RaphaelGrj/Rover-Project/PROGRESS.md

# ROVER --- État actuel (résumé de reprise)

> # ✅ ROVER SE DÉPLACE --- blocage moteur levé le 2026-09-21
>
> Le blocage qui traînait depuis le 2026-09-01 (sept sessions) est
> résolu : moteurs, encodeurs, pont en H et alimentation répondent tous,
> et le Rover avance/recule/tourne réellement, roues au sol.
>
> **Root cause NON éclaircie --- à noter pour ne pas se faire piéger :**
> la session du 2026-09-20 avait prouvé par bisection que ce n'était pas
> le firmware et soupçonnait la masse `GND` ESP32 ↔ `GND` DRV8833
> (jamais vérifiée). Cette session n'a **pas** vérifié cette continuité
> --- le firmware de la branche `claude/joystick-speed-bar-ui-3a42ll` a
> simplement été flashé et les moteurs ont répondu du premier coup à
> `motor_raw`. Donc soit (a) un fil s'est ressoudé/rebranché entre-temps
> sans que personne ne le note, soit (b) l'hypothèse GND n'était pas la
> bonne cause. **Si le symptôme "PWM 255 → 0 tick" revient un jour, faire
> la vérification GND avant toute autre piste** : elle n'a toujours
> jamais été faite pour de vrai.
>
> **Ce qui a réellement débloqué le déplacement, dans l'ordre :**
> 1. Nouvel outil `pi/tools/motor_triage.py` (branche fusionnée ce jour) :
>    un duty fixe envoyé au pont en H sans PID a immédiatement montré que
>    le matériel répond (9 / 144 ticks gauche/droite en 3s, roues en
>    l'air) --- la panne électrique de 2026-09-20 n'était plus là.
> 2. **Calibration `max_speed` bien trop basse, et un piège logiciel
>    découvert avec** : le triage recommande de recaler `max_speed` sur
>    la vitesse mesurée à vide, roues en l'air (ici 0,00028 m/s --- la
>    roue gauche était quasi bloquée dans ce test précis). Appliqué tel
>    quel, ce réglage clampe `_targetVelocity` (avant/arrière,
>    `DriveController::setTarget`) à une valeur ridicule, mais **ne
>    touche pas la rotation** : `_targetRotation` est bornée par la
>    constante indépendante `ROVER_MAX_ROTATION_RAD_S` (4.0, fixe,
>    `motion_config.h`), sans lien avec `max_speed`. Résultat observé :
>    tourner fonctionnait (mal), avancer ne faisait strictement rien
>    (PWM avant ~4/255 relevé en télémétrie). **Un vrai calibrage à
>    l'air libre, sur roue quasi grippée, n'est pas une mesure fiable de
>    la vitesse atteignable en charge** --- s'en méfier si `motor_triage`
>    est réutilisé.
>    - Bug annexe trouvé et corrigé (commit `bc3887d`) : la commande
>      suggérée par l'outil formatait la vitesse en `%.3f`, ce qui
>      arrondit silencieusement tout en dessous de 0,0005 m/s à
>      `0.000` --- exactement ce cas, donc la commande recommandée aurait
>      remis `max_speed` à zéro au lieu de le corriger.
>    - Bug non corrigé, à garder en tête : la télémétrie firmware
>      (`main.cpp:114`, `%.3f` aussi, préexistant sur `main`, pas
>      introduit par la branche fusionnée) affiche `0.000` pour tout
>      `max_speed` sous 0,0005, et le JS de `index.html`
>      (`updateSpeedCeiling`) ignore un `max_speed` lu comme `0`
>      (`reported > 0` échoue) --- donc une calibration très basse ne se
>      propage jamais à l'UI, qui retombe sur son défaut codé en dur
>      (0,03) pour calculer la rotation. C'est ce qui a produit
>      l'incohérence avant/rotation observée. Pas bloquant tant que
>      `max_speed` reste raisonnable (c'est le cas depuis, remis à 0,15),
>      mais latent.
> 3. Remis `max_speed=0,15` (`SYSTEM action=set_speed`, persiste en NVS
>    via `CalibrationStore` --- **ne revient PAS à 0,03 après reboot**,
>    y penser si un futur test semble "trop rapide" ou "trop lent" sans
>    raison). Choisi car la rotation avait déjà mesuré ~0,20-0,23 m/s
>    réels en charge à duty plein, très au-dessus du défaut compilé.
> 4. **Chenilles démontées par l'utilisateur pour isoler la cause** :
>    rotation nettement meilleure sans, déplacement avant confirmé.
>    Écart gauche/droite mesuré ensuite à duty 255 sans chenilles :
>    **~1-2 % seulement** (0,225-0,230 m/s des deux côtés), contre un
>    facteur ~16x constaté plus tôt roues en l'air avec chenilles ---
>    la boucle PID par roue (gains partagés, retour encodeur
>    indépendant) absorbe déjà cet écart résiduel, pas besoin de trim
>    logiciel par roue.
> 5. **Impression 3D en cours** (lancée par l'utilisateur en fin de
>    session) de nouvelles pièces pour réduire l'effort mécanique sur le
>    moteur côté chenilles avant remontage --- à re-tester (balance
>    gauche/droite + vitesse max réelle en charge) une fois montées.
>
> **Branche fusionnée dans `main` ce jour** (`815700d`, après validation
> matérielle complète) : `claude/joystick-speed-bar-ui-3a42ll` --- UI
> joystick avec barre de vitesse séparée de la direction, bouton
> réarmement/obstacle, puce d'état ESP32, `motor_triage.py`, correctifs
> PID/réflexe d'obstacle. Détail dans le message de merge.

> Fichier de reprise rapide --- objectif : que je puisse me repérer sans
> tout relire. Statut détaillé par phase : voir
> `ARCHITECTURE_AND_ROADMAP.md`. Détail complet de chaque session
> (mesures, hypothèses écartées, méthode de diagnostic) : voir
> `PROGRESS_ARCHIVE.md` --- à rouvrir seulement pour retrouver le contexte
> fin d'une décision ou d'un test passé précis ; le journal court
> ci-dessous suffit normalement à se repérer.

------------------------------------------------------------------------

## État actuel (fil ouvert, mis à jour en continu)

- **✅ Protection batterie choisie + sommeil profond --- MERGÉ dans
  `main` (2026-10-13, [RaphaelGrj/Rover-Project#4](https://github.com/RaphaelGrj/Rover-Project/pull/4),
  merge `1f72aff`, CI verte : 3 cartes + 22 tests natifs + `pi/`)** ---
  jamais testé sur matériel (carte pas encore fabriquée). Entre-temps,
  #2 (`PROGRESS.md`) et #3 (références LCSC de l'étape 0,
  `AIDE_CABLAGE.md`) ont aussi été mergées, puis #5 (`PROGRESS.md`) et
  #6 (merge `16322cb` : JST-PH 2 broches = C295747, 8 broches = C265121,
  trouvés sur leurs pages LCSC), #7 (`PROGRESS.md`) et #8 (merge
  `cdda8c7` : C265405 = JST S6B-PH-SM4-TB et C2913205 =
  ESP32-S3-WROOM-1-N16R2 confirmés par une seconde source). **Toute la
  liste de l'étape 0 est confirmée par au moins deux sources** ; reste
  seulement à revérifier le stock sur lcsc.com au moment de commander.
  Détail ---
  **S-8252AAC-M6T1U** (LCSC C468219) retenue parmi les variantes en
  stock chez LCSC : surcharge 4,30 V, décharge profonde **2,40 V**
  (seuils lus sur des extraits indexés de la datasheet, à reconfirmer
  sur le PDF). 2,4 V est sous la fin de décharge des 18650 (35E 2,65 V).
  Compensé dans le firmware par `LowBatterySleep` : sommeil profond à
  3,0 V/cellule, réveil toutes les 15 min, reprise seulement à
  3,3 V/cellule ou avec l'USB. Décision dans
  `PowerMath::batteryTooLowToRun`, 4 tests natifs de plus (22 au total).
  Doc : `PCB_CONNEXIONS.md` §5.1 et §7, `AIDE_CABLAGE.md` étape 0,
  `ROVER_PROTOCOL.md` (`EVENT name=battery_shutdown`). VL53L0X :
  confirmé hors carte (modules indépendants en façade sur deux JST-PH 6),
  désormais écrit noir sur blanc.
  ⚠ **Limite** : la consommation de la carte en sommeil (« quelques mA »)
  est une estimation (bucks, LDO, capteurs et DRV8833 restent alimentés).
  À mesurer à la mise en service : l'interrupteur reste le vrai « off ».

- **✅ PCB sur mesure : conception + firmware MERGÉS dans `main`
  (2026-10-13, [RaphaelGrj/Rover-Project#1](https://github.com/RaphaelGrj/Rover-Project/pull/1),
  merge `7f88758`)** --- rien n'est encore dessiné dans KiCad ni
  commandé, et **aucune ligne de ce firmware n'a tourné sur une vraie
  carte** (elle n'existe pas).
  - **CI verte sur le commit mergé** : compilation `esp32_wroom`,
    `esp32_s3` **et `rover_pcb_v1`** (ajouté à la matrice CI), tests
    natifs (dont les 18 de `test_power_math`), tests `pi/`, build
    ESP32-CAM. Le premier passage avait cassé les 3 builds ESP32 sur une
    parenthèse en trop dans `main.cpp` (garde `pintest`), corrigée dans
    `318c120` --- une seule erreur, le reste du code a compilé du
    premier coup.
  - **Contenu** : plan complet (`pcb/PCB_CONNEXIONS.md`), guide KiCad
    (`pcb/KICAD_GUIDE.md`), partie 2 d'`AIDE_CABLAGE.md` (connecteurs de
    la carte + création KiCad étape par étape, tableau GPIO recoupé
    automatiquement avec `board_pins_pcb_v1.h`, 33/33), BMS 2S avec
    2 × 18650 en supports séparés (`BOM.md`), firmware `rover_pcb_v1`
    (`lib/board`, `lib/camera`, `lib/power`, `lib/power_math`, IMU
    LSM6DS3TR-C), protocole documenté (`ROVER_PROTOCOL.md`), et
    correction des 23 checksums faux des exemples du protocole (dont la
    référence du §3.1 : `*3A`, pas `*39`).
  - **Toujours ouvert --- à vérifier à la mise en service de la carte** :
    - **Échelle ADC des cellules du BQ25887 supposée (1 mV/pas)**,
      jamais lue sur la datasheet (site TI bloqué depuis la session ;
      registres repris du crate Rust `bq25887`). Le firmware s'en
      protège (`cells_ok=0` si la somme des cellules ≠ tension INA219),
      mais **voir `cells_ok=1` avec des tensions réalistes est le
      premier contrôle**.
    - Brochage du connecteur FPC caméra (sens 1↔24) à confirmer sur le
      schéma ESP32-S3-EYE avant routage ; broches `D+/D−` ou `PSEL` du
      BQ25887 ; seuils SD_MODE des MAX98357A.
    - Pilote audio I2S non écrit (amplis coupés en attendant).
    - Côté Pi : `camera_url` → `http://rover-esp32.local:81/stream`.
  - **Prochaine étape (utilisateur)** : `AIDE_CABLAGE.md` partie B,
    étape 0 --- revérifier le stock des références listées au moment
    de commander, acheter
    une OV2640 à **nappe longue (~75 mm)**, télécharger les datasheets
    (et y reconfirmer les seuils de la S-8252AAC) --- puis schéma KiCad
    poussé sur git pour relecture avant le PCB.

- **📐 PCB sur mesure ESP32-S3 planifié (2026-10-13, conception
  seulement, rien de dessiné ni commandé)** --- carte tout-en-un : S3 +
  caméra intégrée (remplace l'ESP32-CAM), DRV8833, 2 × MAX98357A
  stéréo, micro ICS-43434, IMU, BME688, INA219, connecteurs pour
  moteurs/HP/écran/ToF/servo/E-stop. Liste complète des connexions :
  `pcb/PCB_CONNEXIONS.md` ; guide KiCad débutant :
  `pcb/KICAD_GUIDE.md`. Décisions structurantes à garder en tête :
  module **N16R2** obligatoire (pas N16R8, GPIO35-37 nécessaires),
  expandeur TCA9554 pour les signaux lents (36/36 GPIO du module
  attribués), E-stop câblé sur nSLEEP du DRV8833 (coupure matérielle).
  **Révision le même jour, à la demande de l'utilisateur : BMS 2S
  intégré** --- batterie **2 × 18650 en supports séparés** (choix
  délégué par l'utilisateur, critère sécurité : préférées à un LiPo
  souple), un seul connecteur JST-VH 3 broches B−/MID/B+ + sonde CTN,
  charge USB-C avec équilibrage (BQ25887, I2C 0x6A → IMU
  déplacée en 0x6B), protection par cellule (S-8252), interrupteur sur
  la carte ; XT30 et MOSFET anti-inversion retirés. Connecteurs N20 :
  JST-PH 6 broches dans l'ordre de `esp32/WIRING.md`, l'utilisateur
  adapte le câble si besoin. Questions ouvertes listées en §8 du
  document. Firmware non touché.

- **✅ ROVER SE DÉPLACE, BRANCHE FUSIONNÉE DANS `main` (2026-09-21,
  session de test réel)** --- voir le bandeau en tête de fichier pour le
  détail complet (root cause non éclaircie, calibration `max_speed`,
  bug de troncature, mesures d'équilibrage). Résumé de session :
  - Tests avant fusion : 32/32 natifs, 167/167 `pi/` (2 échecs Windows
    pré-existants sans rapport), WROOM + S3 compilent tous les deux.
  - Flashé sur le WROOM réel (`COM10`) --- premier flash de cette branche
    sur matériel. `motor_triage.py` (nouvel outil de la branche) a
    tranché en un coup : pont en H, alim, moteurs, encodeurs répondent.
  - `max_speed` recalibré deux fois en session : d'abord suivant la
    suggestion du triage (0,00028, beaucoup trop bas, a bloqué
    l'avant/arrière sans toucher la rotation --- voir bandeau), puis
    remonté à 0,15 après mesure réelle en charge (~0,20-0,23 m/s
    observés). Valeur actuelle en NVS, persistante.
  - Bug trouvé et corrigé dans `motor_triage.py` avant fusion (commit
    `bc3887d`) : suggestion de calibration tronquée à `0.000` par un
    format `%.3f` trop court pour ce châssis.
  - Chenilles démontées par l'utilisateur pour isoler la cause du
    mauvais déplacement : nette amélioration, écart gauche/droite résiduel
    ~1-2 % seulement (contre ~16x mesuré roues en l'air avec chenilles le
    2026-09-20) --- absorbé par le PID par roue, pas de trim logiciel
    ajouté.
  - Merge `--no-ff` propre, sans conflit, poussé sur `origin/main`
    (`815700d`).
  - **Impression 3D lancée par l'utilisateur** (nouvelles pièces pour
    réduire l'effort mécanique sur le moteur côté chenilles) --- à
    remonter et re-tester (balance + vitesse réelle) une prochaine
    session.

- **🔴 SEPT RÉGRESSIONS TROUVÉES EN RELISANT MON PROPRE TRAVAIL
  (2026-09-21)** --- revue de la branche avant flash, puisque ~1000
  lignes dont une loi de commande moteur n'ont jamais pu tourner sur le
  vrai matériel. Toutes viennent de la **même cause** : avoir divisé le
  plafond de vitesse par 10 sans toucher à ce qui supposait l'ancienne
  échelle.
  - **La barre de vitesse n'avait que 4 positions utiles.** `MOVE` était
    émis en `%.2f` sur une plage de 0 à 0,03 m/s : les 21 crans de la
    barre s'effondraient en **quatre** commandes distinctes, et **sous
    15 % de barre la commande valait `0.00`** --- le robot ne bougeait
    pas du tout. Passé à quatre décimales, vérifié en navigateur : 7
    crans testés, 7 commandes distinctes.
  - **`left_speed=0.00` serait réapparu pour une roue qui tourne.** Même
    format `%.2f` sur la télémétrie : toute roue sous 0,005 m/s
    s'affichait à zéro. C'est *exactement* la lecture erronée qui a
    coûté des semaines à ce projet, et je l'avais réintroduite.
  - **Trame trop longue.** Vitesses à quatre décimales + les trois
    drapeaux d'obstacle = 129 octets, un de trop, atteint par une simple
    marche arrière à plein régime. Les drapeaux partent maintenant dans
    leur propre trame, au changement seulement (plus court *et* plus
    silencieux).
  - **Une commande perdue n'était jamais réémise (page autonome).**
    `lastSent` était posé avant que la requête n'aboutisse : un timeout
    et la commande était considérée comme délivrée, pendant que les
    keep-alives `h=1` maintenaient le heartbeat. **Un « stop » perdu
    laissait le robot rouler indéfiniment.** Corrigé (acquittement sur
    réponse seulement) et vérifié en coupant le lien à chaud.
  - **Stick tenu + « Activer » = rien.** Le ré-armement ne purgeait pas
    `lastSent`, donc aucun `MOVE` n'était émis après être sorti de SAFE.
    `RoverCore.resume()` purgeait son cache pour cette raison exacte ;
    la page n'avait pas l'équivalent.
  - **Zone morte à 0,02 m/s**, soit les deux tiers de la plage : rouler
    à 60 % de barre était rapporté comme « inactif ». Elle est
    maintenant une **fraction du plafond rapporté par le robot**, donc
    elle ne peut plus dériver.
  - **Bascule obstacle optimiste** sans rien pour la corriger, et un
    commentaire qui prétendait le contraire. Elle revient en arrière si
    la requête échoue.
  - **`monkeypatch` gelait `time.monotonic` de la stdlib** pour tout le
    processus, sous une boucle asyncio vivante.
  - Trois tests de non-régression ajoutés sur le fond du problème (la
    résolution du format, la zone morte qui suit le plafond).
  - **Leçon** : changer une constante de référence d'un ordre de
    grandeur, c'est changer toutes les échelles qui en dépendent.
    Formats d'affichage, seuils, tailles de tampon. Aucun de ces sept
    points n'aurait été trouvé en relisant la ligne modifiée.

- **🔧 OUTIL : `python -m tools.motor_triage` (2026-09-21)** --- une
  commande qui répond à la seule question qui compte : **la panne est-
  elle électrique ou logicielle ?**
  - Le pivot est `motor_raw` : duty écrit **directement sur le pont en
    H**, sans PID, sans feed-forward, sans plafond de vitesse, sans
    réflexe d'obstacle. Zéro tick sous cette commande ⇒ plus rien en
    amont du pont en H ne peut être mis en cause.
  - La réponse était disponible depuis le début, mais seulement pour qui
    lance cinq commandes `SYSTEM` dans le bon ordre et lit la télémétrie
    correctement. **Sept sessions sans que cette séquence soit passée
    proprement de bout en bout** --- et le seul chiffre que tout le
    monde regardait (`left_pwm=255`) ne prouvait rien, puisque le PID
    sature *parce que* rien ne bouge.
  - Six verdicts, chacun avec la manipulation suivante : **électrique**
    (masse commune d'abord), **E-stop enfoncé** (GPIO25), **entrée
    encodeur qui flotte**, **un seul côté répond** (avec le rappel que
    gauche/droite sont inversés ensemble dans le câblage), **moteurs
    fonctionnels**, ou non concluant. Codes de sortie 0/1/2.
  - Sur un verdict « fonctionnels », il **mesure** la vitesse réelle à
    plein régime et propose le `SYSTEM action=set_speed` qui recale
    `ROVER_MAX_WHEEL_SPEED_MPS` si elle s'en écarte. Les constantes sont
    **lues dans `motion_config.h`**, pas recopiées : cette session est
    partie d'une constante fausse d'un facteur 10 que personne n'avait
    vue, l'outil ne peut donc pas être en désaccord avec le firmware.
  - Vérifié pour de vrai : les sept chemins ont été exécutés contre un
    faux ESP32 (électrique, sain, un seul côté, tempête d'encodeur,
    E-stop, robot muet, lien injoignable), et l'arbre de décision est
    couvert par `pi/tests/test_motor_triage.py`.
  - Au passage : `move_diagnostic.py` contenait encore un chemin Windows
    en dur (`C:\Users\rapha\...`), il ne tournait plus depuis que le Pi
    est la machine qui l'exécute. Corrigé.

- **🟢 CORRIGÉ : plafond de vitesse, feed-forward, anti-windup
  (2026-09-21)** --- le diagnostic de la session précédente est
  maintenant réparé, et une **deuxième anomalie sérieuse** est sortie au
  passage.
  - **`ROVER_MAX_WHEEL_SPEED_MPS` : 0,30 → 0,03 m/s**, c'est-à-dire la
    vitesse réellement mesurée à plein régime. La rotation suit :
    elle est désormais **dérivée**, pas choisie --- le modèle unicycle
    donne `2 × vmax / empattement` = 0,4 rad/s, là où l'ancien
    1,5 rad/s demandait 0,11 m/s à chaque roue, presque **quatre fois**
    ce que le châssis peut donner. Toute rotation saturait.
  - **Feed-forward `ROVER_PID_KFF = 8500`** (PWM par m/s, soit
    255 / 0,03). Le rapport cyclique nécessaire à une vitesse est connu
    d'avance ; le faire redécouvrir à l'intégrateur par pas de 20 ms
    était la cause de la rampe de 5 s. **Mesuré sur banc natif** : plein
    barre atteint PWM 200 **immédiatement**, contre *jamais* avant.
  - **⚠️ ANOMALIE TROUVÉE EN CORRIGEANT : le robot ne s'arrêtait pas
    quand on relâchait le joystick.** Recentrer le stick ne fait que
    mettre la consigne à zéro --- ça ne passe pas par `stop()` comme le
    bouton STOP, le SAFE ou l'E-stop. L'intégrale accumulée pour tenir
    la vitesse précédente restait, et se vidait à la vitesse de
    l'erreur. **Mesuré sur banc : 81 secondes de plein régime après
    avoir lâché.** Invisible jusqu'ici uniquement parce que les roues ne
    tournaient pas ; ça aurait mordu le jour même où elles s'y seraient
    mises.
    - Corrigé par trois choses : l'**anti-windup** (intégration
      conditionnelle : on n'intègre plus vers une butée déjà atteinte),
      le **feed-forward** (l'intégrale n'a plus à porter le régime
      permanent, donc elle reste près de zéro), et surtout une règle
      explicite --- **consigne nulle ⇒ intégrale remise à zéro**.
      « S'arrêter » est une intention, pas une consigne à asservir.
    - Mesure après correction : **0,00 s** de dérive après relâchement,
      *y compris* avec `kff=0`. L'anti-windup seul ne suffisait pas (il
      restait 39 s), c'est la combinaison qui règle le problème.
  - **Tout est recalibrable sans reflasher** : `SYSTEM action=set_speed
    max=0.045` (persisté en NVS) et `set_pid kff=...`, même mécanique
    que les gains PID. La page du Pi **suit** le plafond rapporté par le
    robot (`STATE max_speed=`) et affiche la barre en m/s réels, donc
    plus de constante d'UI qui périme. La page autonome garde une
    constante (elle ne peut pas l'apprendre) --- à tenir à jour à la
    main.
  - Vérifié sur banc natif compilé avec `g++` (les tests Unity du dépôt
    tournent aussi localement via un shim) : 9/9 au vert, dont trois
    nouveaux couvrant exactement ces pathologies.

- **🟢 CORRIGÉ : le lien Pi↔ESP32 ne détectait pas une mort silencieuse
  (2026-09-21)** --- trouvé en réparant la CI, et c'est un vrai bug de
  production qui **colle au symptôme « les moteurs ne tournent pas »**.
  - TCP ne signale qu'un pair qui dit au revoir. Un ESP32 qui perd
    l'alimentation, plante, ou sort de portée WiFi n'envoie **ni FIN ni
    RST** : le socket reste ouvert et parfaitement sain, les lectures
    expirent à vide --- ce qui n'est pas une erreur. Le Pi envoyait donc
    son heartbeat dans le vide indéfiniment : aucune reconnexion, plus
    aucun HEARTBEAT ne parvenant au robot, moteurs arrêtés en `SAFE`, et
    une UI affichant toujours « connecté ».
  - Corrigé par un **chien de garde en réception** : le firmware publie
    de la télémétrie capteur toutes les 500 ms quoi qu'il arrive, donc
    5 s de silence = 10 cycles manqués = lien mort. On ferme et on
    reconstruit, AUTH comprise. Désactivable (`receive_timeout_s=None`).
  - Deux tests couvrent les deux moitiés du contrat : un robot muet est
    recyclé, un robot qui parle **n'est pas** recyclé (une boucle de
    reconnexion serait pire que le bug).

- **🟢 CORRIGÉ : 3 tests `test_link` rouges depuis toujours --- le code
  testé était sain, c'est le harnais qui mentait (2026-09-21)**.
  - `FakeEsp32.hang_up()` faisait `close()` pendant que son propre
    thread était bloqué dans `recv()` sur **le même socket**. Sous
    Linux, fermer un descripteur ne réveille pas un thread déjà bloqué
    dessus, et l'appel bloqué **maintient la description de fichier
    ouverte : aucun FIN n'est jamais envoyé**. Le client voyait un
    socket sain et silencieux et avait raison de ne pas reconnecter.
  - `shutdown(SHUT_RDWR)` avant `close()` : le FIN part tout de suite et
    réveille le `recv()` bloqué. **15/15 au vert**, CI Python réparée.
  - À retenir : trois tests de reconnexion ont passé leur vie en rouge
    en accusant un code correct. Un harnais qui simule une panne doit
    être vérifié comme le reste.

- **Garde-fou anti-tempête d'interruptions encodeur (2026-09-21)** ---
  détection passive la session dernière, protection active maintenant :
  au-delà de 20 000 fronts/s (impossible physiquement --- ce châssis en
  produit ~320/s), l'encodeur **désarme sa propre interruption** et émet
  `ERROR code=encoder_storm wheel=left|right`. On échange la mesure de
  vitesse contre un robot qui continue de tourner, là où une `loop()`
  affamée ne fait plus rien du tout. Ne se réarme qu'avec
  `SYSTEM action=reset_ticks` : la cause est un fil, un réarmement
  automatique ne ferait que la cacher.

- **🔴 TROUVÉ : la consigne de vitesse est INATTEIGNABLE, le PID est
  saturé en permanence (2026-09-21)** --- c'est le résultat le plus
  important de la session, et il **réinterprète des semaines de
  diagnostic**.
  - Calcul, à partir de vos propres mesures : circonférence de roue
    `π × 0,03183 = 100,0 mm` ; mesure du 2026-09-20 à froid,
    **3125 ticks en 10 s à PWM 255** → `312 ticks/s ÷ 1073 = 0,291 tr/s`
    = **17,5 tr/min** = **0,029 m/s**.
  - Or `ROVER_MAX_WHEEL_SPEED_MPS = 0,30 m/s`, soit **10,3 × la vitesse
    réellement atteinte à plein régime**. Demander 0,30 m/s revient à
    demander **180 tr/min** à l'arbre de sortie.
  - **Conséquence** : toute consigne au-dessus de ~0,03 m/s est
    inatteignable → l'erreur ne redescend jamais → l'intégrale part à sa
    borne → **le PWM reste collé à 255 indéfiniment**. Vérifié en
    simulant la boucle fermée : consigne 0,12 m/s → saturé à 255 sur
    100 % du régime établi ; consigne **0,025 m/s** (sous le plafond
    mesuré) → **PWM 109, la boucle régule enfin**.
  - **Donc `left_pwm=255 left_speed=0.00` n'est PAS un symptôme de
    panne** : c'est la sortie normale de cette configuration. Ce chiffre
    a été lu comme une preuve de moteur mort pendant des semaines ; il
    ne prouve rien du tout.
  - ⚠ Nuance honnête : les 17,5 tr/min viennent d'une mesure faite sur
    un châssis peut-être partiellement chargé, donc le vrai plafond à
    vide est sans doute plus élevé. Même faux d'un facteur 3, on reste à
    un ordre de grandeur de 0,30 m/s. **À trancher par la mesure** :
    `SYSTEM action=reset_ticks`, puis `motor_raw left=255 right=255
    ms=10000`, puis `raw_ticks` --- à froid, roues en l'air *puis* au
    sol. `ROVER_MAX_WHEEL_SPEED_MPS` doit ensuite être ramené à ce qui
    est réellement atteignable, sinon la barre de vitesse n'a **aucune
    autorité** : elle ne change que la durée de la rampe, pas le régime
    final.
  - **Non corrigé ici** : changer cette constante change le
    comportement en mouvement du robot, ça se règle sur la mesure, pas à
    l'aveugle.

- **Bouton « arrêt sur obstacle » ON/OFF (2026-09-21)** --- demandé, et
  c'est aussi un outil de diagnostic.
  - Présent sur **les deux** pages. Les **distances restent mesurées,
    publiées et affichées** dans tous les cas : le bouton empêche le
    robot d'*agir* sur ce qu'il voit, il ne l'aveugle pas.
  - Côté firmware `SYSTEM action=obstacle_reflex on=0|1`
    (`DriveController::setObstacleReflexEnabled`). ⚠ Il y a **deux**
    clamps indépendants (firmware + Pi, §6.2 question 5) : n'en
    désactiver qu'un ne change rien, donc `RoverCore.set_obstacle_reflex()`
    fait les deux d'un coup.
  - **Non persisté, volontairement** : un garde-fou désactivé ne doit
    pas survivre à une coupure de courant. Chaque démarrage repart armé
    --- et le bouton de l'UI suit **la valeur rapportée par le robot**,
    jamais le clic, pour qu'un reboot ESP32 ne laisse pas la page
    mentir.
  - La télémétrie distingue maintenant trois choses autrefois
    confondues : `obstacle_seen` (ce que voit le capteur),
    `obstacle_reflex` (armé ou non), `forward_blocked` (marche avant
    effectivement bridée).

- **Deux suspects restants, désormais diagnosticables en 2 secondes
  (2026-09-21)** --- tous deux collent au symptôme « rien ne tourne »,
  aucun n'est mécanique ni lié au driver :
  1. **E-stop fantôme sur GPIO25.** `ROVER_PIN_ESTOP = 25` --- or
     `motion_config.h` note que GPIO25 était le `PWMB` du plan TB6612FNG
     abandonné. **S'il reste un fil de ce plan reliant GPIO25 à la masse
     ou à une entrée du driver, l'E-stop lit « enfoncé » en permanence** :
     dès la première `loop()` le front est détecté, l'état passe en
     `SAFE`, les moteurs sont coupés, et *tout* `resume` est refusé.
     Symptôme identique à des moteurs morts. Jusqu'à cette session ce
     refus était **totalement silencieux** ; il répond maintenant
     `ERROR code=estop_held`, et `STATE estop=1` le dit sans qu'on
     demande rien.
  2. **Tempête d'interruptions encodeur.** GPIO34-39 n'ont **aucun
     pull-up interne** (`Encoder::begin` le documente). Un connecteur
     desserré --- ce robot a des antécédents, cf. « connexion gauche
     faible/intermittente » --- laisse la broche flotter et l'ISR se
     déclencher en continu, ce qui **affame la `loop()` qui pilote les
     moteurs**. Les ticks ne le montrent pas : les `+1`/`−1` s'annulent,
     le compteur reste près de zéro, exactement comme une roue immobile.
     Nouveau compteur `raw_edges_left`/`raw_edges_right` (jamais
     décrémenté) dans `SYSTEM action=raw_ticks` : **des edges qui
     grimpent pendant que les ticks stagnent, c'est ça, sans ambiguïté**.
  - Bonus de la publication `STATE state=` au boot : une boucle de reset
    du watchdog (3 s) se voit maintenant comme des `state=READY`
    répétés, au lieu de passer inaperçue.
  - Confirmé inerte : `RoverState::ERROR` n'est **jamais** affecté nulle
    part dans le firmware, ce chemin ne peut pas bloquer quoi que ce
    soit.

- **PILOTAGE : barre de vitesse + joystick de direction (2026-09-21)**
  --- les deux pages (celle du Pi, `pi/rover_control/static/index.html`,
  et celle servie par l'ESP32 en mode autonome) séparent désormais
  *combien vite* de *vers où* :
  - **barre latérale = vitesse**, seule ; **joystick = direction**,
    seule. La commande est le vecteur **normalisé** (longueur 1), donc
    à mi-course ou à fond de course on roule à la même vitesse. Zone
    morte de 25 % du rayon : une commande « direction seule » n'a aucun
    petit régime dans lequel s'engager progressivement, sans zone morte
    le moindre effleurement serait un départ pleine vitesse.
  - **Conséquence recherchée** : une ligne droite est désormais **une
    commande répétée**, plus un flux de flottants légèrement différents.
    C'est ce qui rend le filtrage des doublons efficace.
  - **Où le gain est réellement pris, et où il ne l'est pas** :
    `RoverCore.move()` ne réémet plus une `MOVE` identique (rafraîchie
    quand même toutes les 0,5 s, `MOVE_REFRESH_S` --- un ESP32 qui a
    redémarré ou qui sort de `SAFE` ne doit pas rester sur une consigne
    périmée). La page, elle, **continue** d'émettre à cadence fixe :
    c'est cette cadence qui prouve que le *navigateur* est vivant, et la
    couper aurait permis à une page figée de laisser le robot rouler sur
    sa dernière commande. En mode autonome, la page n'envoie `v`/`r`
    qu'au changement et sinon un `GET /c?h=1` qui alimente le heartbeat
    sans re-cibler le PID. ⚠ Le **nombre de requêtes** reste plancheré
    par le timeout heartbeat (500 ms) : ce n'est pas là que ça se gagne,
    et c'est assumé.

- **`SYSTEM action=resume` : envoyé, mais UNE SEULE FOIS --- corrigé
  (2026-09-21)** --- vérification demandée, et c'est un vrai défaut.
  - Ce qui existait : `RoverCore.client_connected()` envoie bien un
    `resume` à la connexion d'un client de contrôle (et
    `pi/tools/motor_test.py` a sa commande `resume`). C'est correct au
    démarrage.
  - **Le trou** : c'est un coup unique. Tout ce qui refait tomber
    l'ESP32 en `SAFE` *ensuite* --- **un timeout heartbeat suffit, et la
    fenêtre n'est que de 500 ms sur un lien WiFi** --- laissait la page
    connectée, le joystick vivant, le heartbeat battant… et **toutes les
    `MOVE` jetées en silence**. Seul un rechargement de l'onglet
    (donc une reconnexion) rendait le robot pilotable. Un robot muet qui
    a l'air en pleine forme : exactement le symptôme « les moteurs ne
    tournent pas » qu'on traque depuis des semaines.
  - **Corrigé** : bouton « Activer » sur la page du Pi (elle n'en avait
    pas, contrairement à la page autonome) → `RoverCore.resume()`, et
    l'état matériel de l'ESP32 est maintenant **affiché** (nouveau champ
    `STATE state=... estop=...`, émis au changement uniquement, voir
    `ROVER_PROTOCOL.md` §7.1). Un `SAFE` se voit au lieu de se deviner,
    et le bouton clignote quand il sert à quelque chose.
  - **Côté firmware** : un `resume` refusé parce que l'E-stop est
    enfoncé répond maintenant `ERROR code=estop_held` au lieu d'être
    ignoré sans un mot --- « j'ai appuyé sur Activer et rien ne s'est
    passé » avait zéro réponse possible avant.

- **Heartbeat : présent et correct (2026-09-21)** --- vérification
  demandée, rien à corriger.
  - Pi → ESP32 : `HEARTBEAT` toutes les **150 ms**
    (`HEARTBEAT_PERIOD_S`), tâche lancée à la connexion du premier
    client et annulée au départ du dernier. Timeout firmware : **500 ms**
    (`ROVER_HEARTBEAT_TIMEOUT_MS`), soit ~3 battements de marge.
  - Page autonome → ESP32 : au moins une requête toutes les **250 ms**
    (commande ou `h=1`), même marge.
  - `HeartbeatMonitor` ne se déclenche jamais avant le premier battement
    reçu (`_started`), donc un robot allumé sans Pi ne tombe pas en
    `SAFE` tout seul --- il reste en `READY`, où les `MOVE` sont **aussi**
    ignorées (voir ci-dessous).
  - ⚠ À savoir : **sans client de contrôle connecté, personne ne bat**.
    C'est voulu (la sécurité ne dépend pas du Pi), mais ça veut dire
    qu'un `MOVE` envoyé à la main sans heartbeat ne bouge rien plus de
    500 ms. `pi/tools/motor_test.py` bat en arrière-plan pour ça.

- **Audit « qu'est-ce qui, dans le code, peut empêcher les moteurs de
  tourner » (2026-09-21)** --- passe complète, par ordre de probabilité :
  1. **⚠ La rampe du PID est lente au point d'être trompeuse.** Gains
     180/300/0, intégrale bornée à ±1. Roue bloquée, consigne à 40 % de
     la barre (0,12 m/s) : `sortie = 21,6 + 36·t`. Il faut donc **~5 s**
     de joystick maintenu pour atteindre PWM 200, et **~6,5 s** pour 255
     --- or le seuil de démarrage mesuré sur ce châssis est justement de
     200-255. **Une poussée de 2 s ne dépasse pas PWM ~93 : rien ne
     bouge, et ça ressemble trait pour trait à un moteur mort.** À fond
     de barre (0,30 m/s) c'est ~1,6 s pour 200 ; à 20 % de barre,
     **10,5 s**. Chiffres simulés depuis le code de `WheelPID::update`,
     pas estimés. ⚠ Conséquence directe pour la barre de vitesse :
     **un réglage bas est indiscernable d'un robot en panne** sur un
     test court --- tester à fond de barre d'abord. Le correctif propre est
     un terme de **feed-forward** (`pwm = kff·consigne + PID`), pas un
     gain plus gros --- monter Kp/Ki a déjà été essayé le 2026-09-20 et
     a produit une oscillation +255/−255. **Non implémenté ici** : c'est
     une modification de la loi de commande, elle se règle sur le vrai
     robot, pas à l'aveugle.
  2. **Le réflexe d'obstacle est devenu actif le 2026-09-20**, le jour
     même où les moteurs ont cessé de tourner. Un ToF qui voit quoi que
     ce soit à **moins de 150 mm** (une chenille, un câble, le sol si le
     capteur pique du nez, un mur pendant un test sur établi) met
     `forward_blocked=1` et la marche avant est mise à zéro --- **des
     deux côtés**, dans le firmware *et* dans `RoverCore.move()`. La
     rotation et la marche arrière restent disponibles, ce qui donne le
     symptôme très particulier « il tourne mais n'avance pas ».
     Vérifiable directement : `forward_blocked=` dans la télémétrie, et
     la page autonome l'écrit en clair. À écarter en deux secondes,
     mais personne ne l'a fait depuis que les capteurs sont câblés.
  3. **`MOVE` est ignorée hors de l'état `ACTIVE`** (voulu, §27 règle 6)
     --- voir le point `resume` ci-dessus, c'était le trou le plus sale.
  4. **Un coup de PWM parasite après `motor_raw`, corrigé.**
     `DriveController::update()` ne rafraîchissait pas `_lastUpdateMs`
     pendant qu'une commande brute tenait les moteurs : la première
     passe PID suivante voyait un `dt` de **jusqu'à 15 secondes**,
     l'intégrale partait directement à sa borne et envoyait un
     plein régime sur un robot que l'opérateur croyait à l'arrêt.
  5. **Écarté --- conflits de broches et de canaux LEDC** : aucun
     doublon sur l'ensemble des `ROVER_PIN_*` (moteurs 26/27/32/33,
     encodeurs 34-39 en entrée seule, écran, I2C, E-stop 25, XSHUT 4,
     I2S 16/17/14). Moteurs sur canaux LEDC 0-3 (timers 0 et 1), servos
     sur 4-5 (timer 2) : pas de timer partagé, donc pas de fréquence
     volée. Buzzer désactivé, aucun canal. `pintest` détache bien le
     LEDC mais rappelle `drive.begin()` derrière, le PWM revient.
  6. **Écarté --- E-stop, batterie, watchdog** : `INPUT_PULLUP` donc une
     broche non câblée lit « relâché » ; `BatteryMonitor` n'a aucun
     chemin vers `SAFE` (il n'émet que des EVENT) ; le watchdog est
     nourri à chaque `loop()`.
  - **Conclusion** : rien dans le code n'*interdit* aux moteurs de
    tourner, ce que la bisection du 2026-09-20 avait déjà prouvé. Mais
    les points 1 et 2 fabriquent un « ça ne tourne pas » parfaitement
    convaincant lors d'un test court, et le point 3 en fabriquait un
    définitif après la moindre micro-coupure WiFi. **Le bandeau en tête
    de fichier reste valable : la piste électrique (masse commune) reste
    à faire en premier.**

- **MOTEURS : NON RÉSOLU en fin de session (2026-09-20)** --- les
  moteurs ne tournent plus du tout, et **la bisection prouve que ce
  n'est pas le logiciel** (voir le bandeau en tête de fichier : le
  firmware de `d9379a0`, reflashé intégralement, échoue identiquement).
  Le reste de cette entrée documente le chemin parcouru, mais **la
  conclusion opérationnelle est dans le bandeau** : chercher côté
  électrique, en commençant par la masse commune.

- **MOTEURS : diagnostic complet, cause non trouvée (2026-09-20)** ---
  la session a éliminé méthodiquement tout ce qui pouvait l'être, et le
  blocage restant est un **problème d'énergie disponible**, pas de code.
  - **Le firmware est hors de cause, prouvé.** Nouvel outil
    `SYSTEM action=motor_raw left= right= ms=` : duty fixe envoyé
    directement au pont en H, **sans PID ni encodeur**. Indispensable
    parce que la sortie du PID ne peut pas diagnostiquer une roue
    immobile --- elle sature à 255 *parce que* rien ne bouge, si bien
    qu'un blocage mécanique, un driver mort et un encodeur mal câblé
    produisent exactement la même télémétrie.
  - **Ce qui fonctionne, mesuré** : le DRV8833 commute, les deux moteurs
    tournent (**3125 ticks en 10 s** à PWM 255), les deux encodeurs
    comptent, `VM` reçoit 7,5 V, `SLEEP` est au 3V3, la mécanique tourne
    librement à la main.
  - **Le symptôme restant** : seuil de démarrage entre **200 et 255 de
    PWM**, là où un N20 à nu démarre vers 60-80. À PWM 100 : 0 tick ; à
    160 : 4 ticks.
  - **Pistes testées et ÉCARTÉES** --- à ne pas refaire :
    - *Friction mécanique* : infirmé, le moteur tourne à la main sans
      forcer.
    - *Fréquence PWM* : passée de 20 kHz à 5 kHz sur l'hypothèse de la
      constante de temps L/R du moteur (~200 µs contre 50 µs de période).
      **Nettement pire** (PWM 220 → 0 tick), revenu à 20 kHz.
    - *Gains PID* : montés à 900/1200 pour forcer le passage --- **erreur
      de ma part**, le PID s'est mis à osciller entre +255 et −255 et le
      moteur vibrait sur place au lieu de tourner. C'était ça le
      « mouvement pas continu », que j'avais attribué à tort à la
      friction. Remis à 180/300 (`reset_pid`).
    - *Alimentation absente* : `VM` mesuré à 7,5 V.
  - ⚠️ **Les performances se dégradent d'essai en essai** : 3125 ticks,
    puis 116 au même PWM une demi-heure plus tard. Protection thermique
    du driver ou échauffement des bobinages --- conséquence d'essais
    répétés à pleine puissance sur des moteurs calés. **Travailler à
    froid, par tests courts et espacés.**
  - **CORRECTIF APPLIQUÉ EN FIN DE SESSION : passage en SLOW DECAY**
    (`MotorDriver::setSpeed`). L'ancien pilotage (PWM sur une entrée, 0
    sur l'autre) est du **fast decay** : entre deux impulsions les deux
    sorties sont relâchées et le courant du bobinage s'effondre dans les
    diodes de roue libre. À 20 kHz il n'a jamais le temps de s'établir,
    donc le couple moyen reste minuscule tant que le rapport cyclique
    n'est pas proche de 100 % --- **exactement la courbe mesurée**. En
    slow decay, une entrée reste haute et l'autre est modulée à
    l'inverse : le courant recircule dans les transistors bas au lieu de
    s'effondrer, et se reporte d'une impulsion à la suivante. C'est le
    mode recommandé par TI pour le contrôle de vitesse sur ce composant.
    - **Gain mesuré immédiatement** : PWM 100 → **13 ticks**, là où le
      fast decay donnait **0**.
    - ⚠️ **Évaluation à refaire À FROID** : les moteurs étaient déjà
      dégradés thermiquement au moment du test (87 ticks à PWM 200,
      du même ordre que les 116 à PWM 255 obtenus juste avant, contre
      3125 à froid). **Ces chiffres ne mesurent pas le slow decay, ils
      mesurent l'échauffement.**
    - Le cas `pwm == 0` est traité à part (les deux entrées basses =
      roue libre), car en slow decay un duty nul signifierait « les deux
      entrées hautes », c'est-à-dire un **freinage actif** --- ce que
      `stop()` et l'état SAFE ne doivent jamais faire.
  - **Prochain correctif prévu si le slow decay ne suffit pas** : une
    **rampe de démarrage** (monter le duty progressivement au lieu
    d'envoyer 255 d'un coup), pour écrêter le pic de courant qui
    déclenche peut-être la protection en surintensité du DRV8833 (elle
    agit vers 2 A, un N20 à l'arrachage dépasse ça).
  - **SEULE PISTE RESTANTE, jamais testée** : la tension réellement
    présente aux bornes du moteur **pendant qu'il force**. Si l'alim
    entre en limitation dès le démarrage, la tension s'effondre et le
    moteur ne peut jamais s'arracher --- ce qui produirait exactement ce
    seuil apparent très élevé. À mesurer en premier.
  - **Côtés gauche/droite inversés** : la télémétrie comptait 3125 ticks
    sur « gauche » pendant que la roue **droite** tournait. Moteur ET
    encodeur sont inversés **ensemble**, ce qui est pourquoi ça n'avait
    jamais été vu --- ça ne se voit que lorsqu'un seul côté tourne. À
    corriger dans `motion_config.h`, mais **après** avoir résolu le
    déplacement (ne pas mélanger deux problèmes).

- **TÊTE : montage tandem abandonné, un seul servo retenu (2026-09-20)**
  --- l'utilisateur a démonté le servo B et le remplacera par un
  **roulement de maintien** côté opposé. Décision saine : deux servos sur
  un axe commun ne sont jamais d'accord (neutres, courses et temps de
  réponse diffèrent), ils se combattent en permanence.
  - **Ce que la caractérisation a coûté, et pourquoi** : le palonnier
    était monté ~90° hors du neutre, si bien que la position de repos de
    la tête tombait à l'extrémité de la course du servo. **Tout angle
    commandé enfonçait la tête dans sa butée basse**, dans les deux sens
    --- d'où une longue série de fausses pistes (signe, conflit entre
    servos, butées). Résolu en démontant les bras et en recentrant les
    servos avant de les refixer.
  - **Trois erreurs de méthode de ma part**, à ne pas reproduire :
    (1) j'ai supposé qu'un servo relâché était libre --- faux, le
    réducteur d'un MG90S bloque le rétro-entraînement, ce qui invalidait
    tout le protocole « un servo à la fois » sur un montage rigide ;
    (2) j'ai voulu déduire une position à partir de blocages, alors
    qu'un servo ne renvoie **aucune** position ; (3) j'avais élargi un
    clamp dans **un seul** des trois chemins de commande, si bien que
    deux mesures du même matériel se contredisaient.
  - **Acquis durable : origine mécanique persistée en NVS**
    (`head_org_a`/`head_org_b`, `SYSTEM action=head_origin`). Tout angle
    logique est mesuré depuis cette origine, donc un remontage de
    palonnier se rattrape **sans reflasher** --- exactement ce qui
    manquait aujourd'hui.
  - **Servos relâchés au démarrage** (`ServoJoint::detach`, duty 0 = pas
    d'impulsion = aucun couple). L'ancien « centrer au boot » était
    dangereux sur un montage dont on ignore le neutre.
  - **`pitch` pilote, `yaw` inerte** (`head_config.h`) : un seul degré de
    liberté mécanique. Course bridée à **±20°** en attendant la mesure
    des vraies butées (~35° de débattement annoncé).
  - ⚠️ **GPIO12 est redevenu libre** avec le retrait du servo B --- le
    **buzzer peut donc revenir** (`ROVER_BUZZER_ENABLED`, le code est
    conservé intact). Dette à solder quand le déplacement sera réglé.

- **GPIO19 est MORTE sur ce devkit (2026-09-20)** --- établi par
  élimination sur matériel : les deux servos fonctionnent sur GPIO13,
  aucun ne fonctionne sur GPIO19, et changer de canal LEDC (5 → 6, donc
  de timer) n'y change rien alors que le firmware rapporte bien le canal
  attaché. Le pad est mort ou non connecté. **Deuxième anomalie de cette
  carte** après GPIO0 (voir plus bas) --- à garder en tête avant
  d'incriminer le logiciel sur une broche qui ne répond pas.

- **Trame série corrompue toutes les ~5 s, corrigé (2026-09-20)** ---
  `ERROR code=checksum_invalid` en continu pendant le pilotage au
  joystick. Cause : le tampon RX série par défaut (**256 octets**) ne
  représente que ~22 ms à 115200 bauds, moins qu'un redraw complet de
  l'écran ST7789 (~27 ms) pendant lequel `loop()` ne vide plus le port.
  Les octets arrivés dans cette fenêtre étaient perdus, tronquant la
  trame en vol. `Serial.setRxBufferSize(2048)` avant `begin()`. **Plus
  aucune erreur depuis.** C'est un tampon, pas une correction du redraw
  bloquant : si `loop()` stalle un jour plus de ~178 ms, il faudra un
  redraw incrémental/DMA.

- **VL53L0X câblés et validés sur le robot réel (2026-09-20)** --- ils
  attendaient depuis le 2026-09-02, et on sait enfin pourquoi :
  **`WIRING.md` demandait `GPIO0` pour le `XSHUT` gauche, or le devkit
  WROOM 30 broches ne sort pas `GPIO0` du tout** (rangée réelle
  constatée sur la carte : `GND, 15, 2, 4, RX2, TX2`). Le plan était
  irréalisable et personne ne s'en était aperçu --- chaque session le
  reportait à la suivante.
  - **Correction : un seul `XSHUT` suffit.** Séparer deux capteurs qui
    partagent l'adresse d'usine ne demande d'en éteindre qu'un le temps
    de réadresser l'autre. `GPIO4` tient le droit en reset, le gauche
    est réadressé en `0x30`, puis le droit reprend `0x29`. Le `XSHUT`
    gauche part au 3V3. Adresses finales inchangées, une broche rendue,
    et un risque de strapping supprimé au passage.
  - **Un piège introduit par ce changement, trouvé et corrigé** : privé
    de `XSHUT`, le capteur gauche ne peut plus être reseté matériellement
    --- or un VL53L0X garde son adresse jusqu'à la **coupure
    d'alimentation**, pas au reboot de l'ESP32. Dès le 2e démarrage il
    serait resté sur `0x30` et porté disparu. Le firmware le remet
    lui-même à l'adresse d'usine via son registre `0x8A` avant chaque
    séquence. **Observé pour de vrai** : `tof_pre30=1 tof_areset=1
    tof_post29=1`.
  - **Validé sur matériel** : `i2c_scan` → `0x29,0x30,0x68,0x76` ;
    les deux capteurs mesurent ; **gauche/droite confirmés non inversés**
    en masquant un seul capteur à la fois (une main couvre les deux et
    ne prouve rien --- ils sont côte à côte).
  - **Nouvel outillage** : `SYSTEM action=tof_status` / `tof_rescan`.
    Les quatre causes possibles d'un `distance_left=9999` (capteur
    absent / adresse périmée / voisin mal tenu en reset / `begin()`
    refusé) sont indiscernables sans ça --- elles se ressemblent toutes
    à l'écran. Compteur `tof_bringups=` inclus pour détecter une
    éventuelle boucle de réinitialisation (stable à 1 au repos).
  - ✅ **Réflexe d'obstacle local exécuté pour la première fois sur du
    vrai matériel** --- `DriveController::setForwardBlocked` existait
    depuis le 2026-09-15 mais était du code mort tant qu'aucun ToF
    n'était câblé (`obstacleDetected()` renvoyait toujours faux).
    Mesuré : **0 transition et 0 `EVENT` sur 25 s de cible immobile**,
    `tof_bringups` stable à 1 (aucune boucle de réinitialisation, même
    sous charge). Une oscillation soupçonnée au premier test était un
    **artefact de l'outil de mesure**, pas du firmware : il appariait
    l'état `forward_blocked` avec la dernière distance reçue, alors que
    les deux viennent de trames `STATE` émises à des cadences
    différentes. Leçon d'outillage : ne jamais apparier deux trames de
    périodes différentes comme si elles étaient simultanées.

- **Firmware du 2026-09-20 validé sur le robot réel** (`RoverNetwork` /
  `LinkAuth`, voir plus bas) : boot non bloquant confirmé, `net=up
  ip=192.168.1.109 rssi=-64 drops=0`, OTA armée à la connexion
  (`wifi_mode=ota`). **Un défaut trouvé par le matériel et corrigé** :
  le backoff de 1 s réémettait `WiFi.begin()` pendant l'association
  déjà en cours (`begin(): connect failed!` à chaque passe). Aucun code
  de statut ne distingue « j'essaie encore » de « j'ai échoué » --- les
  deux valent `WL_DISCONNECTED` --- donc l'intervalle doit simplement
  être plus long qu'une tentative : 10 s, plus `WiFi.disconnect()`
  avant chaque `begin()`. Plus aucune erreur depuis.

- **Les deux prérequis bloquants du Pi déporté sont levés (2026-09-20)**
  --- c'étaient les points « 5 bis » et « 5 ter » de
  `ARCHITECTURE_AND_ROADMAP.md` §6.2, trouvés à la revue du 2026-09-15,
  et ils interdisaient de débrancher l'USB. **L'étape 1 du chantier
  (transport socket) n'est plus bloquée.** Rien n'a tourné sur
  matériel : WROOM et S3 compilent, 29/29 tests natifs, 147 tests `pi/`.
  - **`RoverNetwork.h` (nouveau) possède désormais le lien WiFi**, et
    `RoverOTA` n'apporte plus qu'ArduinoOTA. Le lien de commande ne peut
    pas dépendre d'un module de maintenance explicitement *optionnel*.
    Trois défauts réels tombent avec l'ancien montage : connexion
    **une seule fois au boot** en bloquant jusqu'à 10 s (un robot allumé
    avant sa box restait hors réseau jusqu'au reboot), reconnexion
    reposant sur un défaut du core jamais affirmé, et
    `WiFi.setSleep(false)` appelé nulle part --- or mesurer la gigue du
    lien (étape 2) avec le modem sleep actif aurait mesuré l'horaire de
    sieste de la radio, pas le réseau.
  - **Arbitrage de la radio** : le portail et le pilotage autonome
    annoncent l'emprunt/la restitution (`onRadioTaken`/`onRadioReleased`
    → `suspend()`/`resume()`) au lieu d'appeler `WiFi.mode()` chacun
    dans son coin --- c'est précisément comme ça qu'était né le
    verrouillage « portail expiré = radio morte jusqu'au reboot ».
  - **Effet de bord utile** : l'OTA s'arme à *chaque* connexion réussie
    et non plus seulement sur celle qui tombait dans la fenêtre de boot.
  - **`LinkAuth.h` (nouveau) : plus rien ne bouge sans secret** sur un
    lien réseau. Trame `AUTH secret=...` (`ROVER_PROTOCOL.md` §5.2),
    comparaison à temps constant, **fail closed** (pas de secret
    enregistré = tout est refusé, comme l'OTA refuse de flasher sans mot
    de passe), authentification **par connexion** que le Pi represente à
    chaque reconnexion.
  - **Le point le plus important est un ordre d'instructions** : le
    contrôle d'auth passe *avant* `heartbeat.reset()`. Dans l'ordre
    inverse, un pair non authentifié maintenait le robot en `ACTIVE`
    juste en lui parlant --- il atteignait le timeout de sécurité qu'il
    ne doit justement pas pouvoir toucher.
  - **Inerte sur le câble** (`requireAuth(false)`) : exiger un secret
    sur l'USB verrouillerait `move_diagnostic.py` et un simple terminal
    série sans rien apporter, l'accès physique *étant* l'authentification
    là. Le comportement d'aujourd'hui est donc strictement inchangé.
  - Une correction en cours d'écriture, à noter parce qu'elle contredit
    son propre commentaire : ma première `constantTimeEquals` sortait
    tôt en fin de chaîne --- donc **pas** à temps constant. Réécrite en
    boucle de longueur fixe, correcte parce que `strncpy` remplit tout
    le buffer de zéros aux deux points d'appel (précondition écrite dans
    le code).
  - **Nouvel instrument : `SYSTEM action=net_status`** (`net=up ip=...
    rssi=... drops=...`). Un Pi déporté ne voit pas la console du
    robot ; c'est la mesure dont l'étape 2 a besoin.
  - ⚠ **Ce qui reste et appartient au transport (étape 1)** : fermer
    réellement la connexion après un refus, et n'accepter qu'un seul
    client à la fois. Aujourd'hui le transport est un câble, il n'y a
    rien à fermer.
  - ⚠ **Limite assumée** : le secret circule en clair, protégé par le
    seul WPA2 --- même niveau que le mot de passe ArduinoOTA et le token
    du serveur de contrôle. Défi/réponse (nonce + HMAC) = incrément
    suivant.
  - Coût : **+1,2 Ko de flash** (71,6 % → 71,9 %), RAM inchangée à
    16,4 %.
- **DÉCISION D'ARCHITECTURE --- Raspberry Pi déporté (2026-09-15)** :
  le Pi quitte le châssis et devient une machine du réseau local ; le
  Rover Protocol passe du câble USB à une **socket TCP WiFi**. Le robot
  n'embarque plus qu'ESP32 + ESP32-CAM + batterie. **Carte confirmée :
  WROOM** (un S3 est disponible mais gardé pour plus tard, objectif =
  finir le projet sur le WROOM). Raisonnement complet dans
  `ARCHITECTURE_AND_ROADMAP.md` §6.2, rédigé selon les 7 questions de la
  §28. Points saillants :
  - **Coût en code quasi nul** : les deux extrémités étaient déjà
    abstraites sans que ç'ait été prévu --- `serial_for_url()` côté Pi
    accepte `socket://`, `RoverProtocol` côté ESP32 prend un `Stream&`
    (donc un `WiFiClient`). Aucun changement du protocole V1.
  - **Mesures réelles** (compilation WROOM ce jour) : RAM 16.2 %
    (53 144/327 680), Flash **71.0 %** (930 353/1 310 720, déjà en
    partition OTA double). La ressource tendue est la flash, pas la RAM.
  - **Vraie difficulté = le heartbeat** : les 500 ms étaient calibrées
    pour un câble. Remplacées par 3 paliers (NOMINAL / DEGRADED ~30 % de
    vitesse à 500 ms / TIMEOUT→SAFE à ~1500 ms), §9. ⚠ **Valeurs non
    mesurées**, à confirmer en conditions réelles.
  - **Seul sous-système pénalisé = l'audio** (§17.3) : ampli/micro sur
    l'ESP32, STT/TTS sur le Pi → l'audio doit traverser le WiFi. Viable
    sur WROOM **à condition de streamer** (~8-16 Ko) et non de
    bufferiser (~160 Ko). Impose une variante binaire/streaming de
    `POST /audio/converse`, qui renvoie du base64 aujourd'hui.
  - **Effet de bord heureux** : le déport libère `GPIO1`/`GPIO3`
    (ex-UART0 vers le Pi) --- or `esp32/WIRING.md` constatait qu'il ne
    restait *aucune* broche libre, ce qui bloquait le micro depuis la
    Phase 4. Micro INMP441 prévu sur `GPIO3` en partageant BCLK/WS avec
    l'ampli. Contrepartie assumée : perte de la console série USB,
    **mitigée par un cavalier** que la CAO rendra accessible.
  - Budget de puissance revu (~32W → ~24.5W pic), **buck 5V/3A dédié au
    Pi abandonné** (`BOM.md`), risque de brownout/corruption SD éliminé.
  - Documentation mise à jour : `ARCHITECTURE_AND_ROADMAP.md` (§4.1,
    §6.2, §9, §17.3, §19, §21), `ROVER_PROTOCOL.md` (§2, §6, §10),
    `esp32/WIRING.md`, `AIDE_CABLAGE.md`, `BOM.md`, `README.md`,
    `pi/README.md`, `esp32/OTA.md`.
- **`RoverLink` rendu résistant aux coupures réseau (2026-09-15)**,
  même session que la décision ci-dessus --- **seul code modifié à ce
  jour pour le Pi déporté**, et ce n'est pas du développement neuf mais
  la correction d'un défaut que le WiFi rend critique.
  Constat : `pi/rover_esp32/link.py` ouvrait la connexion dans
  `__init__` et écrivait dans `self._serial` sans aucune gestion
  d'erreur. Acceptable sur un câble USB (le port existe ou pas),
  **cassé sur une socket WiFi** où une coupure est un événement normal :
  (a) le process Pi refusait de démarrer si l'ESP32 n'écoutait pas
  encore, (b) `send()` levait `SerialException` → `_heartbeat_loop`
  (`core.py`) ne rattrape que `CancelledError`, donc **la tâche
  heartbeat mourait définitivement** et ne repartait jamais même réseau
  revenu, (c) le thread lecteur mourait en silence. Précédent réel de
  cette classe de panne : le bug non-ASCII du 2026-09-10 qui *« killed
  the pyserial reader thread entirely »* (`tests/test_protocol.py`).
  Violait aussi la règle `CLAUDE.md` « gère systématiquement les erreurs
  de communication ».
  Corrections : connexion supervisée avec reconnexion et backoff
  (0.5s → 5s, remis au minimum après succès), `start()` non bloquant
  (le serveur de contrôle démarre même robot éteint), `send()` renvoie
  `False` au lieu de lever, exceptions du consommateur et
  `connection_lost` neutralisées pour ne plus tuer le lien, et une
  course `stop()`-pendant-connexion fermée sous verrou (elle laissait
  fuir un thread lecteur --- **trouvée grâce à un test flaky**, pas par
  relecture). API publique inchangée : `RoverCore` et `main.py` n'ont eu
  besoin d'aucune adaptation.
  **9 nouveaux tests (`pi/tests/test_link.py`, entièrement nouveau)** ---
  contre un vrai serveur TCP en mémoire via `socket://`, donc la
  reconnexion est réellement exercée. **145 tests `pi/`**, suite lancée
  4× d'affilée pour vérifier l'absence de flakiness.
  ⚠ Restent 2 échecs **pré-existants et propres à Windows**
  (`test_rover_ai`/`test_rover_audio`, permissions `0600` des fichiers
  d'identifiants : `os.chmod` ne pose pas de bits POSIX sous Windows,
  mode 438 = `0o666`). Sans rapport avec cette session, devraient passer
  sous Linux Mint --- **à reconfirmer sur le vrai Pi**, ne pas
  « corriger » en assouplissant l'assertion, c'est une vraie garantie de
  sécurité côté Linux.
  **Toujours rien côté ESP32** : le firmware parle encore uniquement sur
  `Serial`, pas de `WiFiServer`, pas de paliers de heartbeat.
- **Pilotage autonome sans Pi ni réseau (2026-09-15)** --- exigence de
  l'utilisateur, qui **revient sur un compromis que §6.2 présentait comme
  accepté** (« plus de WiFi = plus de cerveau »). La perte de
  l'*intelligence* hors réseau reste assumée ; la perte du *pilotage*
  non. Nouveau `esp32/lib/network/StandaloneControl.h` : l'ESP32 ouvre
  son propre AP WPA2 et sert une page joystick (`PROGMEM`, pas de CDN --
  il n'y a pas d'Internet sur cet AP par définition). Conception en
  §6.3.
  - **Principe : réutiliser, jamais dupliquer.** Le module ne contient
    aucune logique de sécurité propre --- la page alimente le *même*
    `HeartbeatMonitor` que le Pi (fermer l'onglet ou sortir de portée
    arrête donc les moteurs par le timeout existant), l'E-stop prime
    toujours, le réflexe d'obstacle s'applique, et entrer dans ce mode
    ne réarme pas les moteurs.
  - **WPA2 obligatoire, refus de démarrer sans mot de passe** --- calqué
    sur `RoverOTA`. Un AP ouvert serait pire que dans le cas OTA : il ne
    flashe pas un firmware, il déplace un robot. Mot de passe distinct
    de celui de l'OTA (`solo_pass` en NVS), collecté par le portail
    existant, refusé si < 8 caractères (sans quoi `softAP()` bascule
    silencieusement en réseau **ouvert**).
  - **Déclenchement** : automatique après 30 s sans trame du Pi ---
    couvre « le lien est mort » *et* « il n'y a pas de Pi du tout »
    (avant la première trame, le compteur mesure depuis le boot, ce qui
    est voulu : c'est le cas d'usage principal). Manuel via
    `SYSTEM action=standalone`.
  - **Deux pièges attrapés en cours d'écriture**, tous deux notés dans
    le code : (1) la page alimentant le heartbeat, s'en servir pour
    détecter « le Pi est revenu » était **circulaire** et coupait l'AP
    sous les pieds du pilote → suivi séparé de `lastPiFrameMs` ;
    (2) une première version ne se déclenchait jamais sur un robot
    démarré sans Pi --- exactement le cas visé.
  - **Coût : +8 Ko de flash** (71,0 % → 71,6 %), +400 octets de RAM ---
    `WebServer` était déjà lié par le portail de provisioning.
  - ⚠ **Jamais exécuté sur matériel** : WROOM et S3 compilent, 18/18
    tests natifs, relecture --- rien de plus.
- **Revue de code complète (2026-09-15)** --- passe sur l'ensemble du
  dépôt (~9 300 lignes : `pi/`, `esp32/`, `esp32-cam/`) à la recherche
  d'incohérences, de failles et de points bloquants pour le Pi déporté.
  **Le constat le plus important m'a fait corriger ma propre
  documentation** : §6.2 affirmait que les réflexes d'obstacle étaient
  déjà locaux à l'ESP32 « puisque les VL53L0X sont de son côté ». Faux :
  les *capteurs* l'étaient, le *réflexe* non --- le firmware n'émettait
  qu'un `EVENT`, le seul blocage réel vivait côté Pi. L'argument de
  sécurité central de la décision reposait donc sur du vide.
  **8 corrections appliquées** (détail et raisonnement dans le diff) :
  - **Réflexe d'obstacle local** (`DriveController::setForwardBlocked`,
    appliqué dans `update()` donc valable aussi pour une commande
    périmée ; marche avant seule, reculer/tourner restent possibles ;
    inerte si aucun ToF sain). Le clamp du Pi est **conservé** : deux
    couches indépendantes. Nouveau champ `forward_blocked=` en
    télémétrie --- sans lui, « le robot n'avance plus » serait
    indiagnosticable depuis un Pi déporté.
  - **Troncature silencieuse des trames sortantes**
    (`RoverProtocol::send`) : une trame coupée repartait avec un
    checksum valide *calculé sur le texte tronqué*, donc indétectable
    côté réception. Ce dépôt s'est fait avoir 3 fois par des buffers
    trop petits (commentaires « 48, not 32 » / « 96, not 64 » dans
    `main.cpp`) --- la garde couvre la classe entière au seul endroit
    par où tout passe. 2 tests natifs.
  - **Verrouillage WiFi** : `RoverWifiProvisioning::stop()` finissait
    sur `WIFI_OFF` sans jamais rallumer --- un portail qui expirait tuait
    l'OTA jusqu'au reboot. Après le déport, ç'aurait été le lien de
    pilotage, sans câble pour se rattraper. Retour en `WIFI_STA` +
    `reconnect()`.
  - **Injection HTML dans le portail WiFi** : le SSID stocké était
    réinjecté brut dans `value='...'` --- une apostrophe suffit à sortir
    de l'attribut. Échappement ajouté.
  - **Boucle infinie du firmware caméra** : `stream_handler` retentait
    `esp_camera_fb_get()` sans condition de sortie ; une caméra HS
    confisquait définitivement un worker httpd (et finissait par figer
    le serveur). Abandon après 10 échecs + 503, et `esp_camera_deinit()`
    avant chaque réinitialisation (sans quoi la relance renvoie
    `ESP_ERR_INVALID_STATE` à vie).
  - **Panneaux IA/audio** : le fournisseur était fermé *avant* une
    sauvegarde qui peut échouer → panneau mort jusqu'au redémarrage.
    Ordre inversé.
  - **WebSocket** : une tâche par trame, sans référence conservée
    (asyncio ne garde qu'une référence faible → collecte possible en vol)
    et sans ordre garanti. Remplacé par une file bornée + une tâche de
    drainage unique.
  - **Docstring de `camera.py`** qui surestimait la protection : le
    proxy authentifie ceux qui passent par le Pi, il n'empêche pas
    l'accès direct à l'ESP32-CAM, qui reste ouvert sur le LAN.
  **2 points structurels documentés, non corrigés** (ils demandent du
  firmware et deviennent bloquants pour l'étape 1, voir §6.2 « 5 bis » /
  « 5 ter ») : le lien déporté n'aurait **aucune authentification**
  (alors que le serveur web exige un token et l'OTA un mot de passe), et
  la connexion WiFi vit dans `RoverOTA`, un module explicitement
  optionnel dont le lien de commande ne peut pas dépendre.
  **Vérifié** : WROOM *et* S3 compilent (portabilité `CLAUDE.md`
  respectée), 18/18 tests natifs, 143/145 tests `pi/` (2 échecs
  pré-existants propres à Windows, voir ci-dessous).
- **Audio pipeline --- STT/IA/TTS enchaînés (2026-09-11)**, même
  session que `rover_audio` ci-dessous : nouveau
  `pi/rover_control/voice_panel.py` (`VoicePanel.converse`) enchaîne
  transcription → `AIPanel.ask()` (persona/historique déjà en place,
  §17.1) → synthèse en un seul appel, chaque étage (`stt`/`ai`/`tts`)
  identifié séparément en cas d'échec (`VoiceTurnError.stage`) plutôt
  qu'une erreur indifférenciée. Nouvelle route `POST /audio/converse`
  (réponse JSON : texte entendu, texte de la réponse, audio en base64
  --- choix délibéré plutôt qu'une réponse binaire avec le texte dans des
  en-têtes HTTP, plus sûr avec de l'accentuation française) + section
  "Pipeline complet" sur `/audio` (upload d'un fichier audio, affiche
  l'échange, joue la réponse). **136/136 tests `pi/` (5 nouveaux,
  `test_voice_panel.py`)**, testé de bout en bout en isolation avec des
  fakes (STT/IA/TTS simulés) via un serveur aiohttp en mémoire.
  Referme la boucle logicielle complète de la Phase 7 "Audio pipeline"
  --- **seul maillon manquant : aucun vrai micro/haut-parleur** (pas
  câblés, pas de Pi disponible cette session), donc rien de tout ça
  essayé avec du son réel.
- **Speech-to-Text / Text-to-Speech --- module `rover_audio` écrit
  (2026-09-11)**, suite logique du Personality Engine du même jour :
  `pi/rover_audio/` (interfaces `SpeechToTextProvider`/
  `TextToSpeechProvider`, fournisseur cloud `OpenAIWhisperSTT`/
  `OpenAITTS`, fournisseur réseau local générique `LocalSTT`/`LocalTTS`,
  stockage d'identifiants dans `pi/audio_credentials.json` --- même
  forme que `rover_ai` §17.1, voir `ARCHITECTURE_AND_ROADMAP.md` §17.2).
  Panneau web `pi/rover_control/audio_panel.py` + page `/audio` +
  routes `/audio/config` (GET/POST), `/audio/transcribe` (POST, upload
  audio brut), `/audio/speak` (POST texte → audio) --- toutes protégées
  par le token existant, câblées dans `rover_core/main.py`. Bug de fuite
  de clé API entre fournisseurs (celui déjà trouvé et corrigé sur
  `ai_panel.py` le 2026-09-09) anticipé cette fois dès l'écriture : STT
  et TTS ont chacun leur propre garde "champ vide garde la clé, sauf en
  changeant de fournisseur" (`rover_control/audio_panel.py`
  `_merge_api_key`, testé explicitement --- la clé STT ne doit jamais
  fuiter dans le champ TTS). **131/131 tests `pi/` (38 nouveaux :
  `test_rover_audio.py` et `test_audio_panel.py` entièrement nouveaux)**,
  routes `/audio/*` testées en isolation avec des fakes (200/400/503
  vérifiés). **Rien de tout ça essayé avec une vraie clé API ni un vrai
  micro/haut-parleur** --- pas de Pi disponible cette session, et le
  micro (Phase 7 "Micro") n'est de toute façon pas câblé. Pas encore
  relié à `PersonalityEngine.converse()` (§17.1) --- c'est l'"Audio
  pipeline" de la Phase 7, prochaine étape une fois le micro I2S en main.
- **HUD en réalité augmentée (Meta Quest 3 / WebXR) --- premier
  incrément écrit (2026-09-11)**, suite à une idée de l'utilisateur
  (coupler Rover à son casque Meta Quest 3, argument fort pour l'aspect
  open source du projet). Conçu d'abord (`ARCHITECTURE_AND_ROADMAP.md`
  §13.1, nouvelle section) : WebXR plutôt qu'une app Quest native
  (zéro installation, zéro compte développeur Meta, réutilise le
  serveur/token/`/ws` déjà en place), deux incréments séparés
  volontairement --- HUD télémétrie tout de suite (aucune nouvelle
  donnée requise), superposition de carte plus tard (dépend de la
  Phase 9, Cartographie/Localisation, pas commencée : rien à afficher
  pour l'instant).
  **Code écrit** : nouvelle page `pi/rover_control/static/ar-hud.html`
  (session WebXR `immersive-ar` + feature `dom-overlay`, superpose le
  panneau de télémétrie existant --- distance/IMU/environnement/
  batterie/état --- sur le passthrough caméra ; fallback 2D propre si
  `immersive-ar` n'est pas supporté), route `GET /ar`
  (`rover_control/server.py`, protégée par le même token que le reste),
  lien "RA" ajouté à côté de "IA" sur `index.html`.
  **Testé** : syntaxe JS vérifiée (`node --check`), route `/ar` testée
  en isolation (200 avec token valide, 403 sans --- même middleware
  d'auth que le reste), 93/93 tests `pi/` toujours au vert (aucun test
  dédié à cette page, même convention que `index.html`/`ai.html` : "la
  logique métier est testée, la page web brute ne l'est pas"). **Jamais
  testé sur un vrai casque** (pas de Meta Quest 3 disponible cette
  session, écrit au plus près de la spec WebXR) --- seul le chemin de
  repli 2D (qui partage le même code de rendu du HUD) a pu être vérifié
  ici. Voir `pi/README.md` "Réalité augmentée" pour l'usage.
- **Personality Engine --- écrit et testé (2026-09-11)**, session
  100% code (utilisateur sans accès au robot physique). Nouveau
  `pi/rover_ai/personality.py` (`PersonalityEngine`) branché dans
  `AIPanel.ask()` (`pi/rover_control/ai_panel.py`) : chaque appel IA
  construit maintenant un vrai `AIContext` (persona Rover + historique
  de conversation borné à 10 échanges) au lieu d'un message "sec" sans
  mémoire ni personnalité --- tous les fournisseurs (`cloud.py`,
  `_openai_compatible.py`) savaient déjà lire `context.system`/
  `context.history`, rien ne les alimentait jusqu'ici. Réaction
  émotionnelle ajoutée sur l'échange : `RoverCore.set_emotion()`
  (nouvelle méthode publique, remplace les deux envois `FACE` en dur
  déjà présents dans `core.py`) envoie `curious` pendant l'appel,
  `happy` sur une réponse, `confused` sur une `AIProviderError` --- sans
  jamais faire planter la conversation si l'envoi échoue (câble série
  down, etc.). Câblé dans `rover_core/main.py`
  (`PersonalityEngine(emotion_sink=core.set_emotion)`). Nouvelle route
  `POST /ai/reset` (bouton "Nouvelle conversation" sur `/ai`) pour
  repartir sans historique ; changer de fournisseur/vendeur via
  `/ai/config` réinitialise aussi l'historique automatiquement (éviter
  qu'une conversation construite contre un backend survive au
  changement vers un autre). Voir `ARCHITECTURE_AND_ROADMAP.md` §17.1 et
  Phase 7 pour le détail, `pi/README.md` "rover-ai" pour l'usage.
  **93/93 tests `pi/` (16 nouveaux : `pi/tests/test_personality.py`
  entièrement nouveau, plus des ajouts dans `test_ai_panel.py` et
  `test_core.py`)** --- testé uniquement avec des fakes, comme le reste
  de `rover-ai` jusqu'ici : **rien de tout ça essayé sur le Pi réel**
  (pas de matériel disponible cette session).
  Volontairement pas fait dans la foulée, pour rester dans le
  périmètre "Personality Engine" et ne pas prendre de décision de
  sécurité sans l'utilisateur : "Connexion aux commandes Rover" (l'IA
  ne peut aujourd'hui que répondre en texte, pas déclencher un
  `MOVE`/`HEAD` réel) et la partie "Machine à émotions" hors
  conversation (humeur influencée par la batterie/l'heure/l'inactivité,
  cf. README "Personnalité Dynamique") --- les deux restent à faire,
  voir Phase 7 dans `ARCHITECTURE_AND_ROADMAP.md`.
- **`rover-ai` --- backend écrit et testé (2026-09-09)**, pendant que
  l'utilisateur alimentait le Pi pour la suite du câblage (VL53L0X +
  ESP32-CAM). Voir `ARCHITECTURE_AND_ROADMAP.md` §17.1 pour le détail
  architectural, `pi/README.md` "rover-ai" pour l'usage. Nouveau paquet
  `pi/rover_ai/` :
  - `provider.py` --- interface `AIProvider.ask(message, context) -> str`
    + `AIContext` (system/history) + `AIProviderError`.
  - `cloud.py` --- trois fournisseurs choisis avec l'utilisateur
    (Anthropic, OpenAI, Gemini), chacun son format de requête/réponse.
  - `local.py` --- `LocalAIProvider`, un seul fournisseur générique pour
    n'importe quel serveur compatible API OpenAI sur le réseau local
    (Ollama en référence, §17.1). Qwen 2.5 et un modèle non censuré
    demandés par l'utilisateur passent tous les deux par cette même
    classe --- juste un nom de modèle différent, aucun code par modèle.
  - `credentials.py` --- stockage `pi/ai_credentials.json` (git-ignoré,
    `pi/ai_credentials.example.json` tracké comme gabarit), écriture
    atomique, permissions `0600` posées dès la création (pas de fenêtre
    où le fichier existe en lecture large). Jamais dans `config.json`
    (même règle que `ROVER_CONTROL_TOKEN`).
  - `factory.py` --- `create_provider(credentials)` choisit le
    fournisseur actif ; type inconnu/absent → provider "non configuré"
    (`available=False`, `ask()` lève `AIProviderError` plutôt que de
    planter ou de renvoyer une réponse vide).
  **Testé en isolation** (`pi/tests/test_rover_ai.py`, 6 nouveaux tests,
  58/58 au total sur `pi/`) : session HTTP simulée pour chaque
  fournisseur (requête bien formée, réponse bien parsée, erreur HTTP et
  réponse malformée bien transformées en `AIProviderError`), aller-retour
  du stockage des identifiants, permissions du fichier, clé inconnue
  rejetée, JSON corrompu géré sans crash, sélection par la factory.
  **Rien encore branché dans `RoverCore`/`rover_control`** (pas de
  panneau web, pas d'appel réel avec une vraie clé API) --- prochaine
  étape avec le reste de la Phase 7 (micro/STT/TTS).
  **Suite (même session)** : cinq fournisseurs cloud supplémentaires
  demandés par l'utilisateur --- `QwenCloudProvider` (Qwen officiel via
  DashScope), `OpenRouterProvider`, `TogetherProvider`,
  `FireworksProvider`, `DeepInfraProvider`. Les quatre derniers sont des
  agrégateurs qui hébergent aussi bien Qwen que des modèles
  communautaires non censurés (Dolphin, "abliterated", ...) --- comme
  tous parlent l'API compatible OpenAI, chacun n'est qu'une URL de base
  + un modèle par défaut réutilisant `_OpenAICompatibleProvider`, aucune
  logique de requête nouvelle. Catalogues de modèles notés comme
  mouvants (à vérifier chez chaque fournisseur avant prod) et précision
  ajoutée : même un modèle "non censuré" chez un agrégateur reste sous
  la propre modération de ce service, seule la voie locale
  (`LocalAIProvider`) garantit une absence totale de filtre tiers.
  Confirmé à l'utilisateur : `LocalAIProvider` est déjà générique --- vaut
  pour n'importe quel serveur compatible API OpenAI et n'importe quel nom
  de modèle, aucun code par modèle. 61/61 tests `pi/` (3 nouveaux).
  **Suite (même session) : panneau web branché** --- `rover_control/ai_panel.py`
  (logique) + `rover_control/static/ai.html` (page), routes `/ai`,
  `/ai/config` (GET/POST), `/ai/ask` (POST) ajoutées à `server.py`,
  toutes protégées par le token existant (`auth_middleware` s'applique
  automatiquement à toute nouvelle route). `AIPanel` instancié dans
  `rover_core/main.py`, fermé proprement à l'arrêt. Lien "IA" ajouté en
  haut à droite de la page de pilotage (`index.html`). Un champ clé API
  vide au ré-enregistrement garde la clé déjà stockée (même convention
  que le mot de passe OTA du portail WiFi ESP32) --- **sauf en changeant
  de type de fournisseur** : bug trouvé en écrivant les tests (passer de
  "cloud" à "local" laissait la clé cloud trainer dans le fichier stocké
  alors qu'elle n'est plus utilisée), corrigé avant que ça parte plus
  loin. Testé manuellement de bout en bout avec un serveur aiohttp en
  mémoire (page/config/ask répondent, token invalide → `403`,
  fournisseur injoignable → `503` propre) --- **pas encore essayé sur le
  Pi réel**. 72/72 tests `pi/` (11 nouveaux dans
  `pi/tests/test_ai_panel.py`).
  **Suite (même session) : revue de code sur tout ce qui précède**, 3
  bugs réels trouvés et corrigés :
  1. **Fuite de clé API entre fournisseurs cloud**
     (`rover_control/ai_panel.py`) --- en changeant de fournisseur cloud
     (ex. Anthropic → OpenAI) tout en laissant le champ clé vide, la
     logique "champ vide = garder la clé actuelle" gardait l'ancienne
     clé (Anthropic) et l'enregistrait comme clé du nouveau fournisseur
     (OpenAI) --- le prochain `/ai/ask` aurait envoyé le secret Anthropic
     comme jeton Bearer à `api.openai.com`. Corrigé : la clé n'est
     conservée que si le fournisseur **et** le vendeur cloud restent
     identiques ; sinon le champ vide efface vraiment la clé.
  2. **Erreurs réseau pendant la lecture du corps de la réponse non
     rattrapées** (`rover_ai/_http.py`) --- seule l'ouverture de la
     requête était protégée ; une connexion qui tombe pendant la
     lecture du corps (timeout `sock_read`) ou un JSON malformé sur un
     `200` remontaient une exception `aiohttp`/`json` brute au lieu
     d'`AIProviderError`, cassant le contrat `503` propre attendu par
     `ai_ask_post`. Corrigé : la lecture du corps est protégée aussi.
  3. **`TypeError` non rattrapé sur un `cloud_vendor` non-string**
     (`rover_ai/factory.py`) --- un corps de requête `POST /ai/config`
     malicieux/malformé avec `cloud_vendor` en liste/dict faisait
     planter `dict.get()` (type non hashable) en `500` au lieu du
     comportement "fournisseur inconnu → non configuré" prévu. Corrigé
     avec une garde `isinstance(vendor, str)`.
  6 tests de régression ajoutés (3 dans `test_rover_ai.py`, 1 dans
  `test_ai_panel.py` + 1 test de non-régression pour vérifier qu'une
  vraie nouvelle clé tapée n'est pas perdue au passage). **77/77 tests
  `pi/`.**
- **Caméra --- décision ESP32-CAM (2026-09-06)** : la caméra ne sera
  **pas** rattachée au Raspberry Pi --- pas la place en CAO dans la tête
  pour un module Pi Camera, même déporté par nappe. Un module
  **ESP32-CAM** (déjà en main, avec sa propre caméra intégrée) filme et
  sert le flux en WiFi, indépendamment de l'ESP32 principal ; le Pi
  récupère ce flux sur le réseau et l'analyse (« l'ESP32-CAM filme, le
  Pi analyse »). Voir `ARCHITECTURE_AND_ROADMAP.md` §4.3 (nouvelle
  section) et `BOM.md`.
  **Code écrit (2026-09-06, jour suivant)** --- pas de câblage ce
  jour-là (prévu pour la session d'après), session 100% code :
  - **Firmware `esp32-cam/`** (nouveau projet PlatformIO, séparé de
    `esp32/`, voir §4.3) : board AI-Thinker ESP32-CAM confirmé avec
    l'utilisateur. `src/main.cpp` --- connexion WiFi (mêmes
    `ROVER_WIFI_SSID`/`ROVER_WIFI_PASSWORD` que le firmware principal,
    voir `esp32/OTA.md`), init caméra (`esp_camera_init`, VGA/qualité
    12, PSRAM si détectée sinon repli QVGA une seule frame buffer),
    mDNS (`rovercam.local`), serveur MJPEG (`esp_http_server`, port 81,
    `/stream`, boundary `roverframe`). Aucune authentification sur ce
    flux --- volontaire, réseau local de confiance uniquement (voir
    `esp32-cam/WIRING.md` "Sécurité"), c'est le Pi qui authentifie vers
    l'extérieur. **Compile proprement** (`pio run`, testé sur ce PC de
    dev : RAM 15.2%, Flash 27.5%, avec et sans
    `ROVER_WIFI_SSID`/`PASSWORD` définies comme en CI) --- **jamais
    flashé sur le module physique**, câblage vers un adaptateur
    FTDI/USB-TTL prévu pour la prochaine session (procédure détaillée
    dans `esp32-cam/WIRING.md`, y compris l'avertissement
    sous-alimentation classique de cette carte).
  - **`pi/rover_control/camera.py` réécrit** : ne dépend plus de
    `picamera2`, relaie maintenant (reverse proxy `aiohttp.ClientSession`)
    le flux MJPEG de l'ESP32-CAM à travers `/video`, en reprenant tel
    quel le `Content-Type`/boundary envoyé par l'ESP32-CAM plutôt que de
    ré-encoder les frames. Nouveau réglage `camera_url`
    (`--camera-url` CLI, ou clé `camera.json`/`config.example.json`),
    `None` par défaut (vidéo désactivée, `503`). `CameraStream.close()`
    ajouté et appelé à l'arrêt (`main.py`).
  - **Validé avec un faux serveur MJPEG** (script de fumée, pas de
    matériel ESP32-CAM disponible ce jour) : les trois cas --- pas
    configuré → indisponible, upstream valide → `200` avec le bon
    `Content-Type` et les bons octets relayés, upstream injoignable →
    `503` sans crash --- passent tous. **Toujours pas testé contre le
    vrai module** (pas encore flashé). Suite de tests `pi/` toujours au
    vert (37/37) --- aucune régression, pas de nouveau fichier de test
    committé pour `camera.py` (même choix que l'ancienne version
    `picamera2`, jamais testée non plus --- cohérent avec le reste du
    projet qui ne teste pas la couche serveur web elle-même).
  - CI (`.github/workflows/esp32-build.yml`) étendue : nouveau job
    `build-esp32-cam` (déclenché sur `esp32-cam/**`), en plus de la
    matrice `esp32_wroom`/`esp32_s3` existante.
- **Raspberry Pi --- bring-up bloqué sur le WiFi (2026-09-05)** : début du
  travail Phase 5 (`ARCHITECTURE_AND_ROADMAP.md`, case "OS" toujours
  décochée) --- carte SD 8 Go, Raspberry Pi 3B+ physique en main.
  Architecture d'abord posée avant le code : nouvelle section **§17.1
  "Fournisseur IA (module `rover-ai`)"** ajoutée à
  `ARCHITECTURE_AND_ROADMAP.md` --- conversation IA avec deux
  fournisseurs interchangeables à tout moment (API cloud type
  Gemini/ChatGPT/Claude avec clé utilisateur, ou LLM tournant sur un
  second Raspberry Pi du même réseau local, ex. Qwen 2.5 via Ollama),
  configurable depuis le même portail web que le pilotage
  (`pi/rover_control`), identifiants jamais dans `config.json` (comme
  `ROVER_CONTROL_TOKEN`) --- **conçu, pas encore implémenté**, Phase 7
  mise à jour en conséquence. **Rien de tout ça codé encore** : le
  blocage WiFi ci-dessous a pris toute la session.
  Flashage Raspberry Pi Imager (Raspberry Pi OS Lite 64-bit, hostname
  `rover`, SSH+utilisateur+WiFi configurés via l'écran de
  personnalisation) : le Pi démarre, SSH tourne bien
  (`systemctl status ssh` → active), mais **`wlan0` n'existe jamais**
  (absent de `ip a`, `/sys/class/net/`, `nmcli device status` --- pas
  juste "non connecté", l'interface n'est pas créée par le noyau) et
  `dmesg | grep -i brcm` ne montre **aucune trace** du pilote WiFi
  (`brcmfmac`), pas même une erreur. `rfkill` montrait le WiFi
  soft-blocked (débloqué avec `rfkill unblock wifi` +
  `raspi-config nonint do_wifi_country FR`) --- n'a rien changé, symptôme
  identique après. Hypothèses écartées dans l'ordre :
  1. Pays WiFi non configuré --- redébloqué/reconfiguré, aucun effet.
  2. Carte Pi défectueuse --- testé sur une **deuxième carte 3B+
     physique différente**, exactement le même symptôme.
  3. Cache d'image Raspberry Pi Imager corrompu
     (`%LOCALAPPDATA%\Raspberry Pi\Raspberry Pi Imager\cache\lastdownload.cache`,
     ~525 Mo, supprimé pour forcer un retéléchargement) --- reflash
     complet avec image fraîche, même symptôme.
  4. Image/OS en cause plutôt que le matériel --- testé avec **DietPi**
     (OS totalement différent) à la place de Raspberry Pi OS --- même
     symptôme exact (`wlan0` absent, rien dans `dmesg`).
  **Résolu (2026-09-06)** : confirmé matériel --- puce WiFi onboard
  endommagée sur la première carte 3B+. DietPi installé sur une carte
  physique différente : WiFi fonctionnel directement, aucun contournement
  (dongle USB) nécessaire. Pi retrouvé sur le réseau local via
  `nmap -sn 192.168.1.0/24` --- **`rover.lan` / `192.168.1.187`**
  (hostname `rover` déjà annoncé au routeur), port 22 (SSH) ouvert.
  Résolution `.local` (mDNS) pas testée avec succès directement depuis ce
  PC dev (`avahi-resolve` présent mais pas essayé, `ping rover.local` a
  timeout --- probablement juste `nss-mdns` non configuré côté client,
  pas un problème du Pi). **Configuration logicielle faite (2026-09-06,
  même session)** : connecté en SSH (login système `dietpi`, pas
  `rover` --- `rover` est le mot de passe/hostname, pas l'utilisateur),
  `python3`/`git` installés (absents par défaut sur cette image DietPi
  minimale), dépôt cloné (`~/Rover-Project`, depuis GitHub), venv créé et
  `requirements-dev.txt` installé --- **37/37 tests passent sur le
  matériel réel** (aarch64, Debian 13 trixie, DietPi 10.6.2). Utilisateur
  `dietpi` ajouté au groupe `dialout` par anticipation (nécessaire pour
  `/dev/ttyUSB0` une fois l'ESP32 branché --- pas encore le cas, aucun
  port série présent pour l'instant). `pi/rover.env` créé avec un token
  `ROVER_CONTROL_TOKEN` généré aléatoirement (fichier git-ignored, pas
  dans le dépôt).
  **ESP32 branché en USB au Pi (même session)** : détecté en
  `/dev/ttyUSB0` (CP2102), `dietpi` avait déjà été ajouté au groupe
  `dialout` par anticipation --- accès immédiat sans reconfiguration.
  `rover_core.main` lancé manuellement contre le port réel : trames
  `STATE` bien décodées (IMU/environnement cohérents, distance à `9999`
  --- VL53L0X toujours pas câblés, attendu). **Pilotage validé de bout en
  bout sur le robot réel, en conditions WiFi normales** : page de
  contrôle ouverte depuis un téléphone sur le même réseau
  (`http://192.168.1.187:8080/?token=...`), joystick tactile testé, les
  moteurs répondent. Token d'accès vérifié (`403` sans, `200` avec).
  Petite anomalie cosmétique observée et pas encore creusée : à chaque
  connexion série fraîche, une salve d'environ 1s de warnings `checksum
  mismatch` pour un fragment tronqué identique (`...as_kohm=0.0 *XX`)
  avant que le flux `STATE` ne se stabilise normalement --- reproductible
  à chaque lancement, mais sans impact fonctionnel observé une fois
  stabilisé (le pilotage n'a pas été perturbé). Piste pas creusée :
  `pi/rover_esp32/link.py` (`_LineHandler`/`ReaderThread` de pyserial)
  ou un reset ESP32 déclenché par l'ouverture du port (DTR/RTS).
  **Service systemd installé et activé (même session)** : copie de
  `pi/rover-core.service` adaptée (`User=dietpi`,
  `/home/dietpi/Rover-Project/...` au lieu des placeholders `pi`) dans
  `/etc/systemd/system/`, `enable --now` --- démarre au boot, et
  redémarrage automatique confirmé après un `SIGKILL` forcé (repart en
  moins de 7s, même token, page de contrôle de nouveau joignable).
  Rover tourne maintenant en service permanent sur le Pi.
- **WiFi/OTA (2026-09-05)** : le canal OTA existant (`esp32/lib/ota/RoverOTA.h`,
  identifiants fixés à la compilation via variables d'environnement,
  voir historique 2026-08-31) est complété par un **portail de
  configuration accessible depuis un PC ou un smartphone**, sans
  reflash --- `esp32/lib/network/RoverWifiProvisioning.h` +
  `WifiCredentialsStore.h` (nouveau dossier `esp32/lib/network/`).
  Déclenché à la demande via `SYSTEM action=wifi_setup` (jamais
  automatique au boot, pour ne pas laisser un point d'accès ouvert en
  permanence) : l'ESP32 ouvre son propre point d'accès temporaire
  (`Rover-Setup-XXXX`), sert une page web (formulaire SSID/mot de
  passe/mot de passe OTA, `WebServer`+`DNSServer` du core Arduino ESP32,
  aucune dépendance ajoutée) accessible depuis n'importe quel appareil
  WiFi, enregistre en NVS puis redémarre. `RoverOTA` lit maintenant ces
  identifiants NVS en priorité (fallback sur les variables
  d'environnement existantes si NVS vide --- rien ne casse pour l'usage
  précédent). Actions `wifi_status`/`wifi_forget` ajoutées en
  complément. Voir `esp32/OTA.md` (réécrit pour couvrir les deux
  méthodes) et `ROVER_PROTOCOL.md` §5.1. **Compile sur `esp32_wroom` et
  `esp32_s3`** (929KB/889KB flash, marge suffisante), tests natifs
  toujours au vert (16/16) --- **non testé sur matériel réel** (pas de
  réseau WiFi disponible dans cette session de développement), à
  valider au prochain accès au robot physique : portail effectivement
  joignable depuis un téléphone, formulaire fonctionnel, reconnexion
  après redémarrage, flash OTA réel une fois connecté.
  **Mise à jour (même jour, testé en conditions réelles, COM10)** :
  portail testé de bout en bout avec un vrai téléphone --- le point
  d'accès `Rover-Setup-XXXXXX` n'apparaissait d'abord dans aucun scan
  (ni téléphone ni PC), un cache de scan WiFi périmé (pas un bug
  firmware : `SYSTEM action=wifi_status` confirmait déjà `ap_started=1`
  pendant que rien n'était détecté) --- réapparu après un scan forcé.
  Deux bugs réels trouvés et corrigés pendant ce test :
  1. Buffer `wifi_status` trop court (64 octets) tronquait l'IP en
     silence (`esp32/src/main.cpp`, même classe de bug que les buffers
     ERROR/STATE de la Phase 4) --- passé à 96.
  2. **Connexion WiFi et activation OTA étaient couplées à tort** :
     `RoverOTA::begin()` refusait de rejoindre le réseau du tout tant
     qu'aucun mot de passe OTA n'était enregistré, alors que l'objectif
     explicite était de pouvoir faire les deux étapes séparément.
     Découvert en soumettant le formulaire sans mot de passe OTA
     (`wifi_mode=off` après redémarrage alors que le SSID/mot de passe
     WiFi étaient bien enregistrés). Corrigé : la connexion WiFi ne
     dépend plus que du SSID, seul `ArduinoOTA.begin()` reste
     conditionné au mot de passe OTA (`esp32/lib/ota/RoverOTA.h`,
     nouveaux modes `wifi_mode=wifi` vs `wifi_mode=ota`). Un mot de
     passe WiFi laissé vide dans le formulaire de reconfiguration garde
     désormais la valeur déjà enregistrée (même logique que le mot de
     passe OTA), pour éviter d'écraser le vrai mot de passe en ne
     voulant modifier que l'un des deux champs.
  **Validé sur matériel réel** : `STATE wifi_mode=wifi ip=192.168.1.109`
  obtenu après reflash, robot bien connecté au réseau domestique sans
  mot de passe OTA. **Complété (même session)** : second passage par le
  portail (SSID/mot de passe WiFi laissés vides, seul le mot de passe
  OTA renseigné --- confirme que les champs vides gardent bien la valeur
  déjà enregistrée) → `STATE wifi_mode=ota ip=192.168.1.109` après
  redémarrage, `ArduinoOTA` active.
  **Flash OTA réel testé (même session)** : a d'abord échoué trois fois
  de suite. Deux causes côté PC (pas firmware) : un VPN actif bloquant
  le trafic LAN (kill switch), puis le pare-feu Windows (réseau "Public"
  par défaut) bloquant la connexion TCP entrante initiée par l'ESP32
  vers l'outil de flash --- résolu en désactivant le VPN et en ajoutant
  une règle pare-feu ciblée (IP source = celle du rover uniquement).
  Une fois ça réglé, le transfert démarrait mais échouait systématiquement
  vers ~15% : `ArduinoOTA.handle()` bloque en interne pendant l'écriture
  flash sans jamais rendre la main à `loop()`, ce qui déclenchait le
  watchdog matériel 3s (`Watchdog.h`) en plein transfert --- **vrai bug
  firmware**, corrigé en nourrissant le watchdog depuis
  `ArduinoOTA.onProgress()` (`esp32/lib/ota/RoverOTA.h`). **Flash OTA
  réussi ensuite** (`Result: OK`), redémarrage propre confirmé après
  coup. **Portail de configuration WiFi/OTA entièrement validé de bout
  en bout sur matériel réel**, du premier contact (portail introuvable
  au premier scan WiFi périmé, réapparu après rescan) jusqu'à un vrai
  flash de firmware par WiFi.
- **Capteurs Phase 4 (2026-09-02)** : premiers capteurs réels câblés et
  validés. **MPU6050** : répond à `0x68`, valeurs cohérentes
  (`accel_z≈-10.5`, proche de la gravité ; gyro quasi nul à l'arrêt).
  **BME688 prévu → en réalité un BME280** reçu (chip-id lu `0x60` au lieu
  de `0x61` attendu, confirmé par le lien d'achat) --- pas de capteur de
  gaz sur cette pièce. `EnvironmentSensor` adapté pour utiliser
  `Adafruit_BME280` au lieu de `Adafruit_BME680` (voir
  `esp32/lib/sensors/EnvironmentSensor.{h,cpp}`, `platformio.ini`) ---
  valeurs cohérentes obtenues (25.7°C, 45.4% humidité, 1019.7 hPa),
  `gas_kohm` reste à 0 en permanence (pas de hardware pour ça). Adresse
  renommée `ROVER_ENV_SENSOR_ADDRESS` (était `ROVER_BME688_ADDRESS`,
  trompeur maintenant) dans `sensors_config.h`, fixée à `0x76`. **VL53L0X
  gauche/droite pas encore câblés.**
  Outillage bring-up ajouté au passage, réutilisable pour la suite :
  `SYSTEM action=i2c_scan` (liste toutes les adresses qui répondent sur
  le bus) et `action=bme_chip_id` (lit le registre chip-id brut 0xD0) ---
  utile pour diagnostiquer n'importe quel futur capteur I2C récalcitrant
  sans deviner à l'aveugle.
- **Moteurs** : **mouvement stable et symétrique obtenu (2026-09-02)** ---
  `left_speed`/`right_speed` convergent tous les deux proprement sur la
  cible (0.15) et y restent, testé sur 12s sans oscillation ni dérive.
  Chemin parcouru ce soir (résumé, détail dans `PROGRESS_ARCHIVE.md`) :
  asymétrie initiale entre canaux (`right_speed` très en retard, cf.
  historique canal B DRV8833 faible 2026-09-01, confirmé au multimètre :
  `OUT3`/`OUT4` livre ~1V de moins que `OUT1`/`OUT2` pour un `VCC` stable
  à 6V --- faiblesse électrique réelle mais pas la cause principale du
  comportement erratique) ; fils jaune/vert (`C1`/`C2`) trouvés inversés
  entre les deux moteurs, corrigés ; puis les deux roues sont parties en
  saturation (feedback positif au lieu de négatif --- mesure encodeur qui
  s'aggrave au lieu de converger). **Cause retenue** : sens de comptage
  encodeur opposé au sens réel d'entraînement moteur sur ce matériel, sur
  les deux roues. **Corrigé en firmware** (pas en recâblant encore une
  fois) : `DriveController.cpp`, `tickSign = -1.0f` passé aux deux appels
  `updateWheel()` --- flashé et vérifié sur matériel réel (`esp32_wroom`,
  COM10). À revalider si le câblage encodeur est retouché plus tard (le
  fix logiciel suppose la config actuelle ; repasser `tickSign` à `1.0f`
  si une future correction matérielle du sens rend le flip logiciel
  redondant). À revalider aussi vers 6-7V une fois les connexions soudées
  (actuellement 9V), pour ne pas faire tourner les N20 en surrégime en
  continu --- la faiblesse ~1V du canal B reste présente et à surveiller
  même si elle n'empêche plus un mouvement stable.
- **Encodeurs** : **résolu (2026-09-02)** --- la vraie cause n'était pas
  le rail 3V3 de la breadboard mais un mauvais mapping fil→fonction :
  le silkscreen du PCB encodeur donne Blanc=`M1`/Rouge=`M2` (moteur) et
  Noir=`VCC`/Bleu=`GND` (encodeur), alors qu'on avait câblé en supposant
  Rouge/Noir = fils moteur. Résultat : Blanc (en fait une borne moteur)
  était posé en direct sur le rail 3V3 ESP32, et Noir (en fait le VCC
  encodeur) recevait le PWM moteur pulsé jusqu'à 9V au lieu d'un 3.3V
  stable --- ça perturbait le rail dès que les deux encodeurs étaient
  branchés ensemble. Recâblé selon le marquage PCB (voir `WIRING.md`) :
  **les deux LED s'allument ensemble**. Pas encore vérifié : dommage
  éventuel sur l'encodeur qui a reçu le 9V pulsé, ou sur le régulateur
  3V3 ESP32 --- à surveiller en test. Prochaine étape : confirmer par
  télémétrie (`move_diagnostic.py --move`) que `left_speed`/`right_speed`
  sont comparables une fois en mouvement.
- Breadboard peu fiable sur les manipulations longues (plusieurs faux
  positifs aujourd'hui à cause de contacts qui bougent) --- souder les
  points qui ont posé problème (jumpers GPIO↔driver, VCC/GND/signal
  encodeur) est recommandé avant la prochaine session de bring-up.
- **Roues définitives montées sur ROVER (2026-09-10)** : diamètre réel
  mesuré à **31.83mm**, `ROVER_WHEEL_DIAMETER_M` mis à jour dans
  `esp32/include/motion_config.h` (remplace le placeholder 0.065m posé
  quand seul l'axe moteur nu tournait sans roue). **Flashé sur le
  matériel réel (2026-09-10, COM10, `esp32_wroom`)** : build local OK
  (RAM 16.2%, Flash 71.0%), upload `SUCCESS` en 34s, reset matériel
  automatique. La cible `MOVE` en "m/s" correspond maintenant à la vraie
  géométrie de roue. Test qualitatif au joystick prévu ensuite, robot
  surélevé (roues dans le vide) --- vérifie que les deux roues tournent
  bien, même sens, sans frottement mécanique nouveau ; la calibration
  PID sous charge réelle (item 4 "Prochaines étapes" ci-dessous) reste à
  refaire séparément une fois le robot posé au sol.
- **Premier test roues définitives, robot surélevé (2026-09-10)** :
  session interrompue en cours de diagnostic, à reprendre.
  - **Faux problème trouvé et résolu en cours de route** : à la mise sous
    tension, bip continu dès l'alimentation (avant toute commande
    joystick) + moteur droit ne répondant pas du tout. Diagnostic par
    `sudo journalctl -u rover-core -n 80` : trames `STATE` parfaitement
    normales en continu (`left_speed`/`right_speed` à `0.00`, pas de
    reset, aucun `EVENT estop_pressed`) --- écarte un bug firmware
    (reset en boucle par brownout, buzzer déclenché par le code,
    E-stop électriquement bruité). Pointait donc vers un problème
    physique côté câblage plutôt que logiciel. **Résolu en rebranchant**
    (mauvais contact --- cohérent avec l'avertissement du 2026-09-01/02
    jamais traité : jumpers GPIO↔driver et connexions moteur/encodeur
    toujours pas soudés, voir "Prochaines étapes" ci-dessous). Pas de
    cause précise isolée (quel connecteur exactement) --- si ça revient,
    regarder en premier le canal B du DRV8833 (moteur droit, déjà connu
    plus faible électriquement) et son câblage vers l'ESP32.
  - **Nouveau point bloquant, plus important** : une fois le contact
    retrouvé, **les deux moteurs tournent mais ne sont pas synchronisés**
    (pas de mesure chiffrée prise avant l'arrêt de session). Testé roues
    dans le vide (surélevé), donc ce n'est pas un problème de charge
    sol/friction asymétrique --- pointe vers PID/calibration par roue,
    ou un résidu du canal B faible, ou un effet du nouveau diamètre de
    roue (31.83mm, flashé cette session, jamais testé en mouvement réel
    avant cette coupure).
  - **Suite (même jour, reprise de session) : bug logiciel réel trouvé et
    corrigé en cours de diagnostic** --- `pi/rover_esp32/protocol.py`,
    `checksum()` faisait `content.encode("ascii")` sans filet ; une trame
    bruitée (bruit série connu au boot, cf. anomalie cosmétique du
    2026-09-06) contenant des octets non-ASCII levait `UnicodeEncodeError`
    au lieu de `FrameError`, ce qui échappait au `except FrameError` de
    `link.py` et **tuait tout le thread de lecture pyserial en silence**
    --- explique pourquoi le premier essai de diagnostic isolé
    (`move_diagnostic.py`) ne recevait plus aucune trame ensuite. Corrigé
    (converti en `FrameError`, donc juste droppé avec un warning comme
    n'importe quelle autre trame malformée) ; 2 tests de régression
    ajoutés (`pi/tests/test_protocol.py`).
  - **Cause réelle de la désynchronisation identifiée sur matériel réel**
    (ESP32 débranché du Pi, branché en direct sur COM10 pour un accès
    exclusif et rapide, `move_diagnostic.py --move`) : un emballement en
    boucle positive (mesure encodeur de signe opposé à la direction
    moteur réelle, PWM qui sature au lieu de converger --- même famille de
    bug que le `tickSign` du 2026-09-02), mais cette fois **seulement sur
    la roue droite**, apparu après un rebranchement en cours de session.
    `ROVER_TICK_SIGN_LEFT`/`ROVER_TICK_SIGN_RIGHT` séparés en deux
    constantes (`esp32/include/motion_config.h`, étaient une seule valeur
    partagée) pour pouvoir corriger un côté sans toucher à l'autre.
    Diagnostic non-trivial, deux fausses pistes en cours de route (les
    deux vérifiées sur matériel réel, pas juste en théorie) :
    1. Hypothèse initiale (signe droit inversé tout seul) testée par OTA
       --- emballement toujours présent, juste dans l'autre sens : pas la
       bonne piste, signe droit reremis à `-1.0f` (valeur d'origine).
    2. **L'utilisateur a ressoudé les fils de puissance moteur (rouge/
       blanc) au driver en cours de session**, ce qui a inversé la
       polarité du moteur **gauche** cette fois (jusque-là correct). Une
       première tentative de correction a inversé à la fois le mapping
       GPIO IN1/IN2 gauche **et** `ROVER_TICK_SIGN_LEFT` --- erreur de
       raisonnement corrigée en cours de route : inverser les deux en même
       temps s'annule mathématiquement (confirmé par une mesure
       identique au bit près à ne rien changer). Un seul des deux doit
       être inversé à la fois. Correctif final : `ROVER_PIN_MOTOR_L_IN1`/
       `IN2` laissés inchangés, seul `ROVER_TICK_SIGN_LEFT` passé à
       `1.0f`.
    **Validé à la fois par télémétrie et visuellement par l'utilisateur**
    (sens de rotation confirmé correct à l'œil sur les deux roues,
    `move_diagnostic.py --velocity 0.15 --duration 15` : `left_speed`/
    `right_speed` convergent tous les deux vers ~0.15-0.16, écart résiduel
    qui se résorbe avec le temps grâce au terme intégral --- pas un vrai
    désaccord). **Leçon retenue pour la suite** (documentée dans le
    commentaire de `motion_config.h`) : ne pas faire confiance aux valeurs
    de tickSign d'une session à l'autre dès que le câblage moteur/encodeur
    est retouché --- revérifier avec `move_diagnostic.py` (convergence
    propre = bon signe ; saturation à la vitesse plafond = mauvais signe)
    plutôt que de supposer que la dernière valeur connue tient encore.
  - **Effet de bord découvert au rebranchement ESP32↔Pi** : `rover-core`
    plantait en boucle (`SerialException: write failed: [Errno 5] Input/
    output error`) --- le débranchement/rebranchement du câble USB a fait
    réapparaître l'ESP32 en `/dev/ttyUSB1` au lieu de `/dev/ttyUSB0`
    (renumérotation classique côté noyau Linux), alors que le service
    systemd déployé pointait encore sur l'ancien chemin. Corrigé
    durablement plutôt que juste renseigner `ttyUSB1` en dur (qui aurait
    pu re-changer au prochain branchement) : `ExecStart` du service pointe
    maintenant sur le lien stable `/dev/serial/by-id/usb-Silicon_Labs_
    CP2102_USB_to_UART_Bridge_Controller_0001-if00-port0`, qui ne bouge
    pas d'un branchement à l'autre sur le même port physique. Gabarit
    `pi/rover-core.service` mis à jour avec un commentaire expliquant
    pourquoi préférer `by-id` à `/dev/ttyUSBn`, pour que ça ne piège pas
    une future réinstallation.
  - **Point restant, pour la prochaine session** : au pilotage joystick
    réel (une fois tout rebranché), la roue droite démarre avec **~1s de
    retard** par rapport à la gauche et les vitesses ne sont pas
    identiques tout de suite. Cohérent avec une limitation déjà connue et
    caractérisée (2026-09-02) plutôt qu'un nouveau bug de câblage : le
    canal B du DRV8833 (droit) est électriquement plus faible depuis le
    tout début du bring-up, et le terme intégral du PID met du temps à
    vaincre le frottement statique à basse vitesse sur ce canal --- voir
    "Calibration PID" ci-dessous, qui documente déjà ce comportement et
    propose un terme feedforward comme piste. **Décision prise avec
    l'utilisateur : ne pas retoucher le PID ce soir** (câblage pas encore
    soudé partout, tension pas encore validée à 6-7V --- retoucher les
    gains maintenant risquerait de re-régler sur une config pas
    définitive). À reprendre en priorité la prochaine session, avec le
    reste de la calibration PID/géométrie déjà prévue au point 4 de
    "Prochaines étapes".
- **Calibration PID (2026-09-02)** : géométrie roue mesurée en partie ---
  `ROVER_ENCODER_TICKS_PER_REV` mis à jour à 1073 (mesuré via le nouveau
  `SYSTEM action=raw_ticks`/`reset_ticks`, 1 tour compté à l'œil pendant
  une rotation lente motorisée --- pas de rotation à la main possible,
  le réducteur N20 est trop dur). `ROVER_WHEEL_DIAMETER_M` **reste un
  placeholder** : pas de roue montée, la CAO n'est pas finalisée, seul
  l'axe moteur nu (6.82mm, mesuré) tourne pour l'instant --- donc les
  cibles `MOVE` en "m/s" ne correspondent pas encore à une vitesse
  réelle, et tout ce qui suit a été testé **sans charge mécanique**
  (pas de frottement sol, pas d'inertie de roue réelle).
  Caractérisation des gains par défaut (180/300/0) sur la plage de
  cibles : **0.05 → ne bouge jamais** (frottement statique jamais vaincu,
  le terme P seul est trop faible et l'intégral met ~20s à saturer à
  cette erreur) ; **0.15 → converge en ~2-3s avec un léger dépassement à
  0.20 puis stable** ; **0.25 → montée douce en ~5-6s sans dépassement,
  stable ~0.24-0.25**. Gains gardés tels quels (pas de changement dans
  `motion_config.h`) --- bonne base sur la plage utile, mais **la vraie
  calibration (géométrie + gains) sera à refaire une fois une roue
  réelle montée** (dynamique moteur différente sous charge, le point de
  décrochage en basse vitesse va changer). Correctif possible pour la
  limite basse vitesse si besoin plus tard : terme feedforward (PWM
  minimum ajouté quand la cible n'est pas nulle) plutôt que remonter
  `Ki` (risque de dépassement ailleurs sur la plage).

- **Nouveaux moteurs N20 définitifs reçus, suite : PWM télémétrie,
  intermittence toujours pas résolue (2026-09-11)** : plusieurs essais
  identiques (même commande, même firmware) donnant tantôt
  `left_speed=0.00` tantôt `0.04`/`0.05` sans changement physique
  rapporté entre les essais --- preuve d'un contact intermittent (le
  firmware ne peut pas produire cette variance tout seul avec une
  commande strictement identique), pas un moteur/canal mort. **Correction
  : aucune soudure n'a été faite** --- l'essai qui a donné `0.05` stable
  était juste une coïncidence de contact favorable ce lancement-là, pas
  une réparation. Le résidu peut revenir à `0.00` à tout moment tant que
  rien n'a été physiquement changé côté câblage gauche. Ajout (permanent,
  utile au-delà de cette session) d'une télémétrie `left_pwm=`/
  `right_pwm=` dans `STATE` (`DriveController.{h,cpp}`, buffer `main.cpp`
  élargi à 96 octets) confirmant que le canal gauche pousse déjà à
  `255/255` (pleine puissance) dès qu'il produit du mouvement, contre
  `~220-229/255` côté droit pour une vitesse proche de la cible --- donc
  même dans son meilleur cas observé, la gauche reste ~3x plus faible que
  la droite à duty égal ou supérieur. Compile sur `esp32_wroom`/
  `esp32_s3`, flashé et validé sur matériel réel (COM10). **Toujours pas
  résolu** : souder les connexions côté gauche (jumpers GPIO↔driver,
  moteur↔driver, jusque-là sur breadboard) reste à faire pour de vrai.
  Une fois fait, tester si le résidu de faiblesse (~0.05 vs 0.15 à pleine
  puissance) persiste malgré un contact fiable --- si oui, tester le
  moteur gauche seul, débranché de la roue, à vide sous 6V, pour
  distinguer moteur intrinsèquement faible/défectueux d'un frottement
  mécanique côté accouplement roue/axe.
- **Nouveaux moteurs N20 définitifs reçus, premier test (2026-09-11)** :
  ESP32 branché en direct sur COM10 (comme le 2026-09-10), test
  `move_diagnostic.py --move --velocity 0.15 --duration 12` roues en
  l'air. **Roue droite saine** : `right_speed` converge normalement
  (~0.14-0.17), `raw_ticks_right=-2726` sur 5s. **Roue gauche muette** :
  `left_speed` reste à `0.00` tout du long malgré le PID qui pousse à
  fond. Écarté un encodeur totalement mort par un test `raw_ticks`
  dédié : `raw_ticks_left=117` sur les mêmes 5s (donc pas zéro) mais
  ~23x moins que la droite. Observation physique utilisateur pendant le
  test : moteur gauche **immobile et silencieux** (pas de bruit de
  blocage/effort) --- les 117 ticks résiduels sont donc probablement du
  bruit électrique/vibration parasite plutôt qu'un vrai mouvement, pas
  contradictoire avec un moteur qui ne reçoit aucun courant utile.
  **Diagnostic retenu : mauvais contact électrique côté moteur gauche
  (canal A DRV8833, `ROVER_PIN_MOTOR_L_IN1`=GPIO27/`IN2`=GPIO26)**, pas
  un bug logiciel --- le firmware n'a pas changé, seuls les moteurs ont
  été remplacés, et ce pattern (une roue muette, l'autre saine) est déjà
  celui vu le 2026-09-10 (moteur droit muet ce jour-là, résolu par un
  simple rebranchement) --- cohérent avec les connexions moteur/driver
  toujours pas soudées (voir "Prochaines étapes" point 2, non fait).
  **Pas encore vérifié physiquement** (continuité des fils du nouveau
  moteur gauche jusqu'au canal A, ou test du moteur isolé hors driver) ---
  prochaine étape avant de relancer un test de convergence complet.
  **Retesté deux fois de plus (même session, sans intervention physique
  entre les essais)** : symptôme identique à chaque fois, avec une
  nuance --- `left_speed` produit un très bref sursaut (0.01-0.04) au
  tout début de la commande `MOVE` avant de retomber à `0.00` et d'y
  rester pour le reste du test (12s). Cohérent avec un **contact
  intermittent** plutôt qu'un circuit totalement coupé (un peu de
  courant passe à la montée du PWM puis le contact se perd) --- pas
  contradictoire avec le diagnostic "mauvais contact électrique"
  ci-dessus, précise juste la nature (intermittent, pas franc).
  Test décisif toujours en attente : échanger les fils moteur gauche/
  droite sur le driver pour savoir si le défaut suit le moteur ou reste
  sur le canal A --- pas encore fait à ce stade.
  **Rebond (même session) : alimentation moteurs mesurée à 6V en sortie
  côté gauche, confirmée présente par l'utilisateur.** Écarte
  l'hypothèse "aucun courant n'arrive" (fil coupé) retenue plus haut ---
  symptôme identique reconfirmé une 5e fois avec la tension présente
  (`left_speed` sursaute à 0.01-0.02 puis retombe à `0.00` et y reste,
  `right_speed` toujours sain à ~0.16-0.17). **Nouvelles hypothèses
  principales** : (a) moteur gauche mécaniquement grippé/bloqué
  (réducteur), le sursaut correspondant au tout petit mouvement avant
  blocage --- à vérifier en tournant la roue à la main hors tension ; (b)
  protection de surcourant du DRV8833 qui verrouille le canal A dès le
  premier pic de courant au démarrage moteur, cohérent avec un plateau
  identique à chaque essai (chaque test relance l'ESP32 par reset série,
  donc redonne "une seule chance" avant verrouillage). **Test décisif
  toujours en attente** : échange physique des deux moteurs entre les
  canaux du driver, jamais réellement effectué jusqu'ici (seuls des
  rebranchements au même endroit ont été tentés).
- **Suite (même session) : nouveau driver DRV8833 installé, panne totale
  puis résidu inversé (2026-09-11)** : après remplacement du driver
  (l'utilisateur affirme qu'aucune soudure n'avait encore été faite au
  moment du point précédent), premier retest --- **plus aucune roue ne
  bouge**, `left_speed`/`right_speed` à `0.00` et `left_pwm`/`right_pwm`
  saturés à `255/255` des deux côtés. Diagnostiqué via `WIRING.md` ligne
  49 (point bloquant déjà documenté depuis 2026-09-01 sur ce type de
  breakout DRV8833) : SLEEP non câblé au 3V3 désactive le driver en
  permanence, 0A quoi qu'envoient IN1-4. **Confirmé par l'utilisateur :
  SLEEP bien sur le 3V3**, donc pas la cause ici. Point suivant vérifié
  (VM moteur + masse commune ESP32↔nouveau driver) --- après vérification,
  **les deux roues bougent de nouveau**, mais `left_speed` ressort
  **négatif et stable** (~-0.04 à -0.10) alors que la cible est positive
  (+0.15) et que `left_pwm` reste saturé à `255` sans jamais converger ---
  signature d'un problème de sens (moteur ou encodeur), pas d'absence de
  courant. **Deux tests à une seule variable tentés à tour de rôle**
  (jamais les deux en même temps, cf. leçon 2026-09-10 ci-dessus) :
  1. Échange `ROVER_PIN_MOTOR_L_IN1`/`IN2` (26↔27, compile+flash sur
     matériel réel COM10) --- signe resté négatif, écarte une inversion
     de polarité moteur comme seule explication.
  2. Reverti, puis `ROVER_TICK_SIGN_LEFT` passé à `-1.0f` seul (compile+
     flash) --- signe resté négatif également, résultat quasi identique
     au test précédent (`-0.04` dans les deux cas). Écarte aussi un
     simple problème de signe d'encodeur isolé.
  **Aucun des deux ne corrige le signe** --- conclusion retenue : le
  résidu négatif n'est probablement pas un vrai problème de convention de
  signe mais plutôt du bruit mécanique (vibration du châssis pendant que
  la droite tourne fort, jeu de réducteur) lu comme un mouvement, cohérent
  avec le fait que `left_pwm` ne cesse jamais de saturer (la boucle ne
  voit jamais de convergence réelle). **Firmware remis à l'état d'origine**
  (`ROVER_PIN_MOTOR_L_IN1=27`/`IN2=26`, `ROVER_TICK_SIGN_LEFT=1.0f`,
  aucune des deux valeurs n'étant confirmée meilleure), recompilé et
  reflashé sur COM10 avant la fin de session. **Session arrêtée ici** ---
  le test qui reste le plus informant, jamais fait malgré plusieurs
  relances : moteur gauche débranché de la roue, testé seul à vide sous
  6V, pour savoir si le moteur lui-même est capable de tourner
  normalement une fois isolé de tout ce bruit/confusion de signe.

## Prochaines étapes

### 🚨 PRIORITÉ ABSOLUE ET UNIQUE : FAIRE ROULER ROVER

**Rien d'autre ne doit être entrepris avant.** Protocole imposé, dans
l'ordre, **moteurs froids** :

1. **Vérifier le slow decay à froid.** Il a été implémenté en fin de
   session 2026-09-20 mais mesuré sur des moteurs déjà échauffés.
   `SYSTEM action=motor_raw left=100 right=100 ms=3000`, puis 150, 200.
   Attendu si le correctif est bon : rotation franche dès ~100.
   **Un test, puis une pause.**
2. **Si insuffisant : mesurer la tension aux bornes du moteur PENDANT
   qu'il force.** Jamais fait, et c'est la seule piste jamais explorée.
   Une alim qui entre en limitation fait s'effondrer la tension et
   empêche l'arrachage --- ce qui produirait exactement le seuil observé.
   Alimentation **≥ 3 A**.
3. **Si la tension tient : suspecter le DRV8833.** Le dépôt documente
   déjà deux exemplaires avec un canal faible (2026-09-01) et un
   remplacement suivi d'une panne totale (2026-09-11). Le canal droit
   ne répond plus du tout depuis la fin de session. **Prévoir un driver
   de rechange.**
4. **Rampe de démarrage** si le pic de courant déclenche la protection
   en surintensité du driver (~2 A).

⚠️ **Règles de méthode, apprises à nos dépens le 2026-09-20 :**
- **Les moteurs se dégradent quand on insiste** (3125 ticks → 116 au
  même PWM en 30 min). Tests **courts et espacés**, jamais en rafale.
- **Ne pas toucher aux gains PID** pour compenser un problème de
  puissance : les monter fait osciller le PID entre ±255 et le moteur
  vibre sur place au lieu de tourner.
- **Toujours diagnostiquer avec `motor_raw`**, jamais avec le PID : sa
  sortie sature *parce que* la roue ne tourne pas, donc elle ne
  distingue pas un blocage d'un driver mort ou d'un encodeur inversé.

**Une fois que ça roule** (et seulement après) : corriger l'inversion
gauche/droite dans `motion_config.h`, recalibrer le PID avec les
chenilles, puis reprendre le reste.

**PRIORITÉ ABSOLUE pour la prochaine session** : moteur gauche toujours
problématique avec les nouveaux moteurs + nouveau driver (2026-09-11, voir
"État actuel" ci-dessus) --- saga de la session : muet, puis intermittent,
puis (après remplacement du driver) totalement mort (SLEEP/VM/masse
vérifiés OK), puis de nouveau mobile mais avec un `left_speed` négatif et
un PWM qui sature en permanence sans jamais converger. Deux tentatives de
correction de signe (IN1/IN2 puis tick sign, une seule variable à la fois)
n'ont rien changé --- le firmware a été remis à son état d'origine, aucune
des deux hypothèses de signe n'étant confirmée. **Premier test à faire,
jamais réalisé malgré plusieurs relances** : moteur gauche débranché de la
roue, testé seul à vide sous 6V --- tourne-t-il librement et vite comme le
droit ? Coupe court à toute la confusion de signe/bruit en isolant le
moteur de l'encodeur et du reste du bruit mécanique. Une fois ça clarifié,
vérifier la continuité électrique jusqu'au canal A du nouveau driver, puis
relancer `move_diagnostic.py --move --velocity 0.15` pour reconfirmer la
convergence des deux côtés avant de reprendre le reste ci-dessous.

**Point suivant, déjà en attente depuis le 2026-09-10** : la désynchronisation
dangereuse (emballement/sens inversé) trouvée le 2026-09-10 est
**résolue et validée sur matériel réel** (voir "État actuel" ci-dessus)
--- mais il reste un résidu de réglage fin, volontairement pas traité ce
soir-là :
- Au pilotage joystick réel, la roue droite (canal B DRV8833, déjà connu
  plus faible électriquement) démarre avec **~1s de retard** et les
  vitesses ne s'égalisent pas tout de suite. Cohérent avec la limitation
  PID basse-vitesse déjà caractérisée le 2026-09-02 (voir "Calibration
  PID" ci-dessous), pas un nouveau bug de câblage.
- Ne pas retoucher les gains PID avant d'avoir fait les points 2 et 3
  ci-dessous (souder les connexions encore volantes, revalider la tension
  à 6-7V) --- retoucher maintenant risquerait de re-régler sur une config
  pas définitive. Une fois ça fait, reprendre la calibration complète
  (point 4), en envisageant le terme feedforward déjà proposé pour la
  limite basse vitesse.
- Rappel méthode (leçon de la session du 2026-09-10) : après tout
  rebranchement/ressoudage d'un moteur ou d'un encodeur, revérifier le
  sens avec `move_diagnostic.py` avant de faire confiance aux constantes
  `ROVER_TICK_SIGN_LEFT`/`RIGHT` de la session précédente --- une
  convergence propre vers la cible = bon signe, une saturation à la
  vitesse plafond = mauvais signe.

0. **Bring-up Pi terminé** (2026-09-06) : ESP32 branché, pilotage validé
   de bout en bout sur le robot réel, service systemd installé/activé
   (démarrage auto + redémarrage sur crash confirmé). Voir ci-dessus.
   Tout le travail `rover-ai` (voir §17.1) est débloqué mais pas
   commencé --- prochaine grosse brique côté Pi.
1. Vérifier que rien n'a été endommagé par l'ancien mauvais câblage
   (encodeur exposé au PWM 9V sur son VCC, régulateur 3V3 ESP32 avec une
   borne moteur en direct dessus) --- pas de symptôme attendu si tout est
   sain, mais à garder en tête si un comportement bizarre réapparaît.
2. Souder les connexions instables identifiées le 2026-09-01 (jumpers
   GPIO↔driver, VCC/GND/signal encodeur) --- d'autant plus important
   maintenant que le comportement correct dépend d'une config de câblage
   précise (voir note `tickSign` ci-dessus, à ne pas perturber en soudant
   sans y repenser).
3. Revalider à une tension proche du nominal (6-7V) une fois soudé.
4. Calibrer PID + géométrie roue --- **première passe faite (2026-09-02,
   voir ci-dessus)**, ticks/tour mesuré, gains caractérisés sur la plage
   utile. À refaire une fois une roue réelle montée (diamètre + retuning
   sous charge).
5. Commande AliExpress en cours (nouveaux moteurs N20 --- pas strictement
   nécessaire, les actuels ne sont pas défectueux --- + système
   d'alimentation : 2×18650 en série (7.4V), BMS 2S avec charge USB-C
   intégrée, buck converters servos/logique). Reste à trancher : le
   Raspberry Pi tournera-t-il sur ce même pack ou une alim séparée ---
   ça dimensionne le BMS/buck à choisir.
6. Servos tête : câblage signal documenté (`WIRING.md`/`head_config.h`),
   mais pas encore testés sur matériel réel, et leur alimentation
   (partager le rail moteurs, pas l'ESP32) reste à ajouter à `WIRING.md`.
7. ✅ **Capteurs Phase 4 terminés (2026-09-20)** : MPU6050, BME280 et
   **les deux VL53L0X** sont câblés et validés sur le robot réel. Le
   plan de câblage ci-dessous est **périmé sur un point** --- `XSHUT`
   gauche va au **3V3**, pas sur `GPIO0` (broche absente du devkit 30
   broches, voir l'état actuel en tête de fichier). Conservé tel quel
   pour mémoire du raisonnement d'origine : Câblage à faire (les deux **ensemble**,
   pas un par un --- le firmware réadresse le gauche via `XSHUT` au boot,
   il attend les deux) :
   - `VCC`/`GND` des deux → 3V3/GND commun.
   - `SDA`/`SCL` des deux → GPIO21/GPIO22 (bus I2C partagé avec
     MPU6050/BME280, déjà câblés).
   - `XSHUT` gauche → GPIO0 ; `XSHUT` droite → GPIO4.
   - Placement physique décidé : **côte à côte en façade avant** (pas
     un devant/un derrière --- le code `distance_left`/`distance_right`
     et le réflexe d'arrêt obstacle du Pi supposent les deux tournés vers
     l'avant).
   - Une fois câblés : `SYSTEM action=i2c_scan` pour vérifier qu'ils
     répondent (`0x29` avant réadressage), puis `move_diagnostic.py`
     pour voir `distance_left`/`distance_right` en tandem avec
     `SYSTEM action=bme_chip_id`-style outillage déjà en place si un
     capteur pose souci (voir outillage ajouté ce soir : `i2c_scan`
     réutilisable directement).
8. Reste identique par ailleurs (voir `ARCHITECTURE_AND_ROADMAP.md`) :
   Raspberry Pi physique, caméra, MQTT contre un vrai broker, buzzer
   audible, VPN en conditions réelles.
9. Portail WiFi/OTA (2026-09-05, voir ci-dessus) : **entièrement validé
   de bout en bout sur matériel réel, flash OTA réel inclus**. Rien de
   plus à faire ici pour l'instant.

**Chantier « Pi déporté » (décidé le 2026-09-15, rien d'implémenté).**
Ne pas démarrer avant d'avoir réglé le moteur gauche ci-dessus --- mais
l'ordre interne de ce chantier compte, parce qu'il est conçu pour
échouer tôt et pas cher :

0. ✅ **Les deux prérequis bloquants sont levés (2026-09-20)** ---
   authentification du lien (`LinkAuth.h`, trame `AUTH`) et WiFi sorti
   de `RoverOTA` (`RoverNetwork.h`). Détail en tête de fichier et dans
   `ARCHITECTURE_AND_ROADMAP.md` §6.2, questions « 5 bis » / « 5 ter ».
   **Rien n'a tourné sur matériel** : compilation WROOM + S3, 29 tests
   natifs, 147 tests `pi/`, relecture --- rien de plus. Deux morceaux de
   ces deux points appartiennent au transport et se feront donc à
   l'étape 1 juste en dessous : **fermer la connexion après un refus
   d'auth**, et **n'accepter qu'un seul client à la fois**.

1. **Transport socket d'abord, mécanique ensuite.** Côté ESP32,
   `WiFiServer` → `WiFiClient` passé à `RoverProtocol` (qui prend déjà
   un `Stream&`), avec repli sur `Serial` tant que le câble existe
   encore. Côté Pi, **plus rien à écrire** : `RoverLink` supervise déjà
   la connexion et reconnecte (fait le 2026-09-15), il ne reste qu'à
   mettre `socket://host:port` dans `config.json` (et exporter
   `ROVER_LINK_SECRET`, voir le point 0). Garder le Pi physiquement sur
   le robot à ce stade --- on ne teste qu'une chose à la fois.
   Trois choses à faire dans ce jet, toutes propres au transport :
   - `linkAuth.requireAuth(true)` **par connexion**, et
     `linkAuth.reset()` à chaque nouveau client. C'est le seul endroit
     qui peut le savoir.
   - **Fermer la socket sur un refus d'auth** (aujourd'hui le refus se
     contente de répondre `ERROR` : sur un câble il n'y a rien à
     fermer). Un pair qui échoue a droit à une tentative, pas à une
     socket ouverte pour continuer à deviner.
   - **Une seule connexion à la fois** : refuser la seconde plutôt que
     de laisser deux pilotes se disputer les moteurs.
   ✅ `WiFi.setSleep(false)` est déjà fait (`RoverNetwork.h`,
   2026-09-20) --- sans ça la mesure de l'étape 2 aurait mesuré
   l'économie d'énergie radio, pas le lien.
2. **Mesurer avant de régler.** Gigue et taux de perte du lien WiFi,
   robot en mouvement et à distance du point d'accès. L'instrument
   existe depuis le 2026-09-20 : `SYSTEM action=net_status` renvoie
   `net=up ip=... rssi=... drops=...` (compteur de coupures depuis le
   boot), lisible depuis un Pi qui ne voit pas la console du robot. C'est cette mesure
   qui fixe les seuils de §9 --- les 500 ms/1500 ms écrits aujourd'hui
   sont une hypothèse, pas un résultat. Tant que ce n'est pas mesuré, ne
   pas toucher à `ROVER_HEARTBEAT_TIMEOUT_MS`
   (`esp32/include/board_config.h`).
3. **Durcir** : paliers de heartbeat, `WiFi.setSleep(false)`, échéance
   propre à chaque `MOVE` (« vitesse X pendant au plus N ms »).
4. **Seulement là**, retirer physiquement le Pi et adapter la CAO
   (emplacement du cavalier `GPIO3` accessible sans démontage).
5. **Audio en dernier**, une fois le lien éprouvé : micro INMP441 sur
   `GPIO3`, variante binaire/streaming de `POST /audio/converse` côté
   Pi. Ne pas tenter de bufferiser un énoncé complet sur le WROOM.

------------------------------------------------------------------------

## Journal court (une ligne par session --- détail complet dans PROGRESS_ARCHIVE.md)

- **2026-11-13** --- **PCB dessiné, en deux cartes 75 × 50 mm superposées**
  (`pcb/rover_puissance/`, `pcb/rover_logique/`, connecteur 2 × 15
  broches). Une carte unique à cette taille s'est révélée impossible à
  router. Schémas et PCB générés par script (`pcb/gen/`), routés par
  Freerouting ; contrôles KiCad propres (0 liaison manquante, schéma ↔
  carte cohérent), brochage conforme à `board_pins_pcb_v1.h`
  (`pcb/test/`). Fichiers JLCPCB et guide de commande dans
  `pcb/GUIDE.md`. **Jamais fabriqué, rien de vérifié sur matériel ;
  stock LCSC non recontrôlé.**
- **2026-11-14** --- Relecture du firmware `rover_pcb_v1` contre la
  datasheet du BQ25887 : codage du courant de charge corrigé (décalage
  de 50 mA inexistant), ADC du chargeur remis en 15 bits, lectures I2C
  du chargeur groupées (9 → 3 par cycle), échelle des ADC confirmée
  (1 mV/pas). Datasheet contradictoire sur l'adresse I2C (0x6A / 0x6B) :
  0x6A conservé, à vérifier sur matériel. 3 cibles compilent, 56 tests.
- **2026-11-14 (suite)** --- Les bips (démarrage, obstacle, batterie
  faible, arrêt d'urgence) sortent par les haut-parleurs du PCB :
  `Buzzer` garde ses motifs et délègue à `I2sBeeper` (I2S 16 kHz, amplis
  réveillés seulement pendant un bip). WROOM/S3 inchangés (toujours
  muets). 3 cibles compilent, 63 tests. **Jamais exécuté sur matériel.**
- **2026-09-20** --- **Les deux prérequis bloquants du Pi déporté sont
  levés** (§6.2 « 5 bis » / « 5 ter »), l'étape 1 du chantier n'est plus
  interdite. `RoverNetwork.h` prend la propriété du lien WiFi (que seule
  l'OTA, module *optionnel*, établissait) : connexion non bloquante,
  reconnexion supervisée avec backoff, `setSleep(false)`, arbitrage de
  la radio avec le portail et le pilotage autonome. `LinkAuth.h` ajoute
  une trame `AUTH` obligatoire sur un lien réseau, à temps constant et
  fail-closed, **contrôlée avant le heartbeat** --- sans quoi un pair non
  authentifié tenait le robot en `ACTIVE` rien qu'en lui parlant. Inerte
  sur le câble, donc comportement d'aujourd'hui inchangé. Nouvel
  instrument `SYSTEM action=net_status` pour la mesure de l'étape 2.
  +1,2 Ko de flash. 29 tests natifs (+11), 147 tests `pi/` (+4). Jamais
  exécuté sur matériel.

- **2026-09-20 (3)** --- **Session matérielle longue, déplacement
  toujours pas acquis.** Moteurs : firmware définitivement innocenté
  (nouvel outil `motor_raw`, duty fixe sans PID --- la sortie du PID ne
  peut pas diagnostiquer une roue immobile, elle sature *parce que* rien
  ne bouge). Driver, moteurs, encodeurs et mécanique tous vérifiés bons ;
  seuil de démarrage anormal (200-255 au lieu de 60-80) non expliqué.
  Écartés : friction (le moteur tourne à la main), fréquence PWM (5 kHz
  pire que 20 kHz), gains PID (les monter à 900/1200 a fait osciller le
  PID entre ±255 --- mon erreur, remis à 180/300). **Slow decay
  implémenté en fin de session**, gain réel mesuré (13 ticks à PWM 100
  contre 0), mais à revalider à froid. Servos : montage tandem abandonné
  (un seul servo + roulement), origine mécanique persistée en NVS,
  palonnier trouvé monté ~90° hors du neutre après une longue série de
  fausses pistes. **GPIO19 morte** sur ce devkit (2e anomalie après
  GPIO0). Tampon RX série à 2048 (corrige `checksum_invalid` toutes les
  5 s pendant le pilotage). ⚠️ **Les moteurs se dégradent quand on
  insiste** : travailler à froid, tests courts.

- **2026-09-20 (2)** --- **Les deux VL53L0X enfin câblés et validés sur
  le robot**, bloqués depuis le 2026-09-02 par un plan de câblage
  irréalisable : `WIRING.md` demandait `GPIO0` pour le `XSHUT` gauche,
  **que le devkit WROOM 30 broches ne sort pas**. Corrigé en n'utilisant
  qu'un seul `XSHUT` (il suffit d'éteindre un capteur pour réadresser
  l'autre), `XSHUT` gauche au 3V3. Piège attrapé au passage : sans
  `XSHUT`, le capteur gauche garde son adresse jusqu'à la coupure
  d'alimentation et disparaîtrait dès le 2e boot --- remis à l'adresse
  d'usine par le registre `0x8A`. Gauche/droite confirmés non inversés.
  Nouvel outillage `SYSTEM action=tof_status`/`tof_rescan`.

- **2026-09-15 (3)** --- **Pilotage autonome sans Pi ni réseau**
  (`StandaloneControl.h`, §6.3) : l'ESP32 ouvre son propre AP WPA2 et
  sert une page joystick. Rattrape le seul vrai point faible du Pi
  déporté. Aucune logique de sécurité dupliquée : la page bat le même
  heartbeat que le Pi. +8 Ko de flash. Jamais testé sur matériel.
- **2026-09-15 (2)** --- Revue de code complète du dépôt. Constat
  principal : §6.2 affirmait à tort que le réflexe d'obstacle était déjà
  local à l'ESP32 (les capteurs l'étaient, pas le réflexe) --- corrigé
  en firmware *et* dans la doc. 8 corrections au total (réflexe local,
  troncature de trame indétectable, verrouillage WiFi, injection HTML du
  portail, boucle infinie caméra, ordre fermeture/sauvegarde des
  panneaux, tâches WebSocket, docstring trompeuse). 2 prérequis
  bloquants documentés pour le Pi déporté : **aucune authentification**
  sur le lien, et WiFi enfermé dans `RoverOTA`.

- **2026-09-15** --- Décision d'architecture : **Raspberry Pi déporté sur
  le réseau** (socket TCP WiFi au lieu du câble USB), **carte WROOM
  confirmée** (S3 gardé pour plus tard). Motivée par l'encombrement et
  l'autonomie, validée par compilation réelle (Flash 71 %, RAM 16 %).
  Trois conséquences traitées : heartbeat à paliers (§9), audio en
  streaming obligatoire (§17.3), et déblocage inattendu de `GPIO3` pour
  le micro (cavalier prévu). Côté code, une seule correction mais réelle :
  `RoverLink` ne survivait pas à une coupure réseau (reconnexion, `send()`
  qui ne lève plus, course `stop()` fermée) --- 9 nouveaux tests, 145 au
  total. Firmware ESP32 non modifié.

- **2026-09-11** --- Session bring-up des moteurs N20 définitifs, non
  résolue. Résumé : muet (contact intermittent, jamais soudé malgré une
  fausse annonce en cours de session) → nouveau driver DRV8833 installé →
  panne totale (SLEEP/VM/masse vérifiés OK, cause non identifiée) → de
  nouveau mobile mais `left_speed` négatif avec PWM saturé en permanence.
  Deux corrections de signe testées séparément (IN1/IN2, puis tick sign)
  sans effet sur le résultat --- probablement du bruit mécanique plutôt
  qu'un vrai problème de signe, vu que le PWM ne converge jamais. Firmware
  remis à l'état d'origine. Ajout permanent utile : télémétrie
  `left_pwm=`/`right_pwm=` dans `STATE` (`DriveController`, `main.cpp`) ---
  a permis de prouver que le firmware pousse bien à pleine puissance sans
  bug logiciel, isolant le problème côté matériel. Session arrêtée avant
  le test le plus informant (moteur gauche seul, à vide, hors roue) ---
  voir "Prochaines étapes".
- **2026-09-11 (premier test, détail)** --- Nouveaux moteurs N20 définitifs reçus, premier test
  (`move_diagnostic.py --move`, ESP32 en direct sur COM10, roues en
  l'air) : roue droite saine (convergence PID normale), **roue gauche
  muette** (immobile et silencieuse à l'observation, PID poussant à
  fond sans effet) --- écarté un encodeur mort via `raw_ticks` (117
  ticks non-nuls mais ~23x moins que la droite, probablement du bruit
  parasite). Diagnostic retenu : mauvais contact électrique côté moteur
  gauche plutôt qu'un bug logiciel (firmware inchangé, même pattern
  qu'un incident similaire déjà vu le 2026-09-10 sur l'autre roue,
  résolu par rebranchement). Vérification physique du câblage à faire
  en priorité la prochaine session.
- **2026-09-10** --- Roues définitives montées sur ROVER, diamètre mesuré
  (31.83mm), `ROVER_WHEEL_DIAMETER_M` mis à jour et flashé sur matériel
  réel (COM10). Premier test au joystick robot surélevé : faux problème
  (bip continu + moteur droit muet dès l'alimentation) diagnostiqué via
  les logs `rover-core` (télémétrie parfaitement normale, donc pas un bug
  firmware) puis résolu par un simple rebranchement --- mauvais contact,
  cohérent avec les connexions jamais soudées. **Point bloquant restant,
  prioritaire pour la suite : les deux moteurs tournent mais ne sont pas
  synchronisés**, même roues dans le vide. Session interrompue ici avant
  d'avoir pu mesurer/diagnostiquer plus loin --- voir "Prochaines étapes"
  en tête de fichier.
- **2026-09-10 (reprise même jour)** --- Désynchronisation diagnostiquée
  et corrigée. Bug logiciel réel trouvé en route : `checksum()`
  (`pi/rover_esp32/protocol.py`) plantait tout le thread de lecture
  série sur une trame bruitée non-ASCII au lieu de la dropper --- corrigé
  (`FrameError`), 2 tests de régression ajoutés. Cause de la
  désynchronisation isolée sur matériel réel (ESP32 débranché du Pi,
  branché en direct sur COM10) : emballement en boucle positive sur la
  roue droite seule (signe encodeur, même famille que le bug `tickSign`
  du 2026-09-02), compliqué par un ressoudage des fils moteur en cours de
  session qui a inversé la polarité de la roue gauche entre-temps.
  `ROVER_TICK_SIGN_LEFT`/`RIGHT` séparés en deux constantes
  (`motion_config.h`) et calibrés empiriquement par mesure réelle
  (`move_diagnostic.py`) + confirmation visuelle utilisateur du sens de
  rotation --- une fausse piste en route (inverser broche moteur ET signe
  encodeur ensemble s'annule mathématiquement, leçon notée dans le code).
  Effet de bord trouvé au rebranchement ESP32↔Pi : `rover-core` plantait
  en boucle sur `/dev/ttyUSB0` devenu `/dev/ttyUSB1` après le
  débranchement --- corrigé durablement via le lien stable
  `/dev/serial/by-id/...` (gabarit `pi/rover-core.service` mis à jour).
  **Point bloquant dangereux résolu et validé.** Résidu restant (roue
  droite ~1s de retard au démarrage, vitesses pas identiques tout de
  suite) identifié comme la limitation PID basse-vitesse déjà connue
  (2026-09-02, canal B faible) --- laissé pour la prochaine session
  plutôt que retouché sur un câblage pas encore définitif (jumpers pas
  soudés, tension pas encore à 6-7V). Voir "Prochaines étapes".
- **2026-09-09** --- Backend `rover-ai` écrit et testé pendant que
  l'ESP32-CAM/VL53L0X étaient préparés pour câblage : interface
  `AIProvider` commune, trois fournisseurs cloud (Anthropic/OpenAI/
  Gemini), un fournisseur local générique compatible OpenAI (Qwen 2.5 ou
  modèle non censuré = juste un nom de modèle, même classe), stockage
  des identifiants git-ignoré en `0600`, factory de sélection. 58/58
  tests `pi/` passent (6 nouveaux). Rien encore branché dans
  `RoverCore` ni de panneau web --- backend seul, voir §17.1.
- **2026-09-06** --- Blocage WiFi résolu : puce onboard endommagée sur la
  1ère carte 3B+, DietPi sur une carte différente fonctionne directement.
  Pi retrouvé sur le réseau (`rover.lan`, 192.168.1.187, SSH ouvert),
  environnement logiciel mis en place (python3/git installés, dépôt
  cloné, venv, 37/37 tests passent sur le matériel réel, token de
  contrôle généré). ESP32 principal branché en USB au Pi (même
  session) : **pilotage complet validé de bout en bout sur le robot
  réel** --- joystick tactile depuis un téléphone → Pi (WiFi) → ESP32 →
  moteurs, token d'authentification vérifié. Service systemd installé et
  activé (`rover-core`, démarrage auto au boot, redémarrage confirmé
  après un `SIGKILL` forcé). Décision d'architecture
  caméra : ESP32-CAM déporté et indépendant à la place d'une caméra
  Raspberry Pi (contrainte CAO tête), voir `ARCHITECTURE_AND_ROADMAP.md`
  §4.3 --- pas encore implémenté.
- **2026-09-06 (suite, code uniquement, pas de câblage)** --- Firmware
  `esp32-cam/` écrit (nouveau projet PlatformIO, AI-Thinker ESP32-CAM
  confirmé) : WiFi, init caméra, mDNS `rovercam.local`, serveur MJPEG
  `esp_http_server` port 81 `/stream`. Compile proprement (RAM 15.2%,
  Flash 27.5%) --- pas encore flashé (câblage FTDI prévu la prochaine
  session, voir `esp32-cam/WIRING.md`). `pi/rover_control/camera.py`
  réécrit en reverse proxy `aiohttp` vers ce flux (`camera_url`
  configurable, `503` si absent/injoignable) --- validé avec un faux
  serveur MJPEG (pas le vrai module), 37/37 tests `pi/` toujours au
  vert. CI étendue pour compiler `esp32-cam/` en plus de
  `esp32_wroom`/`esp32_s3`.
- **2026-09-05 (suite, Raspberry Pi)** --- Architecture `rover-ai`
  conçue et documentée (§17.1, deux fournisseurs IA interchangeables :
  API cloud ou LLM réseau local) ; début bring-up Raspberry Pi 3B+
  (carte SD 8 Go) bloqué sur le WiFi --- `wlan0` n'existe jamais côté
  noyau, testé sur deux cartes physiques, deux OS différents
  (Raspberry Pi OS + DietPi) et après reflash complet (cache Imager
  purgé), symptôme identique à chaque fois. Non résolu, session
  arrêtée ici (voir "Prochaines étapes" point 0).
- **2026-09-05** --- Portail de configuration WiFi accessible PC/smartphone
  ajouté (`esp32/lib/network/`, `SYSTEM action=wifi_setup`), sans
  reflash, identifiants persistés en NVS ; `RoverOTA` branché dessus
  (fallback sur les variables d'environnement existantes). **Testé et
  validé sur matériel réel (COM10)** : bug de buffer tronquant l'IP
  corrigé, bug plus sérieux de couplage WiFi/OTA trouvé et corrigé
  (connexion WiFi dépendait à tort d'un mot de passe OTA déjà défini) ;
  connexion au réseau domestique confirmée (`wifi_mode=wifi`), puis OTA
  activée en un second passage par le portail (`wifi_mode=ota`). **Flash
  OTA réel ensuite testé et réussi** après avoir écarté un VPN/pare-feu
  PC bloquant le trafic, puis corrigé un vrai bug firmware (watchdog 3s
  qui se déclenchait en plein transfert, `ArduinoOTA.onProgress` ajouté
  pour le nourrir) --- portail WiFi/OTA entièrement validé de bout en
  bout.
- **2026-09-02** --- Erreur de mapping fil→fonction encodeur trouvée et
  corrigée (silkscreen PCB) ; asymétrie moteur/canal B diagnostiquée
  (multimètre) puis vraie cause trouvée : sens de comptage encodeur
  opposé au sens moteur sur les deux roues, corrigé en firmware
  (`tickSign`) ; PID + géométrie roue première passe (ticks/tour mesuré
  à 1073, gains 180/300/0 caractérisés 0.05-0.25, pas de roue montée
  donc à refaire plus tard) ; MPU6050 et BME280 câblés et validés (le
  BME688 prévu s'est avéré être un BME280, détection auto par chip-id
  ajoutée pour un futur remplacement plug-and-play) ; outillage bring-up
  I2C ajouté (`i2c_scan`, `bme_chip_id`, `raw_ticks`/`reset_ticks`) ;
  VL53L0X pas encore câblés, plan de câblage documenté pour la prochaine
  session (voir "Prochaines étapes" ci-dessus).
- **2026-09-01 (aujourd'hui)** --- Bring-up moteurs résolu (9V) ; LED
  encodeur d'une roue trouvée éteinte puis rallumée en rebranchant les
  câbles (mauvais contact, pas un capteur mort --- correction en cours de
  session) ; PROGRESS.md scindé en résumé + archive pour alléger les
  reprises de session.
- **2026-09-01 (suite, pause)** --- Chasse à l'instabilité ESP32 sous
  charge : câble USB défectueux trouvé (cause principale), découplage
  driver ajouté, 2 boards DRV8833 chacune avec un canal faible différent
  identifiées ; combiner les deux a dégradé les deux canaux --- session
  interrompue en pause, non résolue à ce stade.
- **2026-09-01** --- Premier bring-up moteurs/encodeurs réels : 3 bugs
  matériels trouvés et corrigés (SLEEP non câblé, encodeurs sans pull-up,
  1er board DRV8833 canal B mort → remplacé).
- **2026-08-31 (suite 7)** --- Phase 6 terminée : guide VPN WireGuard
  auto-hébergé complet (non testé, pas de Pi/routeur disponibles).
- **2026-08-31 (suite 6)** --- Commandes HEAD branchées dans l'UI de
  contrôle (pad tactile + manette), validé de bout en bout contre l'ESP32
  réel.
- **2026-08-31 (suite 5)** --- Buzzer (GPIO12), réflexe d'arrêt sur
  obstacle (Pi), comportement "sommeil" en idle, 2 animations
  (LOOK_AROUND/WAKE_UP), publication MQTT minimale.
- **2026-08-31 (suite 4)** --- Tests Python (25, bug hmac sur chaîne vide
  corrigé), HTTPS/WSS, service systemd (non testable sous Windows),
  encodeur Wokwi investigué mais volontairement pas implémenté,
  calibration PID sans reflash (NVS, validée à travers un vrai reboot).
- **2026-08-31 (suite 3)** --- Validation visuelle UI (claude-in-chrome)
  + 9 chantiers sécurité/robustesse : E-stop, batterie (désactivée par
  défaut), OTA (fail-closed, aucun secret en dur), config/logs Pi, mDNS,
  authentification obligatoire partout, dépendances épinglées,
  permissions CI minimales, vidéo MJPEG (pas de caméra).
- **2026-08-31 (suite 2)** --- CI GitHub Actions, tests unitaires natifs
  (RoverProtocol/WheelPID/Emotion), IMU simulé dans Wokwi, machine à
  états comportementale `rover_core`, UI capteurs fusionnée.
- **2026-08-31 (suite)** --- Phase 4 (capteurs) écrite et testée sur ESP32
  réel sans capteur câblé : 2 bugs trouvés (VL53L0X bloquant sans sonde
  de présence I2C, buffers ERROR/STATE trop petits, tronquaient en
  silence).
- **2026-08-31** --- Premier test matériel réel (écran) : driver CP210x
  installé, résolution corrigée 240×280 paysage, glitch retravaillé ---
  rendu visuel confirmé sur écran physique réel.
- **2026-08-25 (suite 6)** --- Retouche des yeux : forme carrée, glitch
  permanent, clignement lissé, mouvement "breathing" continu (toujours
  pas de vérif visuelle possible en headless).
- **2026-08-25 (suite 5)** --- Phase 3 terminée au niveau code : yeux/
  écran/tête, dispatch HEAD/FACE/ANIMATION, validé en simulation
  protocole seulement (pas de rendu visuel capturable en headless).
- **2026-08-25 (suite 4)** --- Retour d'état dans l'UI (validé) ; Phase 3
  démarrée (HeadController/ServoJoint écrits mais pas encore branchés).
- **2026-08-25 (suite 3)** --- Rover pilotable en local : `pi/` créé
  (protocole, RoverCore, serveur de contrôle + UI joystick/manette),
  validé de bout en bout contre la simulation Wokwi.
- **2026-08-25 (suite 2)** --- Durcissement Phase 2 : spinlock ESP32 pour
  l'encodeur, dérivée PID recalculée sur la mesure (pas l'erreur), garde
  NaN/Inf + clamp rotation.
- **2026-08-25 (suite)** --- Phase 2 (motorisation) écrite : DRV8833
  (remplace le TB6612FNG initialement prévu), moteurs/encodeurs/PID,
  validée en simulation Wokwi (boucle ouverte, pas d'encodeur simulé).
- **2026-08-25** --- Environnement Wokwi mis en place ; Phase 1 validée
  entièrement en simulation (boot, ping, diag, timeout heartbeat,
  checksum, resume).
- **2026-08-23** --- Phase 0 (architecture) figée ; scaffold Phase 1 ESP32
  écrit (Rover Protocol, heartbeat, watchdog, diagnostics), compile sur
  les deux cibles, pas encore testé sur matériel réel.
