RaphaelGrj/Rover-Project/ROVER_PROTOCOL.md

# Rover Protocol --- Spécification V1

> Document technique complémentaire à `ARCHITECTURE_AND_ROADMAP.md`.
> Ce document définit le format exact des messages échangés entre le
> Raspberry Pi et l'ESP32 (section 7 du document d'architecture).

------------------------------------------------------------------------

## 1. Version

```
ROVER_PROTOCOL_V1
```

Le numéro de version doit être annoncé par l'ESP32 au démarrage (voir
§8) et vérifié par le Raspberry Pi. Un changement incompatible du
format impose une nouvelle version (`ROVER_PROTOCOL_V2`, ...), jamais
une modification silencieuse de la V1.

------------------------------------------------------------------------

## 2. Couche physique

- Liaison : **socket TCP sur le WiFi** depuis le 2026-09-15 (Pi
  déporté, voir §6.2 de l'architecture). Transport historique : UART
  série sur câble USB (`/dev/ttyUSB0`).
- Vitesse : `115200` bauds, 8N1 --- pertinent uniquement pour le
  transport UART.
- **Le format des trames est identique quel que soit le transport.**
  Aucun message, aucun checksum, aucune séquence de démarrage ne change
  entre USB et WiFi : c'est un changement de couche physique, pas de
  protocole. Le protocole V1 n'est donc pas versionné à nouveau
  (voir §29 de l'architecture).
- Cette portabilité n'est pas un heureux hasard, elle était déjà
  garantie aux deux extrémités :
  - côté ESP32, `RoverProtocol` est conçu autour d'un `Stream`
    générique --- un `WiFiClient` *est* un `Stream`, au même titre qu'un
    `HardwareSerial` ;
  - côté Pi, `pi/rover_esp32/link.py` utilise
    `serial.serial_for_url()`, qui accepte indifféremment
    `/dev/ttyUSB0`, `socket://host:port` ou `rfc2217://...` (ce dernier
    servant déjà à piloter une simulation Wokwi).
- L'implémentation ne doit dépendre d'aucun port ni d'aucun transport
  particulier.

------------------------------------------------------------------------

## 3. Format général d'un message

Chaque message est une ligne ASCII terminée par `\n` :

```
TYPE [clé=valeur ...] *CS\n
```

- `TYPE` : type du message (`MOVE`, `HEAD`, `STATE`, `EVENT`, ...).
- `clé=valeur` : zéro ou plusieurs champs séparés par un espace.
- `*CS` : marqueur de checksum, précédé d'un espace.
- `CS` : 2 caractères hexadécimaux majuscules.

### 3.1 Calcul du checksum

Le checksum est le **XOR** de tous les octets du contenu, c'est-à-dire
`TYPE` et les champs `clé=valeur` séparés par un simple espace, **sans**
l'espace final ni le `*CS` lui-même.

Exemple :

```
MOVE velocity=0.0150 rotation=-0.1000 *3A
```

Contenu utilisé pour le checksum : `MOVE velocity=0.0150 rotation=-0.1000`.

### 3.2 Contraintes de trame

- Longueur maximale d'une ligne : **128 octets** (`\n` exclu).
- Encodage : ASCII imprimable uniquement.
- Une ligne trop longue ou dont le checksum est invalide est
  **rejetée silencieusement au niveau transport** ; l'ESP32 répond
  `ERROR frame_too_long` ou `ERROR checksum_invalid` (voir §9).
- Le récepteur doit tolérer une terminaison `\r\n` (le `\r` est ignoré).

------------------------------------------------------------------------

## 4. Catégories de messages

```
COMMAND        Raspberry Pi → ESP32
STATE          ESP32 → Raspberry Pi
EVENT          ESP32 → Raspberry Pi
ERROR          ESP32 → Raspberry Pi
ACK            ESP32 → Raspberry Pi
HEARTBEAT      Raspberry Pi → ESP32
AUTH           Raspberry Pi → ESP32
```

------------------------------------------------------------------------

## 5. COMMAND (Pi → ESP32)

| Type | Champs | Exemple |
|---|---|---|
| `MOVE` | `velocity` (m/s), `rotation` (rad/s) | `MOVE velocity=0.0150 rotation=-0.1000 *3A` |

⚠️ **Résolution des nombres** : `velocity` et `rotation` sont émis avec
**quatre décimales**, et ce n'est pas de la coquetterie. La plage de vitesse
réelle de ce robot est 0 à 0,03 m/s (`ROVER_MAX_WHEEL_SPEED_MPS`, mesurée) :
avec deux décimales, les 21 positions de la barre de vitesse de l'interface
s'effondraient en **quatre** commandes distinctes, et tout ce qui était sous
15 % de barre s'arrondissait à `0.00` --- le robot ne bougeait tout
simplement pas. Même chose sur `left_speed`/`right_speed`, où `0.00`
s'affichait pour une roue qui tournait bel et bien. **Un format doit avoir
plus de résolution que la plage qu'il transporte** ; deux décimales n'ont
jamais suffi que parce que le plafond était dix fois trop haut.
| `HEAD`      | `pitch` (deg), `yaw` (deg)       | `HEAD pitch=15 yaw=-20 *2A`               |
| `FACE`      | `emotion`                        | `FACE emotion=happy *17`                  |
| `ANIMATION` | `name`                           | `ANIMATION name=GLITCH_03 *0D`            |
| `AUDIO`     | `action`, ...                    | `AUDIO action=play id=1 *70`              |
| `LIGHT`     | `state`, ...                     | `LIGHT state=on *35`                      |
| `SYSTEM`    | `action` (`ping`, `reset`, ...)  | `SYSTEM action=ping *16`                  |

Tout champ `seq=<entier>` est optionnel et sert à corréler la commande
avec un futur `ACK` (voir §7). Les commandes qui ne le fournissent pas
ne reçoivent pas d'ACK.

### 5.1 SYSTEM --- actions réservées

| `action=`  | Effet |
|---|---|
| `ping` | l'ESP32 répond `SYSTEM action=pong` |
| `resume` | sortie de l'état `SAFE` vers `ACTIVE` (voir §9) --- refusé tant que l'E-stop physique est enfoncé, et ce refus est **rapporté** (`ERROR code=estop_held`, §7.3) au lieu d'être ignoré en silence. Sans objet (donc sans erreur) si l'ESP32 est déjà `ACTIVE`. C'est la **seule** façon de ré-armer les moteurs : un `MOVE` reçu en `SAFE` est jeté, un `HEARTBEAT` ne ré-arme rien |
| `diag` | diagnostic série : l'ESP32 répond `STATE uptime_ms=... free_heap=... state=... board=... protocol=...` |
| `set_pid`  | calibre les gains PID moteur à chaud, persistés en NVS (survit au reboot) : `SYSTEM action=set_pid kp=180 ki=300 kd=0 kff=8500` --- un champ omis garde sa valeur actuelle. `kff` est le terme de **feed-forward** (PWM par m/s) : c'est lui qui décide si une consigne produit un rapport cyclique utile tout de suite ou plusieurs secondes plus tard (voir `WheelPID::update`). Répond `STATE pid_kp=... pid_ki=... pid_kd=... pid_kff=...`, ou `ERROR code=invalid_pid_gains` si une valeur est négative/NaN/infinie |
| `get_pid`  | répond `STATE pid_kp=... pid_ki=... pid_kd=... pid_kff=...` avec les gains actuellement actifs |
| `reset_pid` | revient aux gains compilés par défaut (`motion_config.h`) et oublie la valeur sauvegardée en NVS |
| `wifi_setup` | ouvre le portail de configuration WiFi/OTA (point d'accès temporaire `Rover-Setup-XXXX`, voir `esp32/OTA.md`) --- accessible depuis un PC ou un smartphone, se ferme seul après 10 min d'inactivité |
| `wifi_status` | répond `STATE wifi_mode=...` : `setup` (portail ouvert), `wifi` avec `ip=...` (connecté au réseau, OTA pas encore configurée), `ota` avec `ip=...` (connecté, OTA active), ou `off` |
| `wifi_forget` | efface le SSID/mot de passe WiFi enregistrés en NVS (garde le mot de passe OTA) |
| `standalone` / `standalone_off` | entre/sort du pilotage autonome (point d'accès WPA2 + page joystick, §6.3 de l'architecture) |
| `motor_raw` | **bring-up uniquement** : `SYSTEM action=motor_raw left=200 right=200 ms=2000` applique un rapport cyclique fixe directement au pont en H, **sans PID ni encodeur**, et s'arrête tout seul (15 s max). Indispensable pour diagnostiquer une roue immobile : la sortie du PID sature à 255 *parce que* rien ne tourne, donc un blocage mécanique, un driver mort et un encodeur inversé y sont indiscernables. Refusé hors de l'état `ACTIVE` |
| `set_speed` / `reset_speed` | plafond de vitesse qu'un `MOVE` peut demander, en m/s, persisté en NVS : `SYSTEM action=set_speed max=0.045`. **Constante critique, pas cosmétique** : un plafond supérieur à ce que les roues savent faire rend *toute* consigne inatteignable, l'erreur ne se referme jamais, l'intégrale se bloque sur sa borne et le PWM reste collé à 255 --- la barre de vitesse n'a alors plus aucune autorité. `ERROR code=invalid_max_speed` si la valeur est nulle, négative, NaN ou infinie. Se mesure avec `reset_ticks` → `motor_raw left=255 right=255 ms=10000` → `raw_ticks`, à froid. `reset_speed` revient à la valeur compilée |
| `obstacle_reflex` | arme/désarme le réflexe d'obstacle local : `SYSTEM action=obstacle_reflex on=0`. **Ne touche pas aux capteurs** --- les distances continuent d'être mesurées et publiées, seul le blocage de la marche avant change. Un `on=` absent vaut `1` (si une trame arrive assez abîmée pour perdre le champ, la lecture sûre est « armé »). Répond `STATE obstacle_reflex=...`. **Non persisté** : un garde-fou désactivé ne doit pas survivre à une coupure de courant, chaque démarrage repart armé. ⚠ Le Pi a son **propre** clamp (§6.2 question 5) et les deux sont indépendants ; `RoverCore.set_obstacle_reflex()` les désarme ensemble, désarmer un seul des deux ne change rien |
| `raw_ticks` / `reset_ticks` | **bring-up uniquement** : compteurs d'encodeur bruts, intouchés par la boucle PID. Répond `STATE raw_ticks_left= raw_ticks_right= raw_edges_left= raw_edges_right=`. Les `raw_edges_` sont le nombre d'appels d'interruption depuis le boot, **jamais décrémentés** --- c'est leur rapport aux `raw_ticks_` qui compte : des *edges* qui grimpent pendant que les *ticks* stagnent signifie une entrée qui flotte (GPIO34-39 n'ont aucun pull-up interne) et une ISR qui affame la `loop()` chargée de piloter les moteurs. Les ticks seuls ne distinguent pas ce cas d'une roue simplement immobile |
| `pintest` | **bring-up uniquement** : `SYSTEM action=pintest pin=13 level=1` force une broche (servos ou entrées moteur seulement) à un niveau logique continu, bien plus lisible au multimètre qu'un PWM. Réarme le PWM moteur après coup, `digitalWrite` détachant la broche du LEDC |
| `head_origin` / `head_status` | `head_origin` fige les angles servo courants comme position de référence de la tête et les persiste en NVS ; tout angle logique est ensuite mesuré depuis là, ce qui rend un remontage de palonnier rattrapable sans reflasher. `head_status` renvoie `head_enabled=`, `head_a_att=`, `head_b_att=`, `head_a_deg=`, `head_b_deg=`, `head_org_a=`, `head_org_b=` |
| `servo` | **bring-up uniquement** : `which=a\|b` pilote un servo en relâchant l'autre, `which=ab a= b=` les deux indépendamment, `which=pair angle=` les deux depuis l'origine, `which=off` relâche tout (aucune impulsion, aucun couple) |
| `tof_status` / `tof_rescan` | diagnostic des deux VL53L0X : `tof_pre29=`/`tof_pre30=` (qui répondait avant la séquence), `tof_areset=` (remise à l'adresse d'usine), `tof_post29=`, `tof_lbegin=`/`tof_rbegin=` (init de chaque côté). `tof_rescan` rejoue la séquence d'abord --- utile après avoir rebranché un capteur, sans redémarrer. Les quatre causes possibles d'un `distance_left=9999` sont indiscernables autrement |
| `charger_status` | **carte PCB uniquement, bring-up** : la configuration du chargeur BQ25887 **relue dans la puce** (pas celle que le firmware croit avoir écrite) : `vreg_mv=` (tension de fin de charge par cellule), `ichg_ma=` (courant de charge), `iindpm_ma=` (limite d'entrée USB), `inhibit=` (charge bloquée après une surtension cellule, jusqu'au reboot), `fault=`, `chg_ma=` / `vbus_mv=` (mesures du chargeur), `chg_cfg=` (nombre d'applications de la config : au-delà de 1, la puce s'est réinitialisée dans le dos du firmware). Répond `chg_ok=0 chg_wrong_part=` si la puce est absente ou n'est pas un BQ25887 |
| `camera_status` | **carte PCB uniquement** : `camera_ready=` (capteur initialisé), `cam_server=` (serveur de flux démarré sur le port 81), `cam_streaming=` (un client regarde), `cam_psram=`, `cam_fails=` (captures ratées depuis le boot). Les trois choses à savoir avant d'accuser le Pi d'un panneau vidéo noir. Sur les autres cartes : `camera_ready=0 cam_fitted=0` |
| `net_status` | répond `STATE net=...` : santé du lien WiFi vue du robot --- `up` avec `ip=`, `rssi=` et `drops=` (nombre de coupures depuis le boot), `down` avec `drops=`, `suspended` (radio prêtée au portail ou au pilotage autonome) ou `unconfigured`. C'est l'instrument de mesure du lien avant le réglage des seuils de heartbeat (§6.2, étape 2) |

------------------------------------------------------------------------

## 5.2 AUTH --- authentification du lien (Pi → ESP32)

```
AUTH secret=<secret partagé> *xx
```

**Obligatoire sur un transport réseau, inutile sur le câble USB.**

Tant que le lien était un câble, l'authentification était physique :
pour envoyer un `MOVE`, il fallait être dans la pièce, une main sur le
robot. Une socket TCP supprime cette protection sans rien mettre à la
place --- n'importe qui sur le WiFi pilote alors les moteurs, sans mot
de passe et sans trace. Voir `ARCHITECTURE_AND_ROADMAP.md` §6.2,
question « 5 bis ».

Règles :

- L'ESP32 **rejette toute trame** reçue avant un `AUTH` valide, y
  compris un `HEARTBEAT` --- sans quoi un pair non authentifié pourrait
  maintenir le robot en `ACTIVE` sans jamais s'identifier.
- Réponse en cas de succès : `STATE link=authenticated`. La trame
  `AUTH` est consommée, jamais traitée comme une commande.
- Réponse en cas d'échec : `ERROR code=unauthenticated` (secret faux ou
  absent) ou `ERROR code=link_secret_not_set` (aucun secret enregistré
  côté robot). Les deux codes sont distincts parce que le premier se
  corrige côté Pi et le second côté robot.
- **L'authentification vaut pour une connexion, jamais au-delà** : le
  robot l'oublie à chaque coupure, donc le Pi la represente à chaque
  reconnexion (`pi/rover_esp32/link.py`).
- Comparaison à temps constant, longueur du secret comprise.
- Secret stocké en NVS côté robot (saisi par le portail
  `SYSTEM action=wifi_setup`), 8 à 47 caractères. Côté Pi, il vient de
  la variable d'environnement `ROVER_LINK_SECRET`, **jamais de
  `config.json`**.
- **Pas de secret enregistré = tout est refusé** (jamais l'inverse),
  comme l'OTA refuse de flasher sans mot de passe. Le robot reste
  pilotable par le mode autonome (§6.3) et par USB.

⚠ **Limite assumée** : le secret circule en clair dans la trame, protégé
seulement par le chiffrement WPA2 du réseau. Cela protège de « qui
peut joindre l'IP du robot », pas de « qui a déjà la clé WiFi et
capture les paquets » --- même niveau que le mot de passe ArduinoOTA et
que le token du serveur de contrôle. Un défi/réponse (nonce + HMAC)
serait l'incrément suivant.

------------------------------------------------------------------------

## 6. HEARTBEAT (Pi → ESP32)

```
HEARTBEAT *58\n
```

- Envoyé périodiquement par le Pi, recommandé toutes les **150 ms**
  (soit environ 3 fois par fenêtre de timeout).
- Timeout de sécurité, **révisé le 2026-09-15** pour le transport WiFi
  (Pi déporté) --- trois paliers au lieu d'un seuil unique, voir §9 de
  l'architecture pour le raisonnement complet :

  | Sans message valide depuis | État | Effet |
  |---|---|---|
  | < 500 ms | `NOMINAL` | --- |
  | 500 ms | `DEGRADED` | vitesse plafonnée (~30 %), `EVENT name=link_degraded` |
  | ~1500 ms | `TIMEOUT` | `STOP MOTORS` → état `SAFE` |

  ⚠ Ces valeurs sont un point de départ raisonné, **pas un résultat
  mesuré** : à confirmer par une mesure de gigue/perte en conditions
  réelles avant d'être considérées comme définitives.
- N'importe quel message valide (`COMMAND` ou `HEARTBEAT`) réinitialise
  le compteur de timeout ; `HEARTBEAT` n'est qu'un minimum garanti
  quand aucune commande n'est envoyée.

------------------------------------------------------------------------

## 7. STATE / EVENT / ERROR / ACK (ESP32 → Pi)

### 7.1 STATE

Émis périodiquement (fréquence à définir en Phase 2/4, un champ par
message ou groupés) :

```
STATE battery=82 *2D
STATE battery=82 battery_mv=7980 battery_ma=640 *0E
STATE charge=fast usb=1 cell_top_mv=4012 cell_bot_mv=4010 cells_ok=1 ts=normal *03
STATE left_speed=0.0240 right_speed=0.0260 left_pwm=210 right_pwm=214 *51
STATE forward_blocked=0 obstacle_seen=0 obstacle_reflex=1 *2A
STATE distance_left=420 distance_right=380 *21
STATE temperature=24.3 humidity=45.2 pressure=1013.2 gas_kohm=120.5 *3D
STATE accel_x=-0.12 accel_y=0.03 accel_z=9.81 gyro_x=0.01 gyro_y=-0.02 gyro_z=0.00 *3F
STATE state=SAFE estop=0 max_speed=0.030 *00
```

`state=` / `estop=` : l'état de la machine à états de l'ESP32 (§9) et
l'état du bouton d'arrêt d'urgence. Émis **au changement uniquement**
(plus une fois au boot), donc coût nul en régime établi --- le Pi
fusionne les champs `STATE` et les rejoue aux clients qui se connectent
plus tard, une trame par transition suffit. À ne pas confondre avec
l'état comportemental du Pi (`ROVER_STATE`, §20 de l'architecture) : ce
sont deux machines distinctes.

Pourquoi c'est diffusé et pas seulement disponible sur demande
(`action=diag`) : un robot en `SAFE` ignore tous les `MOVE` par
conception. Sans ce champ, un timeout heartbeat après une micro-coupure
WiFi est indiscernable d'un moteur mort --- exactement la confusion qui
a coûté plusieurs sessions de diagnostic moteur (`PROGRESS.md`).

Les drapeaux d'obstacle voyagent dans **leur propre trame**, au
changement seulement, séparés des vitesses : ensemble ils dépassaient
`ROVER_MAX_FRAME_LEN` une fois les vitesses passées à quatre décimales
(129 octets, atteints par une simple marche arrière à plein régime), et
ils n'ont de toute façon pas le même rythme --- les vitesses changent en
permanence, ceux-là sur événement. Contrairement aux vitesses, ils ne
sont **pas** conditionnés à l'état `ACTIVE` : savoir *pourquoi* le robot
refuse d'avancer compte surtout quand il n'avance pas.

`state` / `estop` / `max_speed` sont publiés ensemble au changement
seulement (plus une fois au boot). `max_speed` accompagne l'état parce
qu'une page de pilotage ne peut pas dimensionner sa barre de vitesse
sans lui : le plafond est calibré par robot (`action=set_speed`), donc
une constante codée en dur dans l'UI périme dès la première nouvelle
mesure.

`forward_blocked` / `obstacle_seen` / `obstacle_reflex` répondent à
trois questions distinctes, autrefois confondues en un seul champ :
ce que les capteurs voient, si le réflexe est armé, et si la marche
avant est **effectivement** bridée en conséquence. Depuis que le réflexe
est débrayable à chaud (`action=obstacle_reflex`), un drapeau unique ne
pouvait plus distinguer « pas d'obstacle » de « obstacle, mais on nous a
dit de l'ignorer ».

`distance_left`/`distance_right` sont en millimètres ; `9999` signifie
"capteur indisponible" (échec `begin()` ou perte depuis), `8190`
signifie "rien détecté dans la portée" (le capteur répond mais ne voit
pas d'obstacle) -- voir `esp32/lib/sensors/DistanceSensor.cpp`.

`battery_mv` / `battery_ma` (carte PCB, mesurés par l'INA219) : tension
du pack et courant, **positif en décharge, négatif en charge**. Absents
sur le WROOM, qui n'a qu'un pont diviseur (désactivé à ce jour).

`charge` / `usb` / `cell_*` / `cells_ok` / `ts` (carte PCB, chargeur
BQ25887, toutes les 2 s) : état de charge (`none`, `trickle`,
`precharge`, `fast`, `taper`, `topoff`, `done`, ou `unavailable` si la
puce ne répond pas), présence d'une alimentation USB valide, tension de
chaque cellule en mV, et thermistance (`normal`, `warm`, `cool`, `cold`,
`hot`). **`cells_ok=0` veut dire « ne pas croire les `cell_*_mv` »** :
les deux cellules n'additionnent pas la tension du pack mesurée par
l'INA219 (fil de point milieu cassé, ou échelle ADC du chargeur
différente de celle supposée --- non vérifiée sur datasheet, voir
`esp32/lib/power_math/PowerMath.h`). Les protections par cellule du
firmware sont alors suspendues ; la puce de protection matérielle, elle,
reste active dans tous les cas.

### 7.2 EVENT

Émis ponctuellement lors d'un changement d'état matériel :

```
EVENT name=obstacle_detected *0E
EVENT name=robot_lifted *7B
EVENT name=head_limit *74
EVENT name=low_battery *10
EVENT name=estop_pressed *12
```

Événements propres à la carte PCB (alimentation et santé matérielle) :

```
EVENT name=cell_low *7B
EVENT name=cell_critical *04
EVENT name=cell_overvoltage charging=inhibited *19
EVENT name=cells_implausible *01
EVENT name=charger_fault fault=0x40 ts=hot *59
EVENT name=motor_driver_fault *49
```

- `cell_low` : une cellule sous 3,30 V (hystérésis, repassage au-dessus
  de 3,45 V pour réarmer).
- `cell_critical` : une cellule sous 3,10 V **hors charge** --- le robot
  passe en `SAFE` et coupe les moteurs **avant** que la protection
  matérielle (~2,8 V) ne coupe tout d'un coup (écran, WiFi compris).
  Comme pour un timeout heartbeat, seul un `resume` explicite réarme.
- `cell_overvoltage` : une cellule au-dessus de 4,25 V --- le firmware
  **bloque la charge jusqu'au prochain redémarrage** (couche logicielle
  sous la protection matérielle à ~4,28 V).
- `cells_implausible` : les mesures de cellules ont cessé d'être
  cohérentes (voir `cells_ok` ci-dessus).
- `charger_fault` : nouvel octet de défaut du chargeur non nul
  (`fault=`, bits : surtension VBUS 0x80, arrêt thermique 0x40, minuterie
  de charge 0x10) ou thermistance hors plage (`ts=`).
- `motor_driver_fault` : la ligne nFAULT du DRV8833 est passée active
  (surintensité, surchauffe ou sous-tension). Le driver se protège et
  repart seul ; l'événement sert à ne pas confondre ce « hoquet » avec
  un problème de PID ou d'encodeur.

`estop_pressed` : bouton d'arrêt d'urgence physique enfoncé (voir
`esp32/lib/safety/EStop.h`) -- force l'état `SAFE` indépendamment du
heartbeat, et bloque `SYSTEM action=resume` tant que le bouton reste
enfoncé (relâcher le bouton ne suffit pas à lui seul, un `resume`
explicite reste nécessaire ensuite, comme pour un timeout heartbeat).

### 7.3 ERROR

| Code | Origine |
|---|---|
| `motor_overcurrent` | protection moteur |
| `sensor_timeout` | capteur I2C ne répond plus |
| `display_failure` | écran ST7789 en erreur |
| `checksum_invalid` | trame reçue corrompue |
| `frame_too_long` | trame reçue > 128 octets |
| `unknown_command` | `TYPE` non reconnu |
| `invalid_pid_gains` | `SYSTEM action=set_pid` avec une valeur négative, NaN ou infinie |
| `unauthenticated` | trame reçue avant un `AUTH` valide sur un lien réseau, ou secret faux (§5.2) |
| `link_secret_not_set`  | `AUTH` reçue mais aucun secret enregistré côté robot (§5.2) |
| `tx_truncated` | trame sortante trop longue, abandonnée plutôt qu'émise tronquée |
| `estop_held` | `SYSTEM action=resume` reçue alors que l'E-stop physique est enfoncé (§5.1) |
| `invalid_max_speed` | `SYSTEM action=set_speed` avec une valeur nulle, négative, NaN ou infinie |
| `encoder_storm` | un encodeur émettait des fronts à un rythme physiquement impossible (entrée qui flotte) et a **désarmé sa propre interruption** pour ne plus affamer la `loop()` qui pilote les moteurs. Champ `wheel=left\|right`. Ne se réarme qu'avec `SYSTEM action=reset_ticks`, une fois le câblage repris |

```
ERROR code=motor_overcurrent *1B
ERROR code=sensor_timeout sensor=tof_left *48
```

`sensor=` est un champ optionnel supplémentaire sur `sensor_timeout`
(même esprit que `reason=` sur un `ACK` d'échec, §7.4) pour indiquer
lequel des capteurs Phase 4 est en cause : `tof_left`, `tof_right`,
`imu` ou `bme688` --- et, sur la carte PCB, `io_expander` (TCA9554 :
XSHUT, reset écran, LED...), `battery` (INA219), `charger` (BQ25887,
absent ou pas la bonne puce) ou `camera`. Émis une seule fois par transition OK→échec (y
compris un échec dès le boot, pas seulement une perte en cours de
route), jamais en boucle à chaque nouvelle tentative de reconnexion.

### 7.4 ACK

Réponse à une commande porteuse d'un `seq` :

```
ACK seq=42 status=ok *38
ACK seq=42 status=error reason=head_limit *7F
```

------------------------------------------------------------------------

## 8. Séquence de démarrage

```
ESP32 boot
  ↓
SYSTEM protocol=ROVER_PROTOCOL_V1 board=<WROOM|S3> state=BOOT *xx
  ↓
état interne : BOOT → READY
  ↓
en attente du premier HEARTBEAT du Pi
  ↓
(lien réseau uniquement : AUTH secret=... → STATE link=authenticated)
  ↓
READY → ACTIVE (dès réception d'un HEARTBEAT ou d'une COMMAND valide)
```

Sur un transport réseau, l'étape `AUTH` est un préalable strict : aucune
trame reçue avant elle ne fait quoi que ce soit, et le passage
`READY → ACTIVE` ne peut donc pas avoir lieu (§5.2).

Le Pi doit vérifier le champ `protocol=` avant d'envoyer des commandes
et refuser de continuer si la version ne correspond pas à celle qu'il
attend.

------------------------------------------------------------------------

## 9. Machine d'état ESP32 (rappel §11 de l'architecture)

```
BOOT → READY → ACTIVE → SAFE → ERROR
```

- `SAFE` est atteint automatiquement en cas de timeout heartbeat, et
  **jamais** contourné par une commande logicielle du Pi.
- Le retour de `SAFE` vers `ACTIVE` nécessite la reprise d'un
  heartbeat valide **et** une commande explicite (`SYSTEM
  action=resume`), pour éviter un redémarrage moteur inattendu.

------------------------------------------------------------------------

## 10. Compatibilité matérielle

Le protocole est indépendant du **transport** (UART sur câble USB ou
socket TCP WiFi, voir §2) et du modèle exact de la carte (WROOM ou S3,
voir `CLAUDE.md`). Le champ `board=` du message `SYSTEM` de boot permet
au Pi de savoir sur quelle variante il communique, sans que cela change
le format des messages.

Carte de référence actuelle : **WROOM**, confirmée le 2026-09-15 (un S3
est disponible mais gardé pour une évolution ultérieure).

Carte PCB sur mesure (`pcb/PCB_CONNEXIONS.md`) : se présente avec
`board=PCB_V1`. Mêmes trames, plus les champs, événements et actions
marqués « carte PCB » ci-dessus. Sur cette carte, le flux caméra est
servi par le robot lui-même : `http://rover-esp32.local:81/stream` (au
lieu de l'ancien `http://rovercam.local:81/stream` de l'ESP32-CAM).

------------------------------------------------------------------------

## Statut du document

**Protocole cible : V1 --- en cours d'implémentation (Phase 0/1).**
