RaphaelGrj/Rover-Project/PROGRESS_ARCHIVE.md

# ROVER --- Archive détaillée du journal d'avancement

> **Ce fichier est volumineux et n'est pas destiné à être relu
> intégralement en début de session.** Il contient l'historique complet,
> session par session, avec tout le détail de diagnostic/investigation
> (mesures, hypothèses écartées, méthode). Consultez-le seulement pour
> retrouver le contexte fin d'une décision ou d'un test passé précis.
>
> Pour une reprise normale de session : voir `PROGRESS.md` (résumé court,
> état actuel + prochaines étapes). Référence architecturale : voir
> `ARCHITECTURE_AND_ROADMAP.md`. Spec du protocole : voir
> `ROVER_PROTOCOL.md`.

------------------------------------------------------------------------

## Session du 2026-08-23

### Contexte matériel confirmé

- Carte actuelle : **ESP32 WROOM** (pas de S3 pour l'instant).
- Le firmware doit rester **portable WROOM ↔ S3** (build PlatformIO à
  double environnement), car une évolution vers un S3 est prévue plus
  tard. Le Pi fait le gros du travail, donc l'ESP32 reste peu chargé
  sur WROOM.
- Aucun câblage réel (pins moteurs/servos/capteurs) n'est encore
  connu : rien n'a été codé en dur à ce sujet.

### Ce qui a été fait

1. **`ROVER_PROTOCOL.md`** créé : spec V1 complète du Rover Protocol
   (format de trame ASCII `TYPE clé=valeur *CS\n`, checksum XOR,
   catalogue COMMAND/STATE/EVENT/ERROR/ACK/HEARTBEAT, séquence de
   boot, machine d'état ESP32, actions `SYSTEM` réservées :
   `ping`/`resume`/`diag`).

2. **Scaffold firmware `esp32/`** (PlatformIO) :
   - `platformio.ini` : deux environnements `esp32_wroom` et
     `esp32_s3`.
   - `include/board_config.h` : macros de board, `RoverState`
     (BOOT/READY/ACTIVE/SAFE/ERROR), constantes protocole.
   - `lib/communication/RoverProtocol.{h,cpp}` : parseur/émetteur de
     trames, générique sur un `Stream` Arduino (pas lié à un port UART
     précis, puisque le câblage final n'est pas connu).
   - `lib/safety/HeartbeatMonitor.h` : suivi du heartbeat Pi → ESP32,
     timeout 500 ms.
   - `lib/safety/Watchdog.h` : watchdog matériel `esp_task_wdt`
     (timeout 3 s), couche de sécurité **indépendante** du heartbeat
     (détecte un firmware qui plante, pas seulement une perte de
     liaison avec le Pi).
   - `lib/system/Diagnostics.h` : construit les champs de diagnostic
     (`uptime_ms`, `free_heap`, `state`, `board`, `protocol`).
   - `src/main.cpp` : boot (`SYSTEM protocol=... board=... state=BOOT`),
     dispatch `HEARTBEAT`/`SYSTEM`, transition automatique vers `SAFE`
     sur timeout heartbeat, réponse à `SYSTEM action=diag`.

3. **Roadmap mise à jour** (`ARCHITECTURE_AND_ROADMAP.md`) :
   - Phase 1 (ESP32 minimum viable) : toutes les cases cochées.
   - Phase 6 : ajout du support manette/gamepad, de l'accès distant
     VPN, et du cas d'usage prioritaire "surveillance de la maison à
     distance".

4. **`.gitignore`** ajouté (`.pio/`, `.vscode/`, objets de build).

5. **`CLAUDE.md`** mis à jour : ESP32 WROOM (au lieu de S3/CAM), et
   consigne explicite de portabilité WROOM/S3 pour tout code ESP32
   généré.

### Problèmes rencontrés et résolutions

- **Erreur de compilation `board_config.h: No such file or directory`**
  lors du build des libs (`lib/communication`, `lib/safety`) alors que
  `src/main.cpp` le trouvait sans problème.
  → Cause : le dossier `include/` du projet n'est pas automatiquement
  ajouté au chemin d'inclusion des libs par le LDF de PlatformIO dans
  cette configuration.
  → Résolution : ajout explicite de `-I include` dans les
  `build_flags` globaux de `platformio.ini` (section `[env]`,
  héritée par les deux environnements).

### État actuel

- **Phase 0** (Architecture) : règles figées, protocole et
  arborescence logicielle définis.
- **Phase 1** (ESP32 minimum viable) : **complète** au niveau code.
  Compilation réelle vérifiée avec succès sur `esp32_wroom` **et**
  `esp32_s3` (`pio run -e esp32_wroom -e esp32_s3`).
  RAM ~6%, Flash ~8-20% selon la cible.
- **Aucun test sur matériel réel** : pas d'ESP32 branché pendant cette
  session (`/dev/ttyUSB*` / `/dev/ttyACM*` absents). Le firmware n'a
  donc été validé qu'à la compilation, pas au flash/à l'exécution.
- Rien côté Raspberry Pi (Phase 5) n'a encore été commencé.

### Prochaines étapes (Phase 2 --- Motorisation)

Bloqué en attente d'informations matérielles à fournir par
l'utilisateur avant de pouvoir coder concrètement :

- Câblage du TB6612FNG (pins STBY, AIN1/AIN2/PWMA, BIN1/BIN2/PWMB).
- GPIO utilisées pour les moteurs gauche/droite.
- GPIO utilisées pour les encodeurs (gauche/droite).

En parallèle, si du matériel est disponible, un premier flash réel du
firmware Phase 1 sur l'ESP32 WROOM permettrait de valider le
heartbeat/watchdog/diagnostic en conditions réelles (actuellement testé
à la compilation seulement).

### Décisions/contraintes à ne pas oublier

- Toute logique de contrôle distant (VPN, auth, streaming vidéo,
  smartphone, manette) reste **100% côté Raspberry Pi** ; l'ESP32 ne
  doit recevoir que des commandes abstraites (`MOVE`, `HEAD`, ...) via
  le Rover Protocol, quelle que soit la source de la commande.
- Ne jamais coder en dur des numéros de pins tant que le câblage réel
  n'est pas communiqué (un pinout *provisoire* pour Wokwi existe,
  voir plus bas --- ce n'est pas une exception, il reste en
  documentation, hors firmware).
- Le code ESP32 doit rester compilable sur les deux environnements
  PlatformIO (`esp32_wroom` et `esp32_s3`) --- à vérifier après chaque
  changement significatif.
- Tout code du projet doit être commenté (pas ligne par ligne, mais
  assez pour s'y retrouver sans relire tout l'historique) --- consigne
  ajoutée dans `CLAUDE.md` le 2026-08-25.

------------------------------------------------------------------------

## Session du 2026-08-25

### Contexte

L'utilisateur a installé l'extension VSCode **Wokwi** pour pouvoir
tester le firmware en simulation. Objectif de la session : préparer ce
qu'il faut pour simuler ce qui existe déjà (Phase 1), sans attendre le
câblage réel.

### Ce qui a été fait

1. **Environnement Wokwi** (`esp32/wokwi.toml` + `esp32/diagram.json`) :
   - Le firmware actuel (Phase 1) ne parle qu'en Serial/USB (Rover
     Protocol), aucun GPIO n'est encore utilisé : le diagramme Wokwi
     est donc volontairement minimal, une carte `wokwi-esp32-devkit-v1`
     seule, sans câblage.
   - `wokwi.toml` pointe par défaut sur le build `esp32_wroom` (carte
     physique actuelle) ; instructions dans le fichier pour basculer
     sur `esp32_s3` si besoin.
   - Prérequis avant de lancer la simulation : `pio run -e esp32_wroom`
     (déjà vérifié --- build OK, `.pio/build/esp32_wroom/firmware.bin`
     et `.elf` présents).

2. **`esp32/tools/rover_frame.py`** : petit script qui calcule le
   checksum XOR d'une trame Rover Protocol et affiche la trame complète
   prête à coller dans le moniteur série Wokwi (le calculer à la main
   est trop pénible/source d'erreur pour tester manuellement).
   Vérifié contre l'implémentation C++ (`RoverProtocol::checksum`).

   Au passage : l'exemple de checksum dans `ROVER_PROTOCOL.md` §3.1
   (`MOVE velocity=0.25 rotation=-0.10 *4B`) était **faux** --- corrigé
   en `*39` (valeur réellement produite par l'algorithme XOR décrit
   juste au-dessus, vérifiée avec le script et avec le code C++).

3. **`esp32/WIRING.md`** : pinout de base **provisoire** pour la carte
   WROOM (UART2 vers le Pi, TB6612FNG, encodeurs, servos tête,
   ST7789, bus I2C partagé MPU6050/BME688/VL53L0X×2 avec XSHUT dédiés).
   Explicitement marqué comme proposition, pas codé en dur nulle part
   dans le firmware --- sert de base pour construire les prochains
   `diagram.json` Wokwi une fois le code des phases 2--4 écrit, et
   pourra évoluer dès que le câblage réel sera connu.

4. **Consigne de commentaires** ajoutée dans `CLAUDE.md`
   ("Instructions strictes pour la génération de code") : tout code du
   projet doit être commenté (pas 100% des lignes, mais assez pour s'y
   retrouver). Les fichiers Phase 1 existants ont été relus et
   complétés en conséquence (`RoverProtocol.cpp` --- checksum, parsing
   de trame, gestion d'overflow ; `Diagnostics.h` ; `main.cpp` ---
   logique de transition d'état). Recompilé avec succès sur les deux
   cibles après ces changements.

5. **Bug Wokwi corrigé** : la première version de `esp32/diagram.json`
   ne déclarait aucune connexion (`"connections": []`), donc l'UART0
   de la carte n'était routé nulle part --- la carte bootait mais le
   moniteur série restait totalement vide (observé à la fois dans
   VSCode et en reproduisant en headless avec `wokwi-cli`). Corrigé en
   ajoutant les connexions `esp32:TX0 → $serialMonitor:RX` et
   `esp32:RX0 → $serialMonitor:TX`. Revalidé en headless : le message
   de boot `SYSTEM protocol=ROVER_PROTOCOL_V1 board=WROOM state=BOOT`
   apparaît bien.
   `wokwi-cli` installé localement (`~/bin/wokwi-cli`, script officiel
   `https://wokwi.com/ci/install.sh`) pour ce diagnostic ; nécessite un
   `WOKWI_CLI_TOKEN` (compte Wokwi, https://wokwi.com/dashboard/ci).

6. **Moniteur série VSCode en lecture seule chez l'utilisateur** :
   le terminal intégré affichant la sortie série ne permettait pas d'y
   taper/coller (voir extension changelog v2.1.0 --- sortie série via
   le terminal VSCode intégré, entrée non confirmée fonctionnelle dans
   ce contexte). Contournement : activation de `rfc2217ServerPort =
   4000` dans `esp32/wokwi.toml` --- ça expose le port série virtuel
   en TCP (RFC2217), ce qui a permis de piloter la simulation
   directement depuis un script Python (`pyserial`,
   `serial.serial_for_url("rfc2217://localhost:4000")`) sans dépendre
   de l'UI VSCode.

7. **Phase 1 validée en simulation** via ce canal RFC2217 :
   - `SYSTEM action=ping` → `SYSTEM action=pong` : OK.
   - `SYSTEM action=diag` → `STATE ...` : OK.
   - Un seul `HEARTBEAT` envoyé puis silence : `state` passe bien de
     `ACTIVE` à `SAFE` après ~500 ms (confirmé par deux `diag`
     successifs, `uptime_ms` progressant normalement --- pas de reset
     watchdog intempestif). Note : la frame `EVENT
     name=heartbeat_timeout` elle-même (poussée spontanément par le
     firmware, hors réponse à une commande) n'est pas remontée de
     façon fiable via RFC2217 dans ce test --- probablement un détail
     de bufferisation côté extension, pas un bug firmware (l'état
     interne change correctement, vérifié indépendamment).
   - Checksum invalide sur une trame → `ERROR code=checksum_invalid`
     (découvert accidentellement en copiant un mauvais checksum) : OK.
   - `SYSTEM action=resume` en état `SAFE` → retour à `ACTIVE` : OK.

### État actuel (fin de session)

- **Phase 0** : inchangé, règles figées.
- **Phase 1** : **entièrement validée en simulation Wokwi** (boot,
  ping, diag, timeout heartbeat → SAFE, erreur de checksum, resume
  SAFE → ACTIVE). Reste non testée sur matériel physique réel.
- **Phase 2** : voir session suivante --- passée de "bloquée" à "code
  complet, validée en simulation" dans la même journée, décision
  explicite de l'utilisateur de continuer à avancer via Wokwi plutôt
  que d'attendre le câblage réel définitif.

------------------------------------------------------------------------

## Session du 2026-08-25 (suite) --- Phase 2 : Motorisation

### Contexte

Décision de l'utilisateur : ne plus bloquer sur l'absence de câblage
réel confirmé --- avancer avec le pinout provisoire de `WIRING.md` et
laisser Wokwi valider le travail au fur et à mesure. Pendant
l'implémentation, correction matérielle reçue : le driver moteur n'est
**pas** un TB6612FNG comme initialement esquissé, mais un **DRV8833**,
avec des moteurs **N20 6V à encodeur intégré**.

Différence importante DRV8833 vs TB6612FNG : pas de pin PWM séparée
--- chaque moteur utilise directement 2 pins PWM (IN1 = avant, IN2 =
arrière, les deux à 0 = roue libre). 4 GPIO pour les deux moteurs au
lieu de 6. `esp32/WIRING.md` et `esp32/include/motion_config.h` mis à
jour en conséquence (GPIO14/25, anciennement PWMA/PWMB, sont
maintenant libres).

### Ce qui a été fait

1. **`esp32/include/motion_config.h`** (nouveau) : centralise tout le
   pinout Phase 2 + les constantes de mouvement (gains PID, géométrie
   roue, ticks encodeur/tour). Explicitement commenté comme
   provisoire/non calibré --- seul ce fichier devra changer si le
   câblage ou le matériel réel diverge.

2. **`esp32/lib/motors/`** (nouveau module) :
   - `MotorDriver` : pilotage bas niveau d'un canal DRV8833 (2 canaux
     LEDC par moteur, un par sens).
   - `Encoder` : comptage de ticks par interruption GPIO (x1 decode),
     sur les pins input-only (GPIO34/35/36/39) choisies justement pour
     ça dans `WIRING.md`.
   - `WheelPID` : PID complet (P/I/D, anti-windup sur l'intégrale) par
     roue, gains placeholders.
   - `DriveController` : modèle unicycle (vitesse + rotation → vitesse
     gauche/droite), boucle PID par roue à période fixe, `stop()`
     immédiat (bypass PID), télémétrie `STATE left_speed=...
     right_speed=...`.

3. **`main.cpp`** : dispatch `MOVE velocity=... rotation=...` vers
   `DriveController::setTarget()`, mais **seulement en état `ACTIVE`**
   --- une trame `MOVE` reçue en `SAFE` est ignorée, jamais de
   réarmement moteur hors `SYSTEM action=resume` explicite (règle
   architecture §27.6). `drive.stop()` appelé au boot (avant toute
   commande) et sur timeout heartbeat (`SAFE`), en plus de l'`EVENT`
   déjà existant. Télémétrie `STATE` périodique (200 ms) tant
   qu'`ACTIVE`.

4. **`esp32/diagram.json`** étendu : 4 LEDs + résistances 220 Ω sur
   les pins IN1/IN2 gauche/droite, pour visualiser direction/PWM sans
   moteur réel. Validé avec `wokwi-cli lint` (pins de
   `wokwi-esp32-devkit-v1` nécessitent le préfixe `D`, ex. `D27`, pas
   juste `27` --- erreur détectée et corrigée via le lint).

5. **Compilation** vérifiée sur `esp32_wroom` et `esp32_s3` après
   chaque étape.

6. **Validé en simulation** (headless `wokwi-cli` + RFC2217, même
   méthode que pour la Phase 1) :
   - Boot avec le nouveau code (init moteurs/encodeurs/PID) : pas de
     crash, pas de watchdog intempestif.
   - `MOVE velocity=0.20 rotation=0.0` : accepté, aucun crash.
   - `SYSTEM action=diag` après `MOVE` : `state=ACTIVE`, uptime/heap
     stables.
   - Télémétrie `STATE left_speed=0.00 right_speed=0.00` reçue
     périodiquement --- valeurs à 0 normales, **aucun encodeur n'est
     simulé** dans `diagram.json` (pas de chip DC-motor+encodeur
     câblé), donc la boucle PID tourne en boucle ouverte en
     simulation. Ce n'est pas un bug, juste une limite de la
     simulation actuelle.

### Ce qui n'est PAS validé

- Le retour d'encodeur réel et donc l'asservissement PID en boucle
  fermée (aucun encodeur simulé pour l'instant --- possible plus tard
  avec un chip Wokwi tiers de type "DC motor + encoder", pas
  investigué en détail cette session).
- Toute valeur physique (`ROVER_ENCODER_TICKS_PER_REV`,
  `ROVER_WHEEL_DIAMETER_M`, gains PID) --- ce sont des placeholders
  explicitement marqués comme tels dans `motion_config.h`.
- Le câblage réel sur le robot physique (toujours aucun matériel
  branché à ce stade).

### État actuel

- **Phase 2** : **code complet, compile sur les deux cibles, validée
  en simulation Wokwi** (sans boucle fermée encodeur). Non testée sur
  matériel physique.

------------------------------------------------------------------------

## Session du 2026-08-25 (suite 2) --- Durcissement Phase 2

### Contexte

Demande explicite de l'utilisateur : avant d'enchaîner sur la suite,
revue critique du code Phase 2 pour éliminer les bugs latents ---
objectif "aucune erreur de code une fois au câblage", code évolutif.
Revue faite fichier par fichier (`MotorDriver`, `Encoder`, `WheelPID`,
`DriveController`), 3 corrections retenues (pas de simple nettoyage
cosmétique, des bugs réels ou des risques concrets identifiés) :

1. **`Encoder` : `noInterrupts()`/`interrupts()` → `portMUX_TYPE`
   (spinlock ESP32)**. `noInterrupts()`/`interrupts()` ne suspendent
   que le cœur courant ; sur un ESP32 (dual-core), si l'ISR de
   l'encodeur finissait un jour planifiée sur l'autre cœur que celui
   qui appelle `readAndResetTicks()`, la section critique ne protégeait
   plus rien (race condition silencieuse sur `_ticks`). `portMUX_TYPE`
   + `portENTER/EXIT_CRITICAL(_ISR)` est le mécanisme correct pour du
   partagé ISR/tâche sur ESP32, quel que soit le cœur.

2. **`WheelPID` : dérivée calculée sur l'erreur → sur la mesure**. Avec
   Kd calculée sur l'erreur, chaque nouvelle commande `MOVE` change la
   consigne instantanément, ce qui provoque un pic de dérivée
   ("derivative kick") même si la roue n'a pas encore bougé. Invisible
   aujourd'hui (`ROVER_PID_KD = 0`), mais serait redécouvert --- et
   probablement mal diagnostiqué --- au moment de calibrer Kd sur le
   vrai moteur. Corrigé maintenant pendant que c'est simple, plutôt que
   plus tard en pleine calibration matérielle.

3. **`DriveController::setTarget` : garde NaN/Inf + clamp rotation**.
   Un champ `velocity=nan` dans une trame `MOVE` passe la validation
   checksum sans problème (le checksum ne valide que les octets, pas la
   sémantique) ; `strtof` renvoie alors `NaN`, que `constrain()` ne
   filtre pas (toute comparaison avec `NaN` est fausse), et caster un
   `NaN`/`Inf` en `int16_t` ensuite est un comportement indéfini en
   C++. Corrigé en filtrant `isnan()`/`isinf()` avant tout calcul en
   aval. Au passage, la `rotation` n'était pas bornée du tout (seule la
   `velocity` l'était) --- ajout de `ROVER_MAX_ROTATION_RAD_S` dans
   `motion_config.h`.

4. **`motion_config.h`** : commentaire ajouté réservant les canaux LEDC
   0--3 aux moteurs, pour que la Phase 3 (servos tête) ne vienne pas
   les réutiliser par erreur --- pensé pour rester évolutif.

### Validation

- Recompilé avec succès sur `esp32_wroom` et `esp32_s3` après chaque
  correction.
- Testé en simulation Wokwi (RFC2217, instance VSCode de
  l'utilisateur, redémarrée pour charger le nouveau binaire) :
  - `MOVE velocity=0.20 rotation=0.0` en état `ACTIVE` → accepté,
    télémétrie `STATE left_speed=0.00 right_speed=0.00` reçue (0.00
    normal, toujours pas d'encodeur simulé).
  - `MOVE` reçu en état `SAFE` (heartbeat expiré entre deux commandes
    manuelles, comportement attendu en l'absence de flux `HEARTBEAT`
    continu) → correctement ignoré, confirmé par un `diag` de suivi.
  - `MOVE velocity=nan rotation=0` → aucun crash, `uptime_ms` et
    `free_heap` restent stables/cohérents sur les diag suivants (pas de
    reboot, pas de fuite mémoire).

### État actuel

- **Phase 2** : code complet, durci contre les entrées malformées et
  les risques multi-cœur, validée en simulation Wokwi. Toujours non
  testée sur matériel physique ; gains PID et géométrie roue toujours
  des placeholders.

### Prochaines étapes

- Continuer la Phase 3 (Tête et écran) ou affiner encore la Phase 2
  selon la priorité de l'utilisateur.
- Dès que le matériel physique (ESP32 + DRV8833 + moteurs N20) est
  disponible : flasher, mesurer les vraies specs encodeur (ticks/tour
  réels selon le ratio de réduction), calibrer les gains PID, confirmer
  ou ajuster le pinout de `WIRING.md`/`motion_config.h`.

------------------------------------------------------------------------

## Session du 2026-08-25 (suite 3) --- Rover pilotable (Phase 5 + 6 minimales)

### Contexte

Question de l'utilisateur : à partir de quelle phase du roadmap
Rover devient-il pilotable (manette + interface smartphone) ? Réponse :
Phase 6, mais elle n'a rien à quoi se connecter tant que la Phase 5
(rien côté Pi jusqu'ici) n'existe pas au moins a minima. Décision :
implémenter une tranche minimale des deux --- juste de quoi piloter
`MOVE` en local, pas encore caméra/VPN/authentification.

Choix technique validé par l'utilisateur : **Python** côté Pi (cohérent
avec les scripts de test déjà utilisés cette session, `pyserial` pour
l'UART).

### Ce qui a été fait

Nouveau répertoire `pi/` (nouveau langage dans le dépôt --- premier
code Python du projet) :

1. **`pi/rover_esp32/`** --- couche protocole :
   - `protocol.py` : encode/decode de trames Rover Protocol, pur (pas
     d'I/O), recopie fidèle de l'algorithme de `RoverProtocol.cpp`
     (checksum XOR, découpage `*CS`). Vérifié par comparaison directe
     avec `esp32/tools/rover_frame.py` et l'exemple corrigé de
     `ROVER_PROTOCOL.md` --- valeurs identiques.
   - `link.py` : `RoverLink`, connexion série via
     `serial.serial_for_url()` --- accepte aussi bien un port réel
     (`/dev/ttyUSB0`) qu'une URL `rfc2217://...`, donc le **même code**
     pilote le robot physique ou la simulation Wokwi. Thread de lecture
     dédié (`serial.threaded.ReaderThread`, pyserial n'a pas de support
     asyncio natif).

2. **`pi/rover_core/`** :
   - `core.py` (`RoverCore`) : ne duplique pas la sécurité de l'ESP32
     --- quand aucun client de contrôle n'est connecté, arrête
     simplement d'envoyer `HEARTBEAT` et laisse l'ESP32 passer en
     `SAFE` tout seul (`ARCHITECTURE_AND_ROADMAP.md` §9). Envoie
     `SYSTEM action=resume` à la connexion d'un client (nécessaire :
     `HEARTBEAT` seul ne sort pas de `SAFE`). Gère plusieurs clients de
     contrôle simultanés sans qu'une déconnexion prématurée coupe tout
     pour les autres.
   - `main.py` : point d'entrée (`python -m rover_core.main --port
     ...`), construit `RoverCore` **à l'intérieur** de la boucle
     asyncio effectivement utilisée par `aiohttp` (`asyncio.run` +
     `AppRunner`/`TCPSite`, pas `web.run_app`) --- pour éviter un bug
     classique de boucle asyncio incohérente entre le thread lecteur
     série et le serveur web.

3. **`pi/rover_control/`** : serveur `aiohttp` (page `/` + WebSocket
   `/ws`) + `static/index.html` --- page de contrôle autonome, sans
   framework JS ni étape de build (une seule dépendance ajoutée :
   `aiohttp`, cf. règle §27.10 "pas de dépendance lourde si une
   solution simple suffit) :
   - Joystick tactile (Pointer Events, un seul modèle pour souris et
     tactile).
   - Manette physique (Gamepad API), prioritaire sur le joystick
     tactile si détectée.
   - Envoi `{velocity, rotation}` en JSON à 10 Hz, indépendant de la
     fréquence `HEARTBEAT` du pont Pi↔ESP32.

4. **`.gitignore`** : ajout de `pi/.venv/`, `__pycache__/`, `*.pyc`.

### Validation

Test de bout en bout, en conditions réelles (pas de mock) contre la
simulation Wokwi déjà en cours (`rfc2217://localhost:4000`) :

- `python -m rover_core.main --port rfc2217://localhost:4000` : connexion
  OK, `serial.serial_for_url()` fonctionne identiquement pour un port
  réel et une URL RFC2217.
- Page `/` servie correctement (bug initial trouvé et corrigé :
  `add_static(show_index=True)` servait un listing de dossier au lieu
  de `index.html` --- remplacé par une route explicite).
- Client WebSocket simulé (script Python, `aiohttp.ClientSession`) :
  - Connexion → `SYSTEM action=resume` puis boucle `HEARTBEAT` (~150 ms)
    envoyés automatiquement.
  - `MOVE velocity=0.20 rotation=0.00` envoyé en boucle → reçu et traité
    par le firmware (mêmes trames que les tests manuels précédents).
  - `STATE left_speed=... right_speed=...` reçu en retour et journalisé
    côté Pi.
  - Déconnexion → `MOVE velocity=0.00 rotation=0.00` immédiat +
    arrêt de la boucle `HEARTBEAT` (l'ESP32 repasse en `SAFE` de
    lui-même ensuite, pas besoin que le Pi le lui dise).
- `protocol.py` revérifié isolément : `encode_frame`/`decode_frame`
  produisent des valeurs identiques à `esp32/tools/rover_frame.py` et
  rejettent bien un checksum invalide.

### Ce qui n'est PAS validé

- Le joystick tactile et la manette (Gamepad API) n'ont pas été
  testés avec un vrai doigt/une vraie manette --- seul le backend
  (WebSocket → `RoverCore.move()`) a été validé par un client simulé.
  Le code utilise des API web standard (Pointer Events, Gamepad API)
  mais reste à confirmer en conditions réelles sur téléphone/manette.
- Aucune authentification ni chiffrement sur le serveur de contrôle ---
  ne pas l'exposer hors d'un réseau local de confiance en l'état.
- Pas de caméra, pas de VPN, pas d'accès distant (reste de la Phase 6).
- Pas testé sur Raspberry Pi physique (développé et validé sur la
  machine de dev Linux Mint, contre la simulation Wokwi).

### État actuel

- **Rover est pilotable en réseau local** (Phase 5 + 6 minimales) :
  interface web (manette ou joystick tactile) → `MOVE` → ESP32,
  validé de bout en bout en simulation.

### Prochaines étapes

- Valider le joystick tactile / la manette avec un vrai téléphone et
  une vraie manette (ouvrir `http://<ip>:8080/` depuis un navigateur).
- Continuer soit la Phase 3 (tête/écran) côté ESP32, soit approfondir
  Phase 5/6 (config, logs, machine à états, caméra) selon la priorité
  de l'utilisateur.

------------------------------------------------------------------------

## Session du 2026-08-25 (suite 4) --- Retour d'état + Phase 3 (en cours)

### Contexte

Demande de l'utilisateur : afficher le retour d'état ESP32 dans
l'interface web, et démarrer la Phase 3 (tête/écran). Session
interrompue par l'utilisateur avant la fin de la Phase 3 --- ce qui
suit distingue clairement ce qui est **fait et validé** de ce qui est
**écrit mais pas encore branché/testé**.

### Retour d'état dans l'UI --- fait et validé

- `RoverCore` (`pi/rover_core/core.py`) expose un pub-sub
  (`add_listener`/`remove_listener`) : n'importe quel abonné reçoit
  chaque trame `STATE`/`EVENT`/`ERROR` reçue de l'ESP32, sans que
  `RoverCore` ait besoin de connaître aiohttp/WebSocket.
- `rover_control/server.py` pousse ces trames en JSON au client
  WebSocket concerné (+ la dernière connue immédiatement à la
  connexion, pour qu'un client qui rejoint en cours de session ne voie
  pas un panneau vide).
- `index.html` affiche trois lignes : `STATE` (permanente, dernière
  valeur), `EVENT`/`ERROR` (s'effacent après 5 s --- ce sont des
  occurrences, pas un statut permanent).
- **Validé** contre la simulation Wokwi en cours : un client WebSocket
  simulé a bien reçu `{"type": "STATE", ...}` poussé en temps réel
  après un `MOVE`.
- Commité (`a0be37c`).

### Phase 3 (tête + écran) --- démarrée, PAS encore intégrée ni testée

Recherche préalable : l'architecture du moteur d'yeux de Lumi
(`/home/raphael/R-Bot-Data/Git/Lumi-Project`) a été étudiée (agent de
survol, lecture seule). Constat : ~180 lignes de logique de rendu
autonome (yeux "glitch" RGB-split, easing blink/regard, icône WiFi),
basée sur Adafruit_GFX + Adafruit_ST7789, mais **pas** une classe
réutilisable --- une tâche FreeRTOS avec des globales. Portage prévu
comme réécriture propre en classe (`DisplayEngine`/`EyeRenderer`), pas
copier-coller.

**Écrit et compile, mais RIEN de tout ça n'est encore branché à
`main.cpp` ni testé (ni en simulation, ni autrement)** :

1. `esp32/include/head_config.h` (nouveau) : pinout servos pitch/yaw
   (GPIO13/19, déjà dans `WIRING.md`), canaux LEDC 4/5 (0--3 réservés
   aux moteurs), limites souples (placeholders, ±30°/±90°), vitesse
   d'interpolation.
2. `esp32/include/display_config.h` (nouveau) : pinout écran ST7789
   (GPIO18/23/5/2/15, déjà dans `WIRING.md`), résolution 240×280
   (reprise de Lumi comme hypothèse de départ, pas confirmée pour
   Rover --- beaucoup d'écrans ST7789 sont 240×240 ou autre).
3. `esp32/lib/head/ServoJoint.{h,cpp}` : pilotage bas niveau d'un servo
   via LEDC (angle relatif au centre → largeur d'impulsion).
4. `esp32/lib/head/HeadController.{h,cpp}` : cible pitch/yaw → servos,
   avec les mêmes precautions que `DriveController` en Phase 2 (garde
   NaN/Inf, clamp aux limites souples, interpolation non bloquante).
5. `esp32/platformio.ini` : ajout de `Adafruit GFX Library` et
   `Adafruit ST7735 and ST7789 Library` en dépendances (résolues avec
   succès par PlatformIO, confirmé par la compilation).

**Compilation vérifiée** sur `esp32_wroom` et `esp32_s3` --- mais
comme rien n'est encore `#include`-é depuis `main.cpp`, le LDF de
PlatformIO ne compile même pas encore ces fichiers (taille du firmware
inchangée par rapport au commit précédent) : ça ne prouve donc **pas**
que `HeadController`/`ServoJoint` compilent réellement ensemble, juste
que le reste du projet n'est pas cassé.

**Pas commencé du tout** : `DisplayEngine`/`EyeRenderer` (rendu des
yeux), `Emotion` enum, dispatch des commandes `HEAD`/`FACE`/`ANIMATION`
dans `main.cpp`, tout test Wokwi (diagramme non étendu pour servos/écran).

### Prochaines étapes

1. Terminer l'intégration `HeadController` dans `main.cpp` (dispatch
   `HEAD`, `head.update()` dans `loop()`) et vérifier que ça compile
   **avec** les fichiers réellement inclus cette fois.
2. Écrire `DisplayEngine`/`EyeRenderer` (yeux + blink/look idle +
   mapping `Emotion`) et le dispatch `FACE`/`ANIMATION`.
3. Étendre `esp32/diagram.json` (servo(s) + écran ST7789 Wokwi) et
   valider en simulation, même méthode que les phases précédentes
   (headless `wokwi-cli`, checksum via `tools/rover_frame.py`).
4. Continuer le retour d'état : valider joystick/manette sur vrai
   téléphone/manette (toujours en attente).

------------------------------------------------------------------------

## Session du 2026-08-25 (suite 5) --- Phase 3 terminée (code + simulation protocole)

### Contexte

L'utilisateur a demandé de terminer la Phase 3 malgré la pause prévue
plus tôt. Suite directe de la session précédente : `HeadController`/
`ServoJoint` existaient déjà mais n'étaient pas branchés, et le moteur
d'yeux n'était pas commencé.

### Ce qui a été fait

1. **`esp32/lib/display/`** (nouveau module) :
   - `EyeState.h` : struct pure décrivant l'état visuel à dessiner
     (regard gauche/droite, ouverture, intensité glitch) --- séparation
     volontaire entre "quoi dessiner" et "pourquoi", pour que le rendu
     reste une fonction pure de l'état.
   - `EyeRenderer.{h,cpp}` : rendu des yeux "glitch" (rectangles arrondis
     RGB décalés cyan/magenta/blanc + iris noire), technique reprise du
     survol de Lumi mais **réécrite** en fonction pure sur
     `Adafruit_GFX`, pas copiée (Lumi n'a pas de classe réutilisable,
     juste une tâche FreeRTOS avec des globales --- voir le survol
     précédent).
   - `Emotion.{h,cpp}` : les 8 émotions de la section 15 de
     `ARCHITECTURE_AND_ROADMAP.md` (IDLE/HAPPY/CURIOUS/SLEEPY/
     CONFUSED/ALERT/SAD/EXCITED), parsing du champ `emotion=` d'une
     trame `FACE`.
   - `DisplayEngine.{h,cpp}` : possède l'écran ST7789 + un profil par
     émotion (ouverture de base, cadence de clignement, biais de
     regard, "wander" idle, glitch continu pour `ALERT`,
     regard asymétrique pour `CONFUSED`) --- **premier jet
     paramétrique** réutilisant un seul modèle d'œil, pas d'art dédié
     par émotion (aucune ressource de design fournie). Une seule
     animation concrète (`GLITCH`, effet RGB-split renforcé, 900 ms)
     démontre le mécanisme `ANIMATION name=...`, pas une bibliothèque
     complète.
   - Détail d'intégration important : `SPI.begin(SCLK, -1, MOSI, CS)`
     avec MISO explicitement désactivé (`-1`), comme sur Lumi --- sinon
     `SPI.begin()` par défaut réserve GPIO19 (MISO VSPI par défaut) qui
     est utilisé ici pour le servo Yaw. Sans ce détail, ça aurait été un
     conflit de pin silencieux.

2. **`main.cpp`** : dispatch `HEAD` (gated sur `ACTIVE`, même logique
   que `MOVE`), `FACE` et `ANIMATION` (non gated --- afficher une
   émotion n'a aucune implication de sécurité physique, contrairement
   au mouvement). `head.update()`/`display.update()` appelés dans
   `loop()`. Un nom d'émotion inconnu est ignoré silencieusement (même
   tolérance qu'une action `SYSTEM` inconnue).

3. **`esp32/diagram.json`** étendu : 2 `wokwi-servo` (pitch/yaw) + 1
   écran `board-st7789` (le nom exact trouvé par tâtonnement via
   `wokwi-cli lint`, qui liste les pins valides d'un type de pièce en
   cas d'erreur --- `wokwi-st7789` n'existe pas).
   **Découverte en testant** : ce chip simulé est fixe en 240×240, pas
   configurable ---`display_config.h` corrigé pour correspondre (240×240
   au lieu de 240×280 repris de Lumi), pour que la simulation et le
   firmware restent cohérents entre eux.

4. **Compilation** vérifiée sur `esp32_wroom` et `esp32_s3` (RAM 6.1%,
   Flash 9.4%) après chaque étape.

5. **Validé en simulation** (headless `wokwi-cli` + RFC2217, sur un
   port isolé 4009 pour ne pas interrompre la session VSCode de
   l'utilisateur, remis à 4000 après coup) :
   - Boot avec tout le code Phase 3 chargé (moteurs + tête + écran) :
     pas de crash, pas de conflit de pin.
   - `HEAD pitch=15 yaw=-20` accepté en état `ACTIVE`.
   - `FACE emotion=happy` accepté.
   - `ANIMATION name=GLITCH` accepté.
   - `FACE emotion=bogus` (émotion inconnue) : ignoré silencieusement,
     pas de crash, pas de trame `ERROR`.
   - `SYSTEM action=diag` après tout ça : `uptime_ms`/`free_heap`
     stables et cohérents --- pas de reset, pas de fuite mémoire.

### Ce qui n'est PAS validé

- **Le rendu visuel des yeux n'a pas pu être vérifié**, seulement le
  dispatch protocole. Tentative de capture d'écran via `wokwi-cli
  --screenshot-part display` : échec, `"Part does not have a valid
  framebuffer: display"` --- limite du chip communautaire
  `github:Whiteeeey/chip-st7789` utilisé par `board-st7789`, pas un
  bug du firmware. Reste à vérifier à l'œil dans le simulateur VSCode
  (interface graphique, hors de portée de ce terminal) ou sur écran
  physique.
- Aucune calibration des limites d'angle des servos ni des profils
  d'émotion contre du matériel réel (tout est provisoire, comme
  d'habitude cette phase-ci).
- Rien testé sur servos/écran physiques.

### État actuel

- **Phase 3 (Tête et écran) : complète au niveau code**, compile sur
  les deux cibles, validée en simulation au niveau protocole
  (dispatch `HEAD`/`FACE`/`ANIMATION` sans crash). Rendu visuel non
  confirmé. Pas de test matériel physique.
- **Phases 0, 1, 2 : inchangées** depuis les sessions précédentes.

### Prochaines étapes

- Vérifier visuellement le rendu des yeux dans VSCode (l'utilisateur
  peut le faire directement, capture impossible depuis ce terminal).
- Phase 4 (Capteurs) ou calibration matérielle des Phases 2/3 dès que
  le robot physique est disponible.
- Retour d'état : toujours en attente de validation joystick/manette
  sur un vrai téléphone/manette.

------------------------------------------------------------------------

## Session du 2026-08-25 (suite 6) --- Retouche des yeux (design + fiabilité)

### Contexte

Retour de l'utilisateur sur le rendu des yeux : forme carrée à coins
arrondis (pas la forme plus rectangulaire du premier jet), effet
glitch cyan/rose **visible en permanence** (pas réservé à `ALERT`),
et une exigence explicite de fiabilité/optimisation + impression de
vie (clignement + mouvement, jamais statique). Dernière étape avant
fin de journée.

### Ce qui a changé

1. **`EyeRenderer.cpp`** :
   - Yeux désormais **carrés** (une seule dimension `eyeSize`, ~36% de
     la largeur d'écran) au lieu du rectangle 35%×45% du premier jet.
   - Rayon d'arrondi recalculé sur `min(largeur, hauteur)` au lieu de
     la largeur seule --- sinon le rayon dépassait la moitié de la
     hauteur pendant un clignement (`h` rétrécit fortement), ce que
     `fillRoundRect` gère mal.
   - **Optimisation** : `EyeRenderer::draw()` ne fait plus
     `fillScreen()` (tout l'écran) à chaque frame (~30 Hz) --- calcule
     désormais une "cellule" fixe par œil (assez grande pour couvrir
     l'ouverture max + le décalage glitch max) et ne redessine que ces
     deux cellules. Le reste de l'écran, jamais dessiné ailleurs, est
     nettoyé une seule fois au boot. Réduction significative du trafic
     SPI par frame.
   - Garde-fous ajoutés : largeur/hauteur jamais négatives, `lookX`/
     `lookY` re-clampés juste avant utilisation dans le calcul de
     position de l'iris.

2. **`DisplayEngine.cpp`** :
   - **Glitch permanent** : `glitchIntensity` de base non nulle pour
     *toutes* les émotions (0.25 à 0.50 selon l'émotion, 0.70 pour
     `ALERT`), plus l'effet `GLITCH` de l'animation par-dessus ---
     avant, seul `ALERT`/l'animation l'activait, le reste était
     "propre". Couleurs cyan/magenta (rose) inchangées, dosage à
     ajuster plus tard selon le retour de l'utilisateur.
   - **Clignement lissé** : remplacé le bascule binaire
     ouvert/fermé par une enveloppe (`sin`) sur 180 ms --- fermeture
     puis réouverture progressive, plus naturel qu'un flash.
   - **Mouvement permanent** : ajout d'un léger balancement continu
     ("breathing", deux sinusoïdes légèrement déphasées) recalculé à
     chaque frame et ajouté *après* le lissage regard/wander --- pas
     accumulé dans l'état, pour ne jamais dériver. Résultat : plus
     aucune émotion n'est parfaitement statique, y compris
     `CURIOUS`/`SLEEPY`/`ALERT`/`SAD` qui n'ont pas de "wander" actif.
   - `profileFor()` appelé une seule fois par cycle `update()` (au lieu
     de deux, une fois dans le calcul du mouvement et une fois dans le
     rendu) --- petite simplification, pas de gain mesurable à ce
     niveau de charge, mais une seule source de vérité par frame.

3. **Compilation** vérifiée sur `esp32_wroom`/`esp32_s3` (RAM 6.1%,
   Flash 9.5%).

4. **Revalidé en simulation** (même méthode : port RFC2217 isolé 4009,
   remis à 4000 après coup) : séquence `ping` → `FACE curious` → 1.5 s
   d'attente (laisser tourner clignement/mouvement) → `ANIMATION
   GLITCH` → 1.5 s → `FACE alert` → 1.5 s → `diag`. Résultat après
   ~4.5 s de simulation (~135 frames de rendu) : aucun crash,
   `uptime_ms`/`free_heap` cohérents, pas de fuite mémoire.

### Ce qui n'est toujours PAS validé

- Toujours pas de vérification visuelle (même limite que la session
  précédente : le chip `board-st7789` simulé n'expose pas de
  framebuffer capturable par `wokwi-cli`). Le dosage exact des
  couleurs/intensité du glitch est une estimation à ajuster une fois
  visible --- l'utilisateur l'a explicitement anticipé ("on ajustera
  après").
- Rien testé sur écran physique.

### État actuel

- Phase 3 inchangée dans son état fonctionnel (toujours complète au
  niveau code/protocole) --- cette session ne fait qu'affiner le rendu
  et durcir `EyeRenderer`/`DisplayEngine`.

### Prochaines étapes

- Vérifier visuellement le rendu (VSCode ou matériel réel) et ajuster
  le dosage du glitch/les proportions selon le retour de l'utilisateur.
- Reste identique à la session précédente : Phase 4, calibration
  matérielle Phases 2/3, validation joystick/manette physique.

------------------------------------------------------------------------

## Session du 2026-08-31 --- Premier test matériel réel (écran) + rendu des yeux validé

### Contexte

Premier branchement de matériel physique sur le projet (ESP32 WROOM +
écran ST7789), demande explicite de l'utilisateur : valider uniquement
l'affichage (yeux/glitch), sans moteurs/servos câblés. Session menée
depuis une machine Windows (pas l'environnement Linux Mint habituel du
projet).

### Mise en place de l'outillage de test

- **Driver CP210x manquant** : Windows ne détectait aucun port COM pour
  l'ESP32 (`CP2102 USB to UART Bridge Controller` en erreur, code 28
  "drivers not installed"). Résolu par l'utilisateur en installant le
  driver Silicon Labs officiel --- port `COM10` apparu ensuite.
- **PlatformIO CLI installé** (`pip install platformio`) plutôt que de
  passer par l'extension VS Code : `PROGRESS.md` (session 2026-08-25)
  documentait déjà un moniteur série VS Code peu fiable en saisie pour
  ce genre de test ; le CLI + un script `pyserial` dédié
  (`rover_test.py`, même logique que `esp32/tools/rover_frame.py` +
  `pi/rover_esp32/link.py`) permet d'envoyer les trames et de lire les
  réponses directement, sans dépendre de l'UI.
- Build + upload confirmés fonctionnels via
  `pio run -e esp32_wroom -t upload --upload-port COM10`.

### Écran : deux problèmes identifiés au premier essai, corrigés

1. **Mauvaise résolution/orientation** : `display_config.h` utilisait
   240x240 (valeur calée sur le chip simulé Wokwi, jamais confirmée sur
   le vrai panneau --- voir PROGRESS.md 2026-08-25 suite 5). Le panneau
   réel est en fait **240x280** (comme celui de Lumi) et s'affichait en
   portrait alors que Rover est prévu en paysage. Corrigé :
   - `display_config.h` distingue maintenant les dimensions natives du
     panneau (`ROVER_DISPLAY_PANEL_WIDTH/HEIGHT` = 240x280, portrait)
     des dimensions logiques utilisées par tout le rendu
     (`ROVER_DISPLAY_WIDTH/HEIGHT` = 280x240, paysage).
   - `DisplayEngine::begin()` appelle `_tft.init()` avec les dimensions
     natives puis `_tft.setRotation(ROVER_DISPLAY_ROTATION)` (valeur
     `1`, 90° --- `3` en secours si l'image sort inversée/miroir selon
     le sens de câblage du ruban, ce que le logiciel ne peut pas
     deviner).
   - Conséquence pour Wokwi : le chip simulé `board-st7789` reste fixe
     en 240x240, donc la simulation ne représente plus fidèlement le
     rendu visuel réel (elle reste valide au niveau protocole
     seulement, ce qui était déjà sa seule garantie jusqu'ici).

2. **Effet glitch "fouillis de couleur"** : la première version
   remplissait l'œil trois fois (copie cyan décalée, copie magenta
   décalée, blanc par-dessus) --- correct en théorie (le blanc ne
   laissait dépasser que de fines bandes cyan/magenta sur les bords),
   mais rendu réel jugé confus par l'utilisateur. Retravaillé en trois
   passes de retouche (`EyeRenderer.cpp`) suite aux retours successifs :
   - Œil toujours un remplissage blanc unique et propre (jamais teinté).
   - Contour permanent : une ligne cyan et une ligne rose tracées
     (`drawRoundRect`, pas un remplissage) légèrement décalées de
     part et d'autre de l'œil --- épaissi à 2px sur un offset de 2px
     après un premier essai jugé pas assez visible.
   - Glitch animé : quelques traits fins (1px d'épaisseur) positionnés
     aléatoirement à chaque frame (~30 Hz, aucun état mémorisé --- un
     nouveau tirage indépendant à chaque redraw, ce qui donne l'effet
     de scintillement), favorisés à 65% horizontaux après retour
     explicite de l'utilisateur, fréquence/nombre de traits liés à
     `glitchIntensity` (donc plus dense en `ALERT`/`ANIMATION=GLITCH`).
   - Rayon des coins arrondis augmenté (`taille/4` → `taille/3`) sur
     demande.
   - Un bug de compilation `esp32_s3` a été corrigé au passage :
     `std::max(int, long)` ne compile pas (déduction de template
     ambiguë) --- `random()` renvoie un `long`, les appels ont été
     explicitement castés en `int`.

### Validation

- Compilation vérifiée sur `esp32_wroom` et `esp32_s3` après chaque
  itération (RAM ~6%, Flash ~9.6%).
- Flash réel + script de test (`SYSTEM ping` → 7 émotions `FACE` →
  `ANIMATION GLITCH` → `SYSTEM diag`) rejoué à chaque itération :
  aucune trame `ERROR`, `uptime_ms`/`free_heap` stables (pas de fuite,
  pas de reset) sur toute la session.
- **Rendu visuel confirmé par l'utilisateur sur écran physique réel**
  (validation humaine, pas automatisable) après la dernière itération :
  taille des yeux, orientation paysage, coins arrondis, contour
  cyan/rose et glitch jugés corrects.

### État actuel

- **Phase 3 (Tête et écran)** : le volet écran est maintenant
  **validé visuellement sur matériel réel**, en plus du code/protocole
  déjà validés précédemment. Les servos (pitch/yaw) restent non testés
  sur matériel physique --- prochaine étape naturelle si du matériel
  reste disponible.
- `display_config.h` porte maintenant la résolution réelle confirmée
  (240x280) au lieu d'une valeur provisoire calée sur Wokwi.

### Prochaines étapes

- Tester les servos tête (pitch/yaw) sur matériel réel, même méthode
  (script `pyserial` + trames `HEAD`, mais nécessite `SYSTEM
  action=resume`/un flux `HEARTBEAT` puisque `HEAD` est gated sur
  `ACTIVE`, contrairement à `FACE`/`ANIMATION`).
- Phase 4 (capteurs) ou calibration matérielle Phase 2 (moteurs/PID)
  dès que ce matériel est disponible.
- Validation joystick/manette sur un vrai téléphone/manette (toujours
  en attente depuis la session du 2026-08-25).

------------------------------------------------------------------------

## Session du 2026-08-31 (suite) --- Phase 4 (capteurs) écrite, deux bugs réels trouvés au test matériel

### Contexte

Le châssis est encore en impression 3D et les moteurs/capteur de
distance/borniers ne sont pas encore montés/reçus au moment d'écrire ce
code -- décision de l'utilisateur : avancer sur le code de la Phase 4
(capteurs) en s'appuyant sur le roadmap, pendant l'attente matérielle,
plutôt que de rester bloqué. Demande explicite : prévoir des phases de
test/validation par étapes pour quand le matériel arrivera (voir la
section "Plan de test" ci-dessous).

### Ce qui a été écrit

Nouveau module `esp32/lib/sensors/` (Phase 4 complète au niveau code) :

- `DistanceSensor.{h,cpp}` : les deux VL53L0X, séquence XSHUT (gauche
  réadressé 0x30, droit reste 0x29), mode "continuous ranging" (pas de
  lecture bloquante dans `update()`), `EVENT name=obstacle_detected`
  avec hystérésis (deux seuils, `sensors_config.h`).
- `ImuSensor.{h,cpp}` : MPU6050, lecture accel/gyro périodique.
- `EnvironmentSensor.{h,cpp}` : BME688 (registres compatibles BME680 --
  température/humidité/pression/gaz), non-bloquant via
  `beginReading()`/`endReading()` au lieu du `performReading()` bloquant
  de la bibliothèque (une conversion BME680 prend 150-300 ms, ce qui
  aurait gelé le PID moteurs/l'écran à chaque cycle).
- `SensorHub.{h,cpp}` : agrège les trois, détecte les transitions
  OK→échec (y compris dès le premier `begin()` au boot, pas seulement
  une perte en cours de route) pour émettre `ERROR
  code=sensor_timeout sensor=<nom>` une seule fois par capteur --
  jamais de spam à chaque nouvelle tentative de reconnexion (toutes les
  5 s, `ROVER_SENSOR_RETRY_PERIOD_MS`).
- `main.cpp` : `sensors.begin()`/`update()`, drain des erreurs capteur
  et de l'événement obstacle à chaque `loop()`, télémétrie `STATE`
  (distance/IMU/environnement) à 500 ms -- **jamais gated sur
  ACTIVE/SAFE**, contrairement à `MOVE`/`HEAD` : la conscience
  situationnelle (obstacle, santé capteur) reste utile au Pi même robot
  à l'arrêt.
- `platformio.ini` : ajout des dépendances Adafruit (BusIO, Unified
  Sensor, MPU6050, `Adafruit_VL53L0X`, BME680 Library) -- résolues et
  compilées avec succès sur les deux cibles (RAM 6.8%, Flash 11.1% sur
  S3).
- `ROVER_PROTOCOL.md` : documenté les nouveaux champs `STATE`
  (humidity/pressure/gas_kohm, accel_x..gyro_z) et le champ optionnel
  `sensor=` sur `ERROR code=sensor_timeout`.
- `WIRING.md` : adresses I2C (VL53L0X gauche réadressé 0x30, MPU6050
  0x68, BME688 0x77 -- ces deux dernières non confirmées sur le matériel
  réel) + note sur la sonde de présence I2C obligatoire (voir bug
  ci-dessous).

### Deux bugs réels trouvés en testant sur l'ESP32 WROOM physique (aucun capteur câblé)

Le test volontaire "aucun capteur branché" (situation exacte du jour :
tout est en attente de livraison/impression) a servi de test de
robustesse -- et a immédiatement révélé deux bugs qu'aucune compilation
ni simulation Wokwi n'aurait pu attraper :

1. **Plantage en boucle au boot (watchdog matériel).** `sensors.begin()`
   plantait systématiquement le firmware ~6 s après le boot (jamais
   atteint `loop()`). Diagnostic par instrumentation temporaire
   (`Serial.printf` entre chaque `begin()` de capteur) : le blocage
   était entièrement à l'intérieur de `DistanceSensor::begin()` --
   l'API VL53L0X d'origine de ST (vendue telle quelle par
   `Adafruit_VL53L0X`, fichiers `vl53l0x_api*.cpp`) reste bloquée
   indéfiniment dans une boucle d'attente interne (`VL53L0X_WaitDevice-
   Booted` ou équivalent) au lieu d'échouer proprement quand rien ne
   répond sur le bus I2C -- un vrai piège pour ce cas précis (0 capteur
   câblé). Une première tentative de correction (nourrir le watchdog +
   réduire le timeout I2C via `Wire.setTimeOut(50)`) n'a rien changé
   (le blocage est interne à un seul appel bibliothèque, invisible de
   l'extérieur). **Correction retenue** : sonder la présence du capteur
   (`Wire.beginTransmission`/`endTransmission`, `I2CProbe.h`) **avant**
   d'appeler le `begin()` de la bibliothèque, jamais après -- appliqué
   aux trois capteurs (VL53L0X x2, MPU6050, BME688) par précaution,
   même si seul le VL53L0X a été prouvé bloquant. Root cause vérifiée :
   confirmé par la trace de debug avant/après.
2. **Trames `ERROR`/`STATE` tronquées en silence.** Une fois le crash
   réglé, les trames sorties étaient coupées au milieu d'un mot (`ERROR
   ... sensor=tof_` au lieu de `tof_left`/`tof_right`, `STATE ...
   gyro_y=0.00` sans `gyro_z` du tout) -- buffers `char[32]`/`char[64]`
   dans `main.cpp` trop petits pour le contenu réel (`sensor=tof_right`
   à lui seul fait 37 octets avec le terminateur ; les 6 champs IMU à
   zéro font ~75 octets). Corrigé en passant à `char[48]`/`char[96]`
   avec un commentaire expliquant le calcul, pour que ça ne se
   reproduise pas silencieusement si un nom de champ s'allonge plus
   tard.

### Validation

- Compilation vérifiée sur `esp32_wroom` et `esp32_s3` après chaque
  correction.
- Flash réel + script de test (`SYSTEM ping` → 7 émotions `FACE` →
  `ANIMATION GLITCH` → `SYSTEM diag`, script `rover_test.py`) : plus
  aucun crash, boot stable, les 4 `ERROR code=sensor_timeout
  sensor=<tof_left|tof_right|imu|bme688>` bien émis une seule fois au
  boot (aucun capteur câblé, comportement attendu), `STATE
  distance_left=9999 distance_right=9999` (sentinelle "indisponible"),
  `STATE accel_x=0.00 ... gyro_z=0.00` et `STATE temperature=0.0 ...
  gas_kohm=0.0` complets et bien formés, `uptime_ms`/`free_heap`
  stables sur `SYSTEM action=diag`.
- **Lecture effective d'un capteur réel non testée** (aucun n'est
  encore câblé) -- seule la robustesse "capteur absent" est validée à
  ce stade.

### Plan de test pour la suite (par étapes, au fur et à mesure du matériel)

1. **VL53L0X + borniers (attendu aujourd'hui, 2026-08-31)** : câbler
   un ou deux VL53L0X selon ce qui est reçu (XSHUT gauche/droit, SDA/SCL
   partagés -- voir `WIRING.md`). Reflasher le firmware actuel (aucun
   changement de code nécessaire). Attendu : plus d'`ERROR
   sensor_timeout sensor=tof_left/tof_right` pour le(s) capteur(s)
   câblé(s), `STATE distance_left=...`/`distance_right=...` avec des
   valeurs plausibles en mm, `EVENT name=obstacle_detected` en
   approchant la main à moins de 150 mm.
2. **Moteurs + PID (dès châssis + borniers prêts)** : reprendre la
   Phase 2, câblage propre au lieu de fils volants, calibrer les gains
   PID et `ROVER_ENCODER_TICKS_PER_REV`/`ROVER_WHEEL_DIAMETER_M` dans
   `motion_config.h` contre les vraies roues/moteurs N20.
3. **Servos tête** (dès la tête montée sur le châssis) : `HEAD
   pitch=... yaw=...` via le même script de test, ajuster les limites
   souples de `head_config.h` si nécessaire.
4. **MPU6050 / BME688** (dès réception) : même principe qu'à l'étape 1
   -- câbler, reflasher sans changement de code, vérifier que l'`ERROR`
   correspondant disparaît et que les valeurs `STATE` sont plausibles
   (accel_z proche de 9.8 au repos, température proche de l'ambiante).
5. **Raspberry Pi** (après validation moteurs, décision explicite de
   l'utilisateur) : brancher l'UART réel Pi↔ESP32, lancer `rover_core`/
   `rover_control` déjà écrits (Phase 5/6 minimales) contre le matériel
   réel au lieu de la simulation Wokwi.

### Durcissement immédiat (même session)

Revue critique de `DistanceSensor` par cohérence avec `ImuSensor`/
`EnvironmentSensor` : ces deux derniers détectent explicitement un échec
de lecture en cours de route (`_ok = false` si l'appel de lecture
échoue), mais `DistanceSensor` ne le faisait pas -- le mode "continuous
ranging" des VL53L0X n'a pas de signal d'échec par lecture comme les
autres capteurs, donc un capteur débranché *après* un `begin()` réussi
ne l'aurait jamais fait remonter en `ERROR`. Corrigé en ajoutant un
horodatage du dernier échantillon reçu par côté ; si plus d'1 s s'écoule
sans nouvel échantillon alors que le capteur est censé être `ok`, il est
déclaré en échec (retenté ensuite comme les autres). Recompilé et
reflashé sur l'ESP32 WROOM réel : toujours aucun crash, comportement
identique côté protocole (aucun capteur câblé pour l'instant, donc ce
chemin n'a pas encore pu être exercé en conditions réelles -- seule la
non-régression a pu être vérifiée).

### État actuel

- **Phase 4 (capteurs)** : complète au niveau code, compile sur les
  deux cibles, **validée sur ESP32 WROOM physique** pour le cas "aucun
  capteur câblé" (robustesse, y compris la détection de perte en cours
  de route pour les VL53L0X). Lecture réelle des capteurs à valider dès
  réception/câblage (étape 1 du plan ci-dessus).
- **Phases 0, 1, 2, 3** : inchangées.

------------------------------------------------------------------------

## Session du 2026-08-31 (suite 2) --- 5 améliorations transverses (CI, tests, Wokwi Phase 4, machine à états Pi, UI capteurs)

### Contexte

En attendant le matériel (châssis, moteurs, capteurs), demande de
l'utilisateur : proposer des améliorations exploitables sans dépendre
du Raspberry Pi physique ni de nouveau matériel. Cinq pistes proposées
et validées par l'utilisateur, réalisées dans l'ordre.

### 1. CI GitHub Actions

`.github/workflows/esp32-build.yml` : build `esp32_wroom` et
`esp32_s3` sur chaque push/PR touchant `esp32/`, plus un job de tests
natifs (voir point 2). Aurait attrapé automatiquement le bug de
compilation spécifique à `esp32_s3` de la session précédente
(`std::max`/`random()`). Vérifié en conditions réelles : push déclenché,
run surveillé via l'API GitHub (`gh` CLI absent sur cette machine, pas
de compilateur C/C++ local non plus -- validation faite par polling de
l'API publique du dépôt). **Les 3 jobs passent** (`build (esp32_wroom)`,
`build (esp32_s3)`, `test`).

### 2. Tests unitaires (RoverProtocol, WheelPID, Emotion)

Obstacle rencontré : PlatformIO compile tout un dossier `lib/` en bloc
dès qu'un seul fichier en est référencé -- `WheelPID` et `Emotion`
partageaient un dossier avec du code dépendant du matériel ESP32
(`MotorDriver`/`Encoder`/`DriveController` ; `DisplayEngine`/
`EyeRenderer`), donc les tester nativement (sans ESP32) aurait forcé la
compilation de ce code matériel aussi. Résolu en les déplaçant dans
leurs propres dossiers (`lib/wheel_pid/`, `lib/emotion/`) --- aucun
changement de comportement, recompilation `esp32_wroom`/`esp32_s3`
vérifiée identique (même RAM/Flash) après le déplacement.

Nouvel environnement PlatformIO `native` (compilateur hôte, pas
d'ESP32), avec un stub minimal `test/stubs/Arduino.h` (juste
`constrain()` et une classe `Stream` abstraite) et un `FakeStream.h`
(capture les appels `printf()`, fournit des octets à `available()`/
`read()`) pour tester `RoverProtocol` sans matériel réel. Suites Unity :
- `RoverProtocol` : checksum de sortie vérifié contre la valeur déjà
  validée dans `ROVER_PROTOCOL.md`/`rover_frame.py` (`MOVE
  velocity=0.25 rotation=-0.10 *39`), round-trip envoi→parsing,
  checksum invalide rejeté, trame trop longue rejetée (`frame_too_long`),
  tolérance `\r\n`, accesseurs `RoverFrame::getField/getInt/getFloat`.
- `WheelPID` : signe de sortie selon l'erreur, saturation à ±255,
  garde `dtSeconds<=0`, `reset()` efface bien l'anti-windup.
- `Emotion` : les 8 émotions, sensibilité à la casse, nom inconnu.

Pas de compilateur C/C++ sur cette machine Windows pour exécuter
`pio test -e native` localement -- validé via la CI (point 1) à la
place. Deux valeurs de checksum d'abord devinées à la main dans les
tests (`*2B`/`*58`) se sont révélées fausses à la vérification via
`rover_frame.py` (`*6B`/`*4B` réels) -- corrigées avant de committer,
bon rappel de ne jamais committer un checksum non recalculé.

### 3. Wokwi -- simulation Phase 4

Wokwi n'a pas de chip officiel pour VL53L0X ni BME680/688 (vérifié via
la doc officielle) ; seul `wokwi-mpu6050` existe. Ajouté au
`diagram.json` (I2C partagé, adresse par défaut 0x68, pas de fabrication
de chip communautaire pour les deux autres -- risque de fragilité déjà
observé avec `board-st7789`). Documenté explicitement dans
`diagram.json` et `WIRING.md` que VL53L0X/BME688 restent non simulables
visuellement, leur dispatch protocole étant déjà validé autrement (test
matériel réel + sonde de présence I2C). JSON validé syntaxiquement ;
pas de `wokwi-cli` disponible sur cette machine pour un lint complet des
noms de pins (contrairement aux sessions précédentes sur Linux Mint).

### 4. Machine à états haut niveau (`rover_core`)

`RoverBehaviorState` (`pi/rover_core/core.py`) : reprend l'énumération
exacte de la section 20 de l'architecture (IDLE/INTERACTING/MOVING/
EXPLORING/PATROLLING/FOLLOWING/CHARGING/SLEEPING/ERROR). Seules les
transitions pilotables par l'existant sont câblées :
- connexion/déconnexion d'un client de contrôle → INTERACTING/IDLE ;
- `move()` avec vitesse/rotation non nulle → MOVING (avec une zone morte
  pour ne pas confondre "0.00 explicite" et "vraiment à l'arrêt") ;
- une trame `ERROR` de l'ESP32 → ERROR, avec retour automatique après
  `ERROR_STATE_HOLD_S` (5 s, aligné sur le délai d'effacement déjà
  utilisé dans l'UI) si aucune nouvelle erreur n'arrive entretemps.

Les transitions vers EXPLORING/PATROLLING/FOLLOWING/CHARGING/SLEEPING
n'existent pas encore (aucune des phases correspondantes --- navigation,
vision, énergie --- n'est commencée) : elles sont dans l'énumération
pour que ces phases futures aient un état où transitionner sans
redessiner l'enum, pas parce qu'un mécanisme les déclenche aujourd'hui.

Notification des changements d'état réutilise le pub-sub existant de
`RoverCore` (les mêmes `listener()` que pour `STATE`/`EVENT`/`ERROR`),
via un type synthétique `ROVER_STATE` -- pas de nouveau mécanisme de
notification en parallèle.

**Validé en conditions réelles** contre l'ESP32 physique (COM10, Phase 4
déjà flashée) : `rover_core` lancé, log confirmant `behavior state ->
ERROR` à la première trame `ERROR code=sensor_timeout` reçue, puis
`behavior state -> IDLE` exactement ~5 s plus tard (aucune nouvelle
erreur entretemps) -- comportement exactement conforme à la conception.

### 5. Affichage capteurs dans l'UI de contrôle

`RoverCore.last_report` (un seul dernier frame, tous types confondus,
écrasé à chaque nouvelle trame) remplacé par `last_state` (fusion
cumulative des champs `STATE` -- distance/IMU/environnement/vitesse
roues arrivent dans des lignes `STATE` séparées, donc l'ancien
`last_report` ne montrait jamais que la dernière catégorie reçue) +
`last_event`/`last_error` (un de chaque, transitoires). Un client qui se
connecte reçoit maintenant un instantané complet (état fusionné +
dernier événement/erreur + état comportemental courant) au lieu d'un
seul fragment arbitraire.

`index.html` : badge d'état comportemental à côté du statut de
connexion (libellés français, couleur selon l'état -- vert
INTERACTING, bleu MOVING, rouge ERROR), et une ligne d'alerte obstacle
calculée côté client à partir de `distance_left`/`distance_right`, avec
le même seuil (150 mm) que l'`EVENT obstacle_detected` de l'ESP32, donc
cohérente avec ce que le firmware considère lui-même comme un obstacle.
Bug trouvé et corrigé avant tout test : le badge d'état était placé
*dans* la div `#status`, dont le JS existant fait `textContent = "..."`
à chaque connexion/déconnexion -- ça aurait supprimé le badge du DOM au
premier `onopen`. Corrigé en donnant un `<span>` dédié au texte de
statut.

**Validé en conditions réelles** : `rover_core` relancé contre l'ESP32
physique, client WebSocket de test connecté --- l'instantané reçu à la
connexion contient bien tous les champs `STATE` fusionnés
(`distance_left`, `accel_x`..`gyro_z`, `temperature`..`gas_kohm` dans un
seul message), la dernière `ERROR` (`bme688`), et `ROVER_STATE
INTERACTING`. Page `/` vérifiée servie avec les nouveaux éléments
(`behavior-state`, `obstacle-line`). Syntaxe JS extraite et vérifiée
avec `node --check` (pas de rendu visuel réel testé -- pas de navigateur
piloté cette session).

### État actuel

- CI active sur GitHub (build double-cible + tests natifs).
- Tests unitaires natifs en place pour les 3 modules les plus critiques
  côté protocole/logique pure ; non exécutables localement sur cette
  machine (pas de compilateur), validés via CI.
- Simulation Wokwi étendue à l'IMU (seul capteur Phase 4 avec un chip
  officiel) ; VL53L0X/BME688 restent protocole-only en simulation.
- `rover_core` a maintenant une première machine à états haut niveau,
  validée contre l'ESP32 physique.
- L'UI de contrôle affiche un état fusionné, un badge d'état, et une
  alerte obstacle -- validé côté backend/réseau, pas visuellement.

### Prochaines étapes

- Reste identique pour le matériel : VL53L0X/borniers, moteurs/PID,
  servos tête, MPU6050/BME688, Raspberry Pi (voir plan de test
  ci-dessus, session précédente).
- Si du matériel de dev supplémentaire est disponible : installer un
  compilateur C/C++ (ou utiliser une autre machine) pour exécuter
  `pio test -e native` localement sans dépendre de la CI à chaque
  itération.
- Valider visuellement les changements d'`index.html` dans un vrai
  navigateur (badge d'état, alerte obstacle).

------------------------------------------------------------------------

## Session du 2026-08-31 (suite 3) --- Validation visuelle UI + 9 chantiers (sécurité, robustesse, vidéo)

### Contexte

Deux demandes de l'utilisateur dans la foulée : (1) valider visuellement
le rendu de `rover_control` (point resté ouvert depuis la session
précédente), et (2) un compilateur C/C++ local
(`C:\Users\rapha\tools\mingw64`, MinGW-w64 16.2.0, installé sans droits
admin via une archive portable WinLibs --- Chocolatey nécessitait une
élévation indisponible dans ce terminal). Puis, à partir des
propositions d'amélioration listées en fin de session précédente,
l'utilisateur a demandé les 8 points de sécurité/robustesse dans
l'ordre, plus un retour vidéo, avec une exigence explicite : **le projet
sera open source (GitHub), donc aucune faille de sécurité ni fuite de
données (les siennes ou celles de futurs utilisateurs)**.

### Validation visuelle de l'UI

Skill `run` → pas de skill projet existant → `chromium-cli` absent
(environnement non-headless) → bascule sur `claude-in-chrome` (pilote le
vrai Chrome de l'utilisateur). `rover_control` lancé contre l'ESP32 réel
(COM10), page ouverte, capture d'écran :
- Badge d'état "en attente" (INTERACTING, vert) au repos.
- Ligne d'état fusionnée avec tous les champs capteurs.
- Aucune erreur console.
Puis test des cas non atteints naturellement en injectant des messages
via `javascript_exec` (les fonctions du script inline sont globales,
donc appelables directement) : `distance_left=100` → bandeau "⚠
obstacle proche (gauche)" affiché correctement (écrasé quasi aussitôt
par la vraie télémétrie ESP32 qui renvoie 9999, preuve que le flux
temps réel fonctionne) ; `ROVER_STATE=MOVING` → badge bleu "en
mouvement". Les trois couleurs/badges se comportent comme prévu.

### 1. E-stop matériel (bouton non disponible → conçu pour ne rien bloquer)

`esp32/lib/safety/EStop.h` + `safety_config.h` (GPIO25, `INPUT_PULLUP`)
: sans bouton câblé, la broche lit un "relâché" stable grâce au
pull-up interne --- même principe que la sonde de présence I2C
(`I2CProbe.h`) appliqué à une entrée GPIO. Prend le pas sur le
heartbeat : force `SAFE` indépendamment, bloque `SYSTEM action=resume`
tant que le bouton reste physiquement enfoncé (corrigé un vrai risque
en cours de route : la promotion automatique READY→ACTIVE au premier
frame reçu devait aussi vérifier l'E-stop, sinon un bouton déjà enfoncé
au boot aurait pu être court-circuité selon l'ordre d'exécution dans
`loop()`). Nouvel `EVENT name=estop_pressed` documenté dans
`ROVER_PROTOCOL.md` (checksum vérifié via `rover_frame.py`, pas deviné).
Compilé et testé sur l'ESP32 réel : aucun crash, aucun événement
parasite avec la broche non câblée.

### 2. Monitoring batterie (désactivé par défaut)

`esp32/lib/power/BatteryMonitor.h` + `power_config.h` : lecture ADC +
diviseur de tension, `EVENT name=low_battery` avec hystérésis. **Flag
`ROVER_BATTERY_MONITORING_ENABLED = false` par défaut** --- contrairement
à l'I2C, une broche ADC ne peut pas détecter "rien n'est câblé ici" ; le
bruit d'une broche flottante rapporté comme un vrai niveau de batterie
serait activement trompeur, pire que ne rien publier du tout. GPIO14
choisi (libre) mais documenté comme en conflit avec le WiFi (ADC2,
illisible pendant que l'OTA --- point 3 --- est active) : à revoir si
les deux sont utilisées ensemble un jour. Testé sur ESP32 réel : aucune
trame `STATE battery=` envoyée (comportement attendu, désactivé).

### 3. OTA (mise à jour firmware par WiFi) --- le point le plus sensible

`esp32/lib/ota/RoverOTA.h` : **aucun identifiant en dur**. SSID/mot de
passe WiFi et mot de passe OTA lus depuis des variables d'environnement
au moment de la compilation (`${sysenv.ROVER_WIFI_SSID}` etc. dans
`platformio.ini`), jamais commités. Sans SSID configuré : aucune
activité WiFi du tout. Avec SSID mais sans mot de passe OTA : **refus
explicite de démarrer** (fail closed --- pas de canal de flash sans
authentification accessible à n'importe qui sur le réseau local). Bug
évité proactivement en écrivant le code (leçon tirée du bug watchdog de
la session Phase 4) : la boucle d'attente de connexion WiFi (jusqu'à
10 s) tourne dans `setup()`, avant que `loop()` n'ait jamais nourri le
watchdog matériel (3 s) --- `RoverWatchdog::feed()` ajouté à l'intérieur
de cette boucle dès l'écriture, pas découvert après coup. Guide complet
dans `esp32/OTA.md` (pourquoi, comment configurer, limites --- non
testé en conditions réelles, aucun réseau WiFi configuré pendant cette
session). Compile sur les deux cibles ; boot vérifié sur ESP32 réel
sans configuration (comportement par défaut, aucun délai/activité WiFi).

### 4. Configuration + logs persistants (Pi)

`pi/rover_core/config.py` (fichier JSON optionnel, `config.example.json`
comme gabarit commité, un argument CLI explicite garde priorité) +
`RotatingFileHandler` optionnel (`--log-dir`, 1 Mo × 5 fichiers) dans
`main.py`. Testé en conditions réelles contre l'ESP32 : fichier
`rover_core.log` bien écrit et peuplé.

### 5. mDNS (`rover.local`)

Pas de code : Raspberry Pi OS inclut Avahi par défaut, donc
`<hostname>.local` fonctionne déjà sans rien installer côté Python ---
ajouter une dépendance (`zeroconf`) aurait été redondant avec ce que
l'OS fournit gratuitement. Documenté dans `pi/README.md` (changer le
hostname via `raspi-config`).

### 6. Authentification sur `rover_control` --- le cœur de l'exigence sécurité

`pi/rover_control/auth.py` : token d'accès obligatoire sur **toutes**
les routes via un middleware `aiohttp` unique (`auth_middleware`), donc
une route ajoutée plus tard (le `/video` du point 9, ajouté dans la même
session) est protégée automatiquement plutôt que de compter sur le
réflexe de dupliquer la vérification partout. **Aucun token par défaut
codé en dur** --- lu depuis `ROVER_CONTROL_TOKEN` si défini, sinon généré
aléatoirement à chaque démarrage et affiché dans les logs (utilisable
dès le premier lancement sans éditer de fichier, mais jamais prévisible
pour qui n'a pas accès à cette sortie). Comparaison à temps constant
(`hmac.compare_digest`) pour éviter une fuite d'information par le
temps de réponse. `index.html` propage le token de l'URL de la page vers
le WebSocket et la vidéo (chacun est une requête HTTP indépendante que
le middleware vérifie séparément).

**Validé en conditions réelles** contre l'ESP32 : sans token → 403,
mauvais token → 403, bon token → 200, WebSocket avec bon token →
fonctionne et reçoit bien les trames.

### 7. Dépendances épinglées

`esp32/platformio.ini` (`lib_deps`) et `pi/requirements.txt` : plages
compatibles (`^x.y.z` / `~=x.y`) sur les versions actuellement
utilisées/testées, au lieu d'aucune contrainte ou d'un simple `>=` ---
laisse passer les correctifs de sécurité, bloque une montée de version
majeure surprise. Recompilé sur les deux cibles ESP32 + tests natifs
relancés en local (16/16 passent) après le changement, aucune
régression.

### 8. Permissions CI minimales

`.github/workflows/esp32-build.yml` : `permissions: contents: read` au
niveau du workflow --- le `GITHUB_TOKEN` par défaut a des droits plus
larges dont ce workflow (compilation + tests uniquement) n'a jamais
besoin.

### 9. Retour vidéo dans l'interface de contrôle

`pi/rover_control/camera.py` : flux MJPEG (`multipart/x-mixed-replace`,
pas de WebRTC --- zéro dépendance de signalisation, s'affiche avec un
simple `<img>`) via `picamera2`. **Aucune caméra choisie pour Rover à ce
jour** (`BOM.md`) : `CameraStream` capture l'échec d'import/init dans un
`except Exception` large (assumé, commenté) et bascule `available =
False` sans jamais faire planter le reste du serveur --- même principe
"matériel optionnel" que les capteurs Phase 4, appliqué à une caméra.
Route `/video` protégée par le même token que tout le reste (point 6).
`index.html` affiche "Caméra indisponible" au lieu d'une image cassée
si le flux échoue à charger.

**Validé en conditions réelles** : `/video` avec bon token → `503
camera unavailable` (comportement gracieux exact attendu sur cette
machine de dev sans `picamera2`/caméra) au lieu d'un crash ou d'une
erreur 500.

### Validation d'ensemble

- Compilation `esp32_wroom`/`esp32_s3` vérifiée après chaque ajout, et
  une dernière fois après l'épinglage des dépendances.
- Tests natifs (16/16) relancés en local avec le compilateur
  fraîchement installé, sans régression.
- Flash réel sur ESP32 (COM10) : boot stable avec E-stop/batterie/OTA
  tous inertes par défaut (aucun capteur/bouton/réseau câblé), aucun
  crash, comportement identique à avant ces ajouts côté capteurs Phase 4
  (les 4 `ERROR sensor_timeout` toujours présents, normal).
- `rover_core` relancé en conditions réelles avec `--log-dir` : auth
  (403/200), WebSocket authentifié, vidéo indisponible gracieuse, et
  fichier de log peuplé, tous vérifiés par des requêtes réelles.

### Ce qui n'est PAS validé

- OTA jamais testée avec un vrai réseau WiFi (aucun configuré cette
  session).
- E-stop jamais testé avec un vrai bouton physique.
- Monitoring batterie jamais testé (désactivé par conception, en
  attente du diviseur de tension).
- Caméra jamais testée (aucune choisie/reçue).
- `picamera2` n'est même pas dans `requirements.txt` --- il ne
  s'installe et ne fonctionne que sur un vrai Raspberry Pi (dépend de
  `libcamera`), impossible à valider sur cette machine de dev Windows ;
  `camera.py` gère son absence proprement (`except Exception` sur
  l'import), donc `pi/` reste installable et fonctionnel partout ailleurs
  sans cette dépendance.

### État actuel

- Sécurité : authentification obligatoire sur tout le serveur de
  contrôle, aucun secret (WiFi/OTA/token) codé en dur nulle part dans le
  dépôt, dépendances épinglées, permissions CI minimales --- posture
  raisonnable pour un projet open source à ce stade de maturité.
- Robustesse : E-stop et monitoring batterie ajoutés sans dépendre du
  matériel correspondant (même discipline que la Phase 4).
- UI : validée visuellement en conditions réelles, flux vidéo prêt à
  l'emploi dès qu'une caméra existera.

### Prochaines étapes

- `picamera2` sur le vrai Raspberry Pi une fois disponible, pour
  valider `/video` avec une vraie caméra.
- Reste par ailleurs identique aux sessions précédentes : matériel
  (VL53L0X/borniers, moteurs/PID, servos, MPU6050/BME688), Raspberry Pi,
  OTA/E-stop/batterie sur matériel réel dès que possible.

------------------------------------------------------------------------

## Session du 2026-08-31 (suite 4) --- 5 nouvelles améliorations (tests Python, HTTPS, systemd, encodeur Wokwi, calibration PID)

### Contexte

Suite de la liste de propositions de la session précédente, les 5 dans
l'ordre demandé.

### 1. Tests automatisés Python (`pi/tests/`)

`pytest` (dev-only, `pi/requirements-dev.txt`, séparé du
`requirements.txt` du robot réel) : 25 tests couvrant `rover_esp32.
protocol` (mêmes valeurs de checksum vérifiées que côté C++, erreurs de
décodage), `RoverCore` (machine à états comportementale --- via un
`FakeLink` qui n'ouvre jamais de vrai port série, juste un
enregistreur d'appels `.send()`) et `rover_control.auth` (génération de
token, comparaison). Bug de sécurité trouvé et corrigé en écrivant les
tests : `token_matches("", "")` renvoyait `True` (deux chaînes vides
sont égales pour `hmac.compare_digest`) --- durci pour rejeter aussi un
`expected` vide, même si ce cas ne se produit pas en pratique
(`resolve_token()` ne renvoie jamais une chaîne vide). Les tests d'état
d'erreur avec délai (5 s réels) sont accélérés via `monkeypatch` sur la
constante du module plutôt que d'attendre pour de vrai. **25/25
passent** en local (premier run, sans itération nécessaire). Job CI
`python-tests` ajouté (`.github/workflows/esp32-build.yml`, renommé
"Rover CI", déclenché aussi sur `pi/**` désormais).

### 2. HTTPS/WSS

`--tls-cert`/`--tls-key` (CLI + `config.json`) : si les deux sont
fournis et existent, le serveur sert en HTTPS avec un
`ssl.SSLContext`, sinon HTTP classique. Refuse de démarrer si un seul
des deux est donné (jamais de repli silencieux en clair sur une
config à moitié faite). `index.html` bascule déjà tout seul en `wss://`
selon `location.protocol` (écrit dès le départ pour ça, aucun
changement JS nécessaire). Aucun certificat généré ni commis --- juste
la commande `openssl` documentée dans `pi/README.md` pour que
l'utilisateur en génère un lui-même.

**Validé en conditions réelles** : certificat auto-signé jetable généré
(`openssl req -x509 ...`, jamais commis), `rover_core` lancé avec
`--tls-cert`/`--tls-key` contre l'ESP32 réel --- `https://` avec le bon
token → 200, requête `http://` en clair sur le même port → aucune
réponse (pas de repli), log confirmant `listening on https://...`.

### 3. Service systemd

`pi/rover-core.service` (gabarit, chemins `/home/pi/...` à adapter) +
`pi/rover.env.example` --- le token/les secrets vivent dans
`pi/rover.env` (`EnvironmentFile=-`, jamais dans le fichier `.service`
commité). Documenté dans `pi/README.md`. **Non testable sur cette
machine** (Windows, pas de systemd) --- écrit par lecture attentive de
la syntaxe systemd standard, pas vérifié en conditions réelles.

### 4. Encodeur simulé dans Wokwi --- investigué, PAS implémenté

Recherche : Wokwi n'a pas de chip officiel "DC motor + encoder" ; il
existe des projets tiers avec un chip personnalisé écrit via l'API
Custom Chips C de Wokwi (chip.json + chip.c, même mécanisme que le
`board-st7789` communautaire déjà utilisé pour l'écran). Écrire un tel
chip depuis zéro (simulation PWM → vitesse → impulsions quadrature)
est un vrai mini-projet en C bas niveau, et **cette session n'a aucun
moyen de le tester** (`wokwi-cli` non installé sur cette machine
Windows, et même installé il faudrait un `WOKWI_CLI_TOKEN` absent ici).
Plutôt que de livrer du code de simulation non testé et potentiellement
buggé en le présentant comme fonctionnel, décision de **ne pas
l'écrire** cette session --- documenté dans `ARCHITECTURE_AND_ROADMAP.md`
(Phase 2) comme piste concrète pour une session future avec accès
Wokwi complet. La boucle PID continue de tourner en boucle ouverte en
simulation, comme avant.

### 5. Calibration PID sans reflash

`esp32/lib/calibration/CalibrationStore.h` : petite couche autour de
`Preferences` (NVS) pour lire/écrire des flottants nommés, avec repli
sur une valeur par défaut si rien n'est stocké --- jamais un blocage au
boot si la NVS est vide. `WheelPID` a maintenant des gains
d'instance modifiables (`setGains`/`kp()`/`ki()`/`kd()`) au lieu des
constantes globales `ROVER_PID_KP/KI/KD` codées en dur ; `DriveController`
expose `setPidGains()` appliqué aux deux roues (un seul jeu de gains,
pas par roue --- même moteur des deux côtés). Trois nouvelles actions
`SYSTEM` : `set_pid` (valide NaN/Inf/négatif → `ERROR
code=invalid_pid_gains`, sinon applique + persiste), `get_pid`,
`reset_pid` (revient aux valeurs compilées et efface la NVS). Documenté
dans `ROVER_PROTOCOL.md` §5.1 et §7.3.

**Validé en conditions réelles**, séquence complète sur l'ESP32 physique
(chaque étape = une vraie reconnexion série, donc un vrai reboot matériel,
pas juste un redémarrage logique) :
1. `get_pid` → gains par défaut (180.00/300.00/0.00).
2. `set_pid kp=222.50 ki=111.00 kd=5.00` → appliqué immédiatement.
3. **Reboot réel** → `get_pid` → toujours 222.50/111.00/5.00 ---
   persistance NVS confirmée à travers un vrai redémarrage matériel.
4. `set_pid kp=-1` → `ERROR code=invalid_pid_gains`, aucun crash.
5. `reset_pid` → retour à 180.00/300.00/0.00.
6. **Reboot réel** → `get_pid` → toujours 180.00/300.00/0.00 --- confirme
   que la NVS a bien été effacée, pas juste la valeur en mémoire.

### Validation d'ensemble

- Compilation `esp32_wroom`/`esp32_s3` vérifiée après les changements
  PID/calibration.
- Tests natifs C++ (16/16) et Python (25/25) rejoués une dernière fois
  ensemble après tous les changements de cette session --- aucune
  régression.
- Flash réel + séquence de test complète pour la calibration PID
  (ci-dessus) et pour HTTPS (auth + TLS combinés).

### État actuel

- 4 des 5 points livrés et validés en conditions réelles (tests Python,
  HTTPS, calibration PID) ou aussi bien que possible sur cette machine
  (systemd, écrit mais non testable ici, Linux uniquement).
- 1 point (encodeur Wokwi) explicitement non livré, avec la raison et
  la piste documentées plutôt que du code non testé présenté comme fait.

### Prochaines étapes

- Tester `pi/rover-core.service` sur un vrai Raspberry Pi.
- Reprendre l'encodeur simulé Wokwi si l'accès `wokwi-cli`/jeton devient
  disponible.
- Calibrer réellement les gains PID une fois les moteurs physiques
  reçus (l'outillage est prêt, pas les valeurs).
- Reste identique par ailleurs : matériel Phase 2/4, Raspberry Pi,
  caméra.

------------------------------------------------------------------------

## Session du 2026-08-31 (suite 5) --- 5 fonctionnalités de comportement/personnalité (buzzer, réflexe obstacle, sommeil, animations, MQTT)

### Contexte

Suite de la troisième liste de propositions de la session, les 5 dans
l'ordre. L'utilisateur a signalé avoir des buzzers disponibles pour le
point 1.

### 1. Buzzer (bip sonore, ESP32)

**Contrainte matérielle réelle découverte en préparant ce point** : plus
aucun GPIO totalement libre sur le WROOM (tout est pris par moteurs/
encodeurs/servos/écran/I2C/E-stop/batterie), et `WIRING.md` interdisait
explicitement `GPIO12` (risque de mauvaise sélection de tension flash
au boot). Question posée à l'utilisateur plutôt que de trancher seul
--- **GPIO12 retenu**, règle assouplie explicitement dans `WIRING.md`
avec l'avertissement correspondant.

`esp32/lib/sound/Buzzer.h` : lecture non-bloquante (`tone()`/`noTone()`,
avancée via `millis()` dans `update()`, jamais de `delay()`) d'un motif
de bips court par événement (`BOOT`, `OBSTACLE`, `LOW_BATTERY`,
`ESTOP`) --- fonctionne avec un buzzer passif (fréquence respectée) ou
actif (ignore la fréquence, suit juste le rythme on/off). Câblé au
boot, à l'E-stop, à la batterie faible et à l'obstacle détecté.

**Validé sur ESP32 réel** : boot stable avec GPIO12 piloté par le
firmware (aucune corruption observée), buzzer pas encore physiquement
branché par l'utilisateur au moment du test --- son audible à confirmer
une fois câblé.

### 2. Réflexe d'arrêt automatique sur obstacle (Pi)

Décision de conception : plutôt que de s'appuyer sur l'`EVENT
obstacle_detected` (un déclenchement ponctuel, sans `EVENT` de
"dégagé" côté firmware), `RoverCore.move()` réévalue à chaque appel la
distance `STATE` la plus récente (`last_state`, même seuil 150mm que
l'ESP32 et l'UI) : une vitesse **positive** demandée alors qu'un
obstacle est proche est ramenée à 0, la marche arrière et la rotation
sur place restent libres. Un garde-fou simple, pas de la navigation ---
le Pi ne décide toujours de rien de plus que "ne fonce pas dedans".

**Validé par tests** (`pi/tests/test_core.py`) : avancer bloqué,
reculer/tourner autorisés, débloqué dès que la distance repasse au-delà
du seuil.

### 3. Comportement "sommeil" en cas d'inactivité (Pi)

`RoverCore` déclenche `FACE emotion=sleepy` après `IDLE_SLEEPY_DELAY_S`
(120s) sans client connecté, armé dès la construction (état initial
IDLE) et à chaque retour à IDLE ; annulé et remplacé par `FACE
emotion=idle` (réveil) dès qu'on quitte IDLE, quelle que soit la
destination. Réutilise le mécanisme générique de `_set_state` déjà en
place.

**Validé par tests** (délai raccourci via `monkeypatch`) et **en
conditions réelles** contre l'ESP32 : `FACE emotion=idle` bien reçu
lors d'une transition hors IDLE (observé jusque dans un cas limite ---
une `ERROR` de capteur arrivant avant que le client ait fini de se
connecter, la garde `state not in (MOVING, ERROR)` a fonctionné comme
prévu).

### 4. Bibliothèque d'animations élargie (ESP32)

Deux nouvelles animations en plus de `GLITCH`, réutilisant uniquement
les champs déjà existants d'`EyeState` (direction du regard, ouverture)
--- aucun changement de structure : `LOOK_AROUND` (balayage sinusoïdal
gauche-droite-centre sur 1,2s) et `WAKE_UP` (pic d'ouverture large qui
redescend vers le profil normal sur 0,6s), en couche par-dessus
l'émotion active, même principe de superposition que `GLITCH` pour
`glitchIntensity`.

**Validé sur ESP32 réel** : dispatch accepté sans crash
(`ANIMATION name=LOOK_AROUND`, `ANIMATION name=WAKE_UP`), `diag` de
suivi confirmant `free_heap`/`uptime` stables. Rendu visuel non
re-vérifié à l'œil cette fois (déjà fait pour le mécanisme de base en
session précédente via `claude-in-chrome` -- pas repris ici faute de
changement du rendu écran lui-même, seulement de nouvelles trajectoires
d'yeux).

### 5. Publication MQTT minimale (Pi)

`pi/rover_mqtt/publisher.py` : instantané périodique (état
comportemental + toute la télémétrie connue) publié sur
`<préfixe>/state`, `retain=True`. Double option : dépendance
(`paho-mqtt`, extra séparé `requirements-mqtt.txt`, pas dans les
dépendances de base) et fonctionnalité (aucun host configuré = jamais
importé). Un avertissement de dépréciation de l'API paho-mqtt 2.x
détecté et corrigé immédiatement (`CallbackAPIVersion.VERSION2`
explicite) plutôt que laissé trainer.

**Validé par tests** (5 tests : sans host, sans `paho-mqtt` installé
--- simulé via un monkeypatch d'`__import__` --- broker injoignable
avec un vrai port refusé, `publish_state`/`close` sans connexion). Pas
de vrai broker MQTT disponible pour un test de bout en bout avec
publication réelle cette session.

### Validation d'ensemble

- Compilation `esp32_wroom`/`esp32_s3` vérifiée après buzzer et
  animations.
- Tests natifs C++ (16/16) et Python (36/36, +11 depuis la session
  précédente) rejoués ensemble à la fin --- aucune régression.
- CI mise à jour pour installer `requirements-mqtt.txt` en plus de
  `requirements-dev.txt`, afin que le test MQTT "broker injoignable"
  exerce le vrai chemin de connexion `paho-mqtt`, pas seulement le
  chemin "bibliothèque absente".

### État actuel

- Les 5 points sont livrés et validés (tests automatisés et/ou matériel
  réel selon ce qui était testable). Seul le son audible du buzzer et
  la publication MQTT de bout en bout vers un vrai broker restent à
  confirmer par l'utilisateur (dépendent respectivement du câblage
  physique et d'un broker MQTT/Home Assistant réel, ni l'un ni l'autre
  disponibles dans cette session).

### Prochaines étapes

- Confirmer le son du buzzer une fois câblé sur GPIO12.
- Tester la publication MQTT contre un vrai broker (Mosquitto ou
  l'add-on Home Assistant) une fois disponible.
- Reste identique par ailleurs : matériel Phase 2/4, Raspberry Pi,
  caméra, encodeur Wokwi, systemd sur Pi réel.

------------------------------------------------------------------------

## Session du 2026-08-31 (suite 6) --- Commandes HEAD dans l'interface (suite de roadmap)

### Contexte

Demande de l'utilisateur : continuer le code en suivant la roadmap.
En relisant la Phase 6, la case "Commandes HEAD" était encore décochée
avec la justification "pas de cible : Phase 3 --- servos tête --- pas
encore écrite côté ESP32" --- **cette justification est obsolète**, la
Phase 3 est terminée depuis plusieurs sessions (`HeadController` existe
et fonctionne). C'était donc du travail concret et prêt à faire, pas
une proposition à choisir : branché directement.

### Ce qui a été fait

- `pi/rover_core/core.py` : `RoverCore.look(pitch_deg, yaw_deg)` --
  simple relais vers `HEAD pitch=... yaw=...`, sans aucune logique de
  machine à états (contrairement à `move()`) puisque regarder autour de
  soi n'a pas d'implication de sécurité physique, et que l'ESP32 gate
  déjà lui-même sur `ACTIVE` (`main.cpp`).
- `pi/rover_control/server.py` : le message WebSocket entrant accepte
  désormais des champs optionnels `head_pitch`/`head_yaw` en plus de
  `velocity`/`rotation` --- absents, rien ne bouge côté tête (un client
  plus ancien ou volontairement "déplacement seul" continue de
  fonctionner sans modification).
- `index.html` : un second pad tactile (orange, coin opposé à la vidéo)
  pour le regard, plus le stick droit d'une manette si branchée
  (convention gauche=déplacement/droite=regard). Bornes alignées sur
  `head_config.h` (`±30°` pitch, `±90°` yaw) --- l'ESP32 re-clampe de
  toute façon. Relâcher le pad ramène le regard au centre (0,0).

**Validé de bout en bout en conditions réelles** : client WebSocket
authentifié connecté contre l'ESP32 physique, message
`{velocity:0, rotation:0, head_pitch:15, head_yaw:-20}` envoyé --- log
du lien série confirmant `-> HEAD pitch=15.0 yaw=-20.0` réellement
écrit sur le port. Un test unitaire ajouté (`RoverCore.look()` ne
touche pas la machine à états, contrairement à `move()`). **37/37**
tests Python passent après ajout.

### Ce qui n'est PAS validé

- Pas testé au doigt sur un vrai téléphone ni avec une vraie manette
  branchée (même limite déjà connue pour le joystick de déplacement).
- Rendu du mouvement de tête lui-même non re-vérifié (déjà validé côté
  ESP32 en Phase 3), seul le chemin de bout en bout côté Pi est
  nouveau ici.

### État actuel

- Phase 6 : "Commandes HEAD" coché. Reste ouvert dans cette phase :
  accès distant sécurisé (VPN).

### Prochaines étapes

- Reste identique aux sessions précédentes (matériel, Raspberry Pi
  réel, caméra, MQTT contre un vrai broker, buzzer audible).
- VPN (Phase 6) serait la prochaine pièce manquante de cette phase si
  on continue dans cet ordre.

------------------------------------------------------------------------

## Session du 2026-08-31 (suite 7) --- Phase 6 terminée (VPN)

### Contexte

Demande de l'utilisateur : "fini la Phase 6". État avant cette session :
tout coché sauf Caméra (matériel non choisi/reçu, rien à coder --- pas
"terminable" sans achat) et Accès distant sécurisé (VPN).

### VPN (WireGuard, auto-hébergé)

`pi/VPN.md` : guide complet --- pourquoi WireGuard (léger, dans le noyau
Linux, auto-hébergé donc aucune donnée ne transite par un tiers,
cohérent avec l'exigence "pas de fuite de données" du projet), comment
ça s'intègre à l'existant (**aucun changement dans `rover_core`/
`rover_control`** : une fois connecté au VPN, un appareil distant
obtient une IP dans le tunnel et joint le Pi comme s'il était sur le
LAN ; le token d'accès reste obligatoire en plus --- défense en
profondeur, pas un remplacement), installation pas à pas, et notes de
sécurité (une paire de clés par appareil, révocation en supprimant un
bloc `[Peer]`, `AllowedIPs` restreint au sous-réseau du tunnel plutôt
que `0.0.0.0/0`).

`pi/wireguard/wg0.example.conf` (serveur, Pi) et `client.example.conf`
(client distant) : templates commités avec des valeurs placeholder
explicites, jamais de vraie clé générée --- même principe que les
certificats TLS et les identifiants OTA des sessions précédentes.
`.gitignore` mis à jour (`wg0.conf`/`client.conf` réels ignorés,
seuls les `.example.conf` suivis).

Mention de Tailscale comme alternative plus simple (pas de
port-forwarding manuel) pour qui préfère la simplicité à
l'auto-hébergement complet --- non retenu par défaut pour rester
cohérent avec l'exigence de contrôle total des données.

Au passage, corrigé une note obsolète dans `ARCHITECTURE_AND_ROADMAP.md`
qui disait encore "pas de chiffrement TLS" alors que le support
HTTPS/WSS existe depuis la session précédente.

### Ce qui n'est PAS validé

**Rien de testable en conditions réelles cette session** : ni Raspberry
Pi physique, ni routeur/box pour la redirection de port UDP, ni
appareil client réel pour se connecter au tunnel. Documentation et
templates de configuration uniquement --- syntaxe WireGuard standard et
stable, mais jamais exécutée ni vérifiée par cette session.

### État actuel

- **Phase 6 terminée au niveau logiciel/documentation**, à l'exception
  de la Caméra (matériel non disponible, hors du périmètre "code").
  VPN écrit mais non testé (pas de matériel), même statut que le
  service systemd d'une session précédente.

### Prochaines étapes

- Tester le VPN une fois le Raspberry Pi et l'accès au routeur
  disponibles.
- Reste identique par ailleurs : matériel Phase 2/4, caméra, MQTT
  contre un vrai broker, buzzer audible, systemd sur Pi réel.

------------------------------------------------------------------------

## Session du 2026-09-01 --- Premier bring-up moteurs/encodeurs réels (Phase 2) --- instabilité alimentation non résolue

### Contexte

Châssis imprimé et pièces reçues (VL53L0X/borniers, moteurs N20+DRV8833)
--- déblocage du point bloquant documenté en mémoire depuis le
2026-08-31. Décision utilisateur : commencer par moteurs + PID plutôt
que les capteurs de distance. Session menée entièrement en interactif
(câblage réel par l'utilisateur, guidé pas à pas), pas de nouveau code
firmware écrit --- uniquement du bring-up matériel et deux petits
scripts de test ajoutés côté outillage.

### Outillage ajouté

- `pi/tools/motor_test.py` : console interactive (`cmd.Cmd`) pour piloter
  `MOVE`/`SYSTEM set_pid`/`get_pid`/`resume` en direct sur le port série
  réel, avec heartbeat automatique en tâche de fond. Prévu pour un usage
  humain au clavier (pas utilisé directement cette session --- les
  outils de l'assistant ne peuvent pas piloter un terminal interactif),
  mais reste l'outil de référence pour la suite.
- Scripts de test à séquence fixe (non commités, scratch) utilisés pour
  cette session : ping/diag seul, et un cycle `resume` + `HEARTBEAT` en
  boucle + `MOVE` 3s + `stop` + `diag`, avec capture de toutes les
  trames reçues.

### Bugs matériels réels trouvés et corrigés

1. **`SLEEP` du DRV8833 non câblé = driver totalement désactivé.**
   0 A consommé, aucun moteur ne répond à `IN1-4` quel que soit le
   contenu de la trame `MOVE`. Confirmé par mesure directe (6V présents
   sur `VCC`/`GND` du driver, 0V sur `SLEEP`). Corrigé en reliant
   `SLEEP` au 3V3 de l'ESP32 --- déjà documenté comme le câblage prévu
   dans `WIRING.md`, mais le risque concret (driver mort si oublié)
   n'était pas explicite avant ; renforcé dans `WIRING.md` maintenant.

2. **Encodeurs totalement muets (0 tick) malgré des moteurs qui
   tournent physiquement.** VCC (blanc → 3V3) et GND (bleu) de
   l'encodeur vérifiés corrects au multimètre, signal (jaune/vert) sur
   les bonnes broches (GPIO34/35 gauche, GPIO36=`VP`/GPIO39=`VN` droite
   --- silkscreen différent du numéro GPIO sur ce devkit 30 broches,
   piège documenté maintenant dans `WIRING.md`). Cause retenue :
   GPIO34-39 sont entrée seule sans pull interne sur l'ESP32, et la
   carte encodeur de ce moteur est probablement en sortie collecteur
   ouvert. **Corrigé en ajoutant une résistance 10kΩ entre chaque fil de
   signal (jaune, vert, sur les deux moteurs) et le 3V3** --- 4
   résistances au total, en parallèle du fil existant vers le GPIO.
   Confirmé : les deux encodeurs comptent des ticks après ce correctif.

3. **Premier board DRV8833 : canal B (IN3/IN4→OUT3/OUT4) défaillant.**
   Le moteur droit tournait à peine (~50x plus lent que le gauche en
   télémétrie, confirmé visuellement). Isolé par élimination : (a) le
   moteur/câble droit fonctionnent bien une fois branchés sur OUT1/OUT2
   (le canal qui marche), (b) le firmware est parfaitement symétrique
   entre les deux canaux (`MotorDriver`/`DriveController` génériques,
   seuls les numéros de pin changent), (c) échanger quel moteur est
   câblé sur quel canal a fait "suivre" la lenteur au canal, pas au
   moteur --- **la lenteur suit le canal B, peu importe le moteur
   branché dessus**. Mesure finale au multimètre pendant un `MOVE`
   actif : `OUT1`=4.5V/`OUT2`=2V (canal A, cohérent avec une PWM avant
   normale) contre `OUT3`=0.1V/`OUT4`=5.5V (canal B, inversé et anormal
   --- `OUT4` presque au max alors qu'il ne devrait pas être piloté dans
   ce sens). Conclusion : jambe de pont en H endommagée sur ce board
   précis, probablement pendant la période où `SLEEP` a tourné flottant
   (bug #1 ci-dessus). **Remplacé par un second board DRV8833** que
   l'utilisateur avait en réserve --- les deux canaux sont redevenus
   comparables en vitesse après remplacement (télémétrie ~0.5-0.9 des
   deux côtés, contre 25-30 vs 0.5 avant).

### Problème non résolu en fin de session : instabilité ESP32 sous charge moteur

Avec le second board DRV8833 en place (tout le câblage vérifié bon un
par un : GND seul, +IN1/IN2, +IN3/IN4, +SLEEP, chaque étape testée
stable au repos), l'ESP32 **redémarre en boucle** (`POWERON_RESET`
répétés) dès qu'une commande `MOVE` réelle fait commuter le driver sous
charge réelle (VCC 6V actif + PWM effectif) --- pas seulement au repos
avec `SLEEP` câblé. Isolation faite cette session :

- **6V seul (VCC/GND driver, sans aucun fil de commande vers l'ESP32)**
  : stable. Le 6V en lui-même, avec une masse commune correcte, n'est
  pas le problème.
- **6V + IN1-4 (sans `SLEEP`)** : stable.
- **6V + IN1-4 + `SLEEP`** : un sursaut de redémarrages au moment de la
  connexion, puis stabilisation --- `ping`/`diag` fonctionnent
  normalement ensuite tant qu'aucun `MOVE` n'est envoyé.
- **6V + câblage complet + `MOVE` réel (PWM sous charge)** : redémarre
  en boucle de façon persistante, ne se stabilise pas tout seul cette
  fois.

Un condensateur électrolytique 470µF (+ vers `VCC`, − vers `GND`,
polarité vérifiée correcte, ni chaud ni gonflé) a été essayé sur
l'alimentation du driver dans l'espoir de stabiliser la tension --- **a
semblé aggraver le problème sur le moment, mais retirer le condensateur
n'a pas fait revenir la stabilité non plus**, donc le condensateur
n'est probablement pas la cause réelle, juste une coïncidence de timing
avec une manipulation de câblage qui a dégradé un contact. Retiré par
prudence.

Hypothèse retenue (non vérifiée faute d'oscilloscope) : la masse
commune entre le domaine batterie/driver (6V) et le domaine
ESP32/USB/PC n'est pas assez robuste sur cette breadboard pour absorber
les pics de courant de commutation PWM sans perturber transitoirement
l'alimentation logique de l'ESP32 (brownout). Un phénomène apparenté a
aussi été observé côté encodeur gauche dans le même test : la
télémétrie continuait de rapporter des vitesses non nulles alors que le
moteur gauche s'était arrêté net après un quart de tour (silencieux,
axe libre à la main --- pas un blocage mécanique) --- hypothèse : du
bruit de commutation capté par le fil de signal non blindé fait croire
au PID que la roue va déjà trop vite, qui coupe la puissance en
conséquence. Piste proposée mais pas testée : écarter physiquement les
fils de signal encodeur des fils de puissance moteur sur la breadboard.

### Ce qui n'est PAS validé

- Aucune commande `MOVE` n'a pu tourner de façon stable et prolongée
  sur le second board --- la boucle fermée PID sur matériel réel reste
  donc à confirmer une fois l'instabilité résolue.
- La calibration des gains PID et de `ROVER_ENCODER_TICKS_PER_REV`/
  `ROVER_WHEEL_DIAMETER_M` (`motion_config.h`) n'a pas pu être abordée
  --- les valeurs de vitesse observées avant l'instabilité (25-30 avec
  le premier board, 0.5-0.9 avec le second) ne sont pas physiquement
  plausibles avec les constantes placeholder actuelles, à recalibrer
  une fois le mouvement stable.
- Servos tête, VL53L0X, MPU6050, BME688 : toujours non câblés, hors
  périmètre de cette session.

### État actuel

- **Phase 2 (moteurs/PID)** : premier bring-up matériel réel commencé.
  Trois bugs matériels réels trouvés et corrigés (SLEEP non câblé,
  encodeurs sans pull-up, board DRV8833 n°1 avec canal B défaillant).
  Un problème d'instabilité sous charge **reste ouvert et bloque tout
  test `MOVE` prolongé** --- pas encore de mouvement fiable sur robot
  physique, ni de calibration PID.
- `esp32/WIRING.md` mis à jour avec le code couleur moteur→encodeur
  confirmé (VCC/GND vérifiés au multimètre), la nécessité des pull-up
  externes 10kΩ, l'avertissement `SLEEP` renforcé, et le nommage
  `VP`/`VN` du devkit pour GPIO36/39.

### Prochaines étapes

1. **Résoudre l'instabilité sous charge** avant toute autre chose sur
   Phase 2 --- pistes : masse en étoile/fils de masse plus épais entre
   domaine batterie et domaine ESP32, oscilloscope si disponible pour
   voir la forme d'onde réelle sur `VCC`/`GND` pendant un `MOVE`, ou
   passage à un câblage soudé (moins de points de contact marginal
   qu'une breadboard) au moins pour l'alimentation et `SLEEP`.
2. Une fois stable : écarter/reblinder les fils encodeur gauche pour
   vérifier l'hypothèse de bruit PWM, puis calibrer PID et géométrie
   roue contre le matériel réel.
3. Reste identique par ailleurs : servos tête, VL53L0X/MPU6050/BME688,
   Raspberry Pi, caméra, MQTT contre un vrai broker.

------------------------------------------------------------------------

## Session du 2026-09-01 (suite) --- Chasse à l'instabilité sous charge --- PAUSE, session interrompue en plein diagnostic

### Contexte

Suite directe de la session précédente le même jour : l'ESP32
redémarrait en boucle (`POWERON_RESET` répétés) dès qu'une commande
`MOVE` faisait vraiment commuter le second board DRV8833 sous charge.
Demande explicite de l'utilisateur : "on continue, on résout ce
problème" --- session longue, très itérative, entièrement du
diagnostic matériel guidé à distance (mesures multimètre faites par
l'utilisateur, tests relancés par l'assistant). **Interrompue par
l'utilisateur en cours de diagnostic** ("on tourne en rond ... je fais
une pause"), avec consigne explicite de tout noter pour reprendre
facilement à un niveau d'effort plus élevé (ou sur Opus) la prochaine
fois. Ce qui suit est donc un état intermédiaire, pas une conclusion.

### Résultats fermes de cette session (à considérer comme acquis)

1. **Le câble USB de l'ESP32 était défectueux** --- contact
   intermittent, cause probable d'une bonne partie de l'instabilité
   chassée pendant des heures. Remplacé par un second câble : boot
   parfaitement stable au repos (0 reset sur 6s de test passif,
   confirmé plusieurs fois), alors qu'avec l'ancien câble le même test
   montrait 1 à 5 redémarrages selon les essais. **Toujours vérifier le
   câble USB en premier** si un ESP32 redémarre de façon erratique sans
   raison électrique évidente.
2. **La télémétrie encodeur (pull-up 10kΩ, voir session précédente)
   est fiable une fois le câblage électriquement sain** --- plusieurs
   fois cette session, `left_speed`/`right_speed` ont correspondu
   exactement à ce que l'utilisateur observait à l'œil (moteur immobile
   → 0, moteur qui tourne fort → valeur élevée et stable). Quand ça ne
   correspond pas (télémétrie non nulle mais moteur immobile, ou
   l'inverse), c'est un signal fiable qu'il y a un vrai problème
   électrique ailleurs (bruit, mauvais contact) --- ne pas l'ignorer.
3. **Un condensateur céramique 100nF (marquage "104") + un fil de masse
   dédié court entre `GND` du driver et `GND` de l'ESP32** ont
   complètement stabilisé le boot **au repos**, mais **pas sous
   charge** (`MOVE` actif) --- ajouter ensuite un électrolytique 470µF
   en parallèle n'a pas amélioré la situation sous charge. Cette
   combinaison reste une bonne pratique de découplage à garder, mais ne
   suffit pas seule à expliquer/résoudre l'instabilité sous charge
   observée ce soir-là (qui s'est révélée être en bonne partie le câble
   USB, cf. point 1).
4. **Deux boards DRV8833 différents ont chacun montré un canal
   électriquement faible/mort**, sur des canaux différents :
   - Board 1 (le tout premier utilisé) : canal B (`IN3`/`IN4`→
     `OUT3`/`OUT4`) mort --- `OUT3`≈0.1V / `OUT4`≈5.5V mesurés pendant
     un `MOVE` actif (anormal, `OUT4` ne devrait pas être proche du
     max). Son canal A (`IN1`/`IN2`→`OUT1`/`OUT2`) fonctionnait très
     bien (télémétrie ~25-30 en continu, cohérent avec l'observation
     visuelle).
   - Board 2 (le remplaçant) : canal A faible (pas mort, mais très en
     dessous du canal B du même board --- ~0.5-0.56 contre ~23 en
     télémétrie, confirmé par observation visuelle à plusieurs
     reprises). Continuité GPIO27→`IN1` et GPIO26→`IN2` vérifiée bonne
     (0 ohm) --- donc pas un fil coupé, plutôt un souci interne au
     board (silicium ou pastille de soudure) ou un phénomène pas
     encore identifié.
   - Dans les deux cas, un test d'échange (le moteur/câble qui
     fonctionne bien sur un canal reste faible/mort une fois déplacé
     sur l'autre canal, et vice versa) a confirmé que le défaut suit le
     **canal**, pas le moteur ni le câble.
5. **Solution testée : utiliser les deux boards en même temps**, chacun
   sur son canal qui fonctionne (board 1 canal A → moteur gauche,
   board 2 canal B → moteur droit, câblage détaillé donné à
   l'utilisateur, aucun changement de firmware nécessaire --- les GPIO
   gardent les mêmes rôles). **N'a PAS donné le résultat espéré** : une
   fois les deux boards branchés ensemble (VCC/GND partagés), les deux
   canaux qui fonctionnaient très bien individuellement (~25-30 et ~23)
   se sont retrouvés tous les deux dégradés (gauche totalement mort à
   0, droit tombé à ~0.6-0.9) --- voir hypothèses ci-dessous.

### Point où le diagnostic s'est arrêté (à reprendre ici)

Avec les deux boards branchés ensemble :
- `SLEEP` du board 1 vérifié correct (~3.3V).
- `VCC` vérifié à 6V sur **les deux** boards pendant un `MOVE` actif
  (donc pas un problème évident d'alimentation insuffisante au niveau
  tension, même si la capacité en courant sous charge combinée n'a pas
  été mesurée directement).
- Mesure `OUT1`/`OUT2` du board 1 (canal gauche, censé être le "bon"
  canal de ce board) pendant un `MOVE` actif : **`OUT1`=4.95V,
  `OUT2`=6.2V** --- `OUT2` est **plus haut que `VCC` lui-même**, ce qui
  est électriquement impossible pour une sortie de pont en H saine.
  C'est la dernière mesure prise avant la pause.

**Hypothèses non tranchées pour cette dernière anomalie** (à
investiguer en premier à la reprise) :
1. Le board 1, dont le canal A fonctionnait très bien plus tôt dans la
   soirée, s'est peut-être dégradé/endommagé pendant toute la
   manipulation de ce soir (débranchements répétés, ou dommage
   électrique à un moment donné) --- comme pour le canal B du même
   board découvert mort plus tôt.
2. Le fait de partager `VCC`/`GND` entre deux boards distincts sur une
   breadboard déjà fatiguée (beaucoup de points de contact utilisés/
   réutilisés ce soir) pourrait fausser la référence de masse locale et
   donner une lecture au multimètre qui n'est pas la vraie tension de
   sortie du board --- un artefact de mesure plutôt qu'un vrai défaut.
3. Distinguer les deux : **retester le board 1 tout seul**, sans le
   board 2 branché du tout (débrancher entièrement `VCC`/`GND`/`IN3`/
   `IN4`/`SLEEP`/`OUT3`/`OUT4` du board 2), exactement comme la toute
   première configuration qui fonctionnait bien ce soir. C'est
   l'instruction donnée à l'utilisateur juste avant la pause --- non
   exécutée, à faire en premier à la reprise. L'utilisateur a dit
   vouloir remettre "une seule board comme avant" pendant la pause,
   donc ce test aura peut-être déjà una réponse partielle à la reprise
   de session (vérifier ce que l'utilisateur a effectivement fait entre
   les deux sessions avant de repartir sur les hypothèses ci-dessus).

### Autres pistes explorées et écartées cette session (ne pas les rejouer sans nouvelle info)

- Réglage de courant/mode CC de l'alim de labo : l'alim reste en mode
  CV (pas de limitation de courant active) pendant les tests, donc pas
  la cause de l'instabilité sous charge chassée ce soir.
- Vitesse cible plus faible (`velocity=0.02` au lieu de 0.15) pour
  réduire l'appel de courant au démarrage moteur : n'a rien changé au
  comportement de reset --- écarte l'hypothèse "pic de courant au
  démarrage moteur" comme cause de cette instabilité précise (mais
  cette hypothèse a été testée **avant** la découverte du câble USB
  défectueux, donc en présence d'un facteur confondant --- à retester
  si un nouveau souci d'instabilité apparaît une fois le câble USB
  écarté).
- Reconstruction complète du câblage sur une zone neuve de breadboard :
  n'a paradoxalement rien amélioré sur le moment (fait avant la
  découverte du câble USB) --- l'usure de la breadboard n'était donc
  pas la cause principale de cette instabilité-là, même si plusieurs
  connexions individuelles se sont bel et bien révélées mauvaises
  pendant la soirée (`VCC` mesuré une fois à 4.09V-4.5V au lieu de 6V
  sur le second board, jamais totalement élucidé s'il s'agissait d'un
  mauvais contact isolé ou de quelque chose de plus systématique ---
  autre point à vérifier en premier à la reprise avec un multimètre
  posé en continu sur `VCC` pendant qu'on manipule le câblage, plutôt
  qu'une mesure ponctuelle).

### Outillage ajouté

`pi/tools/move_diagnostic.py` (nouveau, committé) : consolide les
scripts de test à séquence fixe utilisés en boucle toute la session
(`--move` pour piloter `HEARTBEAT`+`resume`+`MOVE` pendant une durée
donnée, sans `--move` pour un test d'écoute passive) --- utile pour
détecter un redémarrage en boucle sans avoir à relire le flux série brut
(compte le nombre de trames `SYSTEM ... state=BOOT` reçues). Remplace
les scripts ad hoc utilisés cette session (non committés, scratch).
Usage : `python -m tools.move_diagnostic --port COM10` (écoute 6s) ou
`python -m tools.move_diagnostic --port COM10 --move --duration 10`
(pilote un `MOVE` pendant 10s, laisse le temps de mesurer au
multimètre).

### État actuel

- **Phase 2 (moteurs/PID) : toujours pas de mouvement fiable et
  prolongé obtenu sur les deux moteurs simultanément.** Progrès réels
  cette session (câble USB, découplage driver, méthode de diagnostic
  par élimination bien rodée) mais le problème de fond (un canal faible
  par board DRV8833, aggravé plutôt qu'amélioré en combinant deux
  boards) n'est pas résolu.
- L'utilisateur a explicitement demandé une pause et va remettre un
  câblage à un seul board pendant celle-ci --- **vérifier l'état
  physique du câblage en tout début de prochaine session avant de
  supposer quoi que ce soit** (ne pas repartir des hypothèses ci-dessus
  sans confirmer d'abord ce qui est réellement branché).

### Prochaines étapes (dans l'ordre recommandé)

1. Confirmer l'état du câblage actuel (combien de boards branchés,
   lequel/lesquels) avant toute nouvelle hypothèse.
2. Si un seul board est en place : `python -m tools.move_diagnostic
   --port COM10` (repos) puis `--move` (charge), comparer au dernier
   résultat connu pour ce board/canal.
3. Si le comportement diffère de ce qui est documenté ci-dessus pour ce
   board, repartir de zéro sur le diagnostic plutôt que de supposer que
   les causes de ce soir s'appliquent encore.
4. Envisager, si la fragilité de la breadboard reste suspectée : souder
   au moins les connexions `VCC`/`GND`/`SLEEP` du driver (celles qui
   ont posé problème le plus souvent ce soir) plutôt que de continuer
   sur breadboard pure pour ces points précis.
5. Si un multimètre à enregistrement ou un oscilloscope devient
   disponible, il permettrait de voir la vraie forme d'onde
   `VCC`/`OUT1-4` pendant un `MOVE`, ce qu'un multimètre ponctuel ne
   peut pas montrer (utile vu l'anomalie `OUT2`>`VCC` jamais élucidée).
6. Reste identique par ailleurs : servos tête, VL53L0X/MPU6050/BME688,
   Raspberry Pi, caméra, MQTT contre un vrai broker.
