RaphaelGrj/Rover-Project/pcb/rover_logique/apercu_3d.png

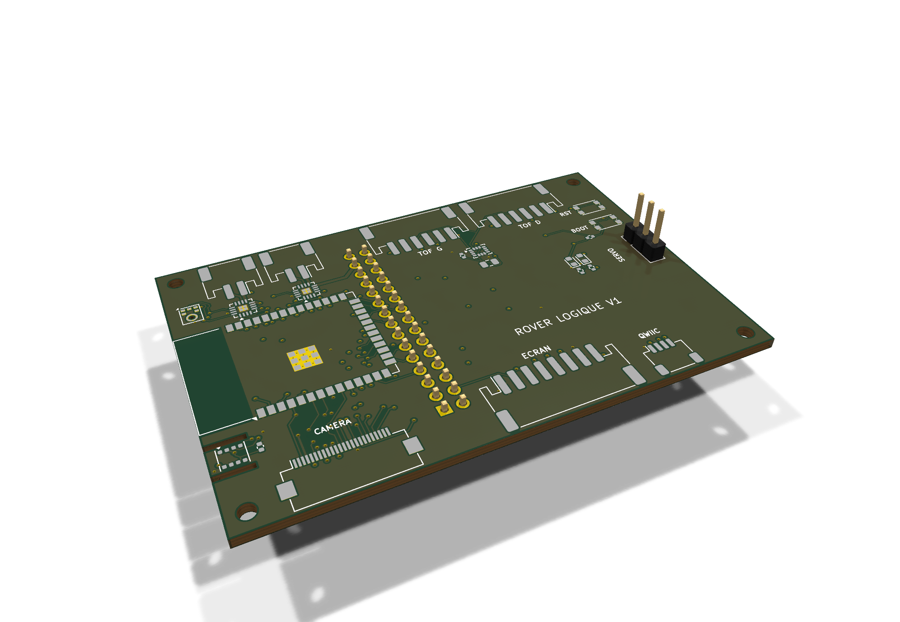
pcb/rover_logique/apercu_3d.png
