RaphaelGrj/Rover-Project/pcb/rover_logique/apercu_bottom.png

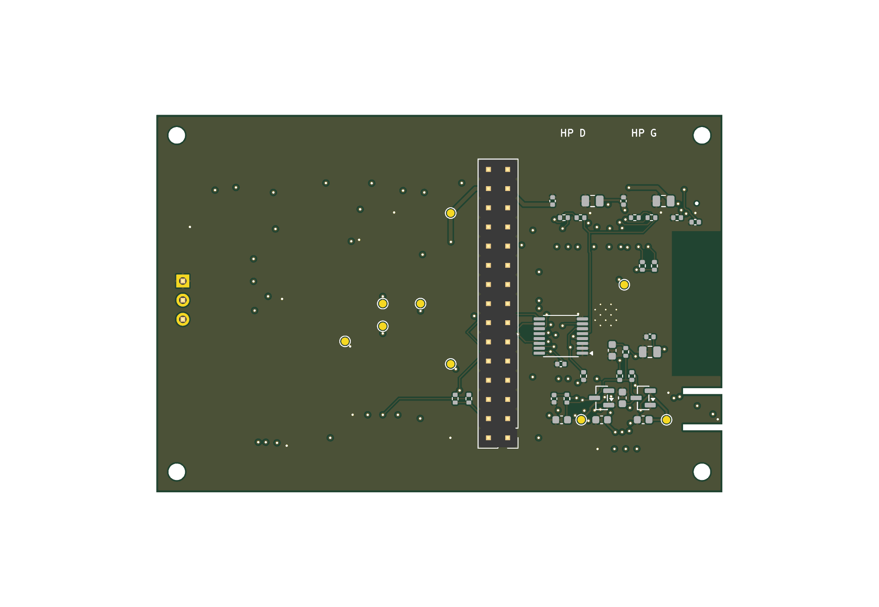
pcb/rover_logique/apercu_bottom.png
