RaphaelGrj/Rover-Project/pcb/rover_logique/apercu_top.png

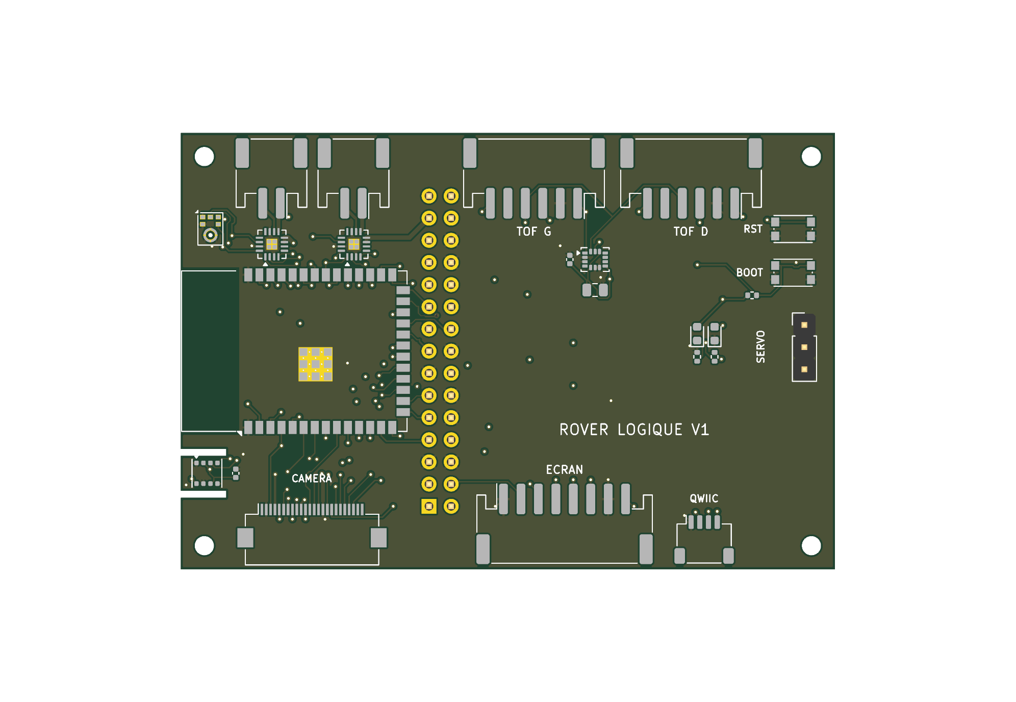
pcb/rover_logique/apercu_top.png
