RaphaelGrj/Rover-Project/pcb/rover_puissance/apercu_3d.png

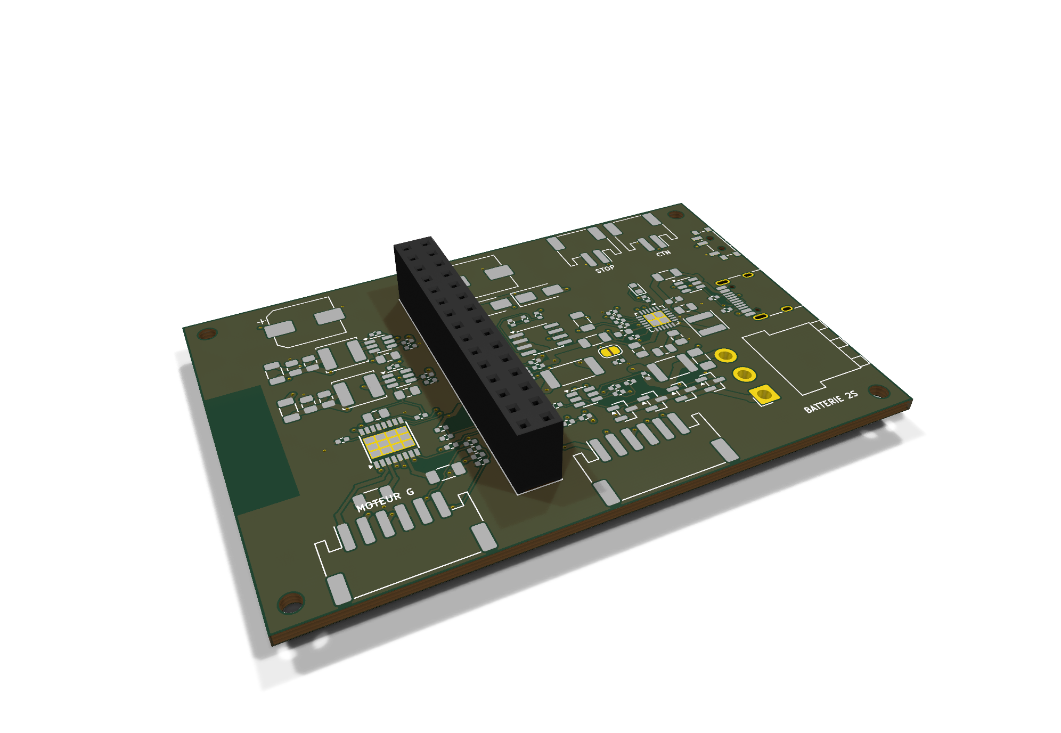
pcb/rover_puissance/apercu_3d.png
