RaphaelGrj/Rover-Project/pcb/rover_puissance/apercu_bottom.png

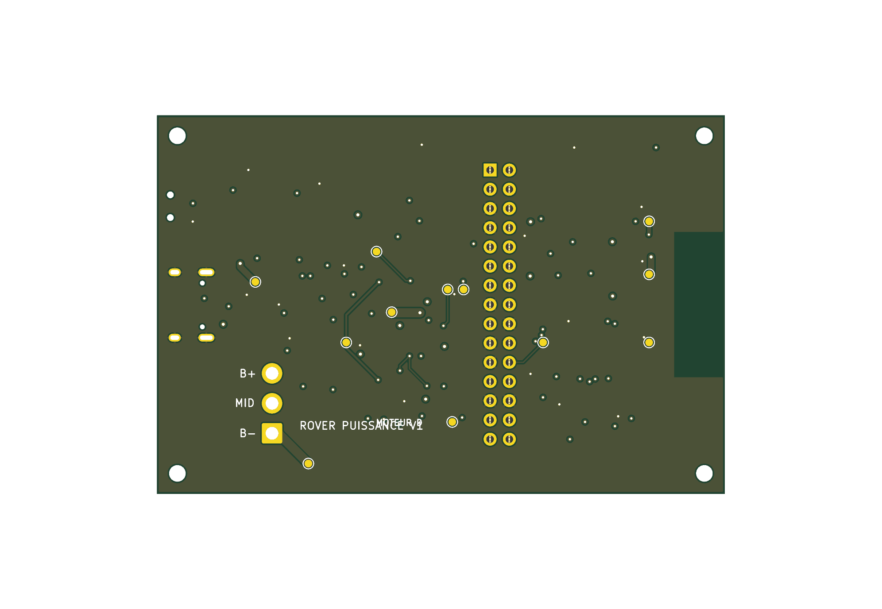
pcb/rover_puissance/apercu_bottom.png
