RaphaelGrj/Rover-Project/pcb/rover_puissance/apercu_top.png

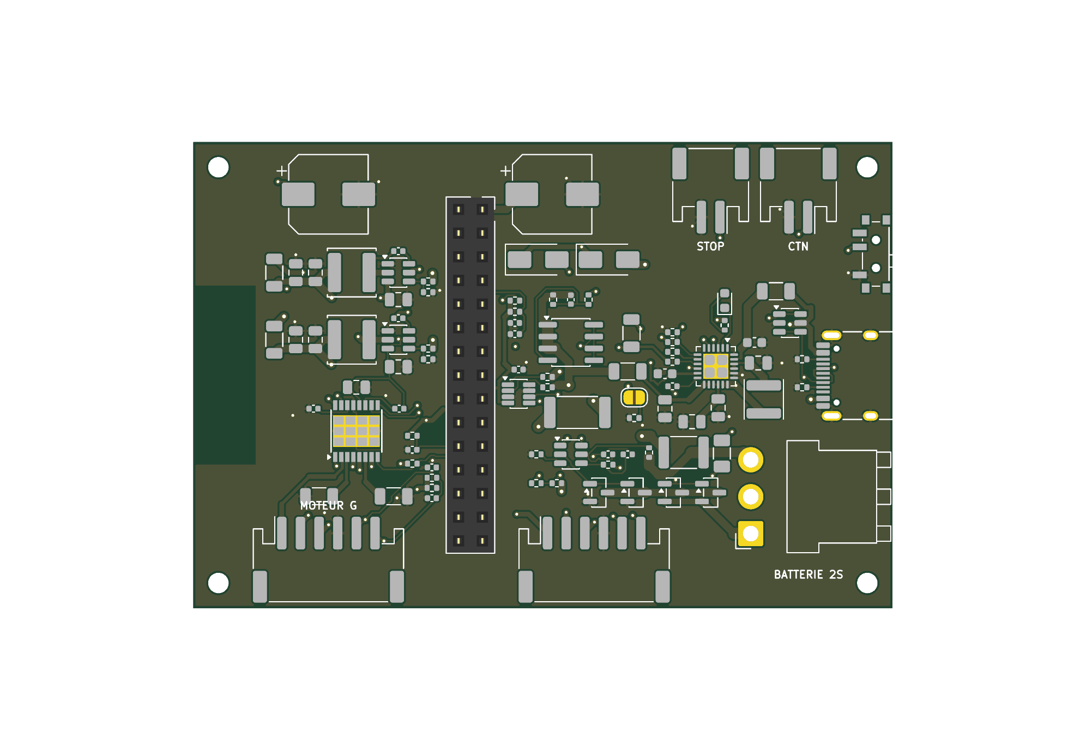
pcb/rover_puissance/apercu_top.png
