RaphaelGrj/Rover-Project/pcb/rover_logique/fabrication/rover_logique-bom.csv

Comment | Designator | Footprint | LCSC Part #
10uF 10V | C1,C60,C61,C66 | C_0805_2012Metric
100nF | C2,C62,C63,C64,C65,C67,C68,C69 | C_0402_1005Metric
1uF | C3,C41,C42,C43,C44 | C_0603_1608Metric
LED verte (3V3) | D1 | LED_0603_1608Metric
LED bleue (etat) | D3 | LED_0603_1608Metric
Ecran ST7789 (GND VCC SCL SDA RES DC CS BLK) | J10 | JST_PH_S8B-PH-SM4-TB_1x08-1MP_P2.00mm_Horizontal | C265121
Qwiic (GND 3V3 SDA SCL) | J12 | JST_SH_SM04B-SRSS-TB_1x04-1MP_P1.00mm_Horizontal | C160404
Camera OV2640 (FPC 24p 0.5mm, contacts dessous) | J14 | Hirose_FH12-24S-0.5SH_1x24-1MP_P0.50mm_Horizontal
Vers carte puissance (barrette 2x15) | J20 | PinHeader_2x15_P2.54mm_Vertical
Servo (1:GND 2:5V 3:signal) | J5 | PinHeader_1x03_P2.54mm_Vertical
Haut-parleur L (1:+ 2:-) | J6 | JST_PH_S2B-PH-SM4-TB_1x02-1MP_P2.00mm_Horizontal | C295747
Haut-parleur R (1:+ 2:-) | J7 | JST_PH_S2B-PH-SM4-TB_1x02-1MP_P2.00mm_Horizontal | C295747
VL53L0X gauche (VIN GND SCL SDA GPIO1 XSHUT) | J8 | JST_PH_S6B-PH-SM4-TB_1x06-1MP_P2.00mm_Horizontal | C265405
VL53L0X droit (VIN GND SCL SDA GPIO1 XSHUT) | J9 | JST_PH_S6B-PH-SM4-TB_1x06-1MP_P2.00mm_Horizontal | C265405
10k | R1,R2,R40,R45,R46,R50,R51 | R_0402_1005Metric
4.7k | R3,R4,R48,R49 | R_0402_1005Metric
220k | R41 | R_0402_1005Metric
100k | R44 | R_0402_1005Metric
1k | R47,R22 | R_0402_1005Metric
RESET | SW2 | SW_Push_1P1T_NO_CK_KMR2
BOOT | SW3 | SW_Push_1P1T_NO_CK_KMR2
ESP32-S3-WROOM-1-N16R2 | U1 | ESP32-S3-WROOM-1_bord | C2913205
ICS-43434 | U10 | InvenSense_ICS-43434-6_3.5x2.65mm | C5656610
LSM6DS3TR-C | U11 | LGA-14_3x2.5mm_P0.5mm_LayoutBorder3x4y | C967633
BME688 | U12 | Bosch_LGA-8_3x3mm_P0.8mm_ClockwisePinNumbering | C3664478
TCA9554PWR | U13 | TSSOP-16_4.4x5mm_P0.65mm | C477924
XC6206P282MR (2.8V) | U14 | SOT-23 | C347374
XC6206P122MR-G (1.2V) | U15 | SOT-23 | C424699
MAX98357AETE+T | U8,U9 | TQFN-16-1EP_3x3mm_P0.5mm_EP1.23x1.23mm | C910544
