RaphaelGrj/Rover-Project/pcb/rover_puissance/fabrication/rover_puissance-bom.csv

Comment | Designator | Footprint | LCSC Part #
4.7uF | C10 | C_0603_1608Metric
47nF | C11 | C_0402_1005Metric
22uF 10V | C162,C163,C152,C153 | C_0805_2012Metric
1uF 25V | C4 | C_0603_1608Metric
100nF | C40,C12,C13,C14,C160,C150,C49 | C_0402_1005Metric
2.2uF 6.3V | C47 | C_0402_1005Metric
10nF 25V | C48 | C_0402_1005Metric
22uF 25V | C5,C7,C8 | C_0805_2012Metric
470uF 16V | C70,C45 | CP_Elec_8x10
10uF 25V | C9,C161,C151,C46 | C_0805_2012Metric
LED orange (charge) | D2 | LED_0603_1608Metric
SS34 | D4,D5 | D_SMA | C717457
PTC 4A 16V (1812) | F1 | Fuse_1812_4532Metric
PTC 0.75A (1206) | F2 | Fuse_1206_3216Metric
USB-C TYPE-C-31-M-12 | J1 | USB_C_Receptacle_HRO_TYPE-C-31-M-12 | C165948
Arret d'urgence (1:ESTOP_N 2:GND) | J11 | JST_PH_S2B-PH-SM4-TB_1x02-1MP_P2.00mm_Horizontal | C295747
CTN 10k cellules | J13 | JST_PH_S2B-PH-SM4-TB_1x02-1MP_P2.00mm_Horizontal | C295747
Batterie 2S JST-VH coude (1:B- 2:MID 3:B+) | J2 | JST_VH_B3PS-VH_1x03_P3.96mm_Horizontal | C131336
Vers carte logique (embase 2x15) | J20 | PinSocket_2x15_P2.54mm_Vertical
Moteur gauche (1:M1 2:M2 3:3V3 4:GND 5:A 6:B) | J3 | JST_PH_S6B-PH-SM4-TB_1x06-1MP_P2.00mm_Horizontal | C265405
Moteur droit (1:M1 2:M2 3:3V3 4:GND 5:A 6:B) | J4 | JST_PH_S6B-PH-SM4-TB_1x06-1MP_P2.00mm_Horizontal | C265405
1uH 4A (FNR4030S1R0) | L1 | L_Changjiang_FNR4030S
3.3uH 3A (FNR5040S3R3) | L15 | L_Changjiang_FNR5040S
2.2uH 3A (FNR5040S2R2) | L16 | L_Changjiang_FNR5040S
AO3400A | Q1,Q4,Q2,Q5 | SOT-23 | C20917
AO4407A | Q3 | SOIC-8_3.9x4.9mm_P1.27mm | C16072
5.23k | R10 | R_0402_1005Metric
30.1k | R11 | R_0402_1005Metric
10k | R12,R18,R161,R151,R25,R26,R30,R31,R32,R33 | R_0402_1005Metric
2.2k | R13 | R_0402_1005Metric
470 | R14,R15 | R_0402_1005Metric
54.9k | R150 | R_0402_1005Metric
2k | R16 | R_0402_1005Metric
33.2k | R160 | R_0402_1005Metric
0 (pont) | R162,R152 | R_1206_3216Metric
100k | R17 | R_0402_1005Metric
1M | R19 | R_0402_1005Metric
0.2 (limite 1A) | R23,R24 | R_1206_3216Metric
5.1k | R5,R6 | R_0402_1005Metric
0 (pont batterie) | R60 | R_1206_3216Metric
0 (pont VBUS) | R61 | R_1206_3216Metric
10 | R62,R63 | R_0402_1005Metric
0 (pont mesure) | R64 | R_0402_1005Metric
620 | R7 | R_0402_1005Metric
330 | R8 | R_0402_1005Metric
100 | R9 | R_1206_3216Metric
0.05 1W (shunt) | RS1 | R_2512_6332Metric
Marche/Arret | SW1 | SW_SPDT_PCM12
INA219AIDCNR | U16 | SOT-23-8 | C87469
USBLC6-2SC6 | U2 | SOT-23-6 | C7519
BQ25887RGER | U3 | Texas_RGE0024H_VQFN-24-1EP_4x4mm_P0.5mm_EP2.7x2.7mm | C2761614
S-8252AAC-M6T1U | U4 | SOT-23-6 | C468219
TPS563201DDCR | U6,U5 | SOT-23-6 | C116592
DRV8833PWPR | U7 | HTSSOP-16-1EP_4.4x5mm_P0.65mm_EP3.4x5mm | C50506
