RaphaelGrj/Rover-Project/pcb/rover_logique/rover_logique.kicad_pcb

## KiCad design pcb/rover_logique/rover_logique.kicad_pcb (2026-11-13)

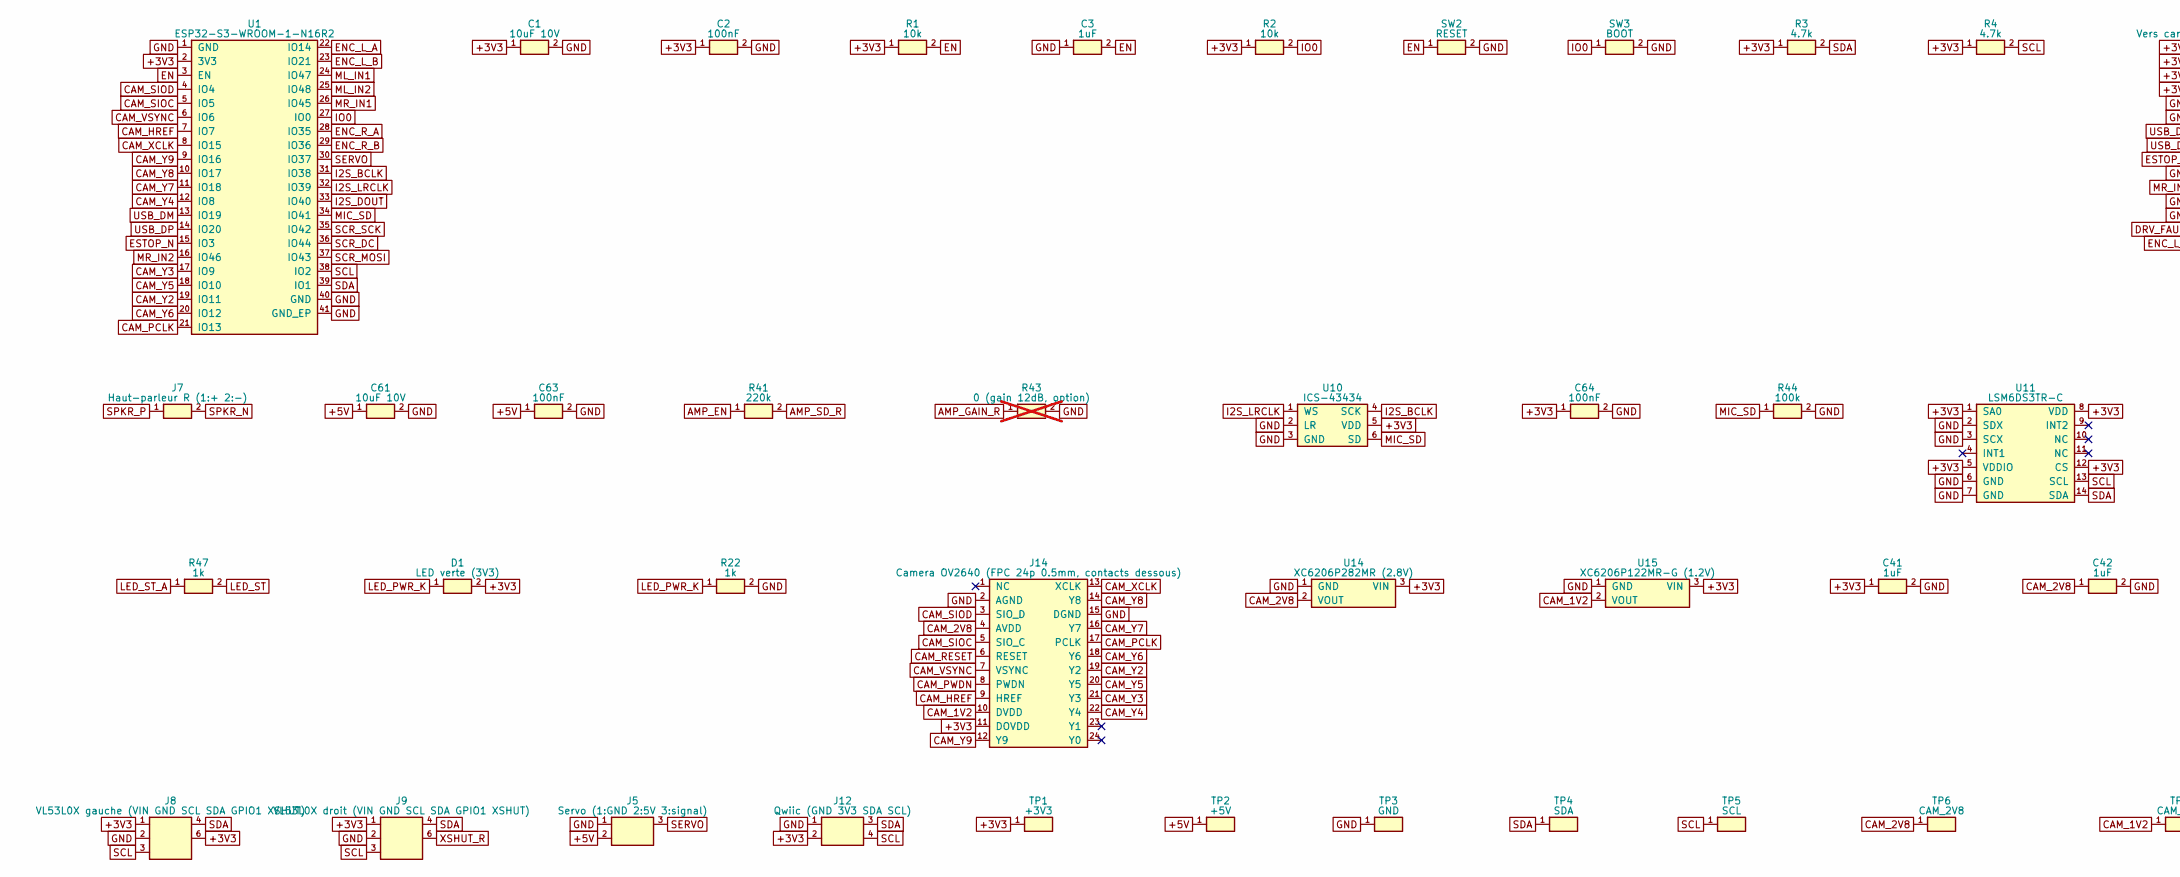
[picture p8: schematic rover_logique.kicad_sch, ROVER - carte logique (haut), part in row 1, column 1]

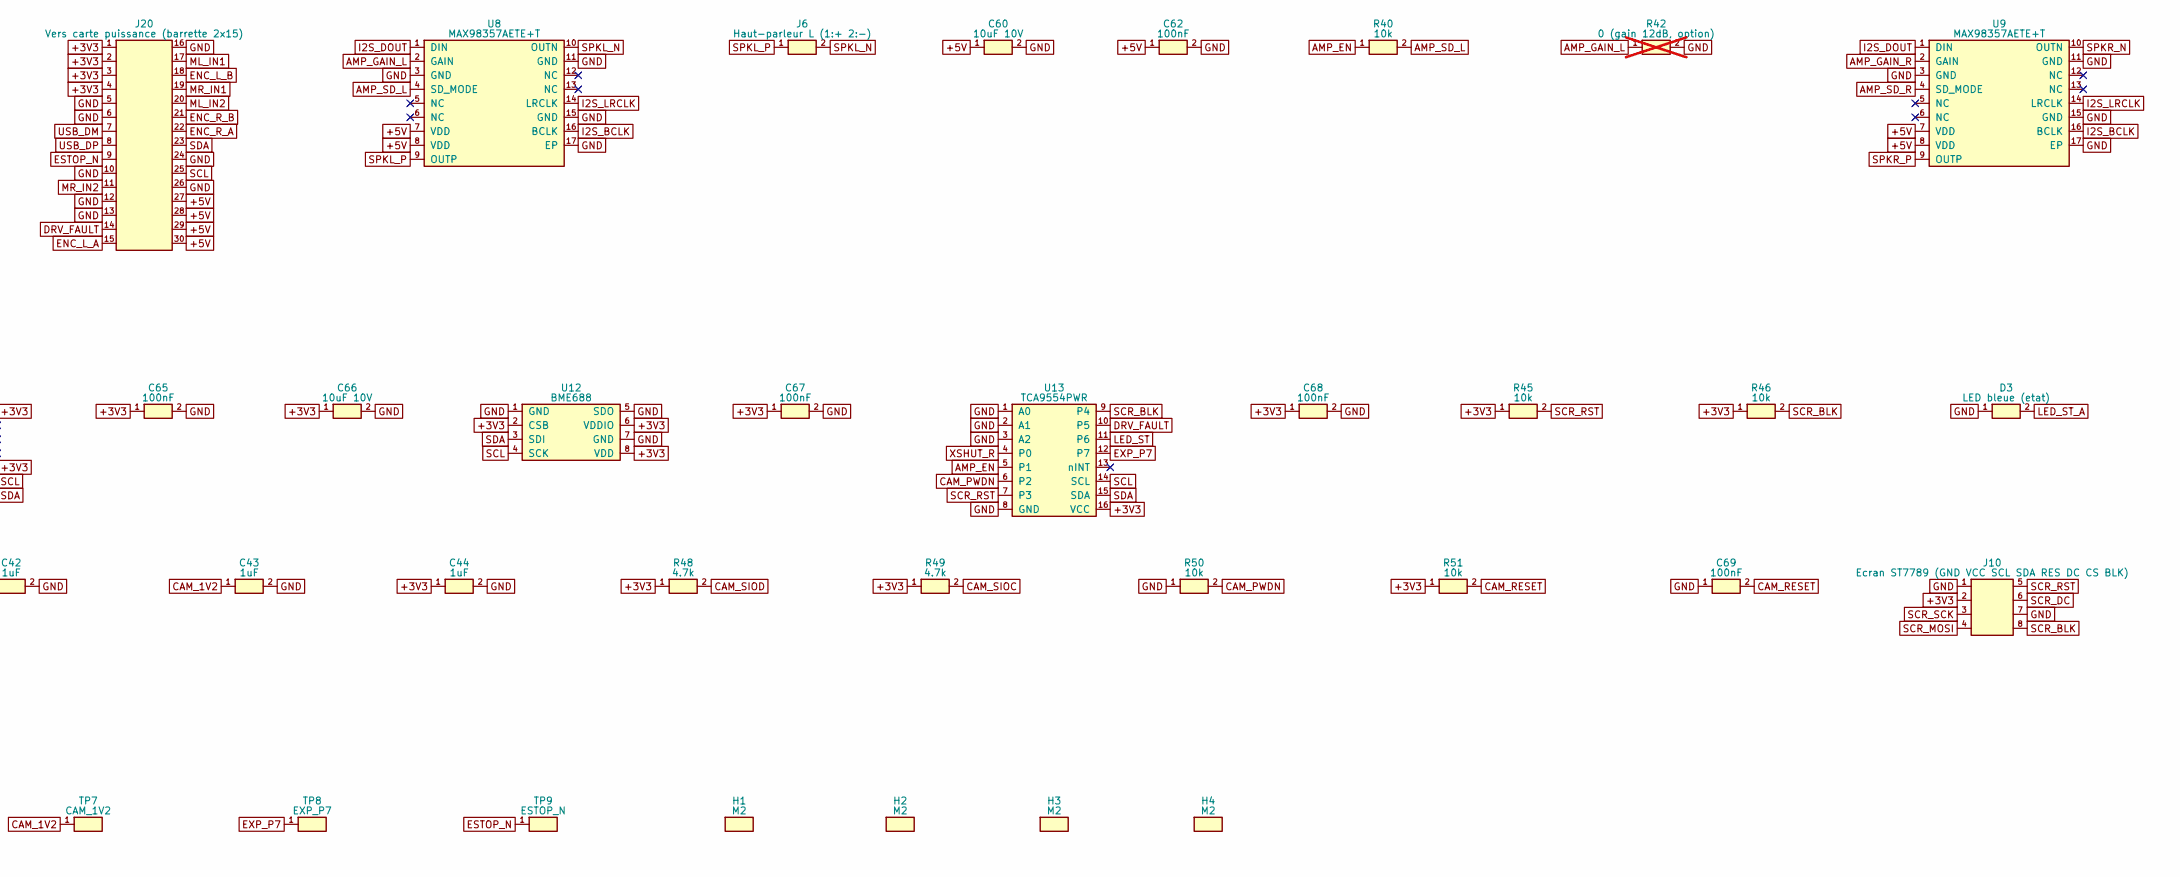
[picture p9: schematic rover_logique.kicad_sch, ROVER - carte logique (haut), part in row 1, column 2]

Parts:
C1, C60, C61, C66: 10uF 10V; C_0805_2012Metric
C2, C62, C63, C64, C65, C67, C68, C69: 100nF; C_0402_1005Metric
C3, C41, C42, C43, C44: 1uF; C_0603_1608Metric
D1: LED verte (3V3); LED_0603_1608Metric
D3: LED bleue (etat); LED_0603_1608Metric
H1, H2, H3, H4: M2; MountingHole_2.2mm_M2
J5: Servo (1:GND 2:5V 3:signal); PinHeader_1x03_P2.54mm_Vertical
J6: Haut-parleur L (1:+ 2:-); JST_PH_S2B-PH-SM4-TB_1x02-1MP_P2.00mm_Horizontal
J7: Haut-parleur R (1:+ 2:-); JST_PH_S2B-PH-SM4-TB_1x02-1MP_P2.00mm_Horizontal
J8: VL53L0X gauche (VIN GND SCL SDA GPIO1 XSHUT); JST_PH_S6B-PH-SM4-TB_1x06-1MP_P2.00mm_Horizontal
J9: VL53L0X droit (VIN GND SCL SDA GPIO1 XSHUT); JST_PH_S6B-PH-SM4-TB_1x06-1MP_P2.00mm_Horizontal
J10: Ecran ST7789 (GND VCC SCL SDA RES DC CS BLK); JST_PH_S8B-PH-SM4-TB_1x08-1MP_P2.00mm_Horizontal
J12: Qwiic (GND 3V3 SDA SCL); JST_SH_SM04B-SRSS-TB_1x04-1MP_P1.00mm_Horizontal
J14: Camera OV2640 (FPC 24p 0.5mm, contacts dessous); Hirose_FH12-24S-0.5SH_1x24-1MP_P0.50mm_Horizontal
J20: Vers carte puissance (barrette 2x15); PinHeader_2x15_P2.54mm_Vertical
R1, R2, R40, R45, R46, R50, R51: 10k; R_0402_1005Metric
R3, R4, R48, R49: 4.7k; R_0402_1005Metric
R22, R47: 1k; R_0402_1005Metric
R41: 220k; R_0402_1005Metric
R42, R43: 0 (gain 12dB, option); R_0402_1005Metric; not fitted
R44: 100k; R_0402_1005Metric
SW2: RESET; SW_Push_1P1T_NO_CK_KMR2
SW3: BOOT; SW_Push_1P1T_NO_CK_KMR2
TP1: +3V3; TestPoint_Pad_D1.0mm
TP2: +5V; TestPoint_Pad_D1.0mm
TP3: GND; TestPoint_Pad_D1.0mm
TP4: SDA; TestPoint_Pad_D1.0mm
TP5: SCL; TestPoint_Pad_D1.0mm
TP6: CAM_2V8; TestPoint_Pad_D1.0mm
TP7: CAM_1V2; TestPoint_Pad_D1.0mm
TP8: EXP_P7; TestPoint_Pad_D1.0mm
TP9: ESTOP_N; TestPoint_Pad_D1.0mm
U1: ESP32-S3-WROOM-1-N16R2; ESP32-S3-WROOM-1_bord
U8, U9: MAX98357AETE+T; TQFN-16-1EP_3x3mm_P0.5mm_EP1.23x1.23mm
U10: ICS-43434; InvenSense_ICS-43434-6_3.5x2.65mm
U11: LSM6DS3TR-C; LGA-14_3x2.5mm_P0.5mm_LayoutBorder3x4y
U12: BME688; Bosch_LGA-8_3x3mm_P0.8mm_ClockwisePinNumbering
U13: TCA9554PWR; TSSOP-16_4.4x5mm_P0.65mm
U14: XC6206P282MR (2.8V); SOT-23
U15: XC6206P122MR-G (1.2V); SOT-23

Connections:
+3V3: C1.1, C2.1, C41.1, C44.1, C64.1, C65.1, C66.1, C67.1, C68.1, D1.2, J8.1, J8.6, J9.1, J10.2, J12.2, J14.11 (DOVDD), J20.1, J20.2, J20.3, J20.4, R1.1, R2.1, R3.1, R4.1, R45.1, R46.1, R48.1, R49.1, R51.1, TP1.1, U1.2 (3V3), U10.5 (VDD), U11.1 (SA0), U11.5 (VDDIO), U11.8 (VDD), U11.12 (CS), U12.2 (CSB), U12.6 (VDDIO), U12.8 (VDD), U13.16 (VCC), U14.3 (VIN), U15.3 (VIN)
+5V: C60.1, C61.1, C62.1, C63.1, J5.2, J20.27, J20.28, J20.29, J20.30, TP2.1, U8.7 (VDD), U8.8 (VDD), U9.7 (VDD), U9.8 (VDD)
AMP_EN: R40.1, R41.1, U13.5 (P1)
AMP_GAIN_L: R42.1, U8.2 (GAIN)
AMP_GAIN_R: R43.1, U9.2 (GAIN)
AMP_SD_L: R40.2, U8.4 (SD_MODE)
AMP_SD_R: R41.2, U9.4 (SD_MODE)
CAM_1V2: C43.1, J14.10 (DVDD), TP7.1, U15.2 (VOUT)
CAM_2V8: C42.1, J14.4 (AVDD), TP6.1, U14.2 (VOUT)
CAM_HREF: J14.9 (HREF), U1.7 (IO7)
CAM_PCLK: J14.17 (PCLK), U1.21 (IO13)
CAM_PWDN: J14.8 (PWDN), R50.2, U13.6 (P2)
CAM_RESET: C69.2, J14.6 (RESET), R51.2
CAM_SIOC: J14.5 (SIO_C), R49.2, U1.5 (IO5)
CAM_SIOD: J14.3 (SIO_D), R48.2, U1.4 (IO4)
CAM_VSYNC: J14.7 (VSYNC), U1.6 (IO6)
CAM_XCLK: J14.13 (XCLK), U1.8 (IO15)
CAM_Y2: J14.19 (Y2), U1.19 (IO11)
CAM_Y3: J14.21 (Y3), U1.17 (IO9)
CAM_Y4: J14.22 (Y4), U1.12 (IO8)
CAM_Y5: J14.20 (Y5), U1.18 (IO10)
CAM_Y6: J14.18 (Y6), U1.20 (IO12)
CAM_Y7: J14.16 (Y7), U1.11 (IO18)
CAM_Y8: J14.14 (Y8), U1.10 (IO17)
CAM_Y9: J14.12 (Y9), U1.9 (IO16)
DRV_FAULT: J20.14, U13.10 (P5)
EN: C3.2, R1.2, SW2.1, U1.3 (EN)
ENC_L_A: J20.15, U1.22 (IO14)
ENC_L_B: J20.18, U1.23 (IO21)
ENC_R_A: J20.22, U1.28 (IO35)
ENC_R_B: J20.21, U1.29 (IO36)
ESTOP_N: J20.9, TP9.1, U1.15 (IO3)
EXP_P7: TP8.1, U13.12 (P7)
GND: C1.2, C2.2, C3.1, C41.2, C42.2, C43.2, C44.2, C60.2, C61.2, C62.2, C63.2, C64.2, C65.2, C66.2, C67.2, C68.2, C69.1, D3.1, J5.1, J8.2, J9.2, J10.1, J10.7, J12.1, J14.2 (AGND), J14.15 (DGND), J20.5, J20.6, J20.10, J20.12, J20.13, J20.16, J20.24, J20.26, R22.2, R42.2, R43.2, R44.2, R50.1, SW2.2, SW3.2, TP3.1, U1.1 (GND), U1.40 (GND), U1.41 (GND_EP), U8.3 (GND), U8.11 (GND), U8.15 (GND), U8.17 (EP), U9.3 (GND), U9.11 (GND), U9.15 (GND), U9.17 (EP), U10.2 (LR), U10.3 (GND), U11.2 (SDX), U11.3 (SCX), U11.6 (GND), U11.7 (GND), U12.1 (GND), U12.5 (SDO), U12.7 (GND), U13.1 (A0), U13.2 (A1), U13.3 (A2), U13.8 (GND), U14.1 (GND), U15.1 (GND)
I2S_BCLK: U1.31 (IO38), U8.16 (BCLK), U9.16 (BCLK), U10.4 (SCK)
I2S_DOUT: U1.33 (IO40), U8.1 (DIN), U9.1 (DIN)
I2S_LRCLK: U1.32 (IO39), U8.14 (LRCLK), U9.14 (LRCLK), U10.1 (WS)
IO0: R2.2, SW3.1, U1.27 (IO0)
LED_PWR_K: D1.1, R22.1
LED_ST: R47.2, U13.11 (P6)
LED_ST_A: D3.2, R47.1
MIC_SD: R44.1, U1.34 (IO41), U10.6 (SD)
ML_IN1: J20.17, U1.24 (IO47)
ML_IN2: J20.20, U1.25 (IO48)
MR_IN1: J20.19, U1.26 (IO45)
MR_IN2: J20.11, U1.16 (IO46)
SCL: J8.3, J9.3, J12.4, J20.25, R4.2, TP5.1, U1.38 (IO2), U11.13 (SCL), U12.4 (SCK), U13.14 (SCL)
SCR_BLK: J10.8, R46.2, U13.9 (P4)
SCR_DC: J10.6, U1.36 (IO44)
SCR_MOSI: J10.4, U1.37 (IO43)
SCR_RST: J10.5, R45.2, U13.7 (P3)
SCR_SCK: J10.3, U1.35 (IO42)
SDA: J8.4, J9.4, J12.3, J20.23, R3.2, TP4.1, U1.39 (IO1), U11.14 (SDA), U12.3 (SDI), U13.15 (SDA)
SERVO: J5.3, U1.30 (IO37)
SPKL_N: J6.2, U8.10 (OUTN)
SPKL_P: J6.1, U8.9 (OUTP)
SPKR_N: J7.2, U9.10 (OUTN)
SPKR_P: J7.1, U9.9 (OUTP)
USB_DM: J20.7, U1.13 (IO19)
USB_DP: J20.8, U1.14 (IO20)
XSHUT_R: J9.6, U13.4 (P0)

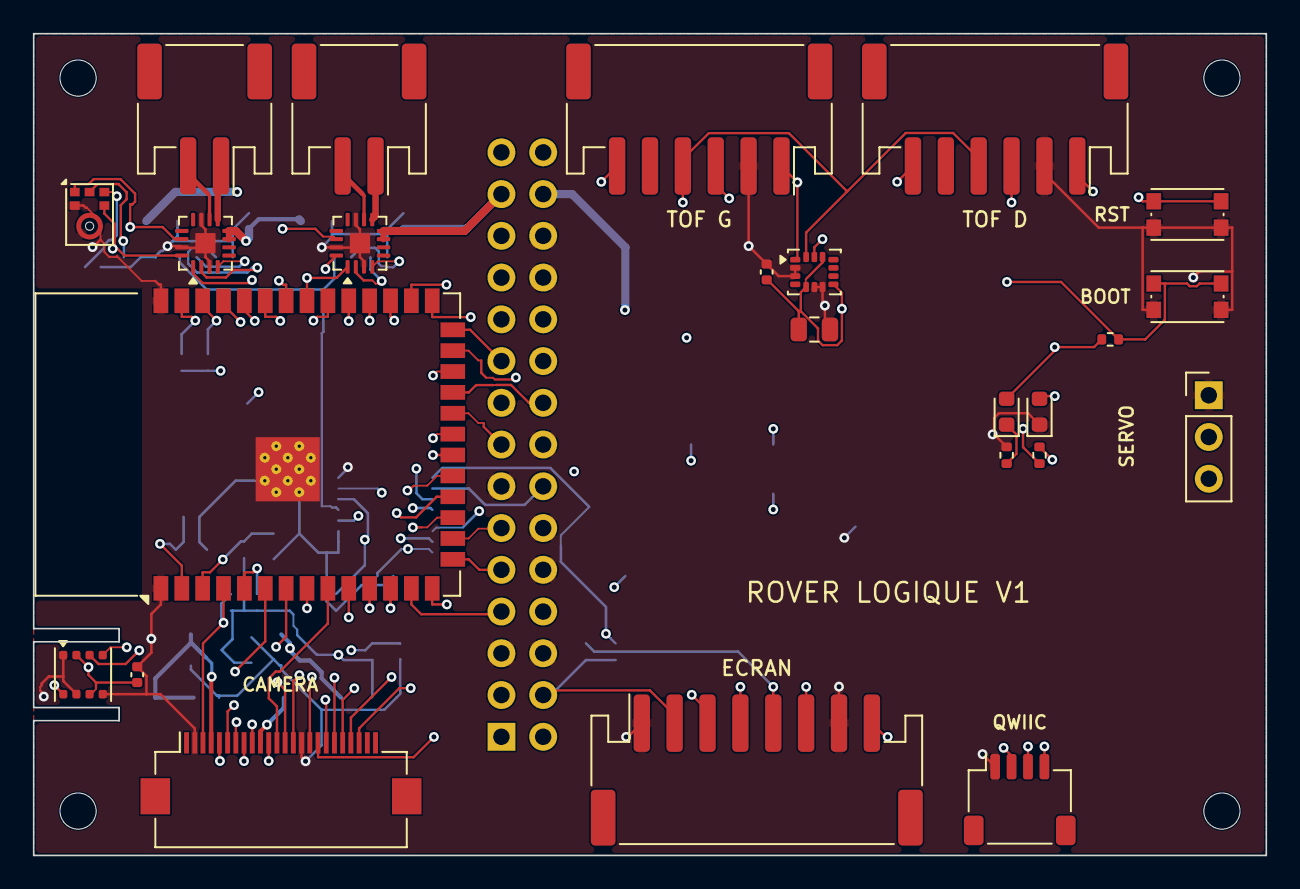
[picture p10: board rover_logique.kicad_pcb from above]

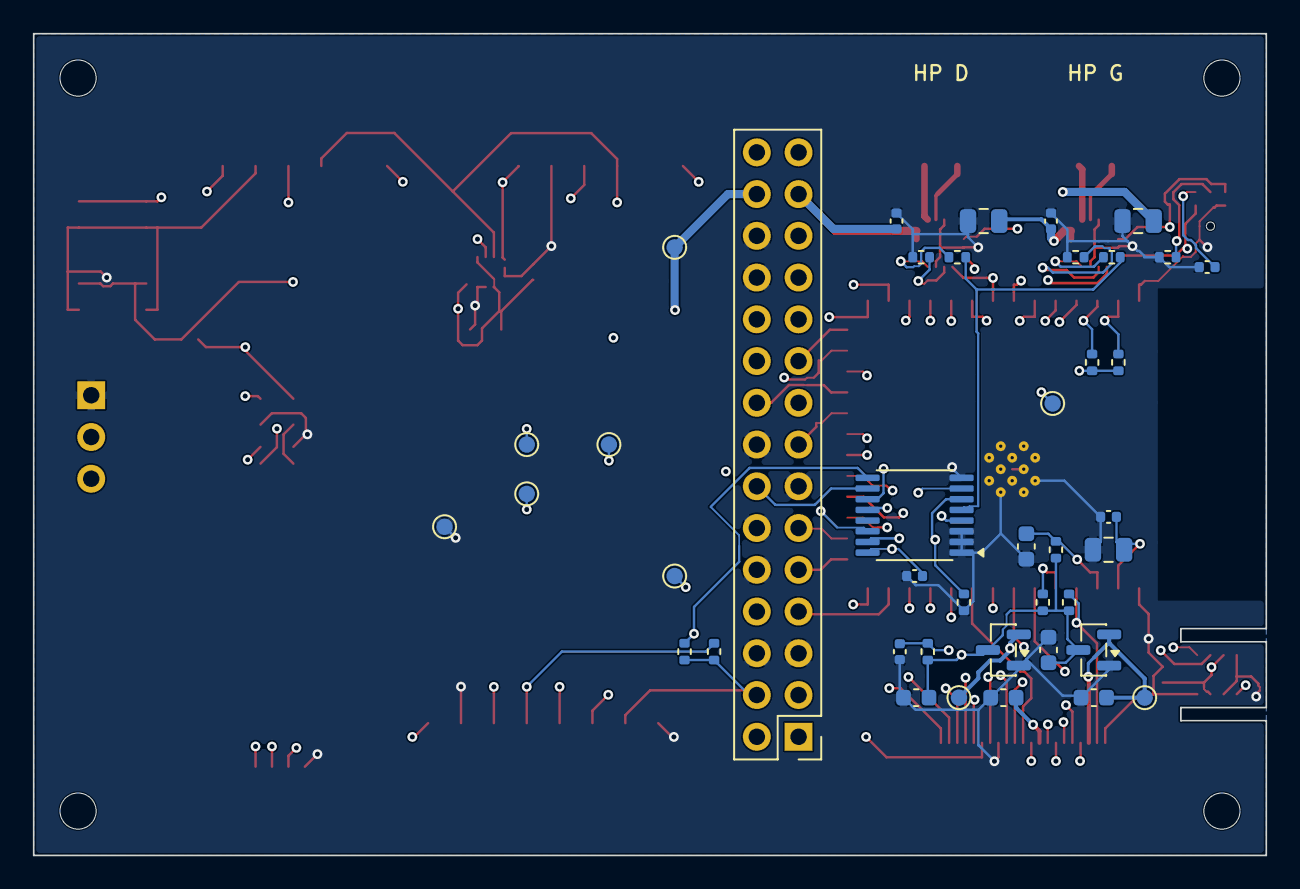
[picture p11: board rover_logique.kicad_pcb from below]

Board: 4 copper layers, 75.0 x 50.0 mm, 69 parts (41 on the bottom side), 61 nets.
