RaphaelGrj/Rover-Project/pcb/rover_puissance/rover_puissance.kicad_pcb

## KiCad design pcb/rover_puissance/rover_puissance.kicad_pcb (2026-11-13)

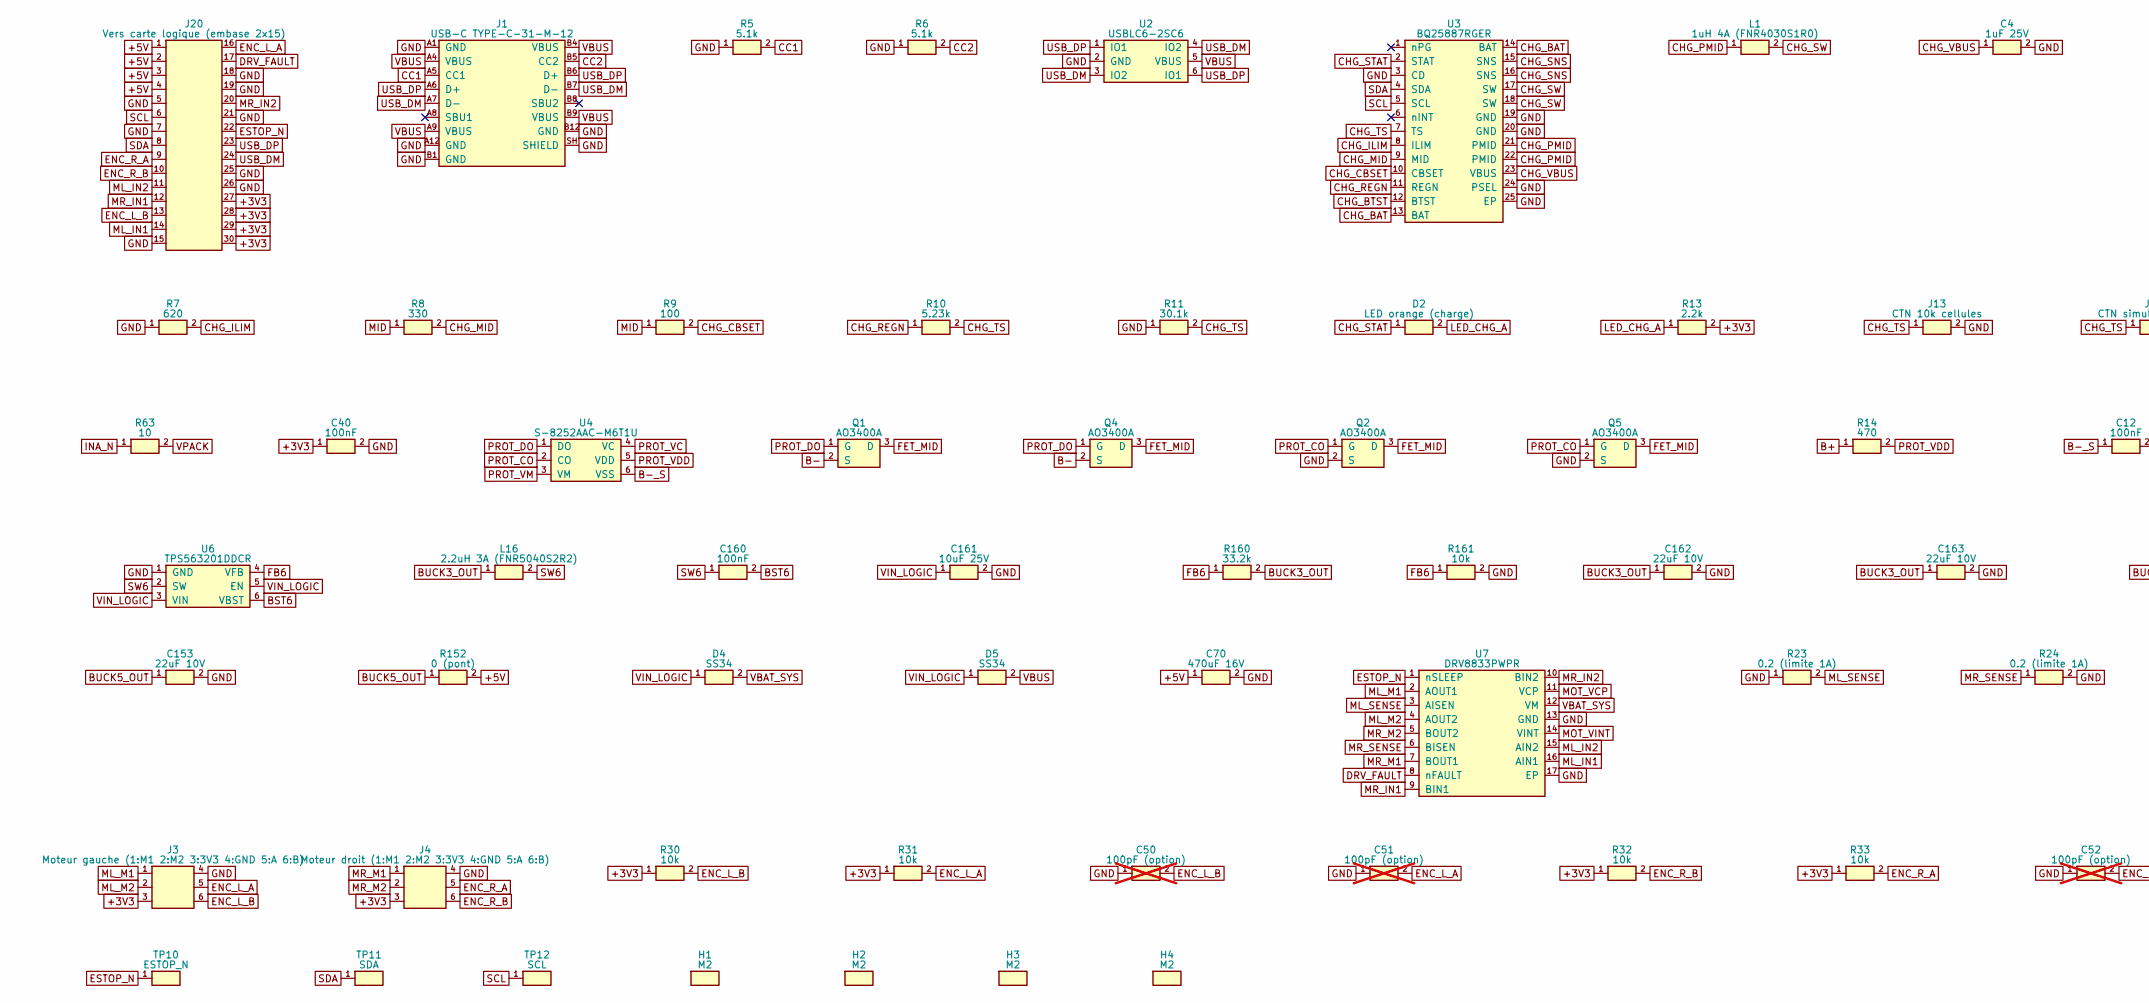
[picture p12: schematic rover_puissance.kicad_sch, ROVER - carte puissance (bas), part in row 1, column 1]

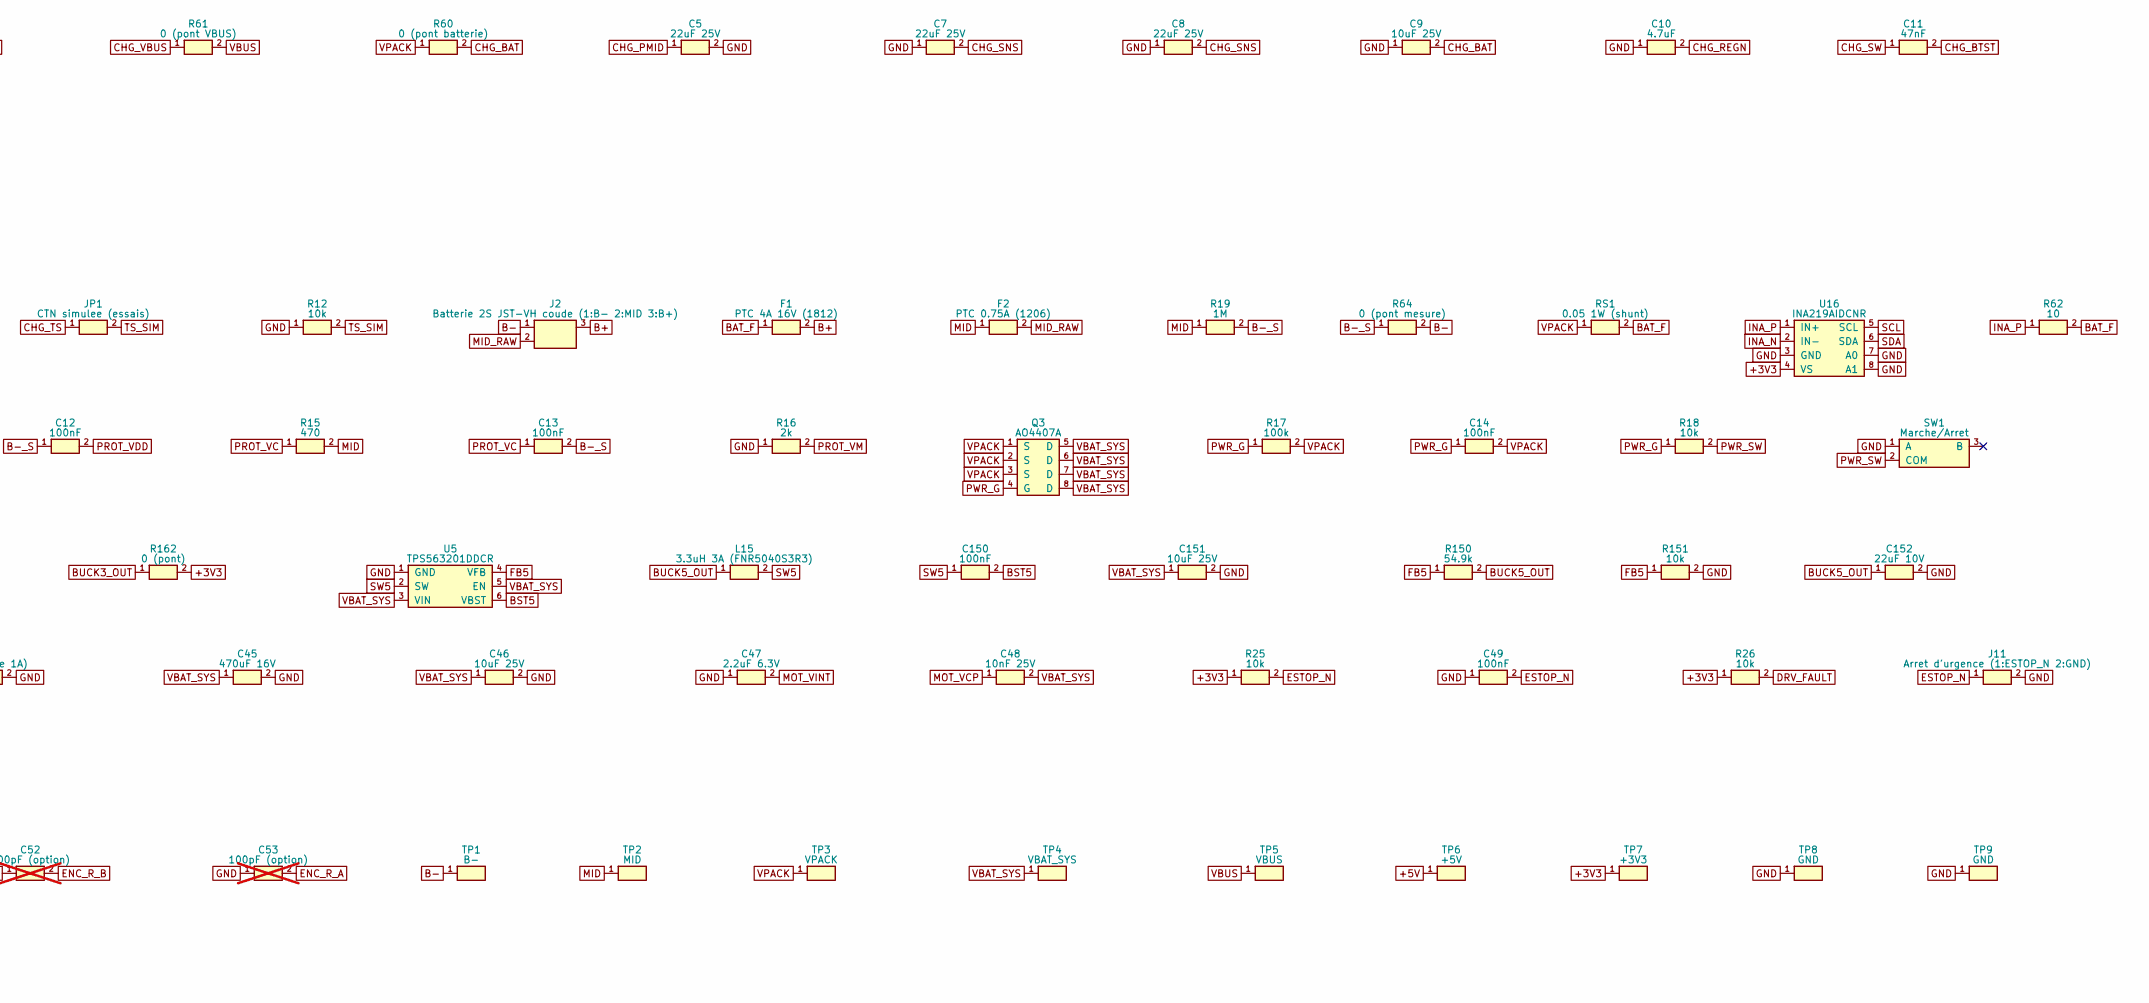
[picture p13: schematic rover_puissance.kicad_sch, ROVER - carte puissance (bas), part in row 1, column 2]

Parts:
C4: 1uF 25V; C_0603_1608Metric
C5, C7, C8: 22uF 25V; C_0805_2012Metric
C9, C46, C151, C161: 10uF 25V; C_0805_2012Metric
C10: 4.7uF; C_0603_1608Metric
C11: 47nF; C_0402_1005Metric
C12, C13, C14, C40, C49, C150, C160: 100nF; C_0402_1005Metric
C45, C70: 470uF 16V; CP_Elec_8x10
C47: 2.2uF 6.3V; C_0402_1005Metric
C48: 10nF 25V; C_0402_1005Metric
C50, C51, C52, C53: 100pF (option); C_0402_1005Metric; not fitted
C152, C153, C162, C163: 22uF 10V; C_0805_2012Metric
D2: LED orange (charge); LED_0603_1608Metric
D4, D5: SS34; D_SMA
F1: PTC 4A 16V (1812); Fuse_1812_4532Metric
F2: PTC 0.75A (1206); Fuse_1206_3216Metric
H1, H2, H3, H4: M2; MountingHole_2.2mm_M2
J1: USB-C TYPE-C-31-M-12; USB_C_Receptacle_HRO_TYPE-C-31-M-12
J2: Batterie 2S JST-VH coude (1:B- 2:MID 3:B+); JST_VH_B3PS-VH_1x03_P3.96mm_Horizontal
J3: Moteur gauche (1:M1 2:M2 3:3V3 4:GND 5:A 6:B); JST_PH_S6B-PH-SM4-TB_1x06-1MP_P2.00mm_Horizontal
J4: Moteur droit (1:M1 2:M2 3:3V3 4:GND 5:A 6:B); JST_PH_S6B-PH-SM4-TB_1x06-1MP_P2.00mm_Horizontal
J11: Arret d'urgence (1:ESTOP_N 2:GND); JST_PH_S2B-PH-SM4-TB_1x02-1MP_P2.00mm_Horizontal
J13: CTN 10k cellules; JST_PH_S2B-PH-SM4-TB_1x02-1MP_P2.00mm_Horizontal
J20: Vers carte logique (embase 2x15); PinSocket_2x15_P2.54mm_Vertical
JP1: CTN simulee (essais); SolderJumper-2_P1.3mm_Open_RoundedPad1.0x1.5mm
L1: 1uH 4A (FNR4030S1R0); L_Changjiang_FNR4030S
L15: 3.3uH 3A (FNR5040S3R3); L_Changjiang_FNR5040S
L16: 2.2uH 3A (FNR5040S2R2); L_Changjiang_FNR5040S
Q1, Q2, Q4, Q5: AO3400A; SOT-23
Q3: AO4407A; SOIC-8_3.9x4.9mm_P1.27mm
R5, R6: 5.1k; R_0402_1005Metric
R7: 620; R_0402_1005Metric
R8: 330; R_0402_1005Metric
R9: 100; R_1206_3216Metric
R10: 5.23k; R_0402_1005Metric
R11: 30.1k; R_0402_1005Metric
R12, R18, R25, R26, R30, R31, R32, R33, R151, R161: 10k; R_0402_1005Metric
R13: 2.2k; R_0402_1005Metric
R14, R15: 470; R_0402_1005Metric
R16: 2k; R_0402_1005Metric
R17: 100k; R_0402_1005Metric
R19: 1M; R_0402_1005Metric
R23, R24: 0.2 (limite 1A); R_1206_3216Metric
R60: 0 (pont batterie); R_1206_3216Metric
R61: 0 (pont VBUS); R_1206_3216Metric
R62, R63: 10; R_0402_1005Metric
R64: 0 (pont mesure); R_0402_1005Metric
R150: 54.9k; R_0402_1005Metric
R152, R162: 0 (pont); R_1206_3216Metric
R160: 33.2k; R_0402_1005Metric
RS1: 0.05 1W (shunt); R_2512_6332Metric
SW1: Marche/Arret; SW_SPDT_PCM12
TP1: B-; TestPoint_Pad_D1.0mm
TP2: MID; TestPoint_Pad_D1.0mm
TP3: VPACK; TestPoint_Pad_D1.0mm
TP4: VBAT_SYS; TestPoint_Pad_D1.0mm
TP5: VBUS; TestPoint_Pad_D1.0mm
TP6: +5V; TestPoint_Pad_D1.0mm
TP7: +3V3; TestPoint_Pad_D1.0mm
TP8, TP9: GND; TestPoint_Pad_D1.0mm
TP10: ESTOP_N; TestPoint_Pad_D1.0mm
TP11: SDA; TestPoint_Pad_D1.0mm
TP12: SCL; TestPoint_Pad_D1.0mm
U2: USBLC6-2SC6; SOT-23-6
U3: BQ25887RGER; Texas_RGE0024H_VQFN-24-1EP_4x4mm_P0.5mm_EP2.7x2.7mm
U4: S-8252AAC-M6T1U; SOT-23-6
U5, U6: TPS563201DDCR; SOT-23-6
U7: DRV8833PWPR; HTSSOP-16-1EP_4.4x5mm_P0.65mm_EP3.4x5mm
U16: INA219AIDCNR; SOT-23-8

Connections:
+3V3: C40.1, J3.3, J4.3, J20.27, J20.28, J20.29, J20.30, R13.2, R25.1, R26.1, R30.1, R31.1, R32.1, R33.1, R162.2, TP7.1, U16.4 (VS)
+5V: C70.1, J20.1, J20.2, J20.3, J20.4, R152.2, TP6.1
B+: F1.2, J2.3, R14.1
B-: J2.1, Q1.2 (S), Q4.2 (S), R64.2, TP1.1
B-_S: C12.1, C13.2, R19.2, R64.1, U4.6 (VSS)
BAT_F: F1.1, R62.2, RS1.2
BST5: C150.2, U5.6 (VBST)
BST6: C160.2, U6.6 (VBST)
BUCK3_OUT: C162.1, C163.1, L16.1, R160.2, R162.1
BUCK5_OUT: C152.1, C153.1, L15.1, R150.2, R152.1
CC1: J1.A5 (CC1), R5.2
CC2: J1.B5 (CC2), R6.2
CHG_BAT: C9.2, R60.2, U3.13 (BAT), U3.14 (BAT)
CHG_BTST: C11.2, U3.12 (BTST)
CHG_CBSET: R9.2, U3.10 (CBSET)
CHG_ILIM: R7.2, U3.8 (ILIM)
CHG_MID: R8.2, U3.9 (MID)
CHG_PMID: C5.1, L1.1, U3.21 (PMID), U3.22 (PMID)
CHG_REGN: C10.2, R10.1, U3.11 (REGN)
CHG_SNS: C7.2, C8.2, U3.15 (SNS), U3.16 (SNS)
CHG_STAT: D2.1, U3.2 (STAT)
CHG_SW: C11.1, L1.2, U3.17 (SW), U3.18 (SW)
CHG_TS: J13.1, JP1.1, R10.2, R11.2, U3.7 (TS)
CHG_VBUS: C4.1, R61.1, U3.23 (VBUS)
DRV_FAULT: J20.17, R26.2, U7.8 (nFAULT)
ENC_L_A: C51.2, J3.5, J20.16, R31.2
ENC_L_B: C50.2, J3.6, J20.13, R30.2
ENC_R_A: C53.2, J4.5, J20.9, R33.2
ENC_R_B: C52.2, J4.6, J20.10, R32.2
ESTOP_N: C49.2, J11.1, J20.22, R25.2, TP10.1, U7.1 (nSLEEP)
FB5: R150.1, R151.1, U5.4 (VFB)
FB6: R160.1, R161.1, U6.4 (VFB)
FET_MID: Q1.3 (D), Q2.3 (D), Q4.3 (D), Q5.3 (D)
GND: C4.2, C5.2, C7.1, C8.1, C9.1, C10.1, C40.2, C45.2, C46.2, C47.1, C49.1, C50.1, C51.1, C52.1, C53.1, C70.2, C151.2, C152.2, C153.2, C161.2, C162.2, C163.2, J1.A1 (GND), J1.A12 (GND), J1.B1 (GND), J1.B12 (GND), J1.SH (SHIELD), J3.4, J4.4, J11.2, J13.2, J20.5, J20.7, J20.15, J20.18, J20.19, J20.21, J20.25, J20.26, Q2.2 (S), Q5.2 (S), R5.1, R6.1, R7.1, R11.1, R12.1, R16.1, R23.1, R24.2, R151.2, R161.2, SW1.1 (A), TP8.1, TP9.1, U2.2 (GND), U3.3 (CD), U3.19 (GND), U3.20 (GND), U3.24 (PSEL), U3.25 (EP), U5.1 (GND), U6.1 (GND), U7.13 (GND), U7.17 (EP), U16.3 (GND), U16.7 (A0), U16.8 (A1)
INA_N: R63.1, U16.2 (IN-)
INA_P: R62.1, U16.1 (IN+)
LED_CHG_A: D2.2, R13.1
MID: F2.1, R8.1, R9.1, R15.2, R19.1, TP2.1
MID_RAW: F2.2, J2.2
ML_IN1: J20.14, U7.16 (AIN1)
ML_IN2: J20.11, U7.15 (AIN2)
ML_M1: J3.1, U7.2 (AOUT1)
ML_M2: J3.2, U7.4 (AOUT2)
ML_SENSE: R23.2, U7.3 (AISEN)
MOT_VCP: C48.1, U7.11 (VCP)
MOT_VINT: C47.2, U7.14 (VINT)
MR_IN1: J20.12, U7.9 (BIN1)
MR_IN2: J20.20, U7.10 (BIN2)
MR_M1: J4.1, U7.7 (BOUT1)
MR_M2: J4.2, U7.5 (BOUT2)
MR_SENSE: R24.1, U7.6 (BISEN)
PROT_CO: Q2.1 (G), Q5.1 (G), U4.2 (CO)
PROT_DO: Q1.1 (G), Q4.1 (G), U4.1 (DO)
PROT_VC: C13.1, R15.1, U4.4 (VC)
PROT_VDD: C12.2, R14.2, U4.5 (VDD)
PROT_VM: R16.2, U4.3 (VM)
PWR_G: C14.1, Q3.4 (G), R17.1, R18.1
PWR_SW: R18.2, SW1.2 (COM)
SCL: J20.6, TP12.1, U3.5 (SCL), U16.5 (SCL)
SDA: J20.8, TP11.1, U3.4 (SDA), U16.6 (SDA)
SW5: C150.1, L15.2, U5.2 (SW)
SW6: C160.1, L16.2, U6.2 (SW)
TS_SIM: JP1.2, R12.2
USB_DM: J1.A7 (D-), J1.B7 (D-), J20.24, U2.3 (IO2), U2.4 (IO2)
USB_DP: J1.A6 (D+), J1.B6 (D+), J20.23, U2.1 (IO1), U2.6 (IO1)
VBAT_SYS: C45.1, C46.1, C48.2, C151.1, D4.2, Q3.5 (D), Q3.6 (D), Q3.7 (D), Q3.8 (D), TP4.1, U5.3 (VIN), U5.5 (EN), U7.12 (VM)
VBUS: D5.2, J1.A4 (VBUS), J1.A9 (VBUS), J1.B4 (VBUS), J1.B9 (VBUS), R61.2, TP5.1, U2.5 (VBUS)
VIN_LOGIC: C161.1, D4.1, D5.1, U6.3 (VIN), U6.5 (EN)
VPACK: C14.2, Q3.1 (S), Q3.2 (S), Q3.3 (S), R17.2, R60.1, R63.2, RS1.1, TP3.1

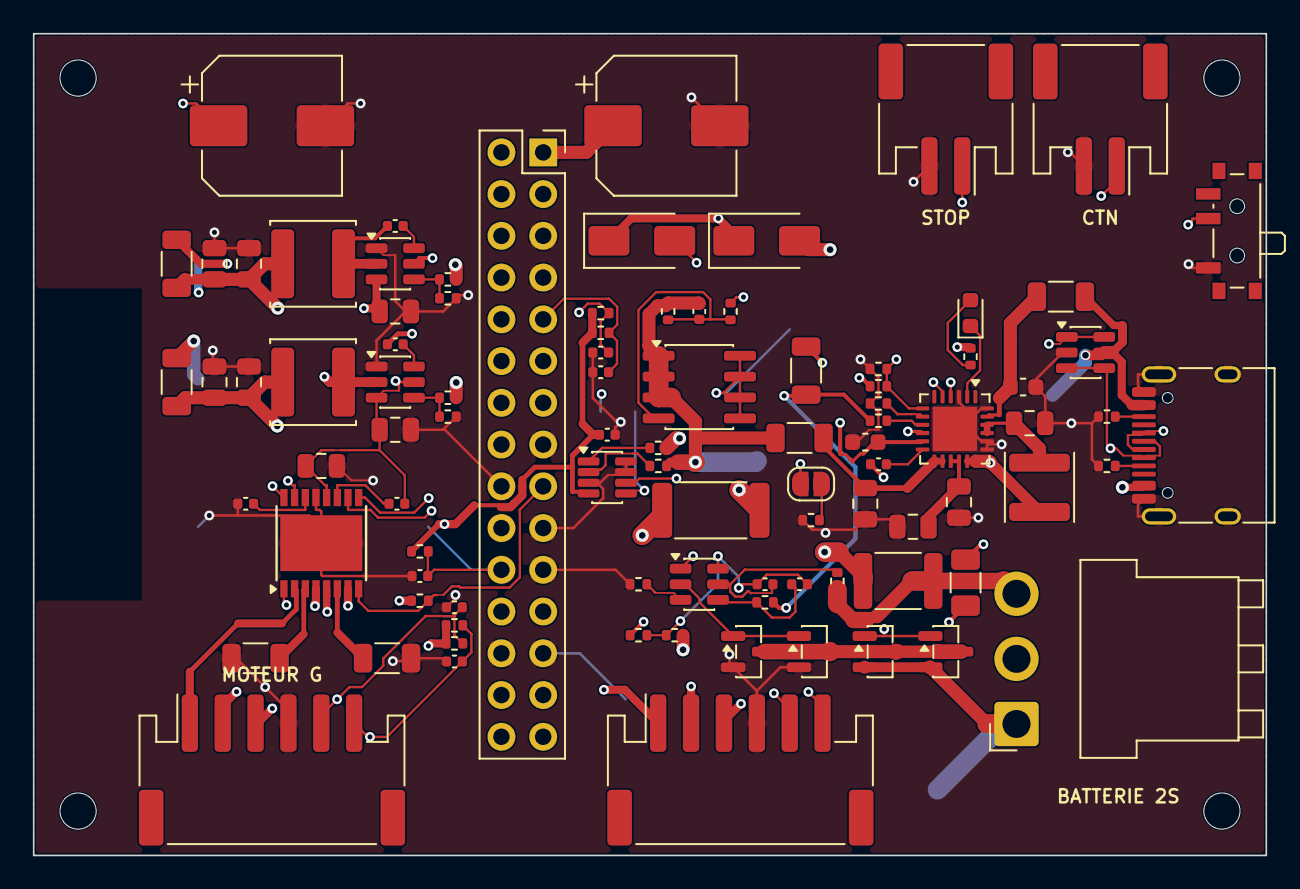
[picture p14: board rover_puissance.kicad_pcb from above]

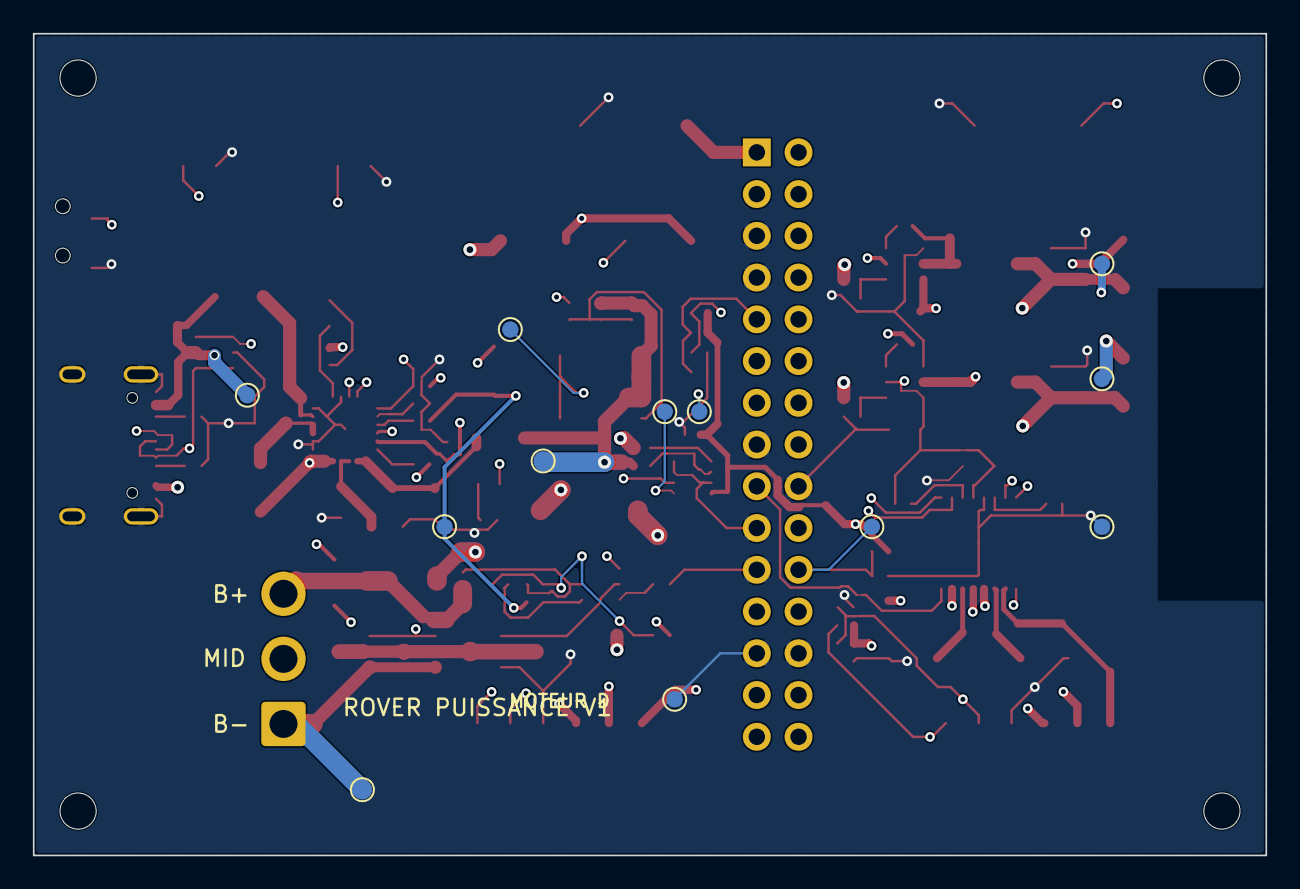
[picture p15: board rover_puissance.kicad_pcb from below]

Board: 4 copper layers, 75.0 x 50.0 mm, 109 parts (12 on the bottom side), 69 nets.
