RaphaelGrj/Rover-Project/esp32/src/main.cpp

#include <Arduino.h>
#include <Wire.h>
#include "board_config.h"
#include "motion_config.h"
#include "sensors_config.h"
#include "head_config.h"
#include "RoverProtocol.h"
#include "LinkAuth.h"
#include "HeartbeatMonitor.h"
#include "Watchdog.h"
#include "Diagnostics.h"
#include "DriveController.h"
#include "HeadController.h"
#include "DisplayEngine.h"
#include "Emotion.h"
#include "SensorHub.h"
#include "EStop.h"
#include "BatteryMonitor.h"
#include "RoverNetwork.h"
#include "RoverOTA.h"
#include "RoverWifiProvisioning.h"
#include "StandaloneControl.h"
#include "WifiCredentialsStore.h"
#include "CalibrationStore.h"
#include "Buzzer.h"

// RoverProtocol takes a Stream&, never a HardwareSerial& -- that is what
// keeps the transport swappable (ROVER_PROTOCOL.md section 2). The Pi is
// deported over WiFi since 2026-09-15 (ARCHITECTURE_AND_ROADMAP.md
// section 6.2), so this is meant to become a WiFiClient (also a Stream),
// with Serial kept as the fallback. NOT DONE YET: the firmware still
// speaks over the USB cable only -- see the "Pi deporte" work item in
// PROGRESS.md for the intended order (transport first, measure, then
// tune the heartbeat thresholds).
RoverProtocol protocol(Serial);
// Access control for that link (LinkAuth.h,
// ARCHITECTURE_AND_ROADMAP.md section 6.2 "5 bis"). Inert as long as
// the transport is the USB cable -- see requireAuth() in setup() -- so
// today's behaviour is unchanged; it becomes load-bearing the moment
// the transport is a socket anyone on the WiFi can open.
LinkAuth linkAuth;
HeartbeatMonitor heartbeat;
RoverState state = RoverState::BOOT;
DriveController drive;
HeadController head;
DisplayEngine display;
SensorHub sensors;
EStop estop;
BatteryMonitor battery;
// Owns the WiFi station link since 2026-09-20 -- OTA and (next) the
// socket transport are clients of it, never the other way round. See
// RoverNetwork.h and ARCHITECTURE_AND_ROADMAP.md section 6.2 "5 ter"
// for why the command link could not stay dependent on the optional
// OTA module.
RoverNetwork network;
RoverOTA ota;
RoverWifiProvisioning wifiProvisioning;
StandaloneControl standalone;
Buzzer buzzer;
// How long without any valid frame from the Pi before Rover offers its
// own piloting AP (StandaloneControl.h). Deliberately far longer than
// ROVER_HEARTBEAT_TIMEOUT_MS: that one is a safety reflex measured in
// hundreds of milliseconds, this is "the Pi is really not coming back",
// and raising an access point on every brief WiFi hiccup would be both
// useless and a standing door onto the robot.
constexpr unsigned long ROVER_STANDALONE_FALLBACK_MS = 30000;
// When the *Pi* last sent a valid frame -- tracked separately from
// HeartbeatMonitor, which is fed by the standalone page too. Using the
// monitor here would be circular: the page keeps it fresh, so the robot
// would keep concluding the Pi was back and shut the AP down mid-drive.
// Starts at 0, so before the first frame this reads as "time since
// boot" -- which is what makes "powered on with no Pi at all" reach the
// fallback, the primary case standalone piloting exists for.
unsigned long lastPiFrameMs = 0;
unsigned long lastTelemetryMs = 0;
unsigned long lastSensorTelemetryMs = 0;
unsigned long lastBatteryTelemetryMs = 0;

// Publishes the ESP32's own state machine (board_config.h) to whoever
// is listening, on CHANGE only.
//
// Why it exists: a robot in SAFE ignores every MOVE by design, and
// until now the only way to learn that from the outside was to ask for
// it (SYSTEM action=diag) or to catch the one EVENT that caused it. Miss
// that event -- a client connecting after the fact, a frame lost on the
// WiFi link -- and "the motors do not turn" is indistinguishable from a
// dead driver. Seven sessions of motor diagnosis are the argument for
// making this visible for free.
//
// Edge-driven, not periodic, so the steady-state cost is zero frames:
// the Pi merges STATE fields and replays them to late-joining clients
// (rover_core/core.py), so one frame per transition is enough to keep
// every UI correct.
void publishStateIfChanged() {
    static RoverState lastPublished = RoverState::BOOT;
    static bool lastEstop = false;
    static float lastMaxSpeed = -1.0f;
    static bool everPublished = false;
    bool estopNow = estop.isPressed();
    float maxSpeedNow = drive.maxSpeed();
    if (everPublished && lastPublished == state && lastEstop == estopNow &&
        lastMaxSpeed == maxSpeedNow) {
        return;
    }
    lastPublished = state;
    lastEstop = estopNow;
    lastMaxSpeed = maxSpeedNow;
    everPublished = true;
    // max_speed rides along because a control page cannot scale its own
    // speed bar sensibly without it: the ceiling is calibrated per robot
    // now (SYSTEM action=set_speed), so a hardcoded UI constant would go
    // stale the moment someone re-measures.
    char fields[64];
    snprintf(fields, sizeof(fields), "state=%s estop=%d max_speed=%.3f",
             roverStateName(state), estopNow ? 1 : 0, maxSpeedNow);
    protocol.send("STATE", fields);
}

// Same idea as publishStateIfChanged, for the obstacle flags: they move
// on an event (a sensor crossing a threshold, an operator flipping the
// reflex off), not continuously, so re-sending them 5x a second with the
// wheel speeds bought nothing -- and once the speeds gained the decimals
// they needed, the two together overran ROVER_MAX_FRAME_LEN anyway.
void publishObstacleIfChanged() {
    static char lastFields[64] = "";
    char fields[64];
    drive.buildObstacleFields(fields, sizeof(fields));
    if (strcmp(fields, lastFields) == 0) return;
    strncpy(lastFields, fields, sizeof(lastFields) - 1);
    lastFields[sizeof(lastFields) - 1] = '\0';
    protocol.send("STATE", fields);
}

// Called by RoverProtocol for every validated incoming frame.
void onFrame(const RoverFrame& frame) {
    // Access control runs BEFORE anything else, heartbeat included.
    // The ordering is the security property, not a detail: resetting
    // the heartbeat first would let an unauthenticated peer hold the
    // robot in ACTIVE indefinitely just by talking to it, which is
    // precisely the safety timeout it must not be able to reach.
    switch (linkAuth.evaluate(frame)) {
        case LinkAuth::Decision::Rejected:
            // One attempt, then the caller is expected to drop the
            // connection -- an open socket to keep guessing on is not
            // much better than no authentication at all. Dropping it is
            // the socket transport's job (step 1 of the chantier);
            // today the transport is a cable with nothing to drop, so
            // this reports and ignores, which is the correct behaviour
            // for a peer that has no business being here either way.
            protocol.sendError(linkAuth.reason());
            return;
        case LinkAuth::Decision::Accepted:
            // AUTH is consumed here, never dispatched as a command --
            // but it IS proof of life, so it feeds the heartbeat like
            // any other valid frame before we return.
            heartbeat.reset();
            lastPiFrameMs = millis();
            protocol.send("STATE", "link=authenticated");
            return;
        case LinkAuth::Decision::Allow:
            break;
    }

    // Any valid frame counts as proof of life from the Pi.
    heartbeat.reset();
    // Separately from the heartbeat above, which the standalone page
    // also feeds -- see lastPiFrameMs's declaration.
    lastPiFrameMs = millis();
    // First frame after boot promotes us out of READY; SAFE can only be
    // left via an explicit SYSTEM action=resume (see below), not just
    // because traffic resumed -- avoids silently un-safing the robot.
    // Guarded on the E-stop too: if the button is already held down at
    // boot, the very first frame must not promote straight to ACTIVE
    // just because loop()'s own estop check hasn't run yet this cycle.
    if (state == RoverState::READY && !estop.isPressed()) {
        state = RoverState::ACTIVE;
    }

    if (strcmp(frame.type, "HEARTBEAT") == 0) {
        return;
    }

    if (strcmp(frame.type, "SYSTEM") == 0) {
        char action[16];
        if (!frame.getField("action", action, sizeof(action))) return;

        if (strcmp(action, "ping") == 0) {
            protocol.send("SYSTEM", "action=pong");
        } else if (strcmp(action, "resume") == 0) {
            // A resume must never override a physically-held E-stop --
            // that would defeat the entire point of a hardware safety
            // layer. Only the heartbeat-timeout SAFE can be resumed this
            // way; releasing the button is necessary but not itself
            // sufficient (still requires this same explicit resume).
            //
            // The refusal is now REPORTED rather than silently dropped
            // (2026-09-21): an ignored resume and an accepted one looked
            // identical from the Pi, so "I pressed Activer and nothing
            // happened" had no answer. Not an error when we are already
            // ACTIVE -- the caller got what it asked for.
            if (estop.isPressed()) {
                protocol.sendError("estop_held");
            } else if (state == RoverState::SAFE) {
                state = RoverState::ACTIVE;
            }
        } else if (strcmp(action, "diag") == 0) {
            char fields[96];
            buildDiagnosticsFields(fields, sizeof(fields), state);
            protocol.send("STATE", fields);
        } else if (strcmp(action, "set_pid") == 0) {
            // Runtime PID tuning without a reflash per attempt -- any
            // field left out keeps its current value (getFloat's
            // default), so eg. "set_pid kp=200" alone only touches Kp.
            float kp = frame.getFloat("kp", drive.pidKp());
            float ki = frame.getFloat("ki", drive.pidKi());
            float kd = frame.getFloat("kd", drive.pidKd());
            // kff is the feed-forward gain (PWM per m/s), see
            // WheelPID::update -- tunable here like the rest, since it
            // is the term that decides whether a commanded speed
            // produces a usable duty at once or seconds later.
            float kff = frame.getFloat("kff", drive.pidKff());
            if (isnan(kp) || isinf(kp) || isnan(ki) || isinf(ki) || isnan(kd) || isinf(kd) ||
                isnan(kff) || isinf(kff) ||
                kp < 0.0f || ki < 0.0f || kd < 0.0f || kff < 0.0f) {
                protocol.sendError("invalid_pid_gains");
            } else {
                drive.setPidGains(kp, ki, kd, kff);
                CalibrationStore::setFloat("pid_kp", kp);
                CalibrationStore::setFloat("pid_ki", ki);
                CalibrationStore::setFloat("pid_kd", kd);
                CalibrationStore::setFloat("pid_kff", kff);
                char fields2[96];
                snprintf(fields2, sizeof(fields2), "pid_kp=%.2f pid_ki=%.2f pid_kd=%.2f pid_kff=%.2f",
                         kp, ki, kd, kff);
                protocol.send("STATE", fields2);
            }
        } else if (strcmp(action, "get_pid") == 0) {
            char fields2[96];
            snprintf(fields2, sizeof(fields2), "pid_kp=%.2f pid_ki=%.2f pid_kd=%.2f pid_kff=%.2f",
                     drive.pidKp(), drive.pidKi(), drive.pidKd(), drive.pidKff());
            protocol.send("STATE", fields2);
        } else if (strcmp(action, "reset_pid") == 0) {
            // Reverts to the compiled-in placeholders (motion_config.h)
            // and forgets the NVS override, rather than just resetting
            // the in-memory value -- a reboot after this must not bring
            // the old override back.
            drive.setPidGains(ROVER_PID_KP, ROVER_PID_KI, ROVER_PID_KD, ROVER_PID_KFF);
            CalibrationStore::remove("pid_kp");
            CalibrationStore::remove("pid_ki");
            CalibrationStore::remove("pid_kd");
            CalibrationStore::remove("pid_kff");
            char fields2[96];
            snprintf(fields2, sizeof(fields2), "pid_kp=%.2f pid_ki=%.2f pid_kd=%.2f pid_kff=%.2f",
                     ROVER_PID_KP, ROVER_PID_KI, ROVER_PID_KD, ROVER_PID_KFF);
            protocol.send("STATE", fields2);
        } else if (strcmp(action, "motor_raw") == 0) {
            // Bring-up only: fixed duty straight to the H-bridge, no
            // PID, no encoder feedback, self-stopping.
            //
            // The PID's own output cannot diagnose a motionless wheel:
            // it saturates at 255 BECAUSE nothing moves, so a jam, a
            // dead driver and a miswired encoder all look identical
            // from telemetry. A fixed duty removes the loop from the
            // picture -- if the wheel still does not turn, everything
            // upstream of the H-bridge is cleared.
            //
            //   SYSTEM action=motor_raw left=200 right=200 ms=2000
            //
            // Honours SAFE like any other actuation: a raw duty is
            // still the robot moving, and must not be a way around the
            // safety state (ARCHITECTURE_AND_ROADMAP.md section 27).
            if (state != RoverState::ACTIVE) {
                protocol.sendError("not_active");
            } else {
                long leftPwm = frame.getInt("left", 0);
                long rightPwm = frame.getInt("right", 0);
                long ms = frame.getInt("ms", 1500);
                drive.driveRaw((int16_t)leftPwm, (int16_t)rightPwm, (unsigned long)ms);
                char fields2[80];
                snprintf(fields2, sizeof(fields2), "motor_raw_left=%ld motor_raw_right=%ld motor_raw_ms=%ld",
                         leftPwm, rightPwm, ms);
                protocol.send("STATE", fields2);
            }
        } else if (strcmp(action, "set_speed") == 0) {
            // Re-calibrates the top speed a MOVE may ask for, without a
            // reflash -- same reasoning as set_pid, and for a constant
            // that turned out to matter just as much: a ceiling above
            // what the wheels can actually do makes every command an
            // unreachable setpoint, pins the PWM at 255 and leaves the
            // speed bar with no authority at all (see
            // ROVER_MAX_WHEEL_SPEED_MPS).
            //
            //   SYSTEM action=set_speed max=0.045
            //
            // Measure it with reset_ticks -> motor_raw left=255
            // right=255 ms=10000 -> raw_ticks, cold.
            float maxMps = frame.getFloat("max", -1.0f);
            if (isnan(maxMps) || isinf(maxMps) || maxMps <= 0.0f) {
                protocol.sendError("invalid_max_speed");
            } else {
                drive.setMaxSpeed(maxMps);
                CalibrationStore::setFloat("max_speed", drive.maxSpeed());
                publishStateIfChanged();
            }
        } else if (strcmp(action, "reset_speed") == 0) {
            drive.setMaxSpeed(ROVER_MAX_WHEEL_SPEED_MPS);
            CalibrationStore::remove("max_speed");
            publishStateIfChanged();
        } else if (strcmp(action, "obstacle_reflex") == 0) {
            // Arms/disarms the LOCAL obstacle reflex
            // (DriveController::setObstacleReflexEnabled) without
            // touching the sensors: distances keep being measured and
            // reported either way, only the clamp on forward motion
            // changes. See that method for why a safety clamp is
            // allowed a switch at all, and why this is not persisted.
            //
            //   SYSTEM action=obstacle_reflex on=0
            //
            // A missing on= reads as 1: if a frame ever arrives garbled
            // enough to lose the field, the safe reading is "armed".
            drive.setObstacleReflexEnabled(frame.getInt("on", 1) != 0);
            publishObstacleIfChanged();
        } else if (strcmp(action, "raw_ticks") == 0) {
            // Bring-up only: raw cumulative encoder counts, untouched by
            // the PID loop's 20ms readAndResetTicks() -- lets a hand
            // rotation of a known number of turns be counted precisely,
            // to measure the real ROVER_ENCODER_TICKS_PER_REV instead of
            // the motion_config.h placeholder. See action=reset_ticks.
            // Edge counts alongside the tick counts, because the two
            // answer different questions and only their RATIO catches
            // the failure mode that matters here. A tick counter can
            // sit near zero for two opposite reasons: nothing is
            // turning, or a floating input is toggling so fast that the
            // +1/-1 decisions cancel out. GPIO34-39 have no internal
            // pull-up (Encoder::begin), so a connector that has worked
            // loose -- which this robot has form for -- leaves the pin
            // floating and the ISR firing continuously, starving the
            // very loop() that drives the motors. Edges climbing while
            // ticks stay flat is that, unambiguously.
            // 128, not 96: four counters at their full width need 107
            // bytes, and 96 would have cut the last one -- on the very
            // command whose worst case (an edge counter running away on
            // a floating input) is also its EXPECTED case. Same class of
            // bug as the three truncations already noted in this file,
            // caught here by counting instead of by hardware.
            char fields2[128];
            snprintf(fields2, sizeof(fields2),
                     "raw_ticks_left=%ld raw_ticks_right=%ld raw_edges_left=%lu raw_edges_right=%lu",
                     drive.rawTicksLeft(), drive.rawTicksRight(),
                     drive.rawEdgesLeft(), drive.rawEdgesRight());
            protocol.send("STATE", fields2);
        } else if (strcmp(action, "reset_ticks") == 0) {
            drive.resetRawTicks();
            protocol.send("STATE", "raw_ticks_left=0 raw_ticks_right=0");
        } else if (strcmp(action, "i2c_scan") == 0) {
            // Bring-up only: lists every address that ACKs a zero-length
            // transaction (same check as I2CProbe.h's i2cDevicePresent),
            // so a sensor's real address can be found directly instead of
            // guessing from datasheet/library defaults one at a time.
            char fields[128];
            int len = snprintf(fields, sizeof(fields), "i2c_found=");
            bool any = false;
            for (uint8_t addr = 0x03; addr <= 0x77 && len < (int)sizeof(fields) - 6; addr++) {
                Wire.beginTransmission(addr);
                if (Wire.endTransmission() == 0) {
                    len += snprintf(fields + len, sizeof(fields) - len, "%s0x%02X", any ? "," : "", addr);
                    any = true;
                }
            }
            if (!any) snprintf(fields + len, sizeof(fields) - len, "none");
            protocol.send("STATE", fields);
        } else if (strcmp(action, "bme_chip_id") == 0) {
            // Bring-up only: reads the raw chip-id register (0xD0) the
            // BME68x driver itself checks against 0x61 before accepting
            // the sensor -- narrows "begin() fails" down to "wrong chip
            // id" (clone/different part) vs. "register read itself
            // failed" (bus/timing) vs. "soft-reset write failed" (can't
            // tell apart from this alone, but chip_id=0xFF/no ACK here
            // points at a bus-level problem beyond the simple probe).
            Wire.beginTransmission(ROVER_ENV_SENSOR_ADDRESS);
            Wire.write((uint8_t)0xD0);
            uint8_t err = Wire.endTransmission(false);
            char fields[48];
            if (err != 0) {
                snprintf(fields, sizeof(fields), "bme_chip_id_error=%d", err);
            } else {
                Wire.requestFrom((uint8_t)ROVER_ENV_SENSOR_ADDRESS, (uint8_t)1);
                if (Wire.available()) {
                    uint8_t id = Wire.read();
                    snprintf(fields, sizeof(fields), "bme_chip_id=0x%02X", id);
                } else {
                    snprintf(fields, sizeof(fields), "bme_chip_id=no_response");
                }
            }
            protocol.send("STATE", fields);
        } else if (strcmp(action, "wifi_setup") == 0) {
            // Opens the on-demand config portal (RoverWifiProvisioning.h)
            // -- a temporary AP any PC/phone can join to enter the real
            // WiFi/OTA credentials. Never automatic at boot, only via
            // this explicit request (see that file's header comment for
            // why). Interrupts any active OTA connection, since both
            // share the same WiFi radio.
            wifiProvisioning.start();
            protocol.send("STATE", "wifi_mode=setup");
        } else if (strcmp(action, "wifi_status") == 0) {
            // 96, not 64: "wifi_mode=setup ap_ssid=Rover-Setup-XXXXXX
            // ap_started=1 ap_ip=255.255.255.255" alone is ~75 bytes --
            // a bring-up test on real hardware caught this being
            // silently truncated mid-field by too small a buffer (same
            // class of bug as the ERROR/STATE buffers in Phase 4).
            char fields2[96];
            if (wifiProvisioning.isActive()) {
                wifiProvisioning.buildStatusFields(fields2, sizeof(fields2));
            } else if (standalone.isActive()) {
                standalone.buildStatusFields(fields2, sizeof(fields2));
            } else {
                ota.buildStatusFields(fields2, sizeof(fields2), network.isConnected());
            }
            protocol.send("STATE", fields2);
        } else if (strcmp(action, "standalone") == 0) {
            // Manual entry, mainly for testing the mode without waiting
            // out ROVER_STANDALONE_FALLBACK_MS -- and for deliberately
            // handing the robot over to a phone before walking away
            // from the Pi. Note this drops the station link, so over a
            // WiFi Rover Protocol link this command is one-way: the
            // reply below may not reach the Pi.
            if (standalone.start()) {
                char fields2[96];
                standalone.buildStatusFields(fields2, sizeof(fields2));
                protocol.send("STATE", fields2);
            } else {
                protocol.sendError("standalone_no_password");
            }
        } else if (strcmp(action, "standalone_off") == 0) {
            standalone.stop();
            protocol.send("STATE", "wifi_mode=idle");
        } else if (strcmp(action, "servo") == 0) {
            // Bring-up only: drives ONE head servo at a time and
            // releases the other. Rover's head is a TANDEM mount --
            // two servos facing each other, both bolted to the SAME
            // part, one mechanical degree of freedom (confirmed on the
            // robot 2026-09-20). Commanding both from the pitch/yaw
            // model would have them pull the shared part in opposite
            // directions and stall against each other, so head motion
            // stays disabled until the mount is characterised, and this
            // is how it gets characterised safely: the servo that is
            // not moving has no pulse train at all, hence no torque,
            // hence nothing to fight with.
            //
            //   SYSTEM action=servo which=a angle=10
            //   SYSTEM action=servo which=off        (both released)
            char which[8];
            if (!frame.getField("which", which, sizeof(which))) {
                protocol.sendError("servo_which_required");
            } else if (strcmp(which, "off") == 0) {
                head.releaseAll();
                char fields2[144];
                head.buildStatusFields(fields2, sizeof(fields2));
                protocol.send("STATE", fields2);
            } else if (strcmp(which, "ab") == 0) {
                // Independent angles, for measuring the offset between
                // the two horns -- see HeadController::driveIndependent.
                //   SYSTEM action=servo which=ab a=-5 b=5
                if (!frame.hasField("a") || !frame.hasField("b")) {
                    protocol.sendError("servo_ab_required");
                } else {
                    head.driveIndependent(frame.getFloat("a", 0.0f), frame.getFloat("b", 0.0f));
                    char fields2[144];
                    head.buildStatusFields(fields2, sizeof(fields2));
                    protocol.send("STATE", fields2);
                }
            } else if (strcmp(which, "pair") == 0) {
                // Both servos, mirrored -- the mechanically correct
                // command for this tandem head. See
                // HeadController::driveTandem.
                if (!frame.hasField("angle")) {
                    protocol.sendError("servo_angle_required");
                } else {
                    head.driveTandem(frame.getFloat("angle", 0.0f));
                    char fields2[144];
                    head.buildStatusFields(fields2, sizeof(fields2));
                    protocol.send("STATE", fields2);
                }
            } else if (strcmp(which, "a") == 0 || strcmp(which, "b") == 0) {
                // No default angle: a missing angle= must not silently
                // mean 0 and swing the head to centre unannounced.
                if (!frame.hasField("angle")) {
                    protocol.sendError("servo_angle_required");
                } else {
                    head.driveSingleJoint(which[0], frame.getFloat("angle", 0.0f));
                    char fields2[144];
                    head.buildStatusFields(fields2, sizeof(fields2));
                    protocol.send("STATE", fields2);
                }
            } else {
                protocol.sendError("servo_which_invalid");
            }
        } else if (strcmp(action, "pintest") == 0) {
            // Bring-up only: forces one SERVO pin to a steady logic
            // level so it can be checked with a multimeter. A servo's
            // PWM is a 7.5% duty cycle at 50Hz -- about 0.25V average,
            // awkward to read and easy to mistake for a dead pin. A
            // steady 3.3V or 0V is unambiguous.
            //
            // Restricted to the two head servo pins on purpose: a
            // generic "write any pin" would happily drive a motor
            // input and move the robot.
            //   SYSTEM action=pintest pin=19 level=1
            long pin = frame.getInt("pin", -1);
            long level = frame.getInt("level", 0);
            // Motor inputs are allowed too since 2026-09-20: with the
            // wheels dead even under raw PWM, the question became
            // whether the PAD itself emits anything -- GPIO19 turned
            // out not to, on this very board. digitalWrite bypasses
            // LEDC entirely, so it separates "the PWM peripheral is
            // misconfigured" from "the pin is dead".
            //
            // WARNING: a motor input held high runs that motor at full
            // speed with no ramp. Caller is expected to have the robot
            // propped up -- same precondition as motor_raw.
            bool allowed = (pin == ROVER_PIN_SERVO_PITCH || pin == ROVER_PIN_SERVO_YAW ||
                            pin == ROVER_PIN_MOTOR_L_IN1 || pin == ROVER_PIN_MOTOR_L_IN2 ||
                            pin == ROVER_PIN_MOTOR_R_IN1 || pin == ROVER_PIN_MOTOR_R_IN2);
            if (!allowed) {
                protocol.sendError("pintest_pin_not_allowed");
            } else {
                // Detach the LEDC channel first, otherwise the PWM
                // peripheral keeps driving the pad and digitalWrite is
                // ignored.
                head.releaseAll();
                pinMode((int)pin, OUTPUT);
                digitalWrite((int)pin, level ? HIGH : LOW);
                // digitalWrite DETACHES the pad from LEDC, and nothing
                // puts it back: after testing a motor input this way,
                // that motor stops responding to PWM until the next
                // reboot. Found the hard way on 2026-09-20 -- it turned
                // an already-confusing motor diagnosis into a moving
                // target. Re-arming the drive here restores the LEDC
                // attachment straight away.
                if (pin != ROVER_PIN_SERVO_PITCH && pin != ROVER_PIN_SERVO_YAW) {
                    drive.begin();
                }
                char fields2[64];
                snprintf(fields2, sizeof(fields2), "pintest_pin=%ld pintest_level=%ld", pin, level);
                protocol.send("STATE", fields2);
            }
        } else if (strcmp(action, "head_origin") == 0) {
            // Freezes the angles currently commanded as the head's
            // reference position and writes them to NVS, so every later
            // HEAD/tandem angle is measured from there rather than from
            // wherever the horns happened to land on their splines.
            head.setOriginHere();
            char fields2[144];
            head.buildStatusFields(fields2, sizeof(fields2));
            protocol.send("STATE", fields2);
        } else if (strcmp(action, "head_status") == 0) {
            char fields2[144];
            head.buildStatusFields(fields2, sizeof(fields2));
            protocol.send("STATE", fields2);
        } else if (strcmp(action, "tof_status") == 0 || strcmp(action, "tof_rescan") == 0) {
            // Bring-up only. The two VL53L0X share a factory address
            // and are separated by a single XSHUT line
            // (DistanceSensor::bringUpBoth) -- a sequence with four
            // distinct failure modes that all look identical from the
            // outside ("distance_left=9999"). This reports what each
            // step of that sequence actually saw. tof_rescan replays it
            // first, so a sensor plugged in after boot can be picked up
            // without waiting out the retry period or rebooting.
            if (strcmp(action, "tof_rescan") == 0) sensors.rescanDistanceSensors();
            // 128, not 96: five tof_* fields plus tof_rbegin run to
            // ~75 bytes, and this file's three historical truncation
            // bugs all came from exactly that kind of thin margin.
            char fields2[128];
            sensors.buildToFBringUpFields(fields2, sizeof(fields2));
            protocol.send("STATE", fields2);
        } else if (strcmp(action, "net_status") == 0) {
            // Link health as seen from the robot itself: a deported Pi
            // cannot read the ESP32's console, so "how often does this
            // link actually drop, and how strong is the signal where
            // the robot currently is?" has to be answerable from
            // telemetry alone. This is the instrument step 2 of the
            // deported-Pi chantier needs (measure the link before
            // tuning the heartbeat thresholds of section 9).
            char fields2[96];
            network.buildStatusFields(fields2, sizeof(fields2));
            protocol.send("STATE", fields2);
        } else if (strcmp(action, "wifi_forget") == 0) {
            // Clears the stored home-network credentials (keeps the OTA
            // password, see WifiCredentialsStore::forgetNetwork) so the
            // next wifi_setup starts from a clean SSID field. Does not
            // itself reboot or touch the current connection.
            WifiCredentialsStore::forgetNetwork();
            protocol.send("STATE", "wifi_mode=forgotten");
        }
        return;
    }

    if (strcmp(frame.type, "MOVE") == 0) {
        // Only honored while ACTIVE: a MOVE arriving during SAFE must
        // never re-arm the motors (ARCHITECTURE_AND_ROADMAP.md section
        // 27 rule 6, "préserver le fonctionnement du mode SAFE") --
        // only an explicit SYSTEM action=resume can do that.
        if (state == RoverState::ACTIVE) {
            float velocity = frame.getFloat("velocity", 0.0f);
            float rotation = frame.getFloat("rotation", 0.0f);
            drive.setTarget(velocity, rotation);
        }
        return;
    }

    if (strcmp(frame.type, "HEAD") == 0) {
        // Same gating as MOVE, for the same reason: never obey a stale
        // command during SAFE, only an explicit resume re-arms it.
        if (state == RoverState::ACTIVE) {
            float pitch = frame.getFloat("pitch", 0.0f);
            float yaw = frame.getFloat("yaw", 0.0f);
            head.setTarget(pitch, yaw);
        }
        return;
    }

    if (strcmp(frame.type, "FACE") == 0) {
        // Not gated on ACTIVE/SAFE: showing an emotion has no physical
        // safety implication the way motor/servo motion does.
        char emotionName[16];
        Emotion emotion;
        if (frame.getField("emotion", emotionName, sizeof(emotionName)) &&
            parseEmotion(emotionName, emotion)) {
            display.setEmotion(emotion);
        }
        return;
    }

    if (strcmp(frame.type, "ANIMATION") == 0) {
        char animationName[16];
        if (frame.getField("name", animationName, sizeof(animationName))) {
            display.playAnimation(animationName);
        }
        return;
    }

    // AUDIO/LIGHT are dispatched to their own modules once those exist.
}

void setup() {
    // 2048 instead of the default 256, and it MUST be set before
    // begin(). At 115200 baud, 256 bytes is only ~22ms of traffic --
    // less than one full ST7789 redraw (240x280 at 16bpp over 40MHz
    // SPI is ~27ms), during which loop() never gets to drain the port.
    // Bytes arriving in that window were simply dropped, truncating
    // whatever frame was in flight; the receiver then failed its
    // checksum. Seen on real hardware 2026-09-20 as a steady
    // "ERROR code=checksum_invalid" every ~5s while driving from the
    // joystick page -- exactly the blink/redraw cadence.
    //
    // This is a buffer, not a fix for a blocking redraw: it buys ~178ms
    // of slack, which covers the display today. The real answer, if
    // loop() ever stalls longer than that, is to stop blocking in the
    // first place (incremental redraw / DMA).
    Serial.setRxBufferSize(2048);
    Serial.begin(115200);
    RoverWatchdog::begin();
    protocol.onFrame(onFrame);
    // Load the shared secret now, while the transport is still the USB
    // cable: provisioning it (SYSTEM action=wifi_setup) must be
    // possible BEFORE the link that needs it exists, otherwise the
    // first socket connection would have no way to ever authenticate.
    linkAuth.setSecret(WifiCredentialsStore::getLinkSecret().c_str());
    // Explicitly disabled, because the transport is a cable: physical
    // access IS the authentication here, and demanding a secret over
    // USB would lock out bring-up tooling (pi/tools/move_diagnostic.py,
    // a plain serial terminal) for no gain. The socket transport will
    // flip this to true per connection -- see ARCHITECTURE_AND_ROADMAP.md
    // section 6.2 "5 bis" and step 1 of the chantier in PROGRESS.md.
    linkAuth.requireAuth(false);
    // Attaches motor/encoder pins and immediately commands 0 speed, so
    // the driver never has stale/undefined PWM before the first MOVE.
    drive.begin();
    // Any PID gains saved via a previous SYSTEM action=set_pid survive
    // reboots -- falls back to the compiled defaults (motion_config.h)
    // when nothing has ever been stored (first boot, or after
    // action=reset_pid).
    drive.setPidGains(
        CalibrationStore::getFloat("pid_kp", ROVER_PID_KP),
        CalibrationStore::getFloat("pid_ki", ROVER_PID_KI),
        CalibrationStore::getFloat("pid_kd", ROVER_PID_KD),
        CalibrationStore::getFloat("pid_kff", ROVER_PID_KFF)
    );
    // Same treatment for the speed ceiling: the compiled default is one
    // measurement (see ROVER_MAX_WHEEL_SPEED_MPS), and re-measuring it
    // must not need a reflash.
    drive.setMaxSpeed(CalibrationStore::getFloat("max_speed", ROVER_MAX_WHEEL_SPEED_MPS));
    head.begin();
    // Servo horn positions survive reboots; the mechanical origin they
    // imply must too (HeadController::loadOrigin).
    head.loadOrigin();
    display.begin();
    sensors.begin();
    estop.begin();
    battery.begin();
    buzzer.begin();
    // Entirely opt-in (see RoverNetwork.h) -- a no-op with zero radio
    // activity unless WiFi credentials were provisioned through the
    // portal or set at build time. Non-blocking since 2026-09-20: it
    // starts connecting and returns, where the old RoverOTA::begin()
    // stalled the whole boot for up to 10s waiting for a network.
    //
    // OTA arms itself on every successful connection rather than only
    // on one completed during the boot window -- a robot powered on
    // before its router used to stay un-flashable until a power cycle.
    network.onConnected = []() { ota.arm(); };
    network.begin();

    // Radio arbitration: the provisioning portal and standalone
    // piloting both need AP mode, which cannot coexist with the station
    // link. They announce the borrow/return and RoverNetwork stands
    // down in between, so no two modules ever fight over WiFi.mode().
    wifiProvisioning.onRadioTaken = []() { network.suspend(); };
    wifiProvisioning.onRadioReleased = []() { network.resume(); };
    standalone.onRadioTaken = []() { network.suspend(); };
    standalone.onRadioReleased = []() { network.resume(); };

    // Standalone piloting (StandaloneControl.h): every callback below
    // routes into the SAME code the Pi's frames go through, rather than
    // reaching into the motors directly. That is the whole safety
    // argument for this mode -- there is no second control path that
    // could drift out of agreement with the first one.
    standalone.onHeartbeat = []() {
        // A request from the page is proof of life exactly like a frame
        // from the Pi, so it feeds the same monitor and the same
        // timeout stops the motors when the tab closes or the phone
        // walks out of range.
        heartbeat.reset();
    };
    standalone.onMove = [](float velocity, float rotation) {
        // Same ACTIVE gate as a MOVE frame: a page left open must not
        // re-arm a robot sitting in SAFE.
        if (state == RoverState::ACTIVE) drive.setTarget(velocity, rotation);
    };
    standalone.onLook = [](float pitch, float yaw) {
        if (state == RoverState::ACTIVE) head.setTarget(pitch, yaw);
    };
    standalone.onResume = []() {
        // Same E-stop guard as SYSTEM action=resume -- the operator is
        // standing next to the robot here, which makes honouring a held
        // button more important, not less.
        //
        // One deliberate difference: READY is accepted too, which the
        // Pi's resume does not allow. Normally the Pi's first frame is
        // what promotes READY -> ACTIVE, so a robot powered on with no
        // Pi at all would sit in READY forever and this whole mode
        // would be unusable in exactly the case it exists for. The
        // press on "Activer" is the equivalent explicit act.
        if ((state == RoverState::SAFE || state == RoverState::READY) && !estop.isPressed()) {
            state = RoverState::ACTIVE;
        }
    };
    standalone.onStop = []() {
        drive.stop();
        state = RoverState::SAFE;
    };
    standalone.onObstacleReflex = [](bool enabled) {
        // Same switch the Pi reaches through SYSTEM action=obstacle_reflex
        // -- one setting, one owner, no second code path that could end
        // up disagreeing with the first.
        drive.setObstacleReflexEnabled(enabled);
    };
    standalone.statusProvider = []() {
        // Shown verbatim on the page: without this, an obstacle reflex
        // reads as "the robot ignores my joystick". Three cases, not
        // two, since the reflex became switchable -- "a sensor sees
        // something but we were told to drive anyway" is worth saying
        // out loud rather than looking identical to a clear path.
        String status = roverStateName(state);
        if (drive.forwardBlocked()) {
            status += " | obstacle: marche avant bloquee";
        } else if (drive.obstacleSeen()) {
            status += " | obstacle vu, reflexe DESACTIVE";
        } else if (!drive.obstacleReflexEnabled()) {
            status += " | reflexe obstacle desactive";
        }
        return status;
    };

    char fields[64];
    snprintf(fields, sizeof(fields), "protocol=%s board=%s state=BOOT",
             ROVER_PROTOCOL_VERSION, ROVER_BOARD_NAME);
    protocol.send("SYSTEM", fields);

    // Report anything that failed to initialize right away (eg. a
    // sensor not wired yet) instead of waiting for loop()'s first pass.
    const char* failedSensor;
    while (sensors.consumeSensorFailure(&failedSensor)) {
        // 48, not 32: "code=sensor_timeout sensor=tof_right" alone is
        // 37 bytes with the terminator -- a first hardware test caught
        // this being silently truncated (mid-word) by too small a buffer.
        char errFields[48];
        snprintf(errFields, sizeof(errFields), "code=sensor_timeout sensor=%s", failedSensor);
        protocol.send("ERROR", errFields);
    }

    buzzer.play(BuzzerSound::BOOT);
    state = RoverState::READY;
    // First publication, so a Pi that was already listening knows what
    // it is talking to without asking (see publishStateIfChanged).
    publishStateIfChanged();
}

void loop() {
    protocol.poll();
    drive.update();
    head.update();
    display.update();
    sensors.update();
    estop.update();
    battery.update();
    // Before ota.update(): the supervisor decides whether the link is
    // up this pass, and OTA is only meaningful once it is.
    network.update();
    ota.update();
    wifiProvisioning.update();
    standalone.update();
    buzzer.update();

    // Standalone piloting fallback: after a long silence from the Pi,
    // Rover raises its own AP so it stays drivable by whoever is
    // standing next to it (ARCHITECTURE_AND_ROADMAP.md §6.3). Covers
    // both "the link died" and "there is no Pi at all" -- see
    // HeartbeatMonitor::millisSinceLast on why booting without a Pi
    // reaches this too.
    //
    // Never while the provisioning portal is up: both want the radio in
    // AP mode and port 80, and provisioning is an explicit operator
    // action that must not be interrupted by an automatic one.
    if (!standalone.isActive() && !wifiProvisioning.isActive() &&
        millis() - lastPiFrameMs >= ROVER_STANDALONE_FALLBACK_MS) {
        if (standalone.start()) {
            char fields[96];
            standalone.buildStatusFields(fields, sizeof(fields));
            protocol.send("STATE", fields);
            protocol.send("EVENT", "name=standalone_started");
        } else {
            // Refused for want of a stored password (StandaloneControl
            // never falls back to an open AP). Reported once per boot,
            // not every loop: with no Pi listening this frame may well
            // go nowhere, but the buzzer tells whoever is next to the
            // robot why no "Rover-Pilot-..." network is appearing.
            static bool refusalReported = false;
            if (!refusalReported) {
                refusalReported = true;
                protocol.send("EVENT", "name=standalone_unavailable reason=no_password");
                buzzer.play(BuzzerSound::LOW_BATTERY);
            }
        }
    }
    // The Pi came back -- hand the radio back rather than leaving an AP
    // open indefinitely. Reachable in practice over USB, or over WiFi
    // once the station link returns; AP mode drops the station link, so
    // this mostly matters for the wired case today.
    //
    // Guarded on isBeingUsed(): yanking the AP out from under someone
    // actively driving would stop the robot mid-manoeuvre (the page's
    // heartbeat dies with the network, so SAFE follows within
    // ROVER_HEARTBEAT_TIMEOUT_MS). Safe, but a nasty surprise for
    // whoever is holding the phone -- the Pi returning is not urgent
    // enough to justify it, so we wait for the operator to let go.
    if (standalone.isActive() && !standalone.isBeingUsed() &&
        millis() - lastPiFrameMs < ROVER_STANDALONE_FALLBACK_MS) {
        standalone.stop();
        protocol.send("EVENT", "name=standalone_stopped");
    }

    if (state == RoverState::ACTIVE && heartbeat.isTimedOut()) {
        state = RoverState::SAFE;
        drive.stop();
        protocol.send("EVENT", "name=heartbeat_timeout");
    }

    // Hardware E-stop takes priority over everything else and is
    // checked independently of the heartbeat timeout above -- it must
    // stop the robot even while the Pi link is perfectly healthy.
    static bool wasEstopPressed = false;
    if (estop.isPressed() && !wasEstopPressed) {
        state = RoverState::SAFE;
        drive.stop();
        protocol.send("EVENT", "name=estop_pressed");
        buzzer.play(BuzzerSound::ESTOP);
    }
    wasEstopPressed = estop.isPressed();

    // After every transition above (heartbeat timeout, E-stop) and
    // before the telemetry below -- on change only, so this costs
    // nothing while the state holds still.
    publishStateIfChanged();

    if (battery.hasReading()) {
        if (battery.consumeLowBatteryEvent()) {
            protocol.send("EVENT", "name=low_battery");
            buzzer.play(BuzzerSound::LOW_BATTERY);
        }
        unsigned long batteryNow = millis();
        if (batteryNow - lastBatteryTelemetryMs >= ROVER_BATTERY_UPDATE_PERIOD_MS) {
            lastBatteryTelemetryMs = batteryNow;
            char batteryFields[16];
            battery.buildTelemetryFields(batteryFields, sizeof(batteryFields));
            protocol.send("STATE", batteryFields);
        }
    }

    // Sensor EVENT/ERROR/STATE are never gated on ACTIVE/SAFE: unlike
    // MOVE/HEAD (physical actuation, must stay off outside ACTIVE),
    // situational awareness (obstacles, sensor health) stays useful to
    // the Pi even while the robot is stopped.
    const char* failedSensor;
    while (sensors.consumeSensorFailure(&failedSensor)) {
        // 48, not 32: "code=sensor_timeout sensor=tof_right" alone is
        // 37 bytes with the terminator -- a first hardware test caught
        // this being silently truncated (mid-word) by too small a buffer.
        char errFields[48];
        snprintf(errFields, sizeof(errFields), "code=sensor_timeout sensor=%s", failedSensor);
        protocol.send("ERROR", errFields);
    }
    // An encoder that just disabled itself (Encoder::pollStorm): a
    // floating input firing continuously starves this loop, so the
    // interrupt is dropped and the fact is reported rather than left to
    // look like a wheel that simply stopped counting. Re-armed only by
    // SYSTEM action=reset_ticks, once the wiring has been seen to.
    const char* stormedWheel;
    while (drive.consumeEncoderStorm(&stormedWheel)) {
        char errFields[48];
        snprintf(errFields, sizeof(errFields), "code=encoder_storm wheel=%s", stormedWheel);
        protocol.send("ERROR", errFields);
    }

    // LOCAL obstacle reflex -- the ESP32 refuses to drive further into an
    // obstacle by itself, without consulting the Pi. Level-driven (not
    // the edge event below) so the block holds for as long as the
    // obstacle is there, and releases on its own once it clears.
    //
    // Before 2026-09-15 this clamp existed ONLY on the Pi
    // (rover_core/core.py move()), which was fine while the Pi sat on
    // the robot at the end of a USB cable. With the Pi deported over
    // WiFi (ARCHITECTURE_AND_ROADMAP.md §6.2) a Pi-side-only reflex
    // would have to cross a lossy link to stop the robot hitting
    // something -- so it is duplicated here deliberately. The Pi keeps
    // its own clamp: two independent layers, neither load-bearing alone.
    //
    // Reads false while no ToF sensor is healthy, so this is inert until
    // the VL53L0X are actually wired and can never immobilize the robot
    // on a phantom reading from a missing sensor.
    drive.setForwardBlocked(sensors.obstacleDetected());
    // Straight after the sensors feed it, so a crossing is reported on
    // the same pass rather than a telemetry period later. On change
    // only, and never gated on ACTIVE: knowing WHY the robot refuses to
    // go forward matters most exactly when it is not moving.
    publishObstacleIfChanged();

    if (sensors.consumeObstacleEvent()) {
        protocol.send("EVENT", "name=obstacle_detected");
        buzzer.play(BuzzerSound::OBSTACLE);
    }

    unsigned long sensorNow = millis();
    if (sensorNow - lastSensorTelemetryMs >= ROVER_SENSOR_TELEMETRY_PERIOD_MS) {
        lastSensorTelemetryMs = sensorNow;
        // 96, not 64: the IMU's six fields alone need ~75 bytes even
        // with every value at "0.00" -- another truncation caught on
        // the same first hardware test as the ERROR buffer above.
        char sensorFields[96];
        sensors.buildDistanceFields(sensorFields, sizeof(sensorFields));
        protocol.send("STATE", sensorFields);
        sensors.buildImuFields(sensorFields, sizeof(sensorFields));
        protocol.send("STATE", sensorFields);
        sensors.buildEnvironmentFields(sensorFields, sizeof(sensorFields));
        protocol.send("STATE", sensorFields);
    }

    // Periodic wheel-speed telemetry while ACTIVE (ROVER_PROTOCOL.md §8,
    // "STATE left_speed=... right_speed=..."). The obstacle flags are
    // NOT here: they are published on change, and unlike this they are
    // not gated on ACTIVE -- see publishObstacleIfChanged().
    if (state == RoverState::ACTIVE) {
        unsigned long now = millis();
        if (now - lastTelemetryMs >= ROVER_DRIVE_TELEMETRY_PERIOD_MS) {
            lastTelemetryMs = now;
            // 96 for a worst case of 68 ("left_speed=-0.0291
            // right_speed=-0.0291 left_pwm=-255 right_pwm=-255").
            // The obstacle flags used to ride along here; together with
            // the speeds' new decimals the frame reached 129 bytes --
            // one over ROVER_MAX_FRAME_LEN, on a full speed reverse.
            // They are their own on-change frame now
            // (publishObstacleIfChanged), which is both shorter and
            // quieter. This file has three historical truncation bugs
            // that all came from a thin margin exactly like that one.
            char fields[96];
            drive.buildTelemetryFields(fields, sizeof(fields));
            protocol.send("STATE", fields);
        }
    }

    RoverWatchdog::feed();
}
