RaphaelGrj/Rover-Project/esp32-cam/include/camera_pins.h

#pragma once

// AI-Thinker ESP32-CAM pin mapping (OV2640), standard across the
// countless AI-Thinker-pinout clones sold as "ESP32-CAM" -- these are
// fixed by the board's PCB routing, not configurable. Same values as
// Espressif's own CameraWebServer example (CAMERA_MODEL_AI_THINKER).

#define PWDN_GPIO_NUM     32
#define RESET_GPIO_NUM    -1

#define XCLK_GPIO_NUM      0
#define SIOD_GPIO_NUM     26
#define SIOC_GPIO_NUM     27

#define Y9_GPIO_NUM       35
#define Y8_GPIO_NUM       34
#define Y7_GPIO_NUM       39
#define Y6_GPIO_NUM       36
#define Y5_GPIO_NUM       21
#define Y4_GPIO_NUM       19
#define Y3_GPIO_NUM       18
#define Y2_GPIO_NUM        5
#define VSYNC_GPIO_NUM    25
#define HREF_GPIO_NUM     23
#define PCLK_GPIO_NUM     22

// Onboard white flash LED next to the lens -- shares GPIO4 with the
// microSD card's D1 line. This firmware never uses the SD slot, so
// driving it is safe, but keep it in mind if a card is ever added.
#define ROVER_CAM_FLASH_GPIO_NUM 4
