RaphaelGrj/Rover-Project/(commit log)

2026-08-19 Refactor BOM section into structured tables
    Formatted the BOM section into tables for better readability and organization.
2026-08-23 Add Rover Protocol V1 spec and ESP32 Phase 1 firmware (WROOM/S3)
    Defines the wire protocol (framing, checksum, message catalog) and
    implements a minimum-viable ESP32 firmware around it: frame
    parsing, heartbeat/timeout, hardware watchdog, READY/SAFE state
    machine, and serial diagnostics. Builds cleanly for both esp32_wroom
    and esp32_s3 PlatformIO environments to keep the current WROOM board
    and a future S3 upgrade compatible with the same codebase.
    Also updates the roadmap (Phase 1 done, Phase 6 remote-control/VPN/
    gamepad notes) and adds a PROGRESS.md session log for easy resume.
2026-08-24 Update ARCHITECTURE_AND_ROADMAP.md DRV8833 New driver motor
2026-08-25 Set up Wokwi simulation for Phase 1 and validate it end-to-end
    - Add esp32/wokwi.toml + diagram.json (bare WROOM board, UART0 wired
    to the serial monitor) and esp32/tools/rover_frame.py to compute
    frame checksums for manual testing.
    - Add esp32/WIRING.md: provisional Phase 2+ pinout, not wired into
    firmware, meant as a Wokwi/diagram.json starting point until real
    hardware wiring is confirmed.
    - Fix wrong checksum example in ROVER_PROTOCOL.md (*4B -> *39).
    - Add code-comment guideline to CLAUDE.md and comment the existing
    Phase 1 files accordingly (mainly RoverProtocol.cpp frame parsing).
    - Validate in simulation: boot, ping/diag, heartbeat timeout -> SAFE,
    checksum error handling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
    [main.cpp]
2026-08-25 Implement Phase 2 (Motorisation): DRV8833 motor driver, encoders, PID, MOVE
    - Add esp32/lib/motors/: MotorDriver (DRV8833, PWM-on-both-inputs),
    Encoder (quadrature tick counting via GPIO interrupt), WheelPID
    (per-wheel PID), DriveController (unicycle model, stop(), telemetry).
    - Add esp32/include/motion_config.h centralizing the Phase 2 pinout and
    motion constants -- provisional/uncalibrated, meant to be the single
    place to update once real hardware is confirmed.
    - Wire MOVE dispatch into main.cpp (only honored while ACTIVE, never
    re-arms motors during SAFE) and hook drive.stop() into the existing
    heartbeat-timeout safety path and boot sequence.
    - Corrected hardware: driver is a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
    [main.cpp, motion_config.h]
2026-08-25 Harden Phase 2 motor code: multicore-safe encoder, PID derivative kick, NaN guard
    - Encoder: replace noInterrupts()/interrupts() with a proper ESP32
    portMUX_TYPE critical section, since the former only suspends the
    current core and wouldn't protect _ticks if the GPIO ISR ever ran on
    the other core.
    - WheelPID: compute the derivative term on measurement instead of error,
    avoiding a "derivative kick" every time a new MOVE target arrives.
    Invisible today (KD=0) but would bite once KD is tuned.
    - DriveController::setTarget: reject NaN/Inf (a checksum-valid MOVE
    frame doesn't guarantee semantically valid floats; constrain() doesn't
    clamp NaN, and casting NaN/Inf to int16_t is UB) an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
    [motion_config.h]
2026-08-25 Make Rover pilotable: minimal Pi bridge + web control (gamepad/touch)
    Adds pi/, the project's first Python code: a minimal slice of Phase 5
    (Raspberry Pi core) just enough to unblock Phase 6 (remote control),
    per ARCHITECTURE_AND_ROADMAP.md -- no camera/VPN/auth yet.
    - rover_esp32/protocol.py: pure encode/decode for Rover Protocol
    frames, byte-for-byte matching RoverProtocol.cpp (verified against
    esp32/tools/rover_frame.py output).
    - rover_esp32/link.py: RoverLink, serial I/O via serial.serial_for_url()
    so the same code drives a real port or a Wokwi rfc2217:// simulation.
    - rover_core/core.py: RoverCore mirrors the ESP32's own safety model
    instead of duplicating it -- stops sending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
2026-08-25 Show ESP32 STATE/EVENT/ERROR feedback in the control UI
    - RoverCore gains a simple pub-sub (add_listener/remove_listener) so
    rover_control doesn't need any ESP32/serial-specific knowledge to
    get notified of incoming frames.
    - The WebSocket handler pushes every STATE/EVENT/ERROR frame to its
    client as JSON, plus the last known one immediately on connect so a
    client joining mid-session isn't blank.
    - index.html renders three lines: a standing STATE line, and
    self-clearing (5s) EVENT/ERROR lines, matching that these are
    distinct message categories (ROVER_PROTOCOL.md §8), not one generic
    status blob.
    Verified against the running Wokwi simulation: a WS client received
    pushed {"typ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
2026-08-25 WIP Phase 3 (head/display): servo module, not yet wired into main.cpp
    Not integrated or tested yet -- see PROGRESS.md for exact status.
    - head_config.h / display_config.h: pinout + constants for Phase 3
    (servos, ST7789), same provisional caveats as motion_config.h.
    - lib/head/ServoJoint + HeadController: pitch/yaw servo control via
    LEDC, soft limits, NaN/Inf guard and interpolation (same pattern as
    Phase 2's DriveController). Written and type-checks, but nothing
    #includes it from main.cpp yet, so it has never actually been
    compiled as part of the firmware, let alone tested.
    - platformio.ini: add Adafruit GFX + ST7735/ST7789 lib_deps (resolved
    successfully by PlatformIO), needed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
    [display_config.h, head_config.h]
2026-08-25 Complete Phase 3 (head + display): eyes, emotions, HEAD/FACE/ANIMATION
    - lib/display/: EyeState (pure render-state struct), EyeRenderer
    (glitch RGB-split eyes on Adafruit_GFX, ported from Lumi's technique
    but rewritten as a standalone class -- Lumi has no reusable module,
    just a FreeRTOS task with globals), Emotion (the 8 emotions from
    ARCHITECTURE_AND_ROADMAP.md section 15), DisplayEngine (owns the
    ST7789, one profile per emotion, one animation "GLITCH" as a proof
    of the ANIMATION mechanism -- first parametric pass, not bespoke art).
    - main.cpp: dispatch HEAD (gated on ACTIVE like MOVE), FACE and
    ANIMATION (not gated -- showing an emotion has no physical safety
    implication).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
    [display_config.h, main.cpp]
2026-08-25 Rework eyes: square rounded shape, always-on glitch, smoother liveliness
    User feedback on the Phase 3 eyes: square rounded-corner shape (not the
    taller rectangle from the first pass), cyan/magenta glitch visible by
    default (not ALERT-only), and an explicit ask to harden/optimize the
    code plus make the eyes feel alive (blink + motion, never static) --
    exact tuning to be adjusted later once actually seen.
    - EyeRenderer: eyes are now square (single eyeSize instead of separate
    width/height). Corner radius now tracks min(w,h) instead of width
    alone -- it could exceed half the (shrunk-during-blink) height
    otherwise, which fillRoundRect handles badly. Added defensive clamps
    on look values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
2026-08-29 Add BOM.md: full component list with quantities and purpose
    Tracks what's received vs. still to order/decide across compute,
    drivetrain, head, sensors and power, cross-referenced with
    AIDE_CABLAGE.md/WIRING.md for wiring detail.
    Claude-Session: https://claude.ai/code/session_01DLviSwNTYWPwbwayZ1UDRz
2026-08-31 Fix display for real ST7789 hardware: 240x280 landscape + redesigned glitch
    First physical test revealed the panel is 240x280 (not the 240x240
    provisional value matched to Wokwi's simulated chip) and renders
    portrait; display_config.h now carries native vs. logical (rotated
    landscape) dimensions, applied via setRotation() in DisplayEngine.
    The RGB-split fill glitch also looked like a color mess on real
    hardware. Replaced with a clean white eye fill, a thin permanent
    cyan/rose contour, and randomized thin flicker lines (biased horizontal)
    scaled by glitchIntensity -- tuned over several rounds of hardware
    feedback (corner radius, contour visibility, glitch density).
    Fixes an esp32_s3-only co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
    [display_config.h]
2026-08-31 Add Phase 4 sensors (VL53L0X x2, MPU6050, BME688) and fix two real bugs found on first hardware test
    New esp32/lib/sensors/ module: DistanceSensor (dual VL53L0X with XSHUT
    re-addressing, continuous non-blocking ranging, hysteresis obstacle
    detection), ImuSensor (MPU6050), EnvironmentSensor (BME688 via
    beginReading()/endReading() so a ~200ms conversion never blocks the
    shared loop()), and SensorHub tying them together with edge-triggered
    ERROR/EVENT reporting. Wired into main.cpp, ungated on ACTIVE/SAFE
    (situational awareness stays useful even while stopped).
    First flash on the real ESP32 WROOM (no sensors wired yet, deliberately
    testing the "nothing connected" path) caught two real bugs no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
    [main.cpp, sensors_config.h]
2026-08-31 Harden DistanceSensor: detect a VL53L0X going silent after a successful begin()
    ImuSensor/EnvironmentSensor already flip _ok=false when a read call
    itself fails, but the VL53L0X continuous-ranging path has no per-call
    failure signal, so a sensor that stops responding after init (eg.
    unplugged mid-run) would never have been reported. Tracks the last
    accepted sample per side and declares it failed after 1s of silence.
    Found during a self-review pass on the Phase 4 sensor code just added;
    recompiled and reflashed on the real ESP32 with no regression.
2026-08-31 Add CI (build both ESP32 targets) and native unit tests for pure-logic modules
    .github/workflows/esp32-build.yml: builds esp32_wroom and esp32_s3 on
    every push/PR touching esp32/, plus a job running the new native test
    suite -- would have caught the esp32_s3-only std::max/random() compile
    break from the Phase 4 session automatically instead of relying on
    remembering to build both targets by hand.
    Moved WheelPID and Emotion into their own lib/ folders (wheel_pid/,
    emotion/), separate from the hardware-touching code they used to share
    a folder with (MotorDriver/Encoder/DriveController, DisplayEngine/
    EyeRenderer) -- PlatformIO compiles a whole lib/ folder together once
    any file in it is refer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
2026-08-31 Simulate Phase 4 IMU in Wokwi; add Pi-side behavior state machine and richer sensor UI
    esp32/diagram.json: add the official wokwi-mpu6050 chip on the shared
    I2C bus. VL53L0X and BME680/688 have no official Wokwi chip (and no
    reliable community one found), so they stay protocol-only in
    simulation -- documented explicitly rather than left unexplained.
    pi/rover_core/core.py: RoverBehaviorState (IDLE/INTERACTING/MOVING/
    EXPLORING/PATROLLING/FOLLOWING/CHARGING/SLEEPING/ERROR, matching
    ARCHITECTURE_AND_ROADMAP.md §20 exactly). Only the transitions the
    current codebase can actually drive are wired: client connect/disconnect,
    non-zero MOVE, and ESP32 ERROR frames (auto-clears after 5s). Notifies
    v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
2026-08-31 Add E-stop, battery monitoring, OTA, config/logs, auth, video feed; harden security for open-source release
    Nine items, all designed to never block on missing hardware and to
    never leak or hardcode any secret -- this project is public on GitHub.
    ESP32 side:
    - EStop (esp32/lib/safety/EStop.h): INPUT_PULLUP button on GPIO25,
    reads a stable "released" when unwired (same principle as
    I2CProbe.h applied to a GPIO). Forces SAFE independently of the
    heartbeat and blocks SYSTEM action=resume while held -- including a
    fix for the button already being held at boot, which needed the
    READY->ACTIVE promotion itself guarded, not just the later loop()
    check. New EVENT name=estop_pressed (check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
    [main.cpp, power_config.h, safety_config.h]
2026-08-31 Add Python tests, HTTPS/WSS, systemd unit, and NVS-backed PID calibration; investigate Wokwi encoder sim (not implemented)
    1. pi/tests/ (pytest, dev-only via requirements-dev.txt): 25 tests for
    rover_esp32.protocol (checksum/decode, mirrors the C++ suite),
    RoverCore's behavior state machine (via a FakeLink test double, no
    real serial port touched), and rover_control.auth. Found and fixed a
    real bug while writing these: token_matches("", "") returned True
    (hmac.compare_digest treats two empty strings as equal) -- hardened
    to reject an empty `expected` too, defense in depth even though
    resolve_token() never actually returns one. CI job `python-tests`
    added; workflow ren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
    [main.cpp]
2026-08-31 Add buzzer, obstacle-stop reflex, idle-sleepy behavior, 2 animations, and optional MQTT publishing
    1. Buzzer (esp32/lib/sound/Buzzer.h): non-blocking beep patterns
    (BOOT/OBSTACLE/LOW_BATTERY/ESTOP) via tone()/noTone(), works with
    passive or active buzzers. Real pin-budget constraint hit: every
    WROOM GPIO was already spoken for, and WIRING.md explicitly banned
    GPIO12 (flash-voltage strapping risk). Asked the user rather than
    deciding alone -- GPIO12 chosen, the rule relaxed explicitly with a
    documented warning. Verified on the real ESP32: boot stays clean
    with GPIO12 driven by firmware; the physical buzzer sound itself is
    unverified (not wired during this session).
    2.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
    [main.cpp, sound_config.h]
2026-08-31 Wire HEAD (head-look) commands into the control UI
    Phase 6's "Commandes HEAD" checklist item was still unchecked with a
    now-stale justification ("Phase 3 servos not written yet") -- Phase 3
    finished several sessions ago. Wired it directly: RoverCore.look(),
    optional head_pitch/head_yaw in the WebSocket message, a second touch
    pad plus gamepad right-stick support in index.html. Verified end-to-end
    against the real ESP32 (HEAD pitch=15.0 yaw=-20.0 confirmed on the
    serial link). 37/37 Python tests pass.
2026-08-31 Finish Phase 6: WireGuard VPN guide + config templates (no real keys)
    pi/VPN.md documents self-hosted WireGuard remote access (Tailscale mentioned as an easier alternative), integrating with the existing token auth without any rover_core/rover_control code changes -- a remote device just gets a tunnel IP and reaches the Pi as if on the LAN, the access token still applies on top. pi/wireguard/*.example.conf are placeholder templates only, real configs (with private keys) are git-ignored. Also fixed a stale note claiming no TLS support exists (it was added last session).
    Not testable this session: no physical Raspberry Pi or router available. Phase 6 is now done except the camera itself (no h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
2026-09-01 Document Phase 2 motor bring-up session (SLEEP/pull-up/driver findings, unresolved under-load instability)
    First real-hardware bring-up of motors/encoders: found and fixed a
    disabled driver (SLEEP unwired), silent encoders (missing pull-ups),
    and a dead H-bridge channel on the first DRV8833 board. A second,
    still-unresolved instability under motor load was chased for a long
    follow-up session (bad USB cable ruled in as a major factor, a second
    driver board's own weak channel, an unexplained OUT-voltage anomaly)
    and paused mid-diagnosis at the user's request -- PROGRESS.md captures
    the full timeline, confirmed findings, and next steps so it can be
    picked up cold. Also commits pi/tools/ (motor_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
    [motor_test.py, move_diagnostic.py]
2026-09-01 Split PROGRESS.md into a lean resume file plus PROGRESS_ARCHIVE.md, and document today's motor bring-up
    PROGRESS.md had grown to 2126 lines of full session-by-session narrative,
    defeating its own stated purpose of being a fast session-resume file --
    rereading it every session cost too many tokens. PROGRESS_ARCHIVE.md now
    holds that full history verbatim (all prior sessions, untouched);
    PROGRESS.md keeps a short "Etat actuel" (current open threads, updated
    in place) plus a one-line-per-session journal, so nothing is lost but a
    normal resume no longer requires rereading everything.
    Also documents today's motor bring-up: the two motors not turning
    together (the session's starting blocker) turn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
2026-09-02 Fix wiring mapping error and encoder direction bug for stable motor bring-up
    Encoder wire colors were mismatched to the wrong function (motor power
    wire tied to the ESP32 3V3 rail), which explained the two-encoders-
    never-light-together symptom. After rewiring per the PCB silkscreen,
    both wheels still saturated into a positive-feedback runaway because
    the encoder count direction was opposite to actual motor drive
    direction on both sides -- corrected in DriveController with a
    tickSign flip, verified stable on real hardware (left/right speed both
    converge cleanly on target).
2026-09-02 Add raw tick calibration tooling and measure real encoder ticks/rev
    Add SYSTEM action=raw_ticks/reset_ticks, backed by a cumulative Encoder
    counter separate from the PID loop's own 20ms-reset counter, so ticks
    can be counted over an arbitrary hand-timed window. Used it to measure
    real ticks/revolution (1073, vs the 700 placeholder) by spinning the
    bare motor shaft slowly and counting one visible rotation -- hand-
    rotating the N20 gearbox to count directly isn't feasible, it's too
    stiff to back-drive. Wheel diameter stays a placeholder since no wheel
    is mounted yet (wheel CAD not finalized); default PID gains were
    characterized across the 0.05-0.25 target range on the unloaded shaft
    and left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
    [main.cpp, motion_config.h]
2026-09-02 Bring up MPU6050 and BME280 on real hardware, add I2C bring-up tools
    MPU6050 responds and reads sane values (accel_z near gravity, gyro near
    zero at rest). The BME688 slot turned out to hold a BME280 instead
    (chip-id 0x60, not the BME680/688 family's 0x61 -- confirmed via the
    purchase link); EnvironmentSensor now auto-detects which is plugged in
    by chip-id and drives the matching Adafruit library, so swapping in a
    real BME688 later needs no code change, just a reboot. Also add SYSTEM
    action=i2c_scan and action=bme_chip_id as reusable I2C bring-up
    diagnostics, useful for the VL53L0X pair next.
    [main.cpp, sensors_config.h]
2026-09-02 Document VL53L0X wiring plan and today's session for next resume
    Left the pin-by-pin VL53L0X plan (shared I2C bus, XSHUT sequencing,
    side-by-side front placement rationale) directly in "Prochaines
    étapes" so the next session can wire straight from PROGRESS.md without
    re-deriving it, plus a session journal entry summarizing today's work.
2026-09-02 Document power system BOM and fix stale sensor status in BOM.md
    Fill in the previously undesigned power section with the chosen
    2S1P 18650 + USB-C BMS/charge module solution (budget, architecture
    rationale, itemized BOM, sourcing links). Also correct the VL53L0X/
    MPU6050/BME688 rows, which still described the pre-2026-09-02 state
    (BME688 wired -> actually a BME280, MPU6050/VL53L0X status stale).
2026-09-05 Add ESP32 WiFi/OTA config portal, validate on hardware, design rover-ai
    Adds a phone/PC-accessible WiFi provisioning portal for the ESP32
    (SYSTEM action=wifi_setup) so credentials no longer require a USB
    reflash, decouples WiFi connectivity from OTA activation, and fixes a
    watchdog reset that was killing real OTA transfers partway through --
    all validated end to end on real hardware (WiFi join, OTA activate,
    real OTA flash).
    Also documents the rover-ai architecture (ARCHITECTURE_AND_ROADMAP.md
    S17.1): a cloud-API-or-local-network LLM provider choice, configurable
    at any time from the existing control portal.
    Claude-Session: https://cl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
    [main.cpp]
2026-09-06 Fix Pi WiFi, validate remote control end-to-end, add ESP32-CAM firmware+relay
    Raspberry Pi WiFi was dead onboard hardware, not a config/OS issue --
    confirmed across two cards and two OSes, resolved with a different
    physical card. Pi bring-up completed: software env set up, ESP32
    connected over USB, joystick control validated end-to-end on the real
    robot (phone -> Pi WiFi -> ESP32 -> motors), rover-core installed as a
    systemd service (boots on startup, restarts on crash).
    Camera architecture changed: no CAD space for a Raspberry Pi camera
    module in the head, so an independent ESP32-CAM now films and streams
    over WiFi directly to the Pi instead (ARCHITECTURE_AND_ROADMAP.md
    §4.3). New esp32-c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
    [cam_config.h, camera_pins.h, main.cpp]
2026-09-09 Add rover-ai backend, web config panel, and ESP32-CAM cloud vendors
    Interchangeable AI provider module (ARCHITECTURE_AND_ROADMAP.md §17.1):
    common AIProvider interface, eight cloud vendors (Anthropic, OpenAI,
    Gemini, plus five OpenAI-compatible aggregators for Qwen/uncensored
    models -- DashScope, OpenRouter, Together, Fireworks, DeepInfra), and a
    generic LocalAIProvider for any OpenAI-compatible local server (Ollama).
    Credentials stored in a git-ignored, owner-only-permissions file,
    separate from config.json, same convention as ROVER_CONTROL_TOKEN.
    Wired into rover_control as a new authenticated /ai panel (config form
    + text chat tester), reachable from the control page. Not yet called
    fro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
2026-09-10 Fix motor runaway/reversed-direction bug and serial reader crash
    Right wheel was running away (positive-feedback saturation) and the
    left wheel's polarity flipped after resoldering its motor leads mid
    bring-up; split ROVER_TICK_SIGN_LEFT/RIGHT so each side can be
    corrected independently, verified on real hardware via
    move_diagnostic.py and visual confirmation of rotation direction.
    Also fixes a serial protocol bug found while diagnosing this: a noisy
    non-ASCII line crashed the whole pyserial reader thread instead of
    being dropped as a malformed frame, and a stale /dev/ttyUSB0 reference
    in the deployed rover-core.service (device re-enumerated as ttyUSB1
    after a reconnect) -- switched to the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
    [motion_config.h, protocol.py]
2026-09-11 Add left/right PWM telemetry, document unresolved left motor bring-up
    DriveController now reports the actual PWM sent to each wheel
    (left_pwm=/right_pwm= in STATE), which proved the firmware pushes full
    duty on the left channel with no software bug -- the remaining fault is
    electrical/mechanical, not code. PROGRESS.md records the full session:
    intermittent left motor with the new N20 motors, driver board replaced
    (total failure then recovered but with a stable negative left_speed),
    two single-variable sign-fix attempts (IN1/IN2 swap, tick sign flip)
    that ruled themselves out, and firmware reverted to its last known-good
    state pending a proper unloaded motor test.
    [main.cpp, motion_config.h]
2026-09-11 Add Personality Engine: conversation memory + emotion reaction for rover-ai
    rover-ai's AIContext (system/history) was already supported by every
    provider but never fed by anyone -- AIPanel.ask() called the active
    provider bare, so each message was a stateless one-shot with no persona.
    Add rover_ai/personality.py (PersonalityEngine): builds Rover's persona
    and a bounded conversation history into AIContext, and reacts to a turn
    with an emotion (curious while asking, happy on reply, confused on
    AIProviderError) via a new RoverCore.set_emotion() method. Wire it into
    AIPanel.ask()/update() and rover_core/main.py, add POST /ai/reset +
    "Nouvelle conversation" button on the /ai panel.
    93/93 pi/ te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
    [personality.py]
2026-09-11 Chain STT -> rover-ai -> TTS into one voice turn (Audio pipeline)
    Closes the loop between today's rover_audio (STT/TTS) and rover-ai's
    conversation (persona/history via PersonalityEngine): until now each
    piece worked in isolation with no code connecting them.
    Add pi/rover_control/voice_panel.py (VoicePanel.converse): audio ->
    AudioPanel.transcribe() -> AIPanel.ask() -> AudioPanel.synthesize() ->
    reply audio, with each stage's failure labeled (VoiceTurnError.stage =
    "stt"/"ai"/"tts") so a caller knows exactly where a turn broke instead
    of one undifferentiated error.
    New POST /audio/converse route (server.py): body is raw audio bytes,
    JSON response carries heard_text/reply_text/reply_audio_b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
2026-09-13 Plan I2S amp wiring on reclaimed pins, add beginner wiring guide
    MAX98357A needs 3 free GPIOs on an already fully-allocated WROOM;
    reclaims GPIO16/17 (planned Pi UART2, never actually used since the
    real link is USB) and GPIO14 (unwired battery ADC placeholder).
    Documents distance sensors, ESP32-CAM and Pi links in AIDE_CABLAGE.md
    per CLAUDE.md's confirmed-wiring rule.
    Claude-Session: https://claude.ai/code/session_01V6FZTG4cRyJGkmnNvLG98V
2026-09-15 Deport the Raspberry Pi onto the network, keep Rover drivable without it
    Three connected pieces of work, in the order they happened.
    1. Architecture decision (§6.2): the Pi leaves the chassis and becomes a
    LAN machine; Rover Protocol moves from the USB cable to a TCP socket.
    Nearly free on the Pi side -- serial_for_url() already accepts
    socket://, and RoverProtocol takes a Stream& so a WiFiClient fits.
    Measured on real builds: WROOM flash 71.0%, RAM 16.2%. Frees
    GPIO1/GPIO3 (the ex-USB link), which is what finally gives the I2S
    mic a pin -- it had none left.
    RoverLink no longer dies on a dropped link: supervised reconnection
    with backoff, non-blocking start(), and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
    [link.py, main.cpp]
2026-09-20 Land deported-Pi prerequisites, wire the ToF sensors, hunt the motors
    Long hardware session. The morning's work landed and was validated on
    the real robot; the afternoon was spent bringing up sensors and servos,
    and diagnosing motors that still refuse to drive.
    Deported Pi -- both blocking prerequisites cleared (ARCHITECTURE §6.2):
    - RoverNetwork.h now owns the WiFi station link, which only the
    explicitly *optional* OTA module used to establish. Non-blocking
    connect (it used to stall boot for up to 10s), supervised reconnect
    with backoff, setSleep(false), and radio arbitration with the
    provisioning portal and standalone mode.
    - LinkAuth.h requires an AUTH frame on a network transp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
    [head_config.h, link.py, main.cpp, sensors_config.h, sound_config.h]
2026-09-20 Prove by bisection that the motor fault is not in the firmware
    Reflashed the complete firmware from d9379a0 -- the commit from the
    session where Rover drove -- and the motors did not turn either: PWM
    255, speed 0, identical to the current code. Also tested the motor code
    alone pinned to that revision, and both decay schemes.
    current (slow decay) PWM 255 -> 0 tick
    current (fast decay) PWM 255 -> 0 tick
    motor code from d9379a0 PWM 255 -> 0 tick
    whole firmware d9379a0 PWM 255 -> 0 tick
    So the fault appeared between 2026-09-15 and 2026-09-20 and is
    electrical. What changed physically in between: tracks fitted, ToF
    sensors wired onto 3V3/GND, servos connected then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
2026-09-21 Split speed from direction in the joystick UI, and unstick SAFE
    The joystick set both direction and magnitude, so the speed changed
    with every drift of the thumb and each drift was another float pushed
    to the ESP32 several times a second. Both control pages (the Pi's and
    the one the ESP32 serves in standalone mode) now use a side speed bar
    for HOW FAST and a direction-only joystick for WHERE: the command is
    the normalised vector, so half-course and full-course drive at the
    same speed, with a 25% deadzone since a direction-only stick has no
    small regime to ease into.
    That makes a steady drive one repeated command instead of a stream of
    slightly different ones, which is what lets RoverCore.mo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
    [main.cpp]
2026-09-21 Make the obstacle reflex switchable, and find the saturated PID
    Adds an ON/OFF button for the obstacle stop on both control pages, as
    asked. The distances are untouched by it -- they keep being measured,
    published and displayed; the switch only stops the robot acting on
    them, it does not blind it. SYSTEM action=obstacle_reflex on=0|1 on the
    firmware side, and RoverCore.set_obstacle_reflex() disarms BOTH clamps,
    since the Pi and the ESP32 each have their own by design and turning
    off one alone would achieve nothing.
    Deliberately not persisted: a disabled guard rail must not survive a
    power cycle, so every boot starts armed again. The button follows the
    value the robot reports (STATE obstacle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
2026-09-21 Fix the red CI, the dead-link blindness, and the motor control loop
    CI was red on python-tests: three test_link reconnection tests. They
    were not sandbox flakes and not RoverLink's fault. FakeEsp32.hang_up()
    called close() while its own thread sat in recv() on that same socket,
    and on Linux closing a descriptor does not wake a thread already
    blocked on it -- the blocked syscall keeps the file description alive,
    so no FIN is ever sent. The client saw a healthy, merely silent socket
    and correctly never reconnected. shutdown(SHUT_RDWR) before close()
    sends the FIN at once. Three reconnection tests spent their life red
    while the code they guard was fine.
    Finding that exposed the real version of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
    [link.py, main.cpp, motion_config.h, test_wheel_pid.cpp]
2026-09-21 Add a one-command motor triage that prints a verdict
    The answer to "is this electrical or is it the firmware?" has been
    available all along, but only to someone who runs five SYSTEM commands
    in the right order and reads the telemetry correctly. Seven bring-up
    sessions went by without that sequence being run cleanly end to end --
    and the one number everyone did look at, left_pwm=255, proved nothing,
    because the PID saturates precisely BECAUSE nothing moves.
    tools/motor_triage.py runs it: resume, reset_ticks, motor_raw,
    raw_ticks. motor_raw is the pivot -- it writes the duty straight to the
    H-bridge, bypassing the PID, the feed-forward, the speed ceiling and the
    obstacle reflex, so zero ticks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
    [motor_triage.py, move_diagnostic.py]
2026-09-21 Fix seven regressions found reviewing this branch before a flash
    Reviewed my own work before it goes on hardware, since ~1000 lines of
    it -- including a motor control law -- have never run on the real
    robot. Seven real defects, all from one cause: dropping the speed
    ceiling 10x without touching what assumed the old scale.
    The speed bar had four usable positions. MOVE went out as "%.2f" over a
    0-0.03 m/s range, so the page's 21 steps collapsed into four distinct
    commands and anything under 15% of the bar rounded to 0.00 -- the robot
    simply did not move. Four decimals now; seven bar steps tested in a
    browser give seven distinct commands.
    Worse, left_speed used the same format, so any wheel u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
    [main.cpp]
2026-09-21 Fix motor_triage's set_speed suggestion truncating to 0.000
    Found while validating this branch on real hardware: the recommended
    recalibration command formatted the measured speed with .3f, which
    silently rounds anything below 0.0005 m/s to "0.000" -- exactly this
    chassis's slow-wheel measurement, turning the suggested fix into a
    command that would have zeroed the speed ceiling instead of correcting
    it.
    [motor_triage.py]
2026-09-21 Update PROGRESS.md: motor blocker resolved, branch merged, new print in progress
    Documents the 2026-09-21 real-hardware test session: motors/encoders/
    H-bridge confirmed responsive via the newly-merged motor_triage tool,
    the max_speed recalibration pitfall (free-spin-in-air measurement is
    not a valid proxy for under-load speed, and silently breaks forward
    drive without affecting rotation), the left/right balance measured
    after removing the tracks (~1-2%, absorbed by the per-wheel PID), and
    the user's in-progress 3D print of new track-side parts meant to
    reduce motor load.
2026-10-13 Plan the all-in-one ESP32-S3 Rover PCB: full connection list and KiCad guide
    Transposes the hardware-validated WROOM wiring onto an ESP32-S3 board
    that also absorbs the ESP32-CAM, so only cables remain to plug in.
    Design only: no schematic drawn, firmware untouched.
    Claude-Session: https://claude.ai/code/session_01BGQaqXoisZKo6ZPPJRhqWq
2026-10-13 Integrate a 2S LiPo BMS on the planned PCB, fix the N20 connector pinout
    The pack now plugs straight into the board (power lead + balance lead):
    USB-C boost charging with cell balancing (BQ25887), per-cell protection
    (S-8252), on-board power switch, INA219 measuring charge and discharge.
    XT30 and the reverse-polarity MOSFET are gone; the IMU moves to 0x6B to
    leave 0x6A to the charger. Motor connectors follow the WIRING.md wire
    order, as asked. BOM marks the parts the PCB would replace.
    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
2026-10-13 Pick 2 x 18650 in separate holders over a LiPo pack for the PCB battery
    The user delegated the pack choice with safety as the criterion. Steel-can
    brand-name 18650s survive the knocks of a rolling robot where a soft LiPo
    pouch punctures or swells; two separate holders expose the mid-point, so
    power and balance share one keyed JST-VH 3-pin connector that cannot be
    half-plugged. Adds a cell NTC on the charger TS pin and a PTC on the
    mid-point wire. BOM and bring-up steps follow.
    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
2026-10-13 Add firmware support for the custom ESP32-S3 Rover PCB (rover_pcb_v1)
    New PlatformIO environment for the planned all-in-one board: S3 N16R2,
    native USB console, whole pinout in one header mirroring
    pcb/PCB_CONNEXIONS.md. The WROOM and S3 devkit builds keep their pins.
    - BoardIo + TCA9554: slow lines (ToF XSHUT, display reset/backlight,
    amp enable, camera PWDN, status LED, DRV8833 nFAULT) addressed by
    role, GPIO on the WROOM and I/O expander on the PCB.
    - Integrated camera (ported from esp32-cam/) on LEDC channel 7/timer 3
    so it cannot steal the left motor's PWM; never writes to Serial.
    - INA219 pack voltage/current and BQ25887 charger: part-number check
    before any write, config re-a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
2026-10-13 Fix the 23 wrong checksums in ROVER_PROTOCOL.md examples
    Recomputed with the spec's own rule (XOR of every content byte, as
    RoverProtocol::checksum does). Most were illustrative values never
    computed; the reference example in section 3.1 kept the *39 of its
    older two-decimal form (still correct in pi/tests/test_protocol.py for
    "velocity=0.25 rotation=-0.10") after moving to four decimals. Anyone
    writing a client from the document would have had every frame
    rejected. The two generic templates (AUTH secret=<...>, board=<...>)
    keep *xx since their checksum depends on the real value.
    Claude-Session: https://claude.ai/code/session_01BGQaqXo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
2026-10-13 Fix the stray parenthesis in the pintest pin guard
    Broke the build on all three targets (CI run 38365702477).
    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
2026-10-13 Add the PCB to the beginner wiring guide, with a step-by-step KiCad walkthrough
    Part 2 of AIDE_CABLAGE.md: what plugs into which connector once the
    board exists (and which way round), the buttons and LEDs, the first
    power-on checks, then the board's creation in KiCad as checkbox steps,
    sheet by sheet, down to the label each pin gets. The GPIO table was
    checked mechanically against esp32/include/board_pins_pcb_v1.h (33/33).
    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
2026-10-13 Record the PCB merge in PROGRESS.md
    The firmware entry still said 'never compiled': CI has built
    rover_pcb_v1 green since 318c120 and the work is merged (7f88758).
    Keeps what remains open (charger ADC scale, camera FPC orientation,
    audio driver, Pi camera_url) and the next step. Same correction in the
    section 7 heading of pcb/PCB_CONNEXIONS.md.
    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
2026-10-13 List LCSC part numbers for KiCad step 0 of the PCB guide
    Each with a confidence mark: LCSC and JLCPCB were unreachable from the
    session, so numbers come from search-indexed listings, and only those
    matched to the exact manufacturer part by several sources or an LCSC
    page are marked confirmed. Flags what was not found (S-8252 variant
    with the wanted thresholds, two JST-PH sizes) and the parts with
    lifecycle or stock warnings (DRV8833PWPR, LSM6DS3TR-C, BQ25887RGER).
    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
2026-10-13 Pick the S-8252AAC protector and deep-sleep the PCB on a low battery
    S-8252AAC is the only variant LCSC stocks with Li-ion overcharge
    thresholds (4.30 V), but it only cuts a cell at 2.40 V, below what the
    18650s are specified for. A stopped robot still draws ~100 mA, so a
    forgotten one would reach that. LowBatterySleep deep-sleeps the board
    under 3.0 V/cell (never on USB or while charging), wakes every 15 min,
    and resumes only at 3.3 V/cell so a rest rebound cannot cycle full
    boots. The rule lives in PowerMath::batteryTooLowToRun with four native
    tests; battery and charger gain sampleNow() so the check runs before
    the display, WiFi and camera come up. Docs record the choice, the
    battery_shut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
2026-10-13 Add LCSC numbers for the 2- and 8-pin JST-PH connectors (step 0)
    S2B-PH-SM4-TB(LF)(SN) = C295747 and S8B-PH-SM4-TB(LF)(SN) = C265121,
    both found on their LCSC product pages, closing the last two unknowns
    of the step-0 parts list.
    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
2026-10-13 Confirm C265405 and C2913205 in the step-0 parts list
    Both now matched to their exact manufacturer part by a second source
    (the LCSC page for the JST-PH 6-pin, the JLCPCB part page for the
    ESP32-S3-WROOM-1-N16R2), so no single-source number remains.
    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
2026-11-13 Draw the Rover PCB as two stacked 75x50 boards, generated by script
    The all-in-one board specified in pcb/PCB_CONNEXIONS.md does not fit a
    single 75x50 mm outline: neither a purpose-built grid router nor
    Freerouting could finish it. It is split into a power board (bottom:
    2S battery, protection, BQ25887 charger, bucks, DRV8833) and a logic
    board (top: ESP32-S3, camera FPC, audio, sensors, display), joined by a
    2x15 2.54 mm connector. GPIO assignment is unchanged, so the existing
    rover_pcb_v1 firmware target applies as is.
    - pcb/gen: single source of truth per board (design_*.py), schematic and
    PCB generators, Freerouting wrapper, power-track widening, DRC wrapper,
    JLCPCB export. Freerou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
2026-11-13 Add perspective previews of the two Rover boards
    Rendered with kicad-cli. Surface-mount component bodies do not show in
    this command-line render; open the boards in KiCad (Alt+3) for the full
    3D view.
2026-11-14 Fix BQ25887 register encodings against the TI datasheet, batch its reads
    Reviewed the rover_pcb_v1 charger code against datasheet SLUSD89B:
    - ICHG has no 50 mA offset (REG01 resets to 0x5E, ICHG 0x1E = 1500 mA).
    The old encoding programmed 50 mA less than asked and read it back as
    the asked value. Tests pinned the wrong reset byte (0x5D) and are
    corrected, with a new no-offset test.
    - ADC_CTRL was 0xB0, which selects 12-bit mode while the comment said
    15-bit; now 0x80.
    - ADC results are two's complement: a slightly negative reading is now
    reported as 0 instead of wrapping to ~65 V.
    - The ADC scale (1 mV / 1 mA per LSB), until now an unverified
    assumption, matches the datasheet.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
2026-11-14 Play the status beeps through the PCB's I2S amplifiers
    The custom PCB has no buzzer, so boot / obstacle / low-battery / E-stop
    beeps were silent there. Buzzer keeps its patterns and timing and now
    delegates to a new I2sBeeper back end on rover_pcb_v1: 16 kHz sine fed
    to the two MAX98357A at the real sample rate, amplifiers woken only
    while a beep plays. WROOM and S3 devkit builds are unchanged.
    Tone arithmetic is in lib/sound_math and covered by test_tone_math.
    Builds on all three targets, 63 native tests pass; never run on hardware.
